RaviTharaka/riscv_fpga/Diagrams/Pipeline.pdf

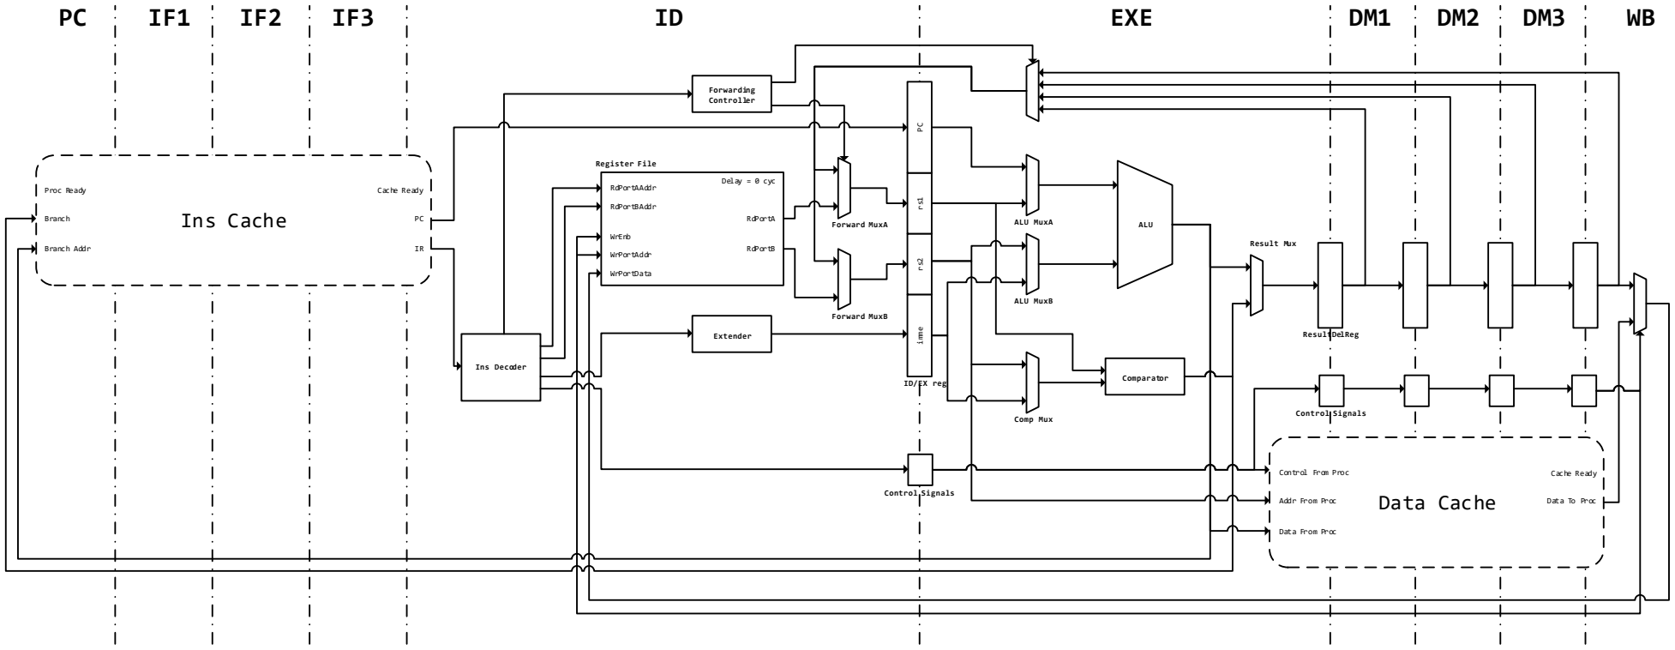
[picture p15: figure]
Ins Cache Branch; Branch Addr; Proc Ready; Cache Ready; Register File; RdPortAAddr; WrEnb; WrPortAddr; WrPortData; RdPortA; Delay = 0 cyc; RdPortB; RdPortBAddr; Ins Decoder; Forward MuxB; Forward MuxA; ID/EX reg imme rs2 rs1 PC; Extender; Control; Signals; ALU; Comparator; ALU MuxB; ALU MuxA; Comp Mux; Result Mux; ResultDelReg; Data Cache Addr From Proc; Data From Proc; Data To Proc; Control From; Proc; EXE; Forwarding Controller

- Allowing 3 cycles for each of the caches, there are 10 pipeline stages
- The Forwarding controller controls the forwarding of data from pipeline stages after execution stage to dependent instructions to enable faster execution.
- CacheReady signals from both caches are used to stall or bubble the pipeline during an instruction or data miss
- At a instruction cache stall only the pipeline stages upto EX are haulted, the remaining stages are allowed to run while adding bubbling instuctions. At a data cache stall, whole pipeline is stalled.
- The forwarded data are multiplexed at the decode stage to shorten the critical path at the EXE stage. Therefore a neighboring instruction dependency will require a single cycle bubble of the pipeline

# Pipeline
