RaviTharaka/riscv_fpga/Diagrams/DataCache.pdf

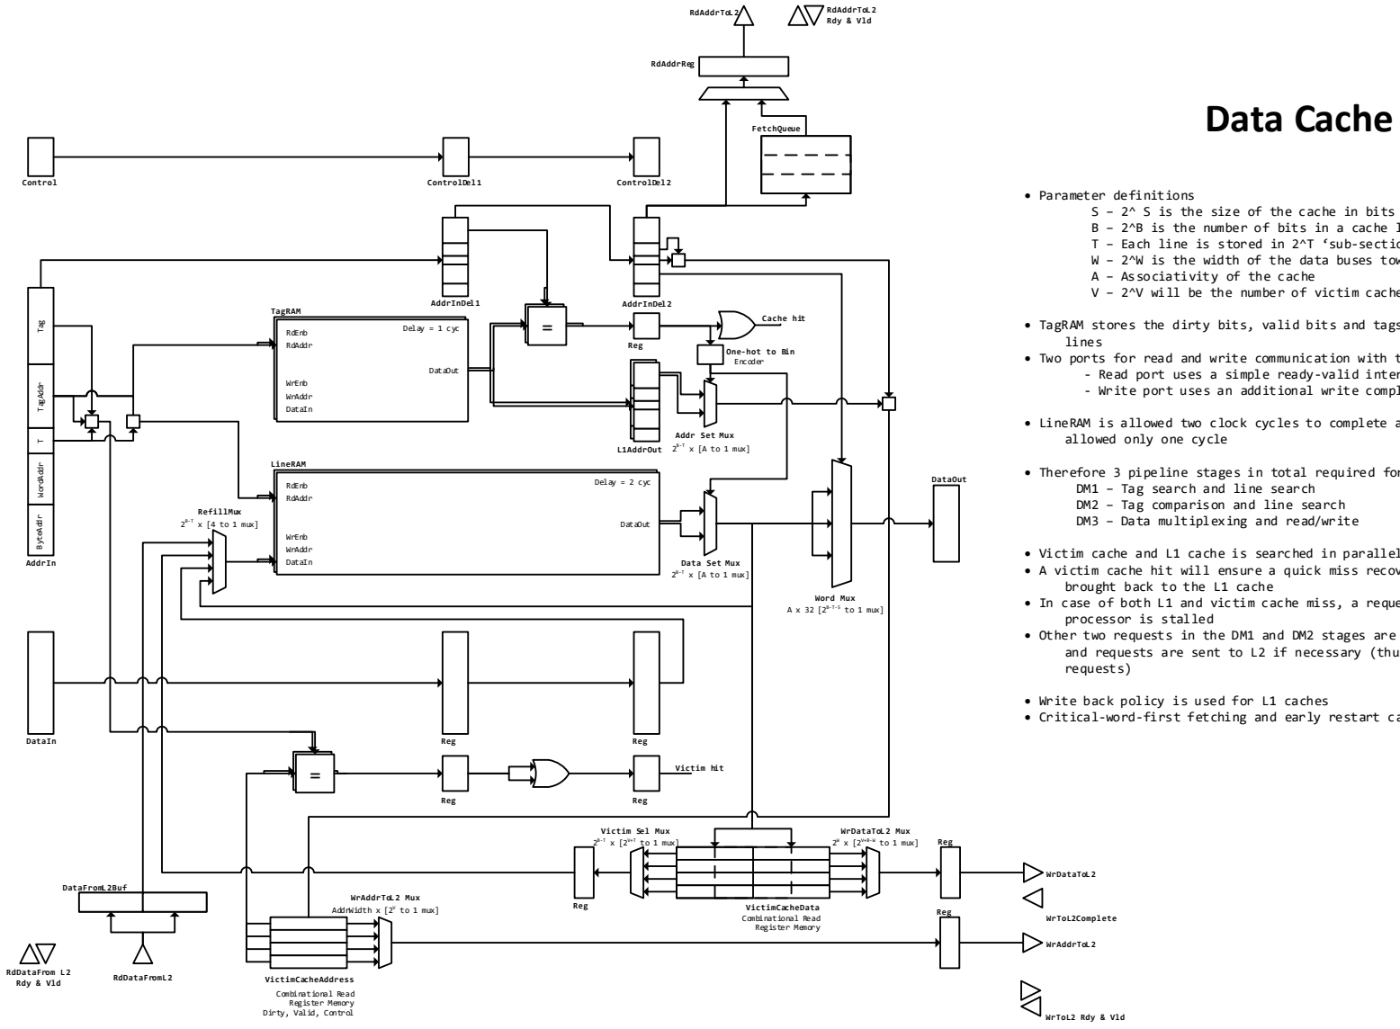
[picture p23: figure]
TagRAM; RdEnb RdAddr; WrEnb WrAddr DataIn; DataOut; Delay = 1 cyc; LineRAM; Delay = 2 cyc; Reg; AddrIn ByteAddr WordAddr T TagAddr Tag; Word Mux; Data Set Mux; to 1 mux]; x [A to 1 mux]; One-hot to Bin; Control; DataIn; RefillMux; x [4 to 1 mux]; AddrInDel1; AddrInDel2; FetchQueue; RdAddrReg; RdAddrToL2; Rdy & Vld; RdDataFrom L2; RdDataFromL2; DataFromL2Buf; VictimCacheData; Victim Sel Mux; WrDataToL2 Mux; WrDataToL2; VictimCacheAddress; WrAddrToL2 Mux AddrWidth x [2; WrAddrToL2; WrToL2 Rdy & Vld; Combinational Read; WrToL2Complete; Register Memory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

S – 2^ S is the size of the cache in bits
B – 2^B is the number of bits in a cache line
T – Each line is stored in 2^T sub-sections in the Line Memory W – 2^W is the width of the data buses towards L2 cache

V – 2^V will be the number of victim cache lines

- TagRAM stores the dirty bits, valid bits and tags while LineRAM stores the cache
- Two ports for read and write communication with the L2 cache or memory
- Read port uses a simple ready-valid interface for address and data
- Write port uses an additional write completion signal
- LineRAM is allowed two clock cycles to complete a read, while the smaller Tag RAM is
- Therefore 3 pipeline stages in total required for a data read or write
- Victim cache and L1 cache is searched in parallel
- A victim cache hit will ensure a quick miss recovery, and the hit line will be
- In case of both L1 and victim cache miss, a request is sent towards the memory and
- Other two requests in the DM1 and DM2 stages are also immediately checked for misses and requests are sent to L2 if necessary (thus reducing miss penalty for DM1,DM2
- Write back policy is used for L1 caches
- Critical-word-first fetching and early restart capable
DM1 | DM2 | DM3
