RaviTharaka/riscv_fpga/VerificationPrograms/UtilityPrograms/ConvertToHex/README.md

=====================================================================
# RISC-V Base ISA   
=====================================================================
#### 03/03/2017
### Verification Programs 
=====================================================================
### Introduction
bla bla.

=====================================================================
### Requirements. 

=====================================================================
### bla bla
