RaviTharaka/riscv_fpga/VerificationPrograms/LargeConvolution/result.txt

399, 840, 1497, 1542, 1778, 1748, 2089, 1971, 1867, 1293, 1044, 816, 1339, 2034, 2711, 2617, 2228, 1982, 2163, 2071, 1772, 1629, 1902, 2381, 2256, 2206, 2066, 2230, 2263, 2462, 2833, 3051, 2758, 2380, 1709, 1564, 1360, 1854, 2070, 2247, 2012, 2020, 2208, 2545, 2448, 2338, 2205, 2290, 1935, 1513, 1101, 1252, 1222, 1269, 950, 1099, 1641, 2629, 3476, 3592, 3022, 2212, 1958, 2194, 2326, 1800, 1117, 943, 1296, 1903, 2131, 2483, 2735, 3137, 3103, 2871, 2841, 2987, 2935, 2593, 2432, 2522, 2273, 1585, 1159, 1453, 2020, 2282, 2248, 2530, 2816, 2751, 2345, 2244, 2486, 2594, 2285, 2123, 2035, 2168,
