RaviTharaka/riscv_fpga/VerificationPrograms/SortLarge/result.txt

399	425	216	186	275	166	344	49	130	32	148	115	471	419	82	139	395	192	234	98	95	485	217	204	132	411	223	83	474	408	206	384	82	244	1	282	223	316	204	163	219	369	283	271	100	390	300	49	57	262	8	287	43	44	151	292	473	461	400	171	85	268	425	199	32	21	156	305	144	367	199	391	478	243	202	391	489	189	106	445	357	72	62	86	300	399	88	223	440	406	150	130	383	382	163	226	197	343	143	233
