RaviTharaka/riscv_fpga/Simulation/Data_Cache/result.txt

00014fb0
00014fe0
00014fe8
00014ff0
00014ff8
00015000
00015008
00015010
00015018
00015020
00015028
00015030
00015038
00015040
00015048
00015050
00015058
00015060
00015068
00015070
00015078
00015080
00015088
00015090
00015098
000150a0
000150a8
000150b0
000150b8
000150c0
000150c8
000150d0
000150d8
000150e0
000150e8
000150f0
000150f8
00015100
00015108
00015110
00015118
00015120
00015128
00015130
00015138
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
00016bf1
0001397f
00045cd8
00014fb0
00045cd8
00014fc0
00014fc0
0002659c
00018157
00003350
00016bf1
0001397f
00045cd8
00014fb0
00045cd8
00009b5f
00007f12
00014fa0
00010b64
00011c0c
00011bfc
00011c04
00010d3c
00045cd8
00014fc0
00045cd8
00014fd0
00014fd0
00014fd0
00014fd0
00044e30
00010eeb
00011a20
00010eeb
0003b3a4
0003b3b4
0003b36c
0003b37c
000334bc
0000288e
00010eeb
0003bcd0
00007f12
00009b5f
00014fa0
00009070
00014fb0
00010b68
00011c10
00011c00
00011c08
00010d40
00045cd8
00014fd0
00045cd8
00014fe0
00014fe0
00014fe0
00014fe0
00044e24
00044e20
00044e20
00044e10
00003341
0003aaac
00044e38
0003aa9c
0003abec
00032f1c
00044d88
0003abdc
00044d50
0003af44
00033f14
0003442c
000163c0
000083f4
0003abcc
000333bc
00032f34
0003ab8c
00044d80
0003ab84
00014e70
0003349c
00007501
00007501
0000af3b
00032ef4
0000d376
00044e98
0001a3e8
000120b7
0003ab6c
00044e90
0003ab64
00044eb8
0003aafc
00044d78
00008556
00044d50
0003ab5c
0003aab4
000051ac
0003af44
00033f14
00002933
00033f14
000334e4
00007e39
00002933
00003c9d
00003c9d
00033f14
00003c9d
00014e18
000051ac
00007f58
00022194
00007f58
00011ab2
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
0000e20a
0002ec68
0002ed58
0000d4e4
0002ec00
0000d4e4
0000d4e4
0002ec00
00037048
0000a6f6
0002ec6c
0000d4e4
0000d4e4
0002ed5c
0000d4e4
0000d4e4
0002ec70
0000d4e4
0000d4e4
0002ed60
0002ec78
0000d4e4
0000edc0
00015f3f
00003e62
00004715
0000a7a5
0000d916
0000fadc
00006fd1
0000fadc
00007a17
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
