RaviTharaka/riscv_fpga/Simulation/Instruction_Cache/result.txt

00010000
00010004
00010008
d89cfe4c
d89cfe6c
d0b8b684
d5ac4c04
d8a77800
8c636b94
d84a73fc
cff6892c
d84a73fc
d1550308
4159dba4
ccca81c8
409d5d94
c314e10c
4026df68
825e8ee0
825e8f80
d8216144
d8212a48
d8736d04
ccca83e8
d885f34c
cf44b17c
825e8ee0
42464c64
c314e10c
cff69804
98a3e238
d17eb5e4
d8834ed8
c314e10c
ccfc04c0
ccfc04c0
ccfc04c0
d17eb5e4
c314e10c
d5ac4c04
ccfc04c0
c24323bc
d17eb5e4
400ca384
d8216144
d0b81d94
d8ceb330
400e5ae4
422100b0
c043c634
d0b81d94
409c8afc
d5ac4c04
cbca9688
d5ac4c04
a8902fbc
cf99cb70
c3eb61c8
c043c634
d8212a44
c314e10c
cff688d8
cff68a78
825e8ee0
4159dba4
421c58f4
825e8ee0
d17eb5e4
c24323bc
400e5ae4
d17eb5e4
d885f34c
d88f7be0
d88f7be0
40270fe4
422156ec
cbca9688
ccfc04c0
d0b81d94
4159da08
d13db868
c24323c4
cbca9688
ccfc04c0
cbca9688
d0b8b684
421c2c34
421c2c34
421c2c34
421c2c34
ccfc04c0
cf44b2fc
d5ac4c04
825e8ee0
d5ac4c04
cf99cb70
cff69808
cff69808
4159dba4
424d3a20
ca608c68
d17eb5e4
d5ac4c04
d885f34c
d0b8b684
40f53a1c
cff69a94
d17eb5e0
ca608c68
ca608c68
ca608c68
c3eb61c8
ccfc04c0
825e8ee0
d888e09c
c3eb61c8
d5ac4c04
cff68928
421c58f4
cbca9688
c641883c
3fd78f00
cff69a94
c314e10c
d17eb5e0
98a3e2b8
cff69a94
d13d98c0
825e8ee0
c3db7634
a8902fbc
d885f34c
cff69a94
4047816c
d96aeb8c
825e8ee0
c3eb61c8
98a3e298
d17eb540
421c6310
cff69a98
421c2a90
d8212a48
d17eb5e4
ca608c68
421c58f4
825e8ee0
ccfc04c0
cff69a94
cff688c0
c3db7634
c24323bc
ca608c68
d8212a48
98a3e278
c3926448
d96aeb8c
cff69808
d96aeb8c
d8bb4fc8
825e8ee0
d13dbf30
825e8ee0
cdbcf818
c314e10c
98a3e238
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
cdbca598
cdb45528
97bd0c58
d0d8b70c
42211ab8
d90860a8
ca6abb68
d0d8b70c
d5ca004c
ca6abb68
42212e38
d0d8b70c
422156ec
40d3fc48
40d3fc48
3d98faa0
42212e38
421c4808
421c4808
421c4808
ca6abb68
d405db18
42b5a8d4
cbca9688
cdbca578
cdbca558
d038d824
d8eab398
d90860a8
c2871308
c24323bc
40040db8
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
