RaviTharaka/riscv_fpga/Integrated/Integrated/Integrated.srcs/sources_1/new/RISCV_PROCESSOR.v

`timescale 1ns / 1ps
//////////////////////////////////////////////////////////////////////////////////
// Company: 
// Engineer: Yasas Seneviratne
// 
// Create Date: 03/04/2017 08:24:33 PM
// Design Name: 
// Module Name: RISCV_PROCESSOR
// Project Name: 
// Target Devices: 
// Tool Versions: 
// Description: 
// 
// Dependencies: 
// 
// Revision:
// Revision 0.01 - File Created
// Additional Comments:
// 
//////////////////////////////////////////////////////////////////////////////////


module RISCV_PROCESSOR#(
        // Fixed parameters
        localparam ADDR_WIDTH           = 32,
        localparam DATA_WIDTH           = 32,
        localparam EXT_FIFO_ADDRESS     = 32'h00010150,
           
        // Primary parameters
        parameter S                     = 17,                    // Size of the cache will be 2^S bits
        parameter B                     = 9,                     // Size of a block will be 2^B bits
        parameter a                     = 1,                     // Associativity of the cache would be 2^a
        parameter T                     = 1,                     // Width to depth translation amount
        parameter W                     = 7,                     // Width of the L2-L1 bus would be 2^W
        parameter N                     = 3,                     // Number of stream buffers
        parameter n                     = 1,                     // Depth of stream buffers would be 2^n
        parameter p                     = 2,                     // Prefetch queue's depth is 2^p
        parameter V                     = 2,                     // Size of the victim cache will be 2^V cache lines
        parameter L2_DELAY_RD           = 7,                     // Delay of the second level of cache
                    
        // Calculated parameters
        localparam BYTES_PER_WORD       = logb2(DATA_WIDTH/8),
        
        localparam CACHE_SIZE           = 1 << S,
        localparam BLOCK_SIZE           = 1 << B,
        localparam ASSOCIATIVITY        = 1 << a,
        
        localparam TAG_WIDTH            = ADDR_WIDTH + 3 + a - S,
        localparam LINE_ADDR_WIDTH      = S - a - B + T,
        localparam TAG_ADDR_WIDTH       = S - a - B,
        
        localparam L2_BUS_WIDTH         = 1 << W,
        localparam BLOCK_SECTIONS       = 1 << T,
        
        localparam SET_SIZE             = CACHE_SIZE / ASSOCIATIVITY,
        localparam LINE_RAM_WIDTH       = 1 << (B - T),
        localparam LINE_RAM_DEPTH       = 1 << LINE_ADDR_WIDTH,
        localparam TAG_RAM_WIDTH        = TAG_WIDTH + BLOCK_SECTIONS,
        localparam TAG_RAM_DEPTH        = 1 << TAG_ADDR_WIDTH,
        
        localparam PREFETCH_QUEUE_DEPTH = 1 << p,
        localparam STREAM_BUF_DEPTH     = 1 << n,
        localparam STREAM_SEL_BITS      = logb2(N + 1),
        
        localparam L2_BURST             = 1 << (B - W)
    ) (
        // Standard inputs
        input                               CLK,
        input                               RSTN,
            
        ////////////////////////
        // INSTRUCTION CACHE  //
        ////////////////////////
        
        // Output address bus from Instruction Cache to Memory
        (* mark_debug *) input                               ADDR_TO_L2_READY_INS,
        (* mark_debug *) output                              ADDR_TO_L2_VALID_INS,      
        (* mark_debug *) output     [ADDR_WIDTH - 2 - 1 : 0] ADDR_TO_L2_INS,
                
        // Input data bus to Insruction Cache from Memory       
        (* mark_debug *) input                               DATA_FROM_L2_VALID_INS,
        (* mark_debug *) output                              DATA_FROM_L2_READY_INS,
        (* mark_debug *) input      [L2_BUS_WIDTH   - 1 : 0] DATA_FROM_L2_INS,
        
        
        ////////////////////////
        //    DATA CACHE      //
        ////////////////////////
        
        // Write bus between Data Cache and Memory 
        (* mark_debug *) input                               WR_TO_L2_READY_DAT,
        (* mark_debug *) output                              WR_TO_L2_VALID_DAT,
        (* mark_debug *) output     [ADDR_WIDTH - 2 - 1 : 0] WR_ADDR_TO_L2_DAT,
        (* mark_debug *) output     [L2_BUS_WIDTH   - 1 : 0] DATA_TO_L2_DAT,
        (* mark_debug *) output                              WR_CONTROL_TO_L2_DAT,
        (* mark_debug *) input                               WR_COMPLETE_DAT,
        
        // Read address from Data Cache to Memory
        (* mark_debug *) input                               RD_ADDR_TO_L2_READY_DAT,
        (* mark_debug *) output                              RD_ADDR_TO_L2_VALID_DAT,
        (* mark_debug *) output     [ADDR_WIDTH - 2 - 1 : 0] RD_ADDR_TO_L2_DAT,
        
        // Read data to Data Cache from Memory
        (* mark_debug *) input                               DATA_FROM_L2_VALID_DAT,
        (* mark_debug *) output                              DATA_FROM_L2_READY_DAT,
        (* mark_debug *) input      [L2_BUS_WIDTH   - 1 : 0] DATA_FROM_L2_DAT,
        
        ////////////////////////
        //   EXTRACTION FIFO  //
        ////////////////////////
                   
        output reg                          EXT_FIFO_WR_ENB,
        output reg [DATA_WIDTH     - 1 : 0] EXT_FIFO_WR_DATA
    );
    
     // Status signals between processor and instruction cache
     wire                               proc_ready_ins;
     wire                               cache_ready_ins;
     
     // Input address bus from the processor to instruction cache
     wire                               branch_taken;
     wire   [ADDR_WIDTH - 1 : 0]        branch_address;
           
     // Output data bus from instruction cache to the processor
     wire   [DATA_WIDTH - 1 : 0]        data_to_proc_ins;
     wire   [ADDR_WIDTH - 1 : 0]        pc_to_proc_ins;
     
     
     //Status signals between processor and data cache
     wire                               cache_ready_dat;
        
     //Input address bus from the processor to data cache     
     wire   [2          - 1 : 0]        control_from_proc_dat;
     wire   [ADDR_WIDTH - 1 : 0]        addr_from_proc_dat;
     wire   [DATA_WIDTH - 1 : 0]        data_from_proc_dat;
               
     //Output data from data cache to processor
     wire   [DATA_WIDTH - 1 : 0]        data_to_proc_dat;
          
     
     Ins_Cache # (
         .S(S),
         .B(B),
         .a(a),
         .T(T),
         .W(W),
         .L2_DELAY(L2_DELAY_RD),
         .N(N),
         .n(n),
         .p(p)
     ) ins_cache (
         // Standard inputs
         .CLK(CLK),
         .RSTN(RSTN),
         // Status signals between processor and cache
         .CACHE_READY(cache_ready_ins),
         .PROC_READY(proc_ready_ins),
         // Ports towards the processor
         .BRANCH_ADDR_IN(branch_address),
         .BRANCH(branch_taken),
         .DATA_TO_PROC(data_to_proc_ins),
         .PC_TO_PROC(pc_to_proc_ins),
         /// Read port towards the L2 cache    
         .ADDR_TO_L2(ADDR_TO_L2_INS),
         .ADDR_TO_L2_READY(ADDR_TO_L2_READY_INS),
         .ADDR_TO_L2_VALID(ADDR_TO_L2_VALID_INS),
         .DATA_FROM_L2(DATA_FROM_L2_INS),
         .DATA_FROM_L2_VALID(DATA_FROM_L2_VALID_INS),
         .DATA_FROM_L2_READY(DATA_FROM_L2_READY_INS)
    );
    
    PIPELINE pipeline(
         .CLK(CLK),
         // Towards instruction cache
         .CACHE_READY(cache_ready_ins),
         .PIPELINE_STALL(proc_ready_ins),
         .BRANCH_TAKEN(branch_taken),
         .BRANCH_ADDRESS(branch_address),
         .PC_IF_ID(pc_to_proc_ins), 
         .INS_IF_ID(data_to_proc_ins),
         //Data cache busses
         .CONTROL_DATA_CACHE(control_from_proc_dat), 
         .ADDR_TO_DATA_CACHE(addr_from_proc_dat),
         .DATA_TO_DATA_CACHE(data_from_proc_dat),
         .DATA_TO_PROC(data_to_proc_dat),
         .CACHE_READY_DATA(cache_ready_dat)
    );
    
    Data_Cache # (
        .S(S),
        .B(B),
        .a(a),
        .T(T),
        .W(W),
        .L2_DELAY_RD(L2_DELAY_RD),
        .V(V)
    ) data_cache (
        // Standard inputs
        .CLK(CLK),
        // Status signals between processor and cache
        .CACHE_READY(cache_ready_dat),
        // Ports towards the processor
        .CONTROL_FROM_PROC(control_from_proc_dat),  // CONTROL_FROM_PROC = {00(idle), 01(read), 10(write), 11(flush address from cache)}
        .ADDR_FROM_PROC(addr_from_proc_dat),
        .DATA_FROM_PROC(data_from_proc_dat),
        .DATA_TO_PROC(data_to_proc_dat),
        // Write port towards the L2 cache
        .WR_TO_L2_READY(WR_TO_L2_READY_DAT),
        .WR_TO_L2_VALID(WR_TO_L2_VALID_DAT),
        .WR_ADDR_TO_L2(WR_ADDR_TO_L2_DAT),
        .DATA_TO_L2(DATA_TO_L2_DAT),
        .WR_CONTROL_TO_L2(WR_CONTROL_TO_L2_DAT),
        .WR_COMPLETE(WR_COMPLETE_DAT),
        // Read port towards the L2 cache
        .RD_ADDR_TO_L2_READY(RD_ADDR_TO_L2_READY_DAT),
        .RD_ADDR_TO_L2_VALID(RD_ADDR_TO_L2_VALID_DAT),
        .RD_ADDR_TO_L2(RD_ADDR_TO_L2_DAT),
        .DATA_FROM_L2_VALID(DATA_FROM_L2_VALID_DAT),
        .DATA_FROM_L2_READY(DATA_FROM_L2_READY_DAT),
        .DATA_FROM_L2(DATA_FROM_L2_DAT)       
    );
    
    // Intercepting and extracting certain data writes
    reg [DATA_WIDTH - 1 : 0] data;
    reg [2          - 1 : 0] control;
    reg [ADDR_WIDTH - 1 : 0] address;
    
    always @ (posedge CLK) begin
        control <= control_from_proc_dat;       
        address <= addr_from_proc_dat;          
        data    <= data_from_proc_dat;   
        
        EXT_FIFO_WR_ENB  <= (address == EXT_FIFO_ADDRESS) & (control == 2);
        EXT_FIFO_WR_DATA <= data;      
    end
    
    function integer logb2;
        input integer depth;
        for (logb2 = 0; depth > 1; logb2 = logb2 + 1)
            depth = depth >> 1;
    endfunction
    
endmodule
