RaviTharaka/riscv_fpga/Integrated/Integrated/Integrated.cache/ip/0945b24895491da3/blk_mem_gen_0_stub.v

// Copyright 1986-2016 Xilinx, Inc. All Rights Reserved.
// --------------------------------------------------------------------------------
// Tool Version: Vivado v.2016.3 (win64) Build 1682563 Mon Oct 10 19:07:27 MDT 2016
// Date        : Sat Mar 04 10:53:40 2017
// Host        : DESKTOP-ICCV388 running 64-bit major release  (build 9200)
// Command     : write_verilog -force -mode synth_stub -rename_top decalper_eb_ot_sdeen_pot_pi_dehcac_xnilix -prefix
//               decalper_eb_ot_sdeen_pot_pi_dehcac_xnilix_ blk_mem_gen_0_stub.v
// Design      : blk_mem_gen_0
// Purpose     : Stub declaration of top-level module interface
// Device      : xc7z020clg484-1
// --------------------------------------------------------------------------------

// This empty module with port declaration file causes synthesis tools to infer a black box for IP.
// The synthesis directives are for Synopsys Synplify support to prevent IO buffer insertion.
// Please paste the declaration into a Verilog source file or add the file as an additional source.
(* x_core_info = "blk_mem_gen_v8_3_4,Vivado 2016.3" *)
module decalper_eb_ot_sdeen_pot_pi_dehcac_xnilix(clka, ena, wea, addra, dina, douta)
/* synthesis syn_black_box black_box_pad_pin="clka,ena,wea[3:0],addra[31:0],dina[31:0],douta[31:0]" */;
  input clka;
  input ena;
  input [3:0]wea;
  input [31:0]addra;
  input [31:0]dina;
  output [31:0]douta;
endmodule
