RaviTharaka/riscv_fpga/RISCV_Demo/RISCV_Demo.runs/Integrated_processing_system7_0_1_synth_1/.Xil/Integrated_processing_system7_0_1_propImpl.xdc

set_property SRC_FILE_INFO {cfile:e:/University/GrandFinale/Project/riscv_fpga/RISCV_Demo/RISCV_Demo.srcs/sources_1/bd/Integrated/ip/Integrated_processing_system7_0_1/Integrated_processing_system7_0_1.xdc rfile:../../../RISCV_Demo.srcs/sources_1/bd/Integrated/ip/Integrated_processing_system7_0_1/Integrated_processing_system7_0_1.xdc id:1 order:EARLY scoped_inst:inst} [current_design]
set_property src_info {type:SCOPED_XDC file:1 line:21 export:INPUT save:INPUT read:READ} [current_design]
set_input_jitter clk_fpga_0 0.24999
set_property src_info {type:SCOPED_XDC file:1 line:31 export:INPUT save:INPUT read:READ} [current_design]
set_property PACKAGE_PIN "C12" [get_ports "MIO[53]"]
set_property src_info {type:SCOPED_XDC file:1 line:37 export:INPUT save:INPUT read:READ} [current_design]
set_property PACKAGE_PIN "D10" [get_ports "MIO[52]"]
set_property src_info {type:SCOPED_XDC file:1 line:43 export:INPUT save:INPUT read:READ} [current_design]
set_property PACKAGE_PIN "C10" [get_ports "MIO[51]"]
set_property src_info {type:SCOPED_XDC file:1 line:49 export:INPUT save:INPUT read:READ} [current_design]
set_property PACKAGE_PIN "D13" [get_ports "MIO[50]"]
set_property src_info {type:SCOPED_XDC file:1 line:55 export:INPUT save:INPUT read:READ} [current_design]
set_property PACKAGE_PIN "C14" [get_ports "MIO[49]"]
set_property src_info {type:SCOPED_XDC file:1 line:61 export:INPUT save:INPUT read:READ} [current_design]
set_property PACKAGE_PIN "D11" [get_ports "MIO[48]"]
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
set_property PACKAGE_PIN "F6" [get_ports "MIO[3]"]
set_property src_info {type:SCOPED_XDC file:1 line:337 export:INPUT save:INPUT read:READ} [current_design]
set_property PACKAGE_PIN "A2" [get_ports "MIO[2]"]
set_property src_info {type:SCOPED_XDC file:1 line:343 export:INPUT save:INPUT read:READ} [current_design]
set_property PACKAGE_PIN "A1" [get_ports "MIO[1]"]
set_property src_info {type:SCOPED_XDC file:1 line:349 export:INPUT save:INPUT read:READ} [current_design]
set_property PACKAGE_PIN "G6" [get_ports "MIO[0]"]
set_property src_info {type:SCOPED_XDC file:1 line:354 export:INPUT save:INPUT read:READ} [current_design]
set_property PACKAGE_PIN "N7" [get_ports "DDR_VRP"]
set_property src_info {type:SCOPED_XDC file:1 line:358 export:INPUT save:INPUT read:READ} [current_design]
set_property PACKAGE_PIN "M7" [get_ports "DDR_VRN"]
set_property src_info {type:SCOPED_XDC file:1 line:362 export:INPUT save:INPUT read:READ} [current_design]
set_property PACKAGE_PIN "R4" [get_ports "DDR_WEB"]
set_property src_info {type:SCOPED_XDC file:1 line:366 export:INPUT save:INPUT read:READ} [current_design]
set_property PACKAGE_PIN "R5" [get_ports "DDR_RAS_n"]
set_property src_info {type:SCOPED_XDC file:1 line:370 export:INPUT save:INPUT read:READ} [current_design]
set_property PACKAGE_PIN "P5" [get_ports "DDR_ODT"]
set_property src_info {type:SCOPED_XDC file:1 line:374 export:INPUT save:INPUT read:READ} [current_design]
set_property PACKAGE_PIN "F3" [get_ports "DDR_DRSTB"]
set_property src_info {type:SCOPED_XDC file:1 line:378 export:INPUT save:INPUT read:READ} [current_design]
set_property PACKAGE_PIN "V2" [get_ports "DDR_DQS[3]"]
set_property src_info {type:SCOPED_XDC file:1 line:382 export:INPUT save:INPUT read:READ} [current_design]
set_property PACKAGE_PIN "N2" [get_ports "DDR_DQS[2]"]
set_property src_info {type:SCOPED_XDC file:1 line:386 export:INPUT save:INPUT read:READ} [current_design]
set_property PACKAGE_PIN "H2" [get_ports "DDR_DQS[1]"]
set_property src_info {type:SCOPED_XDC file:1 line:390 export:INPUT save:INPUT read:READ} [current_design]
set_property PACKAGE_PIN "C2" [get_ports "DDR_DQS[0]"]
set_property src_info {type:SCOPED_XDC file:1 line:394 export:INPUT save:INPUT read:READ} [current_design]
set_property PACKAGE_PIN "W2" [get_ports "DDR_DQS_n[3]"]
set_property src_info {type:SCOPED_XDC file:1 line:398 export:INPUT save:INPUT read:READ} [current_design]
set_property PACKAGE_PIN "P2" [get_ports "DDR_DQS_n[2]"]
set_property src_info {type:SCOPED_XDC file:1 line:402 export:INPUT save:INPUT read:READ} [current_design]
set_property PACKAGE_PIN "J2" [get_ports "DDR_DQS_n[1]"]
set_property src_info {type:SCOPED_XDC file:1 line:406 export:INPUT save:INPUT read:READ} [current_design]
set_property PACKAGE_PIN "D2" [get_ports "DDR_DQS_n[0]"]
set_property src_info {type:SCOPED_XDC file:1 line:410 export:INPUT save:INPUT read:READ} [current_design]
set_property PACKAGE_PIN "G1" [get_ports "DDR_DQ[9]"]
set_property src_info {type:SCOPED_XDC file:1 line:414 export:INPUT save:INPUT read:READ} [current_design]
set_property PACKAGE_PIN "G2" [get_ports "DDR_DQ[8]"]
set_property src_info {type:SCOPED_XDC file:1 line:418 export:INPUT save:INPUT read:READ} [current_design]
set_property PACKAGE_PIN "F1" [get_ports "DDR_DQ[7]"]
set_property src_info {type:SCOPED_XDC file:1 line:422 export:INPUT save:INPUT read:READ} [current_design]
set_property PACKAGE_PIN "F2" [get_ports "DDR_DQ[6]"]
set_property src_info {type:SCOPED_XDC file:1 line:426 export:INPUT save:INPUT read:READ} [current_design]
set_property PACKAGE_PIN "E1" [get_ports "DDR_DQ[5]"]
set_property src_info {type:SCOPED_XDC file:1 line:430 export:INPUT save:INPUT read:READ} [current_design]
set_property PACKAGE_PIN "E3" [get_ports "DDR_DQ[4]"]
set_property src_info {type:SCOPED_XDC file:1 line:434 export:INPUT save:INPUT read:READ} [current_design]
set_property PACKAGE_PIN "D3" [get_ports "DDR_DQ[3]"]
set_property src_info {type:SCOPED_XDC file:1 line:438 export:INPUT save:INPUT read:READ} [current_design]
set_property PACKAGE_PIN "Y1" [get_ports "DDR_DQ[31]"]
set_property src_info {type:SCOPED_XDC file:1 line:442 export:INPUT save:INPUT read:READ} [current_design]
set_property PACKAGE_PIN "W3" [get_ports "DDR_DQ[30]"]
set_property src_info {type:SCOPED_XDC file:1 line:446 export:INPUT save:INPUT read:READ} [current_design]
set_property PACKAGE_PIN "B2" [get_ports "DDR_DQ[2]"]
set_property src_info {type:SCOPED_XDC file:1 line:450 export:INPUT save:INPUT read:READ} [current_design]
set_property PACKAGE_PIN "Y3" [get_ports "DDR_DQ[29]"]
set_property src_info {type:SCOPED_XDC file:1 line:454 export:INPUT save:INPUT read:READ} [current_design]
set_property PACKAGE_PIN "W1" [get_ports "DDR_DQ[28]"]
set_property src_info {type:SCOPED_XDC file:1 line:458 export:INPUT save:INPUT read:READ} [current_design]
set_property PACKAGE_PIN "U2" [get_ports "DDR_DQ[27]"]
set_property src_info {type:SCOPED_XDC file:1 line:462 export:INPUT save:INPUT read:READ} [current_design]
set_property PACKAGE_PIN "AA1" [get_ports "DDR_DQ[26]"]
set_property src_info {type:SCOPED_XDC file:1 line:466 export:INPUT save:INPUT read:READ} [current_design]
set_property PACKAGE_PIN "U1" [get_ports "DDR_DQ[25]"]
set_property src_info {type:SCOPED_XDC file:1 line:470 export:INPUT save:INPUT read:READ} [current_design]
set_property PACKAGE_PIN "AA3" [get_ports "DDR_DQ[24]"]
set_property src_info {type:SCOPED_XDC file:1 line:474 export:INPUT save:INPUT read:READ} [current_design]
set_property PACKAGE_PIN "R1" [get_ports "DDR_DQ[23]"]
set_property src_info {type:SCOPED_XDC file:1 line:478 export:INPUT save:INPUT read:READ} [current_design]
set_property PACKAGE_PIN "M2" [get_ports "DDR_DQ[22]"]
set_property src_info {type:SCOPED_XDC file:1 line:482 export:INPUT save:INPUT read:READ} [current_design]
set_property PACKAGE_PIN "T2" [get_ports "DDR_DQ[21]"]
set_property src_info {type:SCOPED_XDC file:1 line:486 export:INPUT save:INPUT read:READ} [current_design]
set_property PACKAGE_PIN "R3" [get_ports "DDR_DQ[20]"]
set_property src_info {type:SCOPED_XDC file:1 line:490 export:INPUT save:INPUT read:READ} [current_design]
set_property PACKAGE_PIN "C3" [get_ports "DDR_DQ[1]"]
set_property src_info {type:SCOPED_XDC file:1 line:494 export:INPUT save:INPUT read:READ} [current_design]
set_property PACKAGE_PIN "T1" [get_ports "DDR_DQ[19]"]
set_property src_info {type:SCOPED_XDC file:1 line:498 export:INPUT save:INPUT read:READ} [current_design]
set_property PACKAGE_PIN "N3" [get_ports "DDR_DQ[18]"]
set_property src_info {type:SCOPED_XDC file:1 line:502 export:INPUT save:INPUT read:READ} [current_design]
set_property PACKAGE_PIN "T3" [get_ports "DDR_DQ[17]"]
set_property src_info {type:SCOPED_XDC file:1 line:506 export:INPUT save:INPUT read:READ} [current_design]
set_property PACKAGE_PIN "M1" [get_ports "DDR_DQ[16]"]
set_property src_info {type:SCOPED_XDC file:1 line:510 export:INPUT save:INPUT read:READ} [current_design]
set_property PACKAGE_PIN "K3" [get_ports "DDR_DQ[15]"]
set_property src_info {type:SCOPED_XDC file:1 line:514 export:INPUT save:INPUT read:READ} [current_design]
set_property PACKAGE_PIN "J1" [get_ports "DDR_DQ[14]"]
set_property src_info {type:SCOPED_XDC file:1 line:518 export:INPUT save:INPUT read:READ} [current_design]
set_property PACKAGE_PIN "K1" [get_ports "DDR_DQ[13]"]
set_property src_info {type:SCOPED_XDC file:1 line:522 export:INPUT save:INPUT read:READ} [current_design]
set_property PACKAGE_PIN "L3" [get_ports "DDR_DQ[12]"]
set_property src_info {type:SCOPED_XDC file:1 line:526 export:INPUT save:INPUT read:READ} [current_design]
set_property PACKAGE_PIN "L2" [get_ports "DDR_DQ[11]"]
set_property src_info {type:SCOPED_XDC file:1 line:530 export:INPUT save:INPUT read:READ} [current_design]
set_property PACKAGE_PIN "L1" [get_ports "DDR_DQ[10]"]
set_property src_info {type:SCOPED_XDC file:1 line:534 export:INPUT save:INPUT read:READ} [current_design]
set_property PACKAGE_PIN "D1" [get_ports "DDR_DQ[0]"]
set_property src_info {type:SCOPED_XDC file:1 line:538 export:INPUT save:INPUT read:READ} [current_design]
set_property PACKAGE_PIN "AA2" [get_ports "DDR_DM[3]"]
set_property src_info {type:SCOPED_XDC file:1 line:542 export:INPUT save:INPUT read:READ} [current_design]
set_property PACKAGE_PIN "P1" [get_ports "DDR_DM[2]"]
set_property src_info {type:SCOPED_XDC file:1 line:546 export:INPUT save:INPUT read:READ} [current_design]
set_property PACKAGE_PIN "H3" [get_ports "DDR_DM[1]"]
set_property src_info {type:SCOPED_XDC file:1 line:550 export:INPUT save:INPUT read:READ} [current_design]
set_property PACKAGE_PIN "B1" [get_ports "DDR_DM[0]"]
set_property src_info {type:SCOPED_XDC file:1 line:554 export:INPUT save:INPUT read:READ} [current_design]
set_property PACKAGE_PIN "P6" [get_ports "DDR_CS_n"]
set_property src_info {type:SCOPED_XDC file:1 line:558 export:INPUT save:INPUT read:READ} [current_design]
set_property PACKAGE_PIN "V3" [get_ports "DDR_CKE"]
set_property src_info {type:SCOPED_XDC file:1 line:562 export:INPUT save:INPUT read:READ} [current_design]
set_property PACKAGE_PIN "N4" [get_ports "DDR_Clk"]
set_property src_info {type:SCOPED_XDC file:1 line:566 export:INPUT save:INPUT read:READ} [current_design]
set_property PACKAGE_PIN "N5" [get_ports "DDR_Clk_n"]
set_property src_info {type:SCOPED_XDC file:1 line:570 export:INPUT save:INPUT read:READ} [current_design]
set_property PACKAGE_PIN "P3" [get_ports "DDR_CAS_n"]
set_property src_info {type:SCOPED_XDC file:1 line:574 export:INPUT save:INPUT read:READ} [current_design]
set_property PACKAGE_PIN "M6" [get_ports "DDR_BankAddr[2]"]
set_property src_info {type:SCOPED_XDC file:1 line:578 export:INPUT save:INPUT read:READ} [current_design]
set_property PACKAGE_PIN "L6" [get_ports "DDR_BankAddr[1]"]
set_property src_info {type:SCOPED_XDC file:1 line:582 export:INPUT save:INPUT read:READ} [current_design]
set_property PACKAGE_PIN "L7" [get_ports "DDR_BankAddr[0]"]
set_property src_info {type:SCOPED_XDC file:1 line:586 export:INPUT save:INPUT read:READ} [current_design]
set_property PACKAGE_PIN "H5" [get_ports "DDR_Addr[9]"]
set_property src_info {type:SCOPED_XDC file:1 line:590 export:INPUT save:INPUT read:READ} [current_design]
set_property PACKAGE_PIN "J5" [get_ports "DDR_Addr[8]"]
set_property src_info {type:SCOPED_XDC file:1 line:594 export:INPUT save:INPUT read:READ} [current_design]
set_property PACKAGE_PIN "J6" [get_ports "DDR_Addr[7]"]
set_property src_info {type:SCOPED_XDC file:1 line:598 export:INPUT save:INPUT read:READ} [current_design]
set_property PACKAGE_PIN "J7" [get_ports "DDR_Addr[6]"]
set_property src_info {type:SCOPED_XDC file:1 line:602 export:INPUT save:INPUT read:READ} [current_design]
set_property PACKAGE_PIN "K5" [get_ports "DDR_Addr[5]"]
set_property src_info {type:SCOPED_XDC file:1 line:606 export:INPUT save:INPUT read:READ} [current_design]
set_property PACKAGE_PIN "K6" [get_ports "DDR_Addr[4]"]
set_property src_info {type:SCOPED_XDC file:1 line:610 export:INPUT save:INPUT read:READ} [current_design]
set_property PACKAGE_PIN "L4" [get_ports "DDR_Addr[3]"]
set_property src_info {type:SCOPED_XDC file:1 line:614 export:INPUT save:INPUT read:READ} [current_design]
set_property PACKAGE_PIN "K4" [get_ports "DDR_Addr[2]"]
set_property src_info {type:SCOPED_XDC file:1 line:618 export:INPUT save:INPUT read:READ} [current_design]
set_property PACKAGE_PIN "M5" [get_ports "DDR_Addr[1]"]
set_property src_info {type:SCOPED_XDC file:1 line:622 export:INPUT save:INPUT read:READ} [current_design]
set_property PACKAGE_PIN "G4" [get_ports "DDR_Addr[14]"]
set_property src_info {type:SCOPED_XDC file:1 line:626 export:INPUT save:INPUT read:READ} [current_design]
set_property PACKAGE_PIN "F4" [get_ports "DDR_Addr[13]"]
set_property src_info {type:SCOPED_XDC file:1 line:630 export:INPUT save:INPUT read:READ} [current_design]
set_property PACKAGE_PIN "H4" [get_ports "DDR_Addr[12]"]
set_property src_info {type:SCOPED_XDC file:1 line:634 export:INPUT save:INPUT read:READ} [current_design]
set_property PACKAGE_PIN "G5" [get_ports "DDR_Addr[11]"]
set_property src_info {type:SCOPED_XDC file:1 line:638 export:INPUT save:INPUT read:READ} [current_design]
set_property PACKAGE_PIN "J3" [get_ports "DDR_Addr[10]"]
set_property src_info {type:SCOPED_XDC file:1 line:642 export:INPUT save:INPUT read:READ} [current_design]
set_property PACKAGE_PIN "M4" [get_ports "DDR_Addr[0]"]
set_property src_info {type:SCOPED_XDC file:1 line:646 export:INPUT save:INPUT read:READ} [current_design]
set_property PACKAGE_PIN "B5" [get_ports "PS_PORB"]
set_property src_info {type:SCOPED_XDC file:1 line:649 export:INPUT save:INPUT read:READ} [current_design]
set_property PACKAGE_PIN "C9" [get_ports "PS_SRSTB"]
set_property src_info {type:SCOPED_XDC file:1 line:652 export:INPUT save:INPUT read:READ} [current_design]
set_property PACKAGE_PIN "F7" [get_ports "PS_CLK"]
