RaviTharaka/riscv_fpga/RISCV_Demo/RISCV_Demo.srcs/sources_1/bd/Integrated/ip/Integrated_axi_bram_ctrl_0_0/Integrated_axi_bram_ctrl_0_0_sim_netlist.v

// Copyright 1986-2016 Xilinx, Inc. All Rights Reserved.
// --------------------------------------------------------------------------------
// Tool Version: Vivado v.2016.3 (win64) Build 1682563 Mon Oct 10 19:07:27 MDT 2016
// Date        : Fri Apr 28 08:28:38 2017
// Host        : ASUS-PC running 64-bit major release  (build 9200)
// Command     : write_verilog -force -mode funcsim
//               E:/University/GrandFinale/Project/riscv_fpga/RISCV_Demo/RISCV_Demo.srcs/sources_1/bd/Integrated/ip/Integrated_axi_bram_ctrl_0_0/Integrated_axi_bram_ctrl_0_0_sim_netlist.v
// Design      : Integrated_axi_bram_ctrl_0_0
// Purpose     : This verilog netlist is a functional simulation representation of the design and should not be modified
//               or synthesized. This netlist cannot be used for SDF annotated simulation.
// Device      : xc7z020clg484-1
// --------------------------------------------------------------------------------
`timescale 1 ps / 1 ps

(* CHECK_LICENSE_TYPE = "Integrated_axi_bram_ctrl_0_0,axi_bram_ctrl,{}" *) (* downgradeipidentifiedwarnings = "yes" *) (* x_core_info = "axi_bram_ctrl,Vivado 2016.3" *) 
(* NotValidForBitStream *)
module Integrated_axi_bram_ctrl_0_0
   (s_axi_aclk,
    s_axi_aresetn,
    s_axi_awid,
    s_axi_awaddr,
    s_axi_awlen,
    s_axi_awsize,
    s_axi_awburst,
    s_axi_awlock,
    s_axi_awcache,
    s_axi_awprot,
    s_axi_awvalid,
    s_axi_awready,
    s_axi_wdata,
    s_axi_wstrb,
    s_axi_wlast,
    s_axi_wvalid,
    s_axi_wready,
    s_axi_bid,
    s_axi_bresp,
    s_axi_bvalid,
    s_axi_bready,
    s_axi_arid,
    s_axi_araddr,
    s_axi_arlen,
    s_axi_arsize,
    s_axi_arburst,
    s_axi_arlock,
    s_axi_arcache,
    s_axi_arprot,
    s_axi_arvalid,
    s_axi_arready,
    s_axi_rid,
    s_axi_rdata,
    s_axi_rresp,
    s_axi_rlast,
    s_axi_rvalid,
    s_axi_rready,
    bram_rst_a,
    bram_clk_a,
    bram_en_a,
    bram_we_a,
    bram_addr_a,
    bram_wrdata_a,
    bram_rddata_a);
  (* x_interface_info = "xilinx.com:signal:clock:1.0 CLKIF CLK" *) input s_axi_aclk;
  (* x_interface_info = "xilinx.com:signal:reset:1.0 RSTIF RST" *) input s_axi_aresetn;
  (* x_interface_info = "xilinx.com:interface:aximm:1.0 S_AXI AWID" *) input [11:0]s_axi_awid;
  (* x_interface_info = "xilinx.com:interface:aximm:1.0 S_AXI AWADDR" *) input [12:0]s_axi_awaddr;
  (* x_interface_info = "xilinx.com:interface:aximm:1.0 S_AXI AWLEN" *) input [7:0]s_axi_awlen;
  (* x_interface_info = "xilinx.com:interface:aximm:1.0 S_AXI AWSIZE" *) input [2:0]s_axi_awsize;
  (* x_interface_info = "xilinx.com:interface:aximm:1.0 S_AXI AWBURST" *) input [1:0]s_axi_awburst;
  (* x_interface_info = "xilinx.com:interface:aximm:1.0 S_AXI AWLOCK" *) input s_axi_awlock;
  (* x_interface_info = "xilinx.com:interface:aximm:1.0 S_AXI AWCACHE" *) input [3:0]s_axi_awcache;
  (* x_interface_info = "xilinx.com:interface:aximm:1.0 S_AXI AWPROT" *) input [2:0]s_axi_awprot;
  (* x_interface_info = "xilinx.com:interface:aximm:1.0 S_AXI AWVALID" *) input s_axi_awvalid;
  (* x_interface_info = "xilinx.com:interface:aximm:1.0 S_AXI AWREADY" *) output s_axi_awready;
  (* x_interface_info = "xilinx.com:interface:aximm:1.0 S_AXI WDATA" *) input [31:0]s_axi_wdata;
  (* x_interface_info = "xilinx.com:interface:aximm:1.0 S_AXI WSTRB" *) input [3:0]s_axi_wstrb;
  (* x_interface_info = "xilinx.com:interface:aximm:1.0 S_AXI WLAST" *) input s_axi_wlast;
  (* x_interface_info = "xilinx.com:interface:aximm:1.0 S_AXI WVALID" *) input s_axi_wvalid;
  (* x_interface_info = "xilinx.com:interface:aximm:1.0 S_AXI WREADY" *) output s_axi_wready;
  (* x_interface_info = "xilinx.com:interface:aximm:1.0 S_AXI BID" *) output [11:0]s_axi_bid;
  (* x_interface_info = "xilinx.com:interface:aximm:1.0 S_AXI BRESP" *) output [1:0]s_axi_bresp;
  (* x_interface_info = "xilinx.com:interface:aximm:1.0 S_AXI BVALID" *) output s_axi_bvalid;
  (* x_interface_info = "xilinx.com:interface:aximm:1.0 S_AXI BREADY" *) input s_axi_bready;
  (* x_interface_info = "xilinx.com:interface:aximm:1.0 S_AXI ARID" *) input [11:0]s_axi_arid;
  (* x_interface_info = "xilinx.com:interface:aximm:1.0 S_AXI ARADDR" *) input [12:0]s_axi_araddr;
  (* x_interface_info = "xilinx.com:interface:aximm:1.0 S_AXI ARLEN" *) input [7:0]s_axi_arlen;
  (* x_interface_info = "xilinx.com:interface:aximm:1.0 S_AXI ARSIZE" *) input [2:0]s_axi_arsize;
  (* x_interface_info = "xilinx.com:interface:aximm:1.0 S_AXI ARBURST" *) input [1:0]s_axi_arburst;
  (* x_interface_info = "xilinx.com:interface:aximm:1.0 S_AXI ARLOCK" *) input s_axi_arlock;
  (* x_interface_info = "xilinx.com:interface:aximm:1.0 S_AXI ARCACHE" *) input [3:0]s_axi_arcache;
  (* x_interface_info = "xilinx.com:interface:aximm:1.0 S_AXI ARPROT" *) input [2:0]s_axi_arprot;
  (* x_interface_info = "xilinx.com:interface:aximm:1.0 S_AXI ARVALID" *) input s_axi_arvalid;
  (* x_interface_info = "xilinx.com:interface:aximm:1.0 S_AXI ARREADY" *) output s_axi_arready;
  (* x_interface_info = "xilinx.com:interface:aximm:1.0 S_AXI RID" *) output [11:0]s_axi_rid;
  (* x_interface_info = "xilinx.com:interface:aximm:1.0 S_AXI RDATA" *) output [31:0]s_axi_rdata;
  (* x_interface_info = "xilinx.com:interface:aximm:1.0 S_AXI RRESP" *) output [1:0]s_axi_rresp;
  (* x_interface_info = "xilinx.com:interface:aximm:1.0 S_AXI RLAST" *) output s_axi_rlast;
  (* x_interface_info = "xilinx.com:interface:aximm:1.0 S_AXI RVALID" *) output s_axi_rvalid;
  (* x_interface_info = "xilinx.com:interface:aximm:1.0 S_AXI RREADY" *) input s_axi_rready;
  (* x_interface_info = "xilinx.com:interface:bram:1.0 BRAM_PORTA RST" *) output bram_rst_a;
  (* x_interface_info = "xilinx.com:interface:bram:1.0 BRAM_PORTA CLK" *) output bram_clk_a;
  (* x_interface_info = "xilinx.com:interface:bram:1.0 BRAM_PORTA EN" *) output bram_en_a;
  (* x_interface_info = "xilinx.com:interface:bram:1.0 BRAM_PORTA WE" *) output [3:0]bram_we_a;
  (* x_interface_info = "xilinx.com:interface:bram:1.0 BRAM_PORTA ADDR" *) output [12:0]bram_addr_a;
  (* x_interface_info = "xilinx.com:interface:bram:1.0 BRAM_PORTA DIN" *) output [31:0]bram_wrdata_a;
  (* x_interface_info = "xilinx.com:interface:bram:1.0 BRAM_PORTA DOUT" *) input [31:0]bram_rddata_a;

  wire \<const0> ;
  wire [12:2]\^bram_addr_a ;
  wire bram_en_a;
  wire [31:0]bram_rddata_a;
  wire bram_rst_a;
  wire [3:0]bram_we_a;
  wire [31:0]bram_wrdata_a;
  wire s_axi_aclk;
  wire [12:0]s_axi_araddr;
  wire [1:0]s_axi_arburst;
  wire s_axi_aresetn;
  wire [11:0]s_axi_arid;
  wire [7:0]s_axi_arlen;
  wire s_axi_arready;
  wire s_axi_arvalid;
  wire [12:0]s_axi_awaddr;
  wire [1:0]s_axi_awburst;
  wire [11:0]s_axi_awid;
  wire [7:0]s_axi_awlen;
  wire s_axi_awready;
  wire s_axi_awvalid;
  wire [11:0]s_axi_bid;
  wire s_axi_bready;
  wire s_axi_bvalid;
  wire [31:0]s_axi_rdata;
  wire [11:0]s_axi_rid;
  wire s_axi_rlast;
  wire s_axi_rready;
  wire s_axi_rvalid;
  wire [31:0]s_axi_wdata;
  wire s_axi_wlast;
  wire s_axi_wready;
  wire [3:0]s_axi_wstrb;
  wire s_axi_wvalid;

  assign bram_addr_a[12:2] = \^bram_addr_a [12:2];
  assign bram_addr_a[1] = \<const0> ;
  assign bram_addr_a[0] = \<const0> ;
  assign bram_clk_a = s_axi_aclk;
  assign s_axi_bresp[1] = \<const0> ;
  assign s_axi_bresp[0] = \<const0> ;
  assign s_axi_rresp[1] = \<const0> ;
  assign s_axi_rresp[0] = \<const0> ;
  GND GND
       (.G(\<const0> ));
  Integrated_axi_bram_ctrl_0_0_axi_bram_ctrl U0
       (.bram_addr_a(\^bram_addr_a ),
        .bram_en_a(bram_en_a),
        .bram_rddata_a(bram_rddata_a),
        .bram_rst_a(bram_rst_a),
        .bram_we_a(bram_we_a),
        .bram_wrdata_a(bram_wrdata_a),
        .s_axi_aclk(s_axi_aclk),
        .s_axi_araddr(s_axi_araddr[12:2]),
        .s_axi_arburst(s_axi_arburst),
        .s_axi_aresetn(s_axi_aresetn),
        .s_axi_arid(s_axi_arid),
        .s_axi_arlen(s_axi_arlen),
        .s_axi_arready(s_axi_arready),
        .s_axi_arvalid(s_axi_arvalid),
        .s_axi_awaddr(s_axi_awaddr[12:2]),
        .s_axi_awburst(s_axi_awburst),
        .s_axi_awid(s_axi_awid),
        .s_axi_awlen(s_axi_awlen[3:0]),
        .s_axi_awready(s_axi_awready),
        .s_axi_awvalid(s_axi_awvalid),
        .s_axi_bid(s_axi_bid),
        .s_axi_bready(s_axi_bready),
        .s_axi_bvalid(s_axi_bvalid),
        .s_axi_rdata(s_axi_rdata),
        .s_axi_rid(s_axi_rid),
        .s_axi_rlast(s_axi_rlast),
        .s_axi_rready(s_axi_rready),
        .s_axi_rvalid(s_axi_rvalid),
        .s_axi_wdata(s_axi_wdata),
        .s_axi_wlast(s_axi_wlast),
        .s_axi_wready(s_axi_wready),
        .s_axi_wstrb(s_axi_wstrb),
        .s_axi_wvalid(s_axi_wvalid));
endmodule

(* ORIG_REF_NAME = "SRL_FIFO" *) 
module Integrated_axi_bram_ctrl_0_0_SRL_FIFO
   (bid_gets_fifo_load,
    bid_gets_fifo_load_d1_reg,
    D,
    E,
    s_axi_aresetn,
    s_axi_aclk,
    s_axi_awid,
    p_1_out,
    aw_active_d1_reg,
    aw_active_re,
    bid_gets_fifo_load_d1,
    axi_bvalid_int_reg,
    s_axi_bready,
    \GEN_WDATA_SM_NO_ECC_SNG_REG_WREADY.wr_data_sng_sm_cs_reg[0] ,
    \GEN_WDATA_SM_NO_ECC_SNG_REG_WREADY.wr_data_sng_sm_cs_reg[1] ,
    s_axi_wvalid,
    s_axi_wlast,
    axi_wdata_full_reg,
    axi_wr_burst,
    AW2Arb_BVALID_Cnt);
  output bid_gets_fifo_load;
  output bid_gets_fifo_load_d1_reg;
  output [11:0]D;
  output [0:0]E;
  input s_axi_aresetn;
  input s_axi_aclk;
  input [11:0]s_axi_awid;
  input p_1_out;
  input aw_active_d1_reg;
  input aw_active_re;
  input bid_gets_fifo_load_d1;
  input axi_bvalid_int_reg;
  input s_axi_bready;
  input \GEN_WDATA_SM_NO_ECC_SNG_REG_WREADY.wr_data_sng_sm_cs_reg[0] ;
  input \GEN_WDATA_SM_NO_ECC_SNG_REG_WREADY.wr_data_sng_sm_cs_reg[1] ;
  input s_axi_wvalid;
  input s_axi_wlast;
  input axi_wdata_full_reg;
  input axi_wr_burst;
  input [2:0]AW2Arb_BVALID_Cnt;

  wire [2:0]AW2Arb_BVALID_Cnt;
  wire \Addr_Counters[0].FDRE_I_n_0 ;
  wire \Addr_Counters[1].FDRE_I_n_0 ;
  wire \Addr_Counters[2].FDRE_I_n_0 ;
  wire \Addr_Counters[3].FDRE_I_n_0 ;
  wire \Addr_Counters[3].XORCY_I_i_1_n_0 ;
  wire CI;
  wire [11:0]D;
  wire D_0;
  wire Data_Exists_DFF_i_2_n_0;
  wire Data_Exists_DFF_i_3_n_0;
  wire [0:0]E;
  wire \GEN_WDATA_SM_NO_ECC_SNG_REG_WREADY.wr_data_sng_sm_cs_reg[0] ;
  wire \GEN_WDATA_SM_NO_ECC_SNG_REG_WREADY.wr_data_sng_sm_cs_reg[1] ;
  wire S;
  wire S0_out;
  wire S1_out;
  wire addr_cy_1;
  wire addr_cy_2;
  wire addr_cy_3;
  wire aw_active_d1_reg;
  wire aw_active_re;
  wire \axi_bid_int[11]_i_4_n_0 ;
  wire \axi_bid_int[11]_i_5_n_0 ;
  wire \axi_bid_int[11]_i_6_n_0 ;
  wire \axi_bid_int[11]_i_7_n_0 ;
  wire \axi_bid_int[11]_i_8_n_0 ;
  wire axi_bvalid_int_reg;
  wire axi_wdata_full_reg;
  wire axi_wr_burst;
  wire bid_fifo_not_empty;
  wire [11:0]bid_fifo_rd;
  wire bid_gets_fifo_load;
  wire bid_gets_fifo_load_d1;
  wire bid_gets_fifo_load_d1_reg;
  wire p_1_out;
  wire s_axi_aclk;
  wire s_axi_aresetn;
  wire [11:0]s_axi_awid;
  wire s_axi_bready;
  wire s_axi_wlast;
  wire s_axi_wvalid;
  wire sum_A_0;
  wire sum_A_1;
  wire sum_A_2;
  wire sum_A_3;
  wire [3:3]\NLW_Addr_Counters[0].MUXCY_L_I_CARRY4_CO_UNCONNECTED ;
  wire [3:3]\NLW_Addr_Counters[0].MUXCY_L_I_CARRY4_DI_UNCONNECTED ;

  (* BOX_TYPE = "PRIMITIVE" *) 
  FDRE #(
    .INIT(1'b0),
    .IS_C_INVERTED(1'b0),
    .IS_D_INVERTED(1'b0),
    .IS_R_INVERTED(1'b0)) 
    \Addr_Counters[0].FDRE_I 
       (.C(s_axi_aclk),
        .CE(bid_fifo_not_empty),
        .D(sum_A_3),
        .Q(\Addr_Counters[0].FDRE_I_n_0 ),
        .R(s_axi_aresetn));
  (* BOX_TYPE = "PRIMITIVE" *) 
  (* XILINX_LEGACY_PRIM = "(MUXCY,XORCY)" *) 
  (* XILINX_TRANSFORM_PINMAP = "LO:O" *) 
  CARRY4 \Addr_Counters[0].MUXCY_L_I_CARRY4 
       (.CI(1'b0),
        .CO({\NLW_Addr_Counters[0].MUXCY_L_I_CARRY4_CO_UNCONNECTED [3],addr_cy_1,addr_cy_2,addr_cy_3}),
        .CYINIT(CI),
        .DI({\NLW_Addr_Counters[0].MUXCY_L_I_CARRY4_DI_UNCONNECTED [3],\Addr_Counters[2].FDRE_I_n_0 ,\Addr_Counters[1].FDRE_I_n_0 ,\Addr_Counters[0].FDRE_I_n_0 }),
        .O({sum_A_0,sum_A_1,sum_A_2,sum_A_3}),
        .S({\Addr_Counters[3].XORCY_I_i_1_n_0 ,S0_out,S1_out,S}));
  LUT6 #(
    .INIT(64'h0000FFFFFFFE0000)) 
    \Addr_Counters[0].MUXCY_L_I_i_1 
       (.I0(\Addr_Counters[1].FDRE_I_n_0 ),
        .I1(\Addr_Counters[3].FDRE_I_n_0 ),
        .I2(\Addr_Counters[2].FDRE_I_n_0 ),
        .I3(aw_active_re),
        .I4(\axi_bid_int[11]_i_5_n_0 ),
        .I5(\Addr_Counters[0].FDRE_I_n_0 ),
        .O(S));
  LUT6 #(
    .INIT(64'h8AAAAAAAAAAAAAAA)) 
    \Addr_Counters[0].MUXCY_L_I_i_2 
       (.I0(aw_active_re),
        .I1(\axi_bid_int[11]_i_5_n_0 ),
        .I2(\Addr_Counters[2].FDRE_I_n_0 ),
        .I3(\Addr_Counters[3].FDRE_I_n_0 ),
        .I4(\Addr_Counters[1].FDRE_I_n_0 ),
        .I5(\Addr_Counters[0].FDRE_I_n_0 ),
        .O(CI));
  (* BOX_TYPE = "PRIMITIVE" *) 
  FDRE #(
    .INIT(1'b0),
    .IS_C_INVERTED(1'b0),
    .IS_D_INVERTED(1'b0),
    .IS_R_INVERTED(1'b0)) 
    \Addr_Counters[1].FDRE_I 
       (.C(s_axi_aclk),
        .CE(bid_fifo_not_empty),
        .D(sum_A_2),
        .Q(\Addr_Counters[1].FDRE_I_n_0 ),
        .R(s_axi_aresetn));
  LUT6 #(
    .INIT(64'h0000FFFFFFFE0000)) 
    \Addr_Counters[1].MUXCY_L_I_i_1 
       (.I0(\Addr_Counters[3].FDRE_I_n_0 ),
        .I1(\Addr_Counters[0].FDRE_I_n_0 ),
        .I2(\Addr_Counters[2].FDRE_I_n_0 ),
        .I3(aw_active_re),
        .I4(\axi_bid_int[11]_i_5_n_0 ),
        .I5(\Addr_Counters[1].FDRE_I_n_0 ),
        .O(S1_out));
  (* BOX_TYPE = "PRIMITIVE" *) 
  FDRE #(
    .INIT(1'b0),
    .IS_C_INVERTED(1'b0),
    .IS_D_INVERTED(1'b0),
    .IS_R_INVERTED(1'b0)) 
    \Addr_Counters[2].FDRE_I 
       (.C(s_axi_aclk),
        .CE(bid_fifo_not_empty),
        .D(sum_A_1),
        .Q(\Addr_Counters[2].FDRE_I_n_0 ),
        .R(s_axi_aresetn));
  LUT6 #(
    .INIT(64'h0000FFFFFFFE0000)) 
    \Addr_Counters[2].MUXCY_L_I_i_1 
       (.I0(\Addr_Counters[1].FDRE_I_n_0 ),
        .I1(\Addr_Counters[3].FDRE_I_n_0 ),
        .I2(\Addr_Counters[0].FDRE_I_n_0 ),
        .I3(aw_active_re),
        .I4(\axi_bid_int[11]_i_5_n_0 ),
        .I5(\Addr_Counters[2].FDRE_I_n_0 ),
        .O(S0_out));
  (* BOX_TYPE = "PRIMITIVE" *) 
  FDRE #(
    .INIT(1'b0),
    .IS_C_INVERTED(1'b0),
    .IS_D_INVERTED(1'b0),
    .IS_R_INVERTED(1'b0)) 
    \Addr_Counters[3].FDRE_I 
       (.C(s_axi_aclk),
        .CE(bid_fifo_not_empty),
        .D(sum_A_0),
        .Q(\Addr_Counters[3].FDRE_I_n_0 ),
        .R(s_axi_aresetn));
  LUT6 #(
    .INIT(64'h0000FFFFFFFE0000)) 
    \Addr_Counters[3].XORCY_I_i_1 
       (.I0(\Addr_Counters[1].FDRE_I_n_0 ),
        .I1(\Addr_Counters[0].FDRE_I_n_0 ),
        .I2(\Addr_Counters[2].FDRE_I_n_0 ),
        .I3(aw_active_re),
        .I4(\axi_bid_int[11]_i_5_n_0 ),
        .I5(\Addr_Counters[3].FDRE_I_n_0 ),
        .O(\Addr_Counters[3].XORCY_I_i_1_n_0 ));
  (* BOX_TYPE = "PRIMITIVE" *) 
  (* XILINX_LEGACY_PRIM = "FDR" *) 
  FDRE #(
    .INIT(1'b0)) 
    Data_Exists_DFF
       (.C(s_axi_aclk),
        .CE(1'b1),
        .D(D_0),
        .Q(bid_fifo_not_empty),
        .R(s_axi_aresetn));
  LUT5 #(
    .INIT(32'hFFF20022)) 
    Data_Exists_DFF_i_1
       (.I0(p_1_out),
        .I1(aw_active_d1_reg),
        .I2(Data_Exists_DFF_i_2_n_0),
        .I3(Data_Exists_DFF_i_3_n_0),
        .I4(bid_fifo_not_empty),
        .O(D_0));
  LUT5 #(
    .INIT(32'h00002EEE)) 
    Data_Exists_DFF_i_2
       (.I0(bid_gets_fifo_load_d1_reg),
        .I1(\axi_bid_int[11]_i_8_n_0 ),
        .I2(s_axi_bready),
        .I3(axi_bvalid_int_reg),
        .I4(bid_gets_fifo_load_d1),
        .O(Data_Exists_DFF_i_2_n_0));
  LUT4 #(
    .INIT(16'hFFFE)) 
    Data_Exists_DFF_i_3
       (.I0(\Addr_Counters[1].FDRE_I_n_0 ),
        .I1(\Addr_Counters[3].FDRE_I_n_0 ),
        .I2(\Addr_Counters[0].FDRE_I_n_0 ),
        .I3(\Addr_Counters[2].FDRE_I_n_0 ),
        .O(Data_Exists_DFF_i_3_n_0));
  (* BOX_TYPE = "PRIMITIVE" *) 
  (* srl_bus_name = "\U0/gext_inst.abcv4_0_ext_inst/GEN_AXI4.I_FULL_AXI/I_WR_CHNL/BID_FIFO/FIFO_RAM " *) 
  (* srl_name = "\U0/gext_inst.abcv4_0_ext_inst/GEN_AXI4.I_FULL_AXI/I_WR_CHNL/BID_FIFO/FIFO_RAM[0].SRL16E_I " *) 
  SRL16E #(
    .INIT(16'h0000),
    .IS_CLK_INVERTED(1'b0)) 
    \FIFO_RAM[0].SRL16E_I 
       (.A0(\Addr_Counters[0].FDRE_I_n_0 ),
        .A1(\Addr_Counters[1].FDRE_I_n_0 ),
        .A2(\Addr_Counters[2].FDRE_I_n_0 ),
        .A3(\Addr_Counters[3].FDRE_I_n_0 ),
        .CE(CI),
        .CLK(s_axi_aclk),
        .D(s_axi_awid[11]),
        .Q(bid_fifo_rd[11]));
  (* BOX_TYPE = "PRIMITIVE" *) 
  (* srl_bus_name = "\U0/gext_inst.abcv4_0_ext_inst/GEN_AXI4.I_FULL_AXI/I_WR_CHNL/BID_FIFO/FIFO_RAM " *) 
  (* srl_name = "\U0/gext_inst.abcv4_0_ext_inst/GEN_AXI4.I_FULL_AXI/I_WR_CHNL/BID_FIFO/FIFO_RAM[10].SRL16E_I " *) 
  SRL16E #(
    .INIT(16'h0000),
    .IS_CLK_INVERTED(1'b0)) 
    \FIFO_RAM[10].SRL16E_I 
       (.A0(\Addr_Counters[0].FDRE_I_n_0 ),
        .A1(\Addr_Counters[1].FDRE_I_n_0 ),
        .A2(\Addr_Counters[2].FDRE_I_n_0 ),
        .A3(\Addr_Counters[3].FDRE_I_n_0 ),
        .CE(CI),
        .CLK(s_axi_aclk),
        .D(s_axi_awid[1]),
        .Q(bid_fifo_rd[1]));
  (* BOX_TYPE = "PRIMITIVE" *) 
  (* srl_bus_name = "\U0/gext_inst.abcv4_0_ext_inst/GEN_AXI4.I_FULL_AXI/I_WR_CHNL/BID_FIFO/FIFO_RAM " *) 
  (* srl_name = "\U0/gext_inst.abcv4_0_ext_inst/GEN_AXI4.I_FULL_AXI/I_WR_CHNL/BID_FIFO/FIFO_RAM[11].SRL16E_I " *) 
  SRL16E #(
    .INIT(16'h0000),
    .IS_CLK_INVERTED(1'b0)) 
    \FIFO_RAM[11].SRL16E_I 
       (.A0(\Addr_Counters[0].FDRE_I_n_0 ),
        .A1(\Addr_Counters[1].FDRE_I_n_0 ),
        .A2(\Addr_Counters[2].FDRE_I_n_0 ),
        .A3(\Addr_Counters[3].FDRE_I_n_0 ),
        .CE(CI),
        .CLK(s_axi_aclk),
        .D(s_axi_awid[0]),
        .Q(bid_fifo_rd[0]));
  (* BOX_TYPE = "PRIMITIVE" *) 
  (* srl_bus_name = "\U0/gext_inst.abcv4_0_ext_inst/GEN_AXI4.I_FULL_AXI/I_WR_CHNL/BID_FIFO/FIFO_RAM " *) 
  (* srl_name = "\U0/gext_inst.abcv4_0_ext_inst/GEN_AXI4.I_FULL_AXI/I_WR_CHNL/BID_FIFO/FIFO_RAM[1].SRL16E_I " *) 
  SRL16E #(
    .INIT(16'h0000),
    .IS_CLK_INVERTED(1'b0)) 
    \FIFO_RAM[1].SRL16E_I 
       (.A0(\Addr_Counters[0].FDRE_I_n_0 ),
        .A1(\Addr_Counters[1].FDRE_I_n_0 ),
        .A2(\Addr_Counters[2].FDRE_I_n_0 ),
        .A3(\Addr_Counters[3].FDRE_I_n_0 ),
        .CE(CI),
        .CLK(s_axi_aclk),
        .D(s_axi_awid[10]),
        .Q(bid_fifo_rd[10]));
  (* BOX_TYPE = "PRIMITIVE" *) 
  (* srl_bus_name = "\U0/gext_inst.abcv4_0_ext_inst/GEN_AXI4.I_FULL_AXI/I_WR_CHNL/BID_FIFO/FIFO_RAM " *) 
  (* srl_name = "\U0/gext_inst.abcv4_0_ext_inst/GEN_AXI4.I_FULL_AXI/I_WR_CHNL/BID_FIFO/FIFO_RAM[2].SRL16E_I " *) 
  SRL16E #(
    .INIT(16'h0000),
    .IS_CLK_INVERTED(1'b0)) 
    \FIFO_RAM[2].SRL16E_I 
       (.A0(\Addr_Counters[0].FDRE_I_n_0 ),
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
    .INIT(16'h0000),
    .IS_CLK_INVERTED(1'b0)) 
    \FIFO_RAM[9].SRL16E_I 
       (.A0(\Addr_Counters[0].FDRE_I_n_0 ),
        .A1(\Addr_Counters[1].FDRE_I_n_0 ),
        .A2(\Addr_Counters[2].FDRE_I_n_0 ),
        .A3(\Addr_Counters[3].FDRE_I_n_0 ),
        .CE(CI),
        .CLK(s_axi_aclk),
        .D(s_axi_awid[2]),
        .Q(bid_fifo_rd[2]));
  LUT6 #(
    .INIT(64'hFFFF0004FFFB0000)) 
    \axi_bid_int[0]_i_1 
       (.I0(bid_gets_fifo_load_d1_reg),
        .I1(p_1_out),
        .I2(aw_active_d1_reg),
        .I3(\axi_bid_int[11]_i_4_n_0 ),
        .I4(bid_fifo_rd[0]),
        .I5(s_axi_awid[0]),
        .O(D[0]));
  LUT6 #(
    .INIT(64'hFFFF0004FFFB0000)) 
    \axi_bid_int[10]_i_1 
       (.I0(bid_gets_fifo_load_d1_reg),
        .I1(p_1_out),
        .I2(aw_active_d1_reg),
        .I3(\axi_bid_int[11]_i_4_n_0 ),
        .I4(bid_fifo_rd[10]),
        .I5(s_axi_awid[10]),
        .O(D[10]));
  (* SOFT_HLUTNM = "soft_lutpair37" *) 
  LUT5 #(
    .INIT(32'hFFFF0004)) 
    \axi_bid_int[11]_i_1 
       (.I0(bid_gets_fifo_load_d1_reg),
        .I1(p_1_out),
        .I2(aw_active_d1_reg),
        .I3(\axi_bid_int[11]_i_4_n_0 ),
        .I4(\axi_bid_int[11]_i_5_n_0 ),
        .O(E));
  LUT6 #(
    .INIT(64'hFFFF0004FFFB0000)) 
    \axi_bid_int[11]_i_2 
       (.I0(bid_gets_fifo_load_d1_reg),
        .I1(p_1_out),
        .I2(aw_active_d1_reg),
        .I3(\axi_bid_int[11]_i_4_n_0 ),
        .I4(bid_fifo_rd[11]),
        .I5(s_axi_awid[11]),
        .O(D[11]));
  LUT6 #(
    .INIT(64'hAAFBFBFBFBFBFBFB)) 
    \axi_bid_int[11]_i_3 
       (.I0(\GEN_WDATA_SM_NO_ECC_SNG_REG_WREADY.wr_data_sng_sm_cs_reg[0] ),
        .I1(\axi_bid_int[11]_i_6_n_0 ),
        .I2(\axi_bid_int[11]_i_7_n_0 ),
        .I3(\GEN_WDATA_SM_NO_ECC_SNG_REG_WREADY.wr_data_sng_sm_cs_reg[1] ),
        .I4(s_axi_wvalid),
        .I5(s_axi_wlast),
        .O(bid_gets_fifo_load_d1_reg));
  LUT6 #(
    .INIT(64'hFFFFFFFFFFBFFF00)) 
    \axi_bid_int[11]_i_4 
       (.I0(bid_fifo_not_empty),
        .I1(s_axi_bready),
        .I2(axi_bvalid_int_reg),
        .I3(AW2Arb_BVALID_Cnt[1]),
        .I4(AW2Arb_BVALID_Cnt[0]),
        .I5(AW2Arb_BVALID_Cnt[2]),
        .O(\axi_bid_int[11]_i_4_n_0 ));
  LUT6 #(
    .INIT(64'hA8888888A888AAAA)) 
    \axi_bid_int[11]_i_5 
       (.I0(bid_fifo_not_empty),
        .I1(bid_gets_fifo_load_d1),
        .I2(axi_bvalid_int_reg),
        .I3(s_axi_bready),
        .I4(\axi_bid_int[11]_i_8_n_0 ),
        .I5(bid_gets_fifo_load_d1_reg),
        .O(\axi_bid_int[11]_i_5_n_0 ));
  LUT3 #(
    .INIT(8'h3A)) 
    \axi_bid_int[11]_i_6 
       (.I0(s_axi_wlast),
        .I1(axi_wr_burst),
        .I2(axi_wdata_full_reg),
        .O(\axi_bid_int[11]_i_6_n_0 ));
  LUT4 #(
    .INIT(16'hF1FF)) 
    \axi_bid_int[11]_i_7 
       (.I0(axi_wdata_full_reg),
        .I1(s_axi_wvalid),
        .I2(\GEN_WDATA_SM_NO_ECC_SNG_REG_WREADY.wr_data_sng_sm_cs_reg[1] ),
        .I3(p_1_out),
        .O(\axi_bid_int[11]_i_7_n_0 ));
  LUT3 #(
    .INIT(8'hFE)) 
    \axi_bid_int[11]_i_8 
       (.I0(AW2Arb_BVALID_Cnt[1]),
        .I1(AW2Arb_BVALID_Cnt[2]),
        .I2(AW2Arb_BVALID_Cnt[0]),
        .O(\axi_bid_int[11]_i_8_n_0 ));
  LUT6 #(
    .INIT(64'hFFFF0004FFFB0000)) 
    \axi_bid_int[1]_i_1 
       (.I0(bid_gets_fifo_load_d1_reg),
        .I1(p_1_out),
        .I2(aw_active_d1_reg),
        .I3(\axi_bid_int[11]_i_4_n_0 ),
        .I4(bid_fifo_rd[1]),
        .I5(s_axi_awid[1]),
        .O(D[1]));
  LUT6 #(
    .INIT(64'hFFFF0004FFFB0000)) 
    \axi_bid_int[2]_i_1 
       (.I0(bid_gets_fifo_load_d1_reg),
        .I1(p_1_out),
        .I2(aw_active_d1_reg),
        .I3(\axi_bid_int[11]_i_4_n_0 ),
        .I4(bid_fifo_rd[2]),
        .I5(s_axi_awid[2]),
        .O(D[2]));
  LUT6 #(
    .INIT(64'hFFFF0004FFFB0000)) 
    \axi_bid_int[3]_i_1 
       (.I0(bid_gets_fifo_load_d1_reg),
        .I1(p_1_out),
        .I2(aw_active_d1_reg),
        .I3(\axi_bid_int[11]_i_4_n_0 ),
        .I4(bid_fifo_rd[3]),
        .I5(s_axi_awid[3]),
        .O(D[3]));
  LUT6 #(
    .INIT(64'hFFFF0004FFFB0000)) 
    \axi_bid_int[4]_i_1 
       (.I0(bid_gets_fifo_load_d1_reg),
        .I1(p_1_out),
        .I2(aw_active_d1_reg),
        .I3(\axi_bid_int[11]_i_4_n_0 ),
        .I4(bid_fifo_rd[4]),
        .I5(s_axi_awid[4]),
        .O(D[4]));
  LUT6 #(
    .INIT(64'hFFFF0004FFFB0000)) 
    \axi_bid_int[5]_i_1 
       (.I0(bid_gets_fifo_load_d1_reg),
        .I1(p_1_out),
        .I2(aw_active_d1_reg),
        .I3(\axi_bid_int[11]_i_4_n_0 ),
        .I4(bid_fifo_rd[5]),
        .I5(s_axi_awid[5]),
        .O(D[5]));
  LUT6 #(
    .INIT(64'hFFFF0004FFFB0000)) 
    \axi_bid_int[6]_i_1 
       (.I0(bid_gets_fifo_load_d1_reg),
        .I1(p_1_out),
        .I2(aw_active_d1_reg),
        .I3(\axi_bid_int[11]_i_4_n_0 ),
        .I4(bid_fifo_rd[6]),
        .I5(s_axi_awid[6]),
        .O(D[6]));
  LUT6 #(
    .INIT(64'hFFFF0004FFFB0000)) 
    \axi_bid_int[7]_i_1 
       (.I0(bid_gets_fifo_load_d1_reg),
        .I1(p_1_out),
        .I2(aw_active_d1_reg),
        .I3(\axi_bid_int[11]_i_4_n_0 ),
        .I4(bid_fifo_rd[7]),
        .I5(s_axi_awid[7]),
        .O(D[7]));
  LUT6 #(
    .INIT(64'hFFFF0004FFFB0000)) 
    \axi_bid_int[8]_i_1 
       (.I0(bid_gets_fifo_load_d1_reg),
        .I1(p_1_out),
        .I2(aw_active_d1_reg),
        .I3(\axi_bid_int[11]_i_4_n_0 ),
        .I4(bid_fifo_rd[8]),
        .I5(s_axi_awid[8]),
        .O(D[8]));
  LUT6 #(
    .INIT(64'hFFFF0004FFFB0000)) 
    \axi_bid_int[9]_i_1 
       (.I0(bid_gets_fifo_load_d1_reg),
        .I1(p_1_out),
        .I2(aw_active_d1_reg),
        .I3(\axi_bid_int[11]_i_4_n_0 ),
        .I4(bid_fifo_rd[9]),
        .I5(s_axi_awid[9]),
        .O(D[9]));
  (* SOFT_HLUTNM = "soft_lutpair37" *) 
  LUT4 #(
    .INIT(16'h0004)) 
    bid_gets_fifo_load_d1_i_1
       (.I0(bid_gets_fifo_load_d1_reg),
        .I1(p_1_out),
        .I2(aw_active_d1_reg),
        .I3(\axi_bid_int[11]_i_4_n_0 ),
        .O(bid_gets_fifo_load));
endmodule

(* ORIG_REF_NAME = "axi_bram_ctrl" *) 
module Integrated_axi_bram_ctrl_0_0_axi_bram_ctrl
   (s_axi_rvalid,
    s_axi_rlast,
    bram_rst_a,
    bram_addr_a,
    s_axi_bvalid,
    s_axi_bid,
    bram_wrdata_a,
    s_axi_rid,
    s_axi_rdata,
    s_axi_awready,
    s_axi_arready,
    bram_we_a,
    bram_en_a,
    s_axi_wready,
    s_axi_aresetn,
    s_axi_wvalid,
    s_axi_arlen,
    s_axi_rready,
    s_axi_awvalid,
    s_axi_arvalid,
    s_axi_arburst,
    s_axi_awid,
    s_axi_aclk,
    s_axi_awlen,
    s_axi_wlast,
    s_axi_bready,
    s_axi_wstrb,
    s_axi_wdata,
    s_axi_arid,
    bram_rddata_a,
    s_axi_araddr,
    s_axi_awaddr,
    s_axi_awburst);
  output s_axi_rvalid;
  output s_axi_rlast;
  output bram_rst_a;
  output [10:0]bram_addr_a;
  output s_axi_bvalid;
  output [11:0]s_axi_bid;
  output [31:0]bram_wrdata_a;
  output [11:0]s_axi_rid;
  output [31:0]s_axi_rdata;
  output s_axi_awready;
  output s_axi_arready;
  output [3:0]bram_we_a;
  output bram_en_a;
  output s_axi_wready;
  input s_axi_aresetn;
  input s_axi_wvalid;
  input [7:0]s_axi_arlen;
  input s_axi_rready;
  input s_axi_awvalid;
  input s_axi_arvalid;
  input [1:0]s_axi_arburst;
  input [11:0]s_axi_awid;
  input s_axi_aclk;
  input [3:0]s_axi_awlen;
  input s_axi_wlast;
  input s_axi_bready;
  input [3:0]s_axi_wstrb;
  input [31:0]s_axi_wdata;
  input [11:0]s_axi_arid;
  input [31:0]bram_rddata_a;
  input [10:0]s_axi_araddr;
  input [10:0]s_axi_awaddr;
  input [1:0]s_axi_awburst;

  wire [10:0]bram_addr_a;
  wire bram_en_a;
  wire [31:0]bram_rddata_a;
  wire bram_rst_a;
  wire [3:0]bram_we_a;
  wire [31:0]bram_wrdata_a;
  wire s_axi_aclk;
  wire [10:0]s_axi_araddr;
  wire [1:0]s_axi_arburst;
  wire s_axi_aresetn;
  wire [11:0]s_axi_arid;
  wire [7:0]s_axi_arlen;
  wire s_axi_arready;
  wire s_axi_arvalid;
  wire [10:0]s_axi_awaddr;
  wire [1:0]s_axi_awburst;
  wire [11:0]s_axi_awid;
  wire [3:0]s_axi_awlen;
  wire s_axi_awready;
  wire s_axi_awvalid;
  wire [11:0]s_axi_bid;
  wire s_axi_bready;
  wire s_axi_bvalid;
  wire [31:0]s_axi_rdata;
  wire [11:0]s_axi_rid;
  wire s_axi_rlast;
  wire s_axi_rready;
  wire s_axi_rvalid;
  wire [31:0]s_axi_wdata;
  wire s_axi_wlast;
  wire s_axi_wready;
  wire [3:0]s_axi_wstrb;
  wire s_axi_wvalid;

  Integrated_axi_bram_ctrl_0_0_axi_bram_ctrl_top \gext_inst.abcv4_0_ext_inst 
       (.bram_addr_a(bram_addr_a),
        .bram_en_a(bram_en_a),
        .bram_rddata_a(bram_rddata_a),
        .bram_rst_a(bram_rst_a),
        .bram_we_a(bram_we_a),
        .bram_wrdata_a(bram_wrdata_a),
        .s_axi_aclk(s_axi_aclk),
        .s_axi_araddr(s_axi_araddr),
        .s_axi_arburst(s_axi_arburst),
        .s_axi_aresetn(s_axi_aresetn),
        .s_axi_arid(s_axi_arid),
        .s_axi_arlen(s_axi_arlen),
        .s_axi_arready(s_axi_arready),
        .s_axi_arvalid(s_axi_arvalid),
        .s_axi_awaddr(s_axi_awaddr),
        .s_axi_awburst(s_axi_awburst),
        .s_axi_awid(s_axi_awid),
        .s_axi_awlen(s_axi_awlen),
        .s_axi_awready(s_axi_awready),
        .s_axi_awvalid(s_axi_awvalid),
        .s_axi_bid(s_axi_bid),
        .s_axi_bready(s_axi_bready),
        .s_axi_bvalid(s_axi_bvalid),
        .s_axi_rdata(s_axi_rdata),
        .s_axi_rid(s_axi_rid),
        .s_axi_rlast(s_axi_rlast),
        .s_axi_rready(s_axi_rready),
        .s_axi_rvalid(s_axi_rvalid),
        .s_axi_wdata(s_axi_wdata),
        .s_axi_wlast(s_axi_wlast),
        .s_axi_wready(s_axi_wready),
        .s_axi_wstrb(s_axi_wstrb),
        .s_axi_wvalid(s_axi_wvalid));
endmodule

(* ORIG_REF_NAME = "axi_bram_ctrl_top" *) 
module Integrated_axi_bram_ctrl_0_0_axi_bram_ctrl_top
   (s_axi_rvalid,
    s_axi_rlast,
    bram_rst_a,
    bram_addr_a,
    s_axi_bvalid,
    s_axi_bid,
    bram_wrdata_a,
    s_axi_rid,
    s_axi_rdata,
    s_axi_awready,
    s_axi_arready,
    bram_we_a,
    bram_en_a,
    s_axi_wready,
    s_axi_aresetn,
    s_axi_wvalid,
    s_axi_arlen,
    s_axi_rready,
    s_axi_awvalid,
    s_axi_arvalid,
    s_axi_arburst,
    s_axi_awid,
    s_axi_aclk,
    s_axi_awlen,
    s_axi_wlast,
    s_axi_bready,
    s_axi_wstrb,
    s_axi_wdata,
    s_axi_arid,
    bram_rddata_a,
    s_axi_araddr,
    s_axi_awaddr,
    s_axi_awburst);
  output s_axi_rvalid;
  output s_axi_rlast;
  output bram_rst_a;
  output [10:0]bram_addr_a;
  output s_axi_bvalid;
  output [11:0]s_axi_bid;
  output [31:0]bram_wrdata_a;
  output [11:0]s_axi_rid;
  output [31:0]s_axi_rdata;
  output s_axi_awready;
  output s_axi_arready;
  output [3:0]bram_we_a;
  output bram_en_a;
  output s_axi_wready;
  input s_axi_aresetn;
  input s_axi_wvalid;
  input [7:0]s_axi_arlen;
  input s_axi_rready;
  input s_axi_awvalid;
  input s_axi_arvalid;
  input [1:0]s_axi_arburst;
  input [11:0]s_axi_awid;
  input s_axi_aclk;
  input [3:0]s_axi_awlen;
  input s_axi_wlast;
  input s_axi_bready;
  input [3:0]s_axi_wstrb;
  input [31:0]s_axi_wdata;
  input [11:0]s_axi_arid;
  input [31:0]bram_rddata_a;
  input [10:0]s_axi_araddr;
  input [10:0]s_axi_awaddr;
  input [1:0]s_axi_awburst;

  wire [10:0]bram_addr_a;
  wire bram_en_a;
  wire [31:0]bram_rddata_a;
  wire bram_rst_a;
  wire [3:0]bram_we_a;
  wire [31:0]bram_wrdata_a;
  wire s_axi_aclk;
  wire [10:0]s_axi_araddr;
  wire [1:0]s_axi_arburst;
  wire s_axi_aresetn;
  wire [11:0]s_axi_arid;
  wire [7:0]s_axi_arlen;
  wire s_axi_arready;
  wire s_axi_arvalid;
  wire [10:0]s_axi_awaddr;
  wire [1:0]s_axi_awburst;
  wire [11:0]s_axi_awid;
  wire [3:0]s_axi_awlen;
  wire s_axi_awready;
  wire s_axi_awvalid;
  wire [11:0]s_axi_bid;
  wire s_axi_bready;
  wire s_axi_bvalid;
  wire [31:0]s_axi_rdata;
  wire [11:0]s_axi_rid;
  wire s_axi_rlast;
  wire s_axi_rready;
  wire s_axi_rvalid;
  wire [31:0]s_axi_wdata;
  wire s_axi_wlast;
  wire s_axi_wready;
  wire [3:0]s_axi_wstrb;
  wire s_axi_wvalid;

  Integrated_axi_bram_ctrl_0_0_full_axi \GEN_AXI4.I_FULL_AXI 
       (.bram_addr_a(bram_addr_a),
        .bram_en_a(bram_en_a),
        .bram_rddata_a(bram_rddata_a),
        .bram_rst_a(bram_rst_a),
        .bram_we_a(bram_we_a),
        .bram_wrdata_a(bram_wrdata_a),
        .s_axi_aclk(s_axi_aclk),
        .s_axi_araddr(s_axi_araddr),
        .s_axi_arburst(s_axi_arburst),
        .s_axi_aresetn(s_axi_aresetn),
        .s_axi_arid(s_axi_arid),
        .s_axi_arlen(s_axi_arlen),
        .s_axi_arready(s_axi_arready),
        .s_axi_arvalid(s_axi_arvalid),
        .s_axi_awaddr(s_axi_awaddr),
        .s_axi_awburst(s_axi_awburst),
        .s_axi_awid(s_axi_awid),
        .s_axi_awlen(s_axi_awlen),
        .s_axi_awready(s_axi_awready),
        .s_axi_awvalid(s_axi_awvalid),
        .s_axi_bid(s_axi_bid),
        .s_axi_bready(s_axi_bready),
        .s_axi_bvalid(s_axi_bvalid),
        .s_axi_rdata(s_axi_rdata),
        .s_axi_rid(s_axi_rid),
        .s_axi_rlast(s_axi_rlast),
        .s_axi_rready(s_axi_rready),
        .s_axi_rvalid(s_axi_rvalid),
        .s_axi_wdata(s_axi_wdata),
        .s_axi_wlast(s_axi_wlast),
        .s_axi_wready(s_axi_wready),
        .s_axi_wstrb(s_axi_wstrb),
        .s_axi_wvalid(s_axi_wvalid));
endmodule

(* ORIG_REF_NAME = "full_axi" *) 
module Integrated_axi_bram_ctrl_0_0_full_axi
   (s_axi_rvalid,
    s_axi_rlast,
    bram_rst_a,
    bram_addr_a,
    s_axi_bvalid,
    s_axi_bid,
    bram_wrdata_a,
    s_axi_rid,
    s_axi_rdata,
    s_axi_awready,
    s_axi_arready,
    bram_we_a,
    bram_en_a,
    s_axi_wready,
    s_axi_aresetn,
    s_axi_wvalid,
    s_axi_arlen,
    s_axi_rready,
    s_axi_awvalid,
    s_axi_arvalid,
    s_axi_arburst,
    s_axi_awid,
    s_axi_aclk,
    s_axi_awlen,
    s_axi_wlast,
    s_axi_bready,
    s_axi_wstrb,
    s_axi_wdata,
    s_axi_arid,
    bram_rddata_a,
    s_axi_araddr,
    s_axi_awaddr,
    s_axi_awburst);
  output s_axi_rvalid;
  output s_axi_rlast;
  output bram_rst_a;
  output [10:0]bram_addr_a;
  output s_axi_bvalid;
  output [11:0]s_axi_bid;
  output [31:0]bram_wrdata_a;
  output [11:0]s_axi_rid;
  output [31:0]s_axi_rdata;
  output s_axi_awready;
  output s_axi_arready;
  output [3:0]bram_we_a;
  output bram_en_a;
  output s_axi_wready;
  input s_axi_aresetn;
  input s_axi_wvalid;
  input [7:0]s_axi_arlen;
  input s_axi_rready;
  input s_axi_awvalid;
  input s_axi_arvalid;
  input [1:0]s_axi_arburst;
  input [11:0]s_axi_awid;
  input s_axi_aclk;
  input [3:0]s_axi_awlen;
  input s_axi_wlast;
  input s_axi_bready;
  input [3:0]s_axi_wstrb;
  input [31:0]s_axi_wdata;
  input [11:0]s_axi_arid;
  input [31:0]bram_rddata_a;
  input [10:0]s_axi_araddr;
  input [10:0]s_axi_awaddr;
  input [1:0]s_axi_awburst;

  wire \ADDR_SNG_PORT.bram_addr_int[10]_i_2_n_0 ;
  wire \ADDR_SNG_PORT.bram_addr_int[11]_i_6_n_0 ;
  wire \ADDR_SNG_PORT.bram_addr_int[12]_i_1_n_0 ;
  wire \ADDR_SNG_PORT.bram_addr_int[4]_i_2_n_0 ;
  wire \ADDR_SNG_PORT.bram_addr_int[5]_i_2_n_0 ;
  wire \ADDR_SNG_PORT.bram_addr_int[7]_i_2_n_0 ;
  wire \ADDR_SNG_PORT.bram_addr_int[8]_i_2_n_0 ;
  wire \ADDR_SNG_PORT.bram_addr_int[9]_i_2_n_0 ;
  wire \GEN_ARB.I_SNG_PORT_n_15 ;
  wire \GEN_ARB.I_SNG_PORT_n_5 ;
  wire \GEN_ARB.I_SNG_PORT_n_6 ;
  wire I_RD_CHNL_n_38;
  wire I_RD_CHNL_n_39;
  wire I_RD_CHNL_n_40;
  wire I_RD_CHNL_n_41;
  wire I_RD_CHNL_n_42;
  wire I_RD_CHNL_n_43;
  wire I_RD_CHNL_n_44;
  wire I_RD_CHNL_n_45;
  wire I_RD_CHNL_n_46;
  wire I_RD_CHNL_n_47;
  wire I_RD_CHNL_n_50;
  wire I_RD_CHNL_n_51;
  wire I_RD_CHNL_n_52;
  wire I_RD_CHNL_n_53;
  wire I_WR_CHNL_n_38;
  wire I_WR_CHNL_n_39;
  wire I_WR_CHNL_n_40;
  wire I_WR_CHNL_n_41;
  wire I_WR_CHNL_n_42;
  wire I_WR_CHNL_n_53;
  wire I_WR_CHNL_n_54;
  wire I_WR_CHNL_n_55;
  wire I_WR_CHNL_n_56;
  wire [10:10]RdChnl_BRAM_Addr_Ld;
  wire [10:1]WrChnl_BRAM_Addr_Ld;
  wire ar_active_d1;
  wire ar_active_re;
  wire [1:0]arb_sm_cs;
  wire aw_active_d1;
  wire aw_active_re;
  wire axi_rd_burst_two;
  wire [10:0]bram_addr_a;
  wire bram_en_a;
  wire [31:0]bram_rddata_a;
  wire bram_rst_a;
  wire [3:0]bram_we_a;
  wire [31:0]bram_wrdata_a;
  wire curr_fixed_burst_reg;
  wire last_arb_won;
  wire p_0_out;
  wire p_1_out;
  wire [3:0]p_6_in;
  wire p_7_in;
  wire s_axi_aclk;
  wire [10:0]s_axi_araddr;
  wire [1:0]s_axi_arburst;
  wire s_axi_aresetn;
  wire [11:0]s_axi_arid;
  wire [7:0]s_axi_arlen;
  wire s_axi_arready;
  wire s_axi_arvalid;
  wire [10:0]s_axi_awaddr;
  wire [1:0]s_axi_awburst;
  wire [11:0]s_axi_awid;
  wire [3:0]s_axi_awlen;
  wire s_axi_awready;
  wire s_axi_awvalid;
  wire [11:0]s_axi_bid;
  wire s_axi_bready;
  wire s_axi_bvalid;
  wire [31:0]s_axi_rdata;
  wire [11:0]s_axi_rid;
  wire s_axi_rlast;
  wire s_axi_rready;
  wire s_axi_rvalid;
  wire [31:0]s_axi_wdata;
  wire s_axi_wlast;
  wire s_axi_wready;
  wire [3:0]s_axi_wstrb;
  wire s_axi_wvalid;
  wire sng_bram_addr_ld_en;
  wire [1:0]wr_data_sng_sm_cs;

  (* SOFT_HLUTNM = "soft_lutpair47" *) 
  LUT5 #(
    .INIT(32'h80000000)) 
    \ADDR_SNG_PORT.bram_addr_int[10]_i_2 
       (.I0(bram_addr_a[7]),
        .I1(bram_addr_a[5]),
        .I2(I_RD_CHNL_n_50),
        .I3(bram_addr_a[4]),
        .I4(bram_addr_a[6]),
        .O(\ADDR_SNG_PORT.bram_addr_int[10]_i_2_n_0 ));
  LUT6 #(
    .INIT(64'h8000000000000000)) 
    \ADDR_SNG_PORT.bram_addr_int[11]_i_6 
       (.I0(bram_addr_a[8]),
        .I1(bram_addr_a[6]),
        .I2(bram_addr_a[4]),
        .I3(I_RD_CHNL_n_50),
        .I4(bram_addr_a[5]),
        .I5(bram_addr_a[7]),
        .O(\ADDR_SNG_PORT.bram_addr_int[11]_i_6_n_0 ));
  LUT6 #(
    .INIT(64'h00000000EEE222E2)) 
    \ADDR_SNG_PORT.bram_addr_int[12]_i_1 
       (.I0(bram_addr_a[10]),
        .I1(sng_bram_addr_ld_en),
        .I2(WrChnl_BRAM_Addr_Ld[10]),
        .I3(p_0_out),
        .I4(RdChnl_BRAM_Addr_Ld),
        .I5(I_WR_CHNL_n_40),
        .O(\ADDR_SNG_PORT.bram_addr_int[12]_i_1_n_0 ));
  LUT2 #(
    .INIT(4'h8)) 
    \ADDR_SNG_PORT.bram_addr_int[4]_i_2 
       (.I0(bram_addr_a[0]),
        .I1(bram_addr_a[1]),
        .O(\ADDR_SNG_PORT.bram_addr_int[4]_i_2_n_0 ));
  (* SOFT_HLUTNM = "soft_lutpair46" *) 
  LUT3 #(
    .INIT(8'h7F)) 
    \ADDR_SNG_PORT.bram_addr_int[5]_i_2 
       (.I0(bram_addr_a[2]),
        .I1(bram_addr_a[1]),
        .I2(bram_addr_a[0]),
        .O(\ADDR_SNG_PORT.bram_addr_int[5]_i_2_n_0 ));
  (* SOFT_HLUTNM = "soft_lutpair46" *) 
  LUT5 #(
    .INIT(32'h7FFFFFFF)) 
    \ADDR_SNG_PORT.bram_addr_int[7]_i_2 
       (.I0(bram_addr_a[4]),
        .I1(bram_addr_a[2]),
        .I2(bram_addr_a[1]),
        .I3(bram_addr_a[0]),
        .I4(bram_addr_a[3]),
        .O(\ADDR_SNG_PORT.bram_addr_int[7]_i_2_n_0 ));
  LUT6 #(
    .INIT(64'h8000000000000000)) 
    \ADDR_SNG_PORT.bram_addr_int[8]_i_2 
       (.I0(bram_addr_a[5]),
        .I1(bram_addr_a[3]),
        .I2(bram_addr_a[0]),
        .I3(bram_addr_a[1]),
        .I4(bram_addr_a[2]),
        .I5(bram_addr_a[4]),
        .O(\ADDR_SNG_PORT.bram_addr_int[8]_i_2_n_0 ));
  (* SOFT_HLUTNM = "soft_lutpair47" *) 
  LUT4 #(
    .INIT(16'h8000)) 
    \ADDR_SNG_PORT.bram_addr_int[9]_i_2 
       (.I0(bram_addr_a[6]),
        .I1(bram_addr_a[4]),
        .I2(I_RD_CHNL_n_50),
        .I3(bram_addr_a[5]),
        .O(\ADDR_SNG_PORT.bram_addr_int[9]_i_2_n_0 ));
  FDRE #(
    .INIT(1'b0)) 
    \ADDR_SNG_PORT.bram_addr_int_reg[10] 
       (.C(s_axi_aclk),
        .CE(I_RD_CHNL_n_51),
        .D(I_RD_CHNL_n_39),
        .Q(bram_addr_a[8]),
        .R(I_WR_CHNL_n_40));
  FDRE #(
    .INIT(1'b0)) 
    \ADDR_SNG_PORT.bram_addr_int_reg[11] 
       (.C(s_axi_aclk),
        .CE(I_RD_CHNL_n_51),
        .D(I_RD_CHNL_n_38),
        .Q(bram_addr_a[9]),
        .R(I_WR_CHNL_n_40));
  FDRE #(
    .INIT(1'b0)) 
    \ADDR_SNG_PORT.bram_addr_int_reg[12] 
       (.C(s_axi_aclk),
        .CE(1'b1),
        .D(\ADDR_SNG_PORT.bram_addr_int[12]_i_1_n_0 ),
        .Q(bram_addr_a[10]),
        .R(1'b0));
  FDRE #(
    .INIT(1'b0)) 
    \ADDR_SNG_PORT.bram_addr_int_reg[2] 
       (.C(s_axi_aclk),
        .CE(I_RD_CHNL_n_51),
        .D(I_RD_CHNL_n_47),
        .Q(bram_addr_a[0]),
        .R(I_WR_CHNL_n_40));
  FDRE #(
    .INIT(1'b0)) 
    \ADDR_SNG_PORT.bram_addr_int_reg[3] 
       (.C(s_axi_aclk),
        .CE(I_RD_CHNL_n_51),
        .D(I_RD_CHNL_n_46),
        .Q(bram_addr_a[1]),
        .R(I_WR_CHNL_n_40));
  FDRE #(
    .INIT(1'b0)) 
    \ADDR_SNG_PORT.bram_addr_int_reg[4] 
       (.C(s_axi_aclk),
        .CE(I_RD_CHNL_n_51),
        .D(I_RD_CHNL_n_45),
        .Q(bram_addr_a[2]),
        .R(I_WR_CHNL_n_40));
  FDRE #(
    .INIT(1'b0)) 
    \ADDR_SNG_PORT.bram_addr_int_reg[5] 
       (.C(s_axi_aclk),
        .CE(I_RD_CHNL_n_51),
        .D(I_RD_CHNL_n_44),
        .Q(bram_addr_a[3]),
        .R(I_WR_CHNL_n_40));
  FDRE #(
    .INIT(1'b0)) 
    \ADDR_SNG_PORT.bram_addr_int_reg[6] 
       (.C(s_axi_aclk),
        .CE(I_RD_CHNL_n_51),
        .D(I_RD_CHNL_n_43),
        .Q(bram_addr_a[4]),
        .R(I_WR_CHNL_n_40));
  FDRE #(
    .INIT(1'b0)) 
    \ADDR_SNG_PORT.bram_addr_int_reg[7] 
       (.C(s_axi_aclk),
        .CE(I_RD_CHNL_n_51),
        .D(I_RD_CHNL_n_42),
        .Q(bram_addr_a[5]),
        .R(I_WR_CHNL_n_40));
  FDRE #(
    .INIT(1'b0)) 
    \ADDR_SNG_PORT.bram_addr_int_reg[8] 
       (.C(s_axi_aclk),
        .CE(I_RD_CHNL_n_51),
        .D(I_RD_CHNL_n_41),
        .Q(bram_addr_a[6]),
        .R(I_WR_CHNL_n_40));
  FDRE #(
    .INIT(1'b0)) 
    \ADDR_SNG_PORT.bram_addr_int_reg[9] 
       (.C(s_axi_aclk),
        .CE(I_RD_CHNL_n_51),
        .D(I_RD_CHNL_n_40),
        .Q(bram_addr_a[7]),
        .R(I_WR_CHNL_n_40));
  Integrated_axi_bram_ctrl_0_0_sng_port_arb \GEN_ARB.I_SNG_PORT 
       (.\GEN_AR_SNG.ar_active_d1_reg (\GEN_ARB.I_SNG_PORT_n_15 ),
        .\GEN_WDATA_SM_NO_ECC_SNG_REG_WREADY.wr_data_sng_sm_cs_reg[0] (I_WR_CHNL_n_53),
        .\GEN_WDATA_SM_NO_ECC_SNG_REG_WREADY.wr_data_sng_sm_cs_reg[1] (I_WR_CHNL_n_55),
        .Q(p_6_in),
        .ar_active_d1(ar_active_d1),
        .ar_active_re(ar_active_re),
        .arb_sm_cs(arb_sm_cs),
        .\arb_sm_cs_reg[1]_0 (I_WR_CHNL_n_39),
        .aw_active_d1(aw_active_d1),
        .aw_active_re(aw_active_re),
        .axi_rd_burst_two(axi_rd_burst_two),
        .axi_rlast_int_reg(s_axi_rlast),
        .axi_rlast_int_reg_0(I_RD_CHNL_n_53),
        .bram_we_a(bram_we_a),
        .brst_one_reg(\GEN_ARB.I_SNG_PORT_n_5 ),
        .brst_zero_reg(\GEN_ARB.I_SNG_PORT_n_6 ),
        .\bvalid_cnt_reg[2] (I_WR_CHNL_n_56),
        .last_arb_won(last_arb_won),
        .last_arb_won_reg_0(I_WR_CHNL_n_54),
        .p_0_out(p_0_out),
        .p_1_out(p_1_out),
        .s_axi_aclk(s_axi_aclk),
        .s_axi_aresetn(s_axi_aresetn),
        .s_axi_aresetn_0(bram_rst_a),
        .s_axi_arlen(s_axi_arlen[3:0]),
        .\s_axi_arlen[6] (I_RD_CHNL_n_52),
        .s_axi_arready(s_axi_arready),
        .s_axi_arvalid(s_axi_arvalid),
        .s_axi_awready(s_axi_awready),
        .s_axi_awvalid(s_axi_awvalid),
        .s_axi_rready(s_axi_rready),
        .wr_data_sng_sm_cs(wr_data_sng_sm_cs));
  Integrated_axi_bram_ctrl_0_0_rd_chnl I_RD_CHNL
       (.\ADDR_SNG_PORT.bram_addr_int_reg[10] (\ADDR_SNG_PORT.bram_addr_int[11]_i_6_n_0 ),
        .\ADDR_SNG_PORT.bram_addr_int_reg[2] (\ADDR_SNG_PORT.bram_addr_int[4]_i_2_n_0 ),
        .\ADDR_SNG_PORT.bram_addr_int_reg[4] (\ADDR_SNG_PORT.bram_addr_int[5]_i_2_n_0 ),
        .\ADDR_SNG_PORT.bram_addr_int_reg[6] (I_RD_CHNL_n_50),
        .\ADDR_SNG_PORT.bram_addr_int_reg[6]_0 (\ADDR_SNG_PORT.bram_addr_int[7]_i_2_n_0 ),
        .\ADDR_SNG_PORT.bram_addr_int_reg[7] (\ADDR_SNG_PORT.bram_addr_int[8]_i_2_n_0 ),
        .\ADDR_SNG_PORT.bram_addr_int_reg[8] (\ADDR_SNG_PORT.bram_addr_int[9]_i_2_n_0 ),
        .\ADDR_SNG_PORT.bram_addr_int_reg[9] (\ADDR_SNG_PORT.bram_addr_int[10]_i_2_n_0 ),
        .D({I_RD_CHNL_n_38,I_RD_CHNL_n_39,I_RD_CHNL_n_40,I_RD_CHNL_n_41,I_RD_CHNL_n_42,I_RD_CHNL_n_43,I_RD_CHNL_n_44,I_RD_CHNL_n_45,I_RD_CHNL_n_46,I_RD_CHNL_n_47}),
        .E(I_RD_CHNL_n_51),
        .\GEN_WDATA_SM_NO_ECC_SNG_REG_WREADY.wr_data_sng_sm_cs_reg[0] (I_WR_CHNL_n_38),
        .Q(bram_addr_a[9:0]),
        .ar_active_d1(ar_active_d1),
        .ar_active_re(ar_active_re),
        .ar_active_reg(\GEN_ARB.I_SNG_PORT_n_15 ),
        .ar_active_reg_0(I_WR_CHNL_n_42),
        .ar_active_reg_1(\GEN_ARB.I_SNG_PORT_n_6 ),
        .ar_active_reg_2(\GEN_ARB.I_SNG_PORT_n_5 ),
        .\arb_sm_cs_reg[1] (I_RD_CHNL_n_53),
        .axi_rd_burst_reg_0(I_RD_CHNL_n_52),
        .axi_rd_burst_two(axi_rd_burst_two),
        .bram_rddata_a(bram_rddata_a),
        .bram_rst_a(bram_rst_a),
        .curr_fixed_burst_reg(curr_fixed_burst_reg),
        .curr_wrap_burst_reg_reg_0(I_WR_CHNL_n_41),
        .p_0_out(p_0_out),
        .p_7_in(p_7_in),
        .s_axi_aclk(s_axi_aclk),
        .s_axi_araddr(s_axi_araddr),
        .s_axi_arburst(s_axi_arburst),
        .s_axi_aresetn(s_axi_aresetn),
        .s_axi_arid(s_axi_arid),
        .s_axi_arlen(s_axi_arlen),
        .s_axi_rdata(s_axi_rdata),
        .s_axi_rid(s_axi_rid),
        .s_axi_rlast(s_axi_rlast),
        .s_axi_rready(s_axi_rready),
        .s_axi_rvalid(s_axi_rvalid),
        .\save_init_bram_addr_ld_reg[11] (WrChnl_BRAM_Addr_Ld[9:1]),
        .\save_init_bram_addr_ld_reg[12] (RdChnl_BRAM_Addr_Ld),
        .sng_bram_addr_ld_en(sng_bram_addr_ld_en));
  Integrated_axi_bram_ctrl_0_0_wr_chnl I_WR_CHNL
       (.\ADDR_SNG_PORT.bram_addr_int_reg[11] (I_WR_CHNL_n_38),
        .\ADDR_SNG_PORT.bram_addr_int_reg[11]_0 (I_WR_CHNL_n_40),
        .\ADDR_SNG_PORT.bram_addr_int_reg[2] (I_WR_CHNL_n_42),
        .\ADDR_SNG_PORT.bram_addr_int_reg[3] (I_WR_CHNL_n_41),
        .\ADDR_SNG_PORT.bram_addr_int_reg[5] (I_RD_CHNL_n_50),
        .D(WrChnl_BRAM_Addr_Ld),
        .Q(bram_addr_a[2:0]),
        .arb_sm_cs(arb_sm_cs),
        .\arb_sm_cs_reg[1] (I_WR_CHNL_n_55),
        .\arb_sm_cs_reg[1]_0 (I_WR_CHNL_n_56),
        .aw_active_d1(aw_active_d1),
        .aw_active_re(aw_active_re),
        .aw_active_reg(I_WR_CHNL_n_53),
        .axi_awready_int_reg(I_WR_CHNL_n_54),
        .axi_rlast_int_reg(I_RD_CHNL_n_53),
        .bram_en_a(bram_en_a),
        .\bram_we_a[3] (p_6_in),
        .bram_wrdata_a(bram_wrdata_a),
        .curr_fixed_burst_reg(curr_fixed_burst_reg),
        .last_arb_won(last_arb_won),
        .last_arb_won_reg(I_WR_CHNL_n_39),
        .p_0_out(p_0_out),
        .p_1_out(p_1_out),
        .p_7_in(p_7_in),
        .s_axi_aclk(s_axi_aclk),
        .s_axi_aresetn(s_axi_aresetn),
        .s_axi_aresetn_0(bram_rst_a),
        .s_axi_arvalid(s_axi_arvalid),
        .s_axi_awaddr(s_axi_awaddr),
        .s_axi_awburst(s_axi_awburst),
        .s_axi_awid(s_axi_awid),
        .s_axi_awlen(s_axi_awlen),
        .s_axi_awvalid(s_axi_awvalid),
        .s_axi_bid(s_axi_bid),
        .s_axi_bready(s_axi_bready),
        .s_axi_bvalid(s_axi_bvalid),
        .s_axi_wdata(s_axi_wdata),
        .s_axi_wlast(s_axi_wlast),
        .s_axi_wready(s_axi_wready),
        .s_axi_wstrb(s_axi_wstrb),
        .s_axi_wvalid(s_axi_wvalid),
        .wr_data_sng_sm_cs(wr_data_sng_sm_cs));
endmodule

(* ORIG_REF_NAME = "rd_chnl" *) 
module Integrated_axi_bram_ctrl_0_0_rd_chnl
   (bram_rst_a,
    s_axi_rdata,
    ar_active_d1,
    s_axi_rvalid,
    s_axi_rlast,
    p_7_in,
    axi_rd_burst_two,
    D,
    sng_bram_addr_ld_en,
    \save_init_bram_addr_ld_reg[12] ,
    \ADDR_SNG_PORT.bram_addr_int_reg[6] ,
    E,
    axi_rd_burst_reg_0,
    \arb_sm_cs_reg[1] ,
    s_axi_rid,
    s_axi_aclk,
    ar_active_re,
    ar_active_reg,
    p_0_out,
    s_axi_rready,
    s_axi_aresetn,
    s_axi_arburst,
    s_axi_araddr,
    ar_active_reg_0,
    Q,
    \save_init_bram_addr_ld_reg[11] ,
    \ADDR_SNG_PORT.bram_addr_int_reg[4] ,
    \ADDR_SNG_PORT.bram_addr_int_reg[6]_0 ,
    \ADDR_SNG_PORT.bram_addr_int_reg[7] ,
    \ADDR_SNG_PORT.bram_addr_int_reg[8] ,
    \ADDR_SNG_PORT.bram_addr_int_reg[9] ,
    \ADDR_SNG_PORT.bram_addr_int_reg[10] ,
    curr_fixed_burst_reg,
    \GEN_WDATA_SM_NO_ECC_SNG_REG_WREADY.wr_data_sng_sm_cs_reg[0] ,
    \ADDR_SNG_PORT.bram_addr_int_reg[2] ,
    curr_wrap_burst_reg_reg_0,
    s_axi_arlen,
    ar_active_reg_1,
    s_axi_arid,
    ar_active_reg_2,
    bram_rddata_a);
  output bram_rst_a;
  output [31:0]s_axi_rdata;
  output ar_active_d1;
  output s_axi_rvalid;
  output s_axi_rlast;
  output p_7_in;
  output axi_rd_burst_two;
  output [9:0]D;
  output sng_bram_addr_ld_en;
  output [0:0]\save_init_bram_addr_ld_reg[12] ;
  output \ADDR_SNG_PORT.bram_addr_int_reg[6] ;
  output [0:0]E;
  output axi_rd_burst_reg_0;
  output \arb_sm_cs_reg[1] ;
  output [11:0]s_axi_rid;
  input s_axi_aclk;
  input ar_active_re;
  input ar_active_reg;
  input p_0_out;
  input s_axi_rready;
  input s_axi_aresetn;
  input [1:0]s_axi_arburst;
  input [10:0]s_axi_araddr;
  input ar_active_reg_0;
  input [9:0]Q;
  input [8:0]\save_init_bram_addr_ld_reg[11] ;
  input \ADDR_SNG_PORT.bram_addr_int_reg[4] ;
  input \ADDR_SNG_PORT.bram_addr_int_reg[6]_0 ;
  input \ADDR_SNG_PORT.bram_addr_int_reg[7] ;
  input \ADDR_SNG_PORT.bram_addr_int_reg[8] ;
  input \ADDR_SNG_PORT.bram_addr_int_reg[9] ;
  input \ADDR_SNG_PORT.bram_addr_int_reg[10] ;
  input curr_fixed_burst_reg;
  input \GEN_WDATA_SM_NO_ECC_SNG_REG_WREADY.wr_data_sng_sm_cs_reg[0] ;
  input \ADDR_SNG_PORT.bram_addr_int_reg[2] ;
  input curr_wrap_burst_reg_reg_0;
  input [7:0]s_axi_arlen;
  input ar_active_reg_1;
  input [11:0]s_axi_arid;
  input ar_active_reg_2;
  input [31:0]bram_rddata_a;

  wire \/i__n_0 ;
  wire \ADDR_SNG_PORT.bram_addr_int_reg[10] ;
  wire \ADDR_SNG_PORT.bram_addr_int_reg[2] ;
  wire \ADDR_SNG_PORT.bram_addr_int_reg[4] ;
  wire \ADDR_SNG_PORT.bram_addr_int_reg[6] ;
  wire \ADDR_SNG_PORT.bram_addr_int_reg[6]_0 ;
  wire \ADDR_SNG_PORT.bram_addr_int_reg[7] ;
  wire \ADDR_SNG_PORT.bram_addr_int_reg[8] ;
  wire \ADDR_SNG_PORT.bram_addr_int_reg[9] ;
  wire [9:0]D;
  wire [0:0]E;
  wire \FSM_sequential_rlast_sm_cs[0]_i_1_n_0 ;
  wire \FSM_sequential_rlast_sm_cs[0]_i_2_n_0 ;
  wire \FSM_sequential_rlast_sm_cs[1]_i_1_n_0 ;
  wire \FSM_sequential_rlast_sm_cs[1]_i_2_n_0 ;
  wire \FSM_sequential_rlast_sm_cs[2]_i_1_n_0 ;
  wire \GEN_BRST_MAX_WO_NARROW.brst_cnt_max_i_1_n_0 ;
  wire \GEN_RDATA_NO_ECC.GEN_RDATA[0].axi_rdata_int[0]_i_1_n_0 ;
  wire \GEN_RDATA_NO_ECC.GEN_RDATA[10].axi_rdata_int[10]_i_1_n_0 ;
  wire \GEN_RDATA_NO_ECC.GEN_RDATA[11].axi_rdata_int[11]_i_1_n_0 ;
  wire \GEN_RDATA_NO_ECC.GEN_RDATA[12].axi_rdata_int[12]_i_1_n_0 ;
  wire \GEN_RDATA_NO_ECC.GEN_RDATA[13].axi_rdata_int[13]_i_1_n_0 ;
  wire \GEN_RDATA_NO_ECC.GEN_RDATA[14].axi_rdata_int[14]_i_1_n_0 ;
  wire \GEN_RDATA_NO_ECC.GEN_RDATA[15].axi_rdata_int[15]_i_1_n_0 ;
  wire \GEN_RDATA_NO_ECC.GEN_RDATA[16].axi_rdata_int[16]_i_1_n_0 ;
  wire \GEN_RDATA_NO_ECC.GEN_RDATA[17].axi_rdata_int[17]_i_1_n_0 ;
  wire \GEN_RDATA_NO_ECC.GEN_RDATA[18].axi_rdata_int[18]_i_1_n_0 ;
  wire \GEN_RDATA_NO_ECC.GEN_RDATA[19].axi_rdata_int[19]_i_1_n_0 ;
  wire \GEN_RDATA_NO_ECC.GEN_RDATA[1].axi_rdata_int[1]_i_1_n_0 ;
  wire \GEN_RDATA_NO_ECC.GEN_RDATA[20].axi_rdata_int[20]_i_1_n_0 ;
  wire \GEN_RDATA_NO_ECC.GEN_RDATA[21].axi_rdata_int[21]_i_1_n_0 ;
  wire \GEN_RDATA_NO_ECC.GEN_RDATA[22].axi_rdata_int[22]_i_1_n_0 ;
  wire \GEN_RDATA_NO_ECC.GEN_RDATA[23].axi_rdata_int[23]_i_1_n_0 ;
  wire \GEN_RDATA_NO_ECC.GEN_RDATA[24].axi_rdata_int[24]_i_1_n_0 ;
  wire \GEN_RDATA_NO_ECC.GEN_RDATA[25].axi_rdata_int[25]_i_1_n_0 ;
  wire \GEN_RDATA_NO_ECC.GEN_RDATA[26].axi_rdata_int[26]_i_1_n_0 ;
  wire \GEN_RDATA_NO_ECC.GEN_RDATA[27].axi_rdata_int[27]_i_1_n_0 ;
  wire \GEN_RDATA_NO_ECC.GEN_RDATA[28].axi_rdata_int[28]_i_1_n_0 ;
  wire \GEN_RDATA_NO_ECC.GEN_RDATA[29].axi_rdata_int[29]_i_1_n_0 ;
  wire \GEN_RDATA_NO_ECC.GEN_RDATA[2].axi_rdata_int[2]_i_1_n_0 ;
  wire \GEN_RDATA_NO_ECC.GEN_RDATA[30].axi_rdata_int[30]_i_1_n_0 ;
  wire \GEN_RDATA_NO_ECC.GEN_RDATA[31].axi_rdata_int[31]_i_2_n_0 ;
  wire \GEN_RDATA_NO_ECC.GEN_RDATA[31].axi_rdata_int[31]_i_3_n_0 ;
  wire \GEN_RDATA_NO_ECC.GEN_RDATA[3].axi_rdata_int[3]_i_1_n_0 ;
  wire \GEN_RDATA_NO_ECC.GEN_RDATA[4].axi_rdata_int[4]_i_1_n_0 ;
  wire \GEN_RDATA_NO_ECC.GEN_RDATA[5].axi_rdata_int[5]_i_1_n_0 ;
  wire \GEN_RDATA_NO_ECC.GEN_RDATA[6].axi_rdata_int[6]_i_1_n_0 ;
  wire \GEN_RDATA_NO_ECC.GEN_RDATA[7].axi_rdata_int[7]_i_1_n_0 ;
  wire \GEN_RDATA_NO_ECC.GEN_RDATA[8].axi_rdata_int[8]_i_1_n_0 ;
  wire \GEN_RDATA_NO_ECC.GEN_RDATA[9].axi_rdata_int[9]_i_1_n_0 ;
  wire \GEN_RID_SNG.axi_rid_int[0]_i_1_n_0 ;
  wire \GEN_RID_SNG.axi_rid_int[10]_i_1_n_0 ;
  wire \GEN_RID_SNG.axi_rid_int[11]_i_1_n_0 ;
  wire \GEN_RID_SNG.axi_rid_int[11]_i_2_n_0 ;
  wire \GEN_RID_SNG.axi_rid_int[11]_i_3_n_0 ;
  wire \GEN_RID_SNG.axi_rid_int[1]_i_1_n_0 ;
  wire \GEN_RID_SNG.axi_rid_int[2]_i_1_n_0 ;
  wire \GEN_RID_SNG.axi_rid_int[3]_i_1_n_0 ;
  wire \GEN_RID_SNG.axi_rid_int[4]_i_1_n_0 ;
  wire \GEN_RID_SNG.axi_rid_int[5]_i_1_n_0 ;
  wire \GEN_RID_SNG.axi_rid_int[6]_i_1_n_0 ;
  wire \GEN_RID_SNG.axi_rid_int[7]_i_1_n_0 ;
  wire \GEN_RID_SNG.axi_rid_int[8]_i_1_n_0 ;
  wire \GEN_RID_SNG.axi_rid_int[9]_i_1_n_0 ;
  wire \GEN_WDATA_SM_NO_ECC_SNG_REG_WREADY.wr_data_sng_sm_cs_reg[0] ;
  wire I_WRAP_BRST_n_13;
  wire I_WRAP_BRST_n_15;
  wire [9:0]Q;
  wire act_rd_burst;
  wire act_rd_burst_i_1_n_0;
  wire act_rd_burst_i_3_n_0;
  wire act_rd_burst_set;
  wire act_rd_burst_two;
  wire act_rd_burst_two_i_1_n_0;
  wire ar_active_d1;
  wire ar_active_re;
  wire ar_active_reg;
  wire ar_active_reg_0;
  wire ar_active_reg_1;
  wire ar_active_reg_2;
  wire \arb_sm_cs_reg[1] ;
  wire axi_rd_burst;
  wire axi_rd_burst_i_1_n_0;
  wire axi_rd_burst_i_3_n_0;
  wire axi_rd_burst_i_4_n_0;
  wire axi_rd_burst_reg_0;
  wire axi_rd_burst_two;
  wire axi_rd_burst_two_i_1_n_0;
  wire axi_rd_burst_two_reg_n_0;
  wire axi_rdata_en;
  wire [11:0]axi_rid_temp;
  wire axi_rlast_int_i_1_n_0;
  wire axi_rlast_set;
  wire axi_rvalid_clr_ok;
  wire axi_rvalid_clr_ok_i_1_n_0;
  wire axi_rvalid_clr_ok_i_2_n_0;
  wire axi_rvalid_int_i_1_n_0;
  wire axi_rvalid_set;
  wire axi_rvalid_set_cmb;
  wire bram_en_int_i_1_n_0;
  wire bram_en_int_i_2_n_0;
  wire bram_en_int_i_3_n_0;
  wire bram_en_int_i_4_n_0;
  wire bram_en_int_i_5_n_0;
  wire bram_en_int_i_6_n_0;
  wire bram_en_int_i_7_n_0;
  wire bram_en_int_i_8_n_0;
  wire bram_en_int_i_9_n_0;
  wire [31:0]bram_rddata_a;
  wire bram_rst_a;
  wire [7:0]brst_cnt;
  wire \brst_cnt[0]_i_1_n_0 ;
  wire \brst_cnt[1]_i_1_n_0 ;
  wire \brst_cnt[2]_i_1_n_0 ;
  wire \brst_cnt[3]_i_1_n_0 ;
  wire \brst_cnt[4]_i_1_n_0 ;
  wire \brst_cnt[4]_i_2_n_0 ;
  wire \brst_cnt[5]_i_1_n_0 ;
  wire \brst_cnt[6]_i_1_n_0 ;
  wire \brst_cnt[7]_i_1_n_0 ;
  wire \brst_cnt[7]_i_2_n_0 ;
  wire \brst_cnt[7]_i_3_n_0 ;
  wire brst_cnt_max;
  wire brst_cnt_max_d1;
  wire brst_one;
  wire brst_one_i_1_n_0;
  wire brst_one_i_2_n_0;
  wire brst_one_i_4_n_0;
  wire brst_one_i_5_n_0;
  wire brst_zero;
  wire brst_zero_i_1_n_0;
  wire curr_fixed_burst;
  wire curr_fixed_burst_reg;
  wire curr_fixed_burst_reg_0;
  wire curr_wrap_burst_reg;
  wire curr_wrap_burst_reg_i_1__0_n_0;
  wire curr_wrap_burst_reg_reg_0;
  wire disable_b2b_brst;
  wire disable_b2b_brst_cmb;
  wire disable_b2b_brst_i_2_n_0;
  wire disable_b2b_brst_i_3_n_0;
  wire disable_b2b_brst_i_4_n_0;
  wire end_brst_rd;
  wire end_brst_rd_clr;
  wire end_brst_rd_clr_i_1_n_0;
  wire end_brst_rd_i_1_n_0;
  wire last_bram_addr;
  wire last_bram_addr0;
  wire last_bram_addr_i_2_n_0;
  wire last_bram_addr_i_3_n_0;
  wire last_bram_addr_i_4_n_0;
  wire last_bram_addr_i_5_n_0;
  wire p_0_in4_in;
  wire p_0_out;
  wire p_7_in;
  wire pend_rd_op;
  wire pend_rd_op_i_1_n_0;
  wire pend_rd_op_i_2_n_0;
  wire pend_rd_op_i_3_n_0;
  wire pend_rd_op_i_4_n_0;
  wire rd_adv_buf24_out;
  wire [3:0]rd_data_sm_cs;
  wire \rd_data_sm_cs[0]_i_1_n_0 ;
  wire \rd_data_sm_cs[0]_i_2_n_0 ;
  wire \rd_data_sm_cs[0]_i_3_n_0 ;
  wire \rd_data_sm_cs[0]_i_4_n_0 ;
  wire \rd_data_sm_cs[1]_i_1_n_0 ;
  wire \rd_data_sm_cs[1]_i_3_n_0 ;
  wire \rd_data_sm_cs[2]_i_1_n_0 ;
  wire \rd_data_sm_cs[2]_i_2_n_0 ;
  wire \rd_data_sm_cs[2]_i_3_n_0 ;
  wire \rd_data_sm_cs[3]_i_2_n_0 ;
  wire \rd_data_sm_cs[3]_i_3_n_0 ;
  wire \rd_data_sm_cs[3]_i_4_n_0 ;
  wire \rd_data_sm_cs[3]_i_5_n_0 ;
  wire \rd_data_sm_cs[3]_i_6_n_0 ;
  wire \rd_data_sm_cs[3]_i_7_n_0 ;
  wire \rd_data_sm_cs[3]_i_8_n_0 ;
  wire rd_data_sm_ns;
  wire [31:0]rd_skid_buf;
  wire rd_skid_buf_ld;
  wire rd_skid_buf_ld_cmb;
  wire rd_skid_buf_ld_reg;
  wire rddata_mux_sel;
  wire rddata_mux_sel_cmb;
  wire rddata_mux_sel_i_1_n_0;
  wire rddata_mux_sel_i_3_n_0;
  (* RTL_KEEP = "yes" *) wire [2:0]rlast_sm_cs;
  wire s_axi_aclk;
  wire [10:0]s_axi_araddr;
  wire [1:0]s_axi_arburst;
  wire s_axi_aresetn;
  wire [11:0]s_axi_arid;
  wire [7:0]s_axi_arlen;
  wire [31:0]s_axi_rdata;
  wire [11:0]s_axi_rid;
  wire s_axi_rlast;
  wire s_axi_rready;
  wire s_axi_rvalid;
  wire [8:0]\save_init_bram_addr_ld_reg[11] ;
  wire [0:0]\save_init_bram_addr_ld_reg[12] ;
  wire sng_bram_addr_ld_en;

  LUT6 #(
    .INIT(64'h1000F1111000E000)) 
    \/i_ 
       (.I0(rlast_sm_cs[0]),
        .I1(rlast_sm_cs[1]),
        .I2(s_axi_rready),
        .I3(s_axi_rvalid),
        .I4(rlast_sm_cs[2]),
        .I5(last_bram_addr),
        .O(\/i__n_0 ));
  LUT6 #(
    .INIT(64'h00008080000F8080)) 
    \/i___0 
       (.I0(s_axi_rvalid),
        .I1(s_axi_rready),
        .I2(rlast_sm_cs[0]),
        .I3(rlast_sm_cs[1]),
        .I4(rlast_sm_cs[2]),
        .I5(s_axi_rlast),
        .O(axi_rlast_set));
  LUT5 #(
    .INIT(32'h01FF0100)) 
    \FSM_sequential_rlast_sm_cs[0]_i_1 
       (.I0(rlast_sm_cs[2]),
        .I1(rlast_sm_cs[0]),
        .I2(\FSM_sequential_rlast_sm_cs[0]_i_2_n_0 ),
        .I3(\/i__n_0 ),
        .I4(rlast_sm_cs[0]),
        .O(\FSM_sequential_rlast_sm_cs[0]_i_1_n_0 ));
  LUT6 #(
    .INIT(64'h0011001300130013)) 
    \FSM_sequential_rlast_sm_cs[0]_i_2 
       (.I0(axi_rd_burst),
        .I1(rlast_sm_cs[1]),
        .I2(act_rd_burst_two),
        .I3(axi_rd_burst_two_reg_n_0),
        .I4(s_axi_rready),
        .I5(s_axi_rvalid),
        .O(\FSM_sequential_rlast_sm_cs[0]_i_2_n_0 ));
  LUT5 #(
    .INIT(32'h01FF0100)) 
    \FSM_sequential_rlast_sm_cs[1]_i_1 
       (.I0(rlast_sm_cs[2]),
        .I1(rlast_sm_cs[0]),
        .I2(\FSM_sequential_rlast_sm_cs[1]_i_2_n_0 ),
        .I3(\/i__n_0 ),
        .I4(rlast_sm_cs[1]),
        .O(\FSM_sequential_rlast_sm_cs[1]_i_1_n_0 ));
  LUT6 #(
    .INIT(64'h003F007F003F0055)) 
    \FSM_sequential_rlast_sm_cs[1]_i_2 
       (.I0(axi_rd_burst),
        .I1(s_axi_rvalid),
        .I2(s_axi_rready),
        .I3(rlast_sm_cs[1]),
        .I4(axi_rd_burst_two_reg_n_0),
        .I5(act_rd_burst_two),
        .O(\FSM_sequential_rlast_sm_cs[1]_i_2_n_0 ));
  LUT6 #(
    .INIT(64'h00A4FFFF00A40000)) 
    \FSM_sequential_rlast_sm_cs[2]_i_1 
       (.I0(rlast_sm_cs[1]),
        .I1(p_0_in4_in),
        .I2(rlast_sm_cs[0]),
        .I3(rlast_sm_cs[2]),
        .I4(\/i__n_0 ),
        .I5(rlast_sm_cs[2]),
        .O(\FSM_sequential_rlast_sm_cs[2]_i_1_n_0 ));
  LUT2 #(
    .INIT(4'h1)) 
    \FSM_sequential_rlast_sm_cs[2]_i_2 
       (.I0(axi_rd_burst),
        .I1(axi_rd_burst_two_reg_n_0),
        .O(p_0_in4_in));
  (* KEEP = "yes" *) 
  FDRE \FSM_sequential_rlast_sm_cs_reg[0] 
       (.C(s_axi_aclk),
        .CE(1'b1),
        .D(\FSM_sequential_rlast_sm_cs[0]_i_1_n_0 ),
        .Q(rlast_sm_cs[0]),
        .R(bram_rst_a));
  (* KEEP = "yes" *) 
  FDRE \FSM_sequential_rlast_sm_cs_reg[1] 
       (.C(s_axi_aclk),
        .CE(1'b1),
        .D(\FSM_sequential_rlast_sm_cs[1]_i_1_n_0 ),
        .Q(rlast_sm_cs[1]),
        .R(bram_rst_a));
  (* KEEP = "yes" *) 
  FDRE \FSM_sequential_rlast_sm_cs_reg[2] 
       (.C(s_axi_aclk),
        .CE(1'b1),
        .D(\FSM_sequential_rlast_sm_cs[2]_i_1_n_0 ),
        .Q(rlast_sm_cs[2]),
        .R(bram_rst_a));
  FDRE #(
    .INIT(1'b0)) 
    \GEN_AR_SNG.ar_active_d1_reg 
       (.C(s_axi_aclk),
        .CE(1'b1),
        .D(ar_active_reg),
        .Q(ar_active_d1),
        .R(1'b0));
  LUT6 #(
    .INIT(64'hBA00AA000000AA00)) 
    \GEN_BRST_MAX_WO_NARROW.brst_cnt_max_i_1 
       (.I0(brst_cnt_max),
        .I1(pend_rd_op),
        .I2(brst_zero),
        .I3(s_axi_aresetn),
        .I4(p_0_out),
        .I5(ar_active_d1),
        .O(\GEN_BRST_MAX_WO_NARROW.brst_cnt_max_i_1_n_0 ));
  FDRE #(
    .INIT(1'b0)) 
    \GEN_BRST_MAX_WO_NARROW.brst_cnt_max_reg 
       (.C(s_axi_aclk),
        .CE(1'b1),
        .D(\GEN_BRST_MAX_WO_NARROW.brst_cnt_max_i_1_n_0 ),
        .Q(brst_cnt_max),
        .R(1'b0));
  (* SOFT_HLUTNM = "soft_lutpair20" *) 
  LUT3 #(
    .INIT(8'hAC)) 
    \GEN_RDATA_NO_ECC.GEN_RDATA[0].axi_rdata_int[0]_i_1 
       (.I0(rd_skid_buf[0]),
        .I1(bram_rddata_a[0]),
        .I2(rddata_mux_sel),
        .O(\GEN_RDATA_NO_ECC.GEN_RDATA[0].axi_rdata_int[0]_i_1_n_0 ));
  FDRE #(
    .INIT(1'b0)) 
    \GEN_RDATA_NO_ECC.GEN_RDATA[0].axi_rdata_int_reg[0] 
       (.C(s_axi_aclk),
        .CE(axi_rdata_en),
        .D(\GEN_RDATA_NO_ECC.GEN_RDATA[0].axi_rdata_int[0]_i_1_n_0 ),
        .Q(s_axi_rdata[0]),
        .R(\GEN_RID_SNG.axi_rid_int[11]_i_1_n_0 ));
  (* SOFT_HLUTNM = "soft_lutpair20" *) 
  LUT3 #(
    .INIT(8'hAC)) 
    \GEN_RDATA_NO_ECC.GEN_RDATA[10].axi_rdata_int[10]_i_1 
       (.I0(rd_skid_buf[10]),
        .I1(bram_rddata_a[10]),
        .I2(rddata_mux_sel),
        .O(\GEN_RDATA_NO_ECC.GEN_RDATA[10].axi_rdata_int[10]_i_1_n_0 ));
  FDRE #(
    .INIT(1'b0)) 
    \GEN_RDATA_NO_ECC.GEN_RDATA[10].axi_rdata_int_reg[10] 
       (.C(s_axi_aclk),
        .CE(axi_rdata_en),
        .D(\GEN_RDATA_NO_ECC.GEN_RDATA[10].axi_rdata_int[10]_i_1_n_0 ),
        .Q(s_axi_rdata[10]),
        .R(\GEN_RID_SNG.axi_rid_int[11]_i_1_n_0 ));
  (* SOFT_HLUTNM = "soft_lutpair30" *) 
  LUT3 #(
    .INIT(8'hAC)) 
    \GEN_RDATA_NO_ECC.GEN_RDATA[11].axi_rdata_int[11]_i_1 
       (.I0(rd_skid_buf[11]),
        .I1(bram_rddata_a[11]),
        .I2(rddata_mux_sel),
        .O(\GEN_RDATA_NO_ECC.GEN_RDATA[11].axi_rdata_int[11]_i_1_n_0 ));
  FDRE #(
    .INIT(1'b0)) 
    \GEN_RDATA_NO_ECC.GEN_RDATA[11].axi_rdata_int_reg[11] 
       (.C(s_axi_aclk),
        .CE(axi_rdata_en),
        .D(\GEN_RDATA_NO_ECC.GEN_RDATA[11].axi_rdata_int[11]_i_1_n_0 ),
        .Q(s_axi_rdata[11]),
        .R(\GEN_RID_SNG.axi_rid_int[11]_i_1_n_0 ));
  (* SOFT_HLUTNM = "soft_lutpair31" *) 
  LUT3 #(
    .INIT(8'hAC)) 
    \GEN_RDATA_NO_ECC.GEN_RDATA[12].axi_rdata_int[12]_i_1 
       (.I0(rd_skid_buf[12]),
        .I1(bram_rddata_a[12]),
        .I2(rddata_mux_sel),
        .O(\GEN_RDATA_NO_ECC.GEN_RDATA[12].axi_rdata_int[12]_i_1_n_0 ));
  FDRE #(
    .INIT(1'b0)) 
    \GEN_RDATA_NO_ECC.GEN_RDATA[12].axi_rdata_int_reg[12] 
       (.C(s_axi_aclk),
        .CE(axi_rdata_en),
        .D(\GEN_RDATA_NO_ECC.GEN_RDATA[12].axi_rdata_int[12]_i_1_n_0 ),
        .Q(s_axi_rdata[12]),
        .R(\GEN_RID_SNG.axi_rid_int[11]_i_1_n_0 ));
  (* SOFT_HLUTNM = "soft_lutpair32" *) 
  LUT3 #(
    .INIT(8'hAC)) 
    \GEN_RDATA_NO_ECC.GEN_RDATA[13].axi_rdata_int[13]_i_1 
       (.I0(rd_skid_buf[13]),
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
        .D(\GEN_RDATA_NO_ECC.GEN_RDATA[29].axi_rdata_int[29]_i_1_n_0 ),
        .Q(s_axi_rdata[29]),
        .R(\GEN_RID_SNG.axi_rid_int[11]_i_1_n_0 ));
  (* SOFT_HLUTNM = "soft_lutpair22" *) 
  LUT3 #(
    .INIT(8'hAC)) 
    \GEN_RDATA_NO_ECC.GEN_RDATA[2].axi_rdata_int[2]_i_1 
       (.I0(rd_skid_buf[2]),
        .I1(bram_rddata_a[2]),
        .I2(rddata_mux_sel),
        .O(\GEN_RDATA_NO_ECC.GEN_RDATA[2].axi_rdata_int[2]_i_1_n_0 ));
  FDRE #(
    .INIT(1'b0)) 
    \GEN_RDATA_NO_ECC.GEN_RDATA[2].axi_rdata_int_reg[2] 
       (.C(s_axi_aclk),
        .CE(axi_rdata_en),
        .D(\GEN_RDATA_NO_ECC.GEN_RDATA[2].axi_rdata_int[2]_i_1_n_0 ),
        .Q(s_axi_rdata[2]),
        .R(\GEN_RID_SNG.axi_rid_int[11]_i_1_n_0 ));
  (* SOFT_HLUTNM = "soft_lutpair22" *) 
  LUT3 #(
    .INIT(8'hAC)) 
    \GEN_RDATA_NO_ECC.GEN_RDATA[30].axi_rdata_int[30]_i_1 
       (.I0(rd_skid_buf[30]),
        .I1(bram_rddata_a[30]),
        .I2(rddata_mux_sel),
        .O(\GEN_RDATA_NO_ECC.GEN_RDATA[30].axi_rdata_int[30]_i_1_n_0 ));
  FDRE #(
    .INIT(1'b0)) 
    \GEN_RDATA_NO_ECC.GEN_RDATA[30].axi_rdata_int_reg[30] 
       (.C(s_axi_aclk),
        .CE(axi_rdata_en),
        .D(\GEN_RDATA_NO_ECC.GEN_RDATA[30].axi_rdata_int[30]_i_1_n_0 ),
        .Q(s_axi_rdata[30]),
        .R(\GEN_RID_SNG.axi_rid_int[11]_i_1_n_0 ));
  LUT6 #(
    .INIT(64'h0000000030F8F300)) 
    \GEN_RDATA_NO_ECC.GEN_RDATA[31].axi_rdata_int[31]_i_1 
       (.I0(\GEN_RDATA_NO_ECC.GEN_RDATA[31].axi_rdata_int[31]_i_3_n_0 ),
        .I1(rd_data_sm_cs[0]),
        .I2(rd_adv_buf24_out),
        .I3(rd_data_sm_cs[1]),
        .I4(rd_data_sm_cs[2]),
        .I5(rd_data_sm_cs[3]),
        .O(axi_rdata_en));
  (* SOFT_HLUTNM = "soft_lutpair21" *) 
  LUT3 #(
    .INIT(8'hAC)) 
    \GEN_RDATA_NO_ECC.GEN_RDATA[31].axi_rdata_int[31]_i_2 
       (.I0(rd_skid_buf[31]),
        .I1(bram_rddata_a[31]),
        .I2(rddata_mux_sel),
        .O(\GEN_RDATA_NO_ECC.GEN_RDATA[31].axi_rdata_int[31]_i_2_n_0 ));
  (* SOFT_HLUTNM = "soft_lutpair13" *) 
  LUT2 #(
    .INIT(4'h1)) 
    \GEN_RDATA_NO_ECC.GEN_RDATA[31].axi_rdata_int[31]_i_3 
       (.I0(act_rd_burst_two),
        .I1(act_rd_burst),
        .O(\GEN_RDATA_NO_ECC.GEN_RDATA[31].axi_rdata_int[31]_i_3_n_0 ));
  (* SOFT_HLUTNM = "soft_lutpair10" *) 
  LUT2 #(
    .INIT(4'h8)) 
    \GEN_RDATA_NO_ECC.GEN_RDATA[31].axi_rdata_int[31]_i_4 
       (.I0(s_axi_rready),
        .I1(s_axi_rvalid),
        .O(rd_adv_buf24_out));
  FDRE #(
    .INIT(1'b0)) 
    \GEN_RDATA_NO_ECC.GEN_RDATA[31].axi_rdata_int_reg[31] 
       (.C(s_axi_aclk),
        .CE(axi_rdata_en),
        .D(\GEN_RDATA_NO_ECC.GEN_RDATA[31].axi_rdata_int[31]_i_2_n_0 ),
        .Q(s_axi_rdata[31]),
        .R(\GEN_RID_SNG.axi_rid_int[11]_i_1_n_0 ));
  (* SOFT_HLUTNM = "soft_lutpair23" *) 
  LUT3 #(
    .INIT(8'hAC)) 
    \GEN_RDATA_NO_ECC.GEN_RDATA[3].axi_rdata_int[3]_i_1 
       (.I0(rd_skid_buf[3]),
        .I1(bram_rddata_a[3]),
        .I2(rddata_mux_sel),
        .O(\GEN_RDATA_NO_ECC.GEN_RDATA[3].axi_rdata_int[3]_i_1_n_0 ));
  FDRE #(
    .INIT(1'b0)) 
    \GEN_RDATA_NO_ECC.GEN_RDATA[3].axi_rdata_int_reg[3] 
       (.C(s_axi_aclk),
        .CE(axi_rdata_en),
        .D(\GEN_RDATA_NO_ECC.GEN_RDATA[3].axi_rdata_int[3]_i_1_n_0 ),
        .Q(s_axi_rdata[3]),
        .R(\GEN_RID_SNG.axi_rid_int[11]_i_1_n_0 ));
  (* SOFT_HLUTNM = "soft_lutpair24" *) 
  LUT3 #(
    .INIT(8'hAC)) 
    \GEN_RDATA_NO_ECC.GEN_RDATA[4].axi_rdata_int[4]_i_1 
       (.I0(rd_skid_buf[4]),
        .I1(bram_rddata_a[4]),
        .I2(rddata_mux_sel),
        .O(\GEN_RDATA_NO_ECC.GEN_RDATA[4].axi_rdata_int[4]_i_1_n_0 ));
  FDRE #(
    .INIT(1'b0)) 
    \GEN_RDATA_NO_ECC.GEN_RDATA[4].axi_rdata_int_reg[4] 
       (.C(s_axi_aclk),
        .CE(axi_rdata_en),
        .D(\GEN_RDATA_NO_ECC.GEN_RDATA[4].axi_rdata_int[4]_i_1_n_0 ),
        .Q(s_axi_rdata[4]),
        .R(\GEN_RID_SNG.axi_rid_int[11]_i_1_n_0 ));
  (* SOFT_HLUTNM = "soft_lutpair25" *) 
  LUT3 #(
    .INIT(8'hAC)) 
    \GEN_RDATA_NO_ECC.GEN_RDATA[5].axi_rdata_int[5]_i_1 
       (.I0(rd_skid_buf[5]),
        .I1(bram_rddata_a[5]),
        .I2(rddata_mux_sel),
        .O(\GEN_RDATA_NO_ECC.GEN_RDATA[5].axi_rdata_int[5]_i_1_n_0 ));
  FDRE #(
    .INIT(1'b0)) 
    \GEN_RDATA_NO_ECC.GEN_RDATA[5].axi_rdata_int_reg[5] 
       (.C(s_axi_aclk),
        .CE(axi_rdata_en),
        .D(\GEN_RDATA_NO_ECC.GEN_RDATA[5].axi_rdata_int[5]_i_1_n_0 ),
        .Q(s_axi_rdata[5]),
        .R(\GEN_RID_SNG.axi_rid_int[11]_i_1_n_0 ));
  (* SOFT_HLUTNM = "soft_lutpair26" *) 
  LUT3 #(
    .INIT(8'hAC)) 
    \GEN_RDATA_NO_ECC.GEN_RDATA[6].axi_rdata_int[6]_i_1 
       (.I0(rd_skid_buf[6]),
        .I1(bram_rddata_a[6]),
        .I2(rddata_mux_sel),
        .O(\GEN_RDATA_NO_ECC.GEN_RDATA[6].axi_rdata_int[6]_i_1_n_0 ));
  FDRE #(
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
        .R(bram_rst_a));
  FDRE #(
    .INIT(1'b0)) 
    \GEN_RID_SNG.axi_rid_temp_reg[2] 
       (.C(s_axi_aclk),
        .CE(ar_active_re),
        .D(s_axi_arid[2]),
        .Q(axi_rid_temp[2]),
        .R(bram_rst_a));
  FDRE #(
    .INIT(1'b0)) 
    \GEN_RID_SNG.axi_rid_temp_reg[3] 
       (.C(s_axi_aclk),
        .CE(ar_active_re),
        .D(s_axi_arid[3]),
        .Q(axi_rid_temp[3]),
        .R(bram_rst_a));
  FDRE #(
    .INIT(1'b0)) 
    \GEN_RID_SNG.axi_rid_temp_reg[4] 
       (.C(s_axi_aclk),
        .CE(ar_active_re),
        .D(s_axi_arid[4]),
        .Q(axi_rid_temp[4]),
        .R(bram_rst_a));
  FDRE #(
    .INIT(1'b0)) 
    \GEN_RID_SNG.axi_rid_temp_reg[5] 
       (.C(s_axi_aclk),
        .CE(ar_active_re),
        .D(s_axi_arid[5]),
        .Q(axi_rid_temp[5]),
        .R(bram_rst_a));
  FDRE #(
    .INIT(1'b0)) 
    \GEN_RID_SNG.axi_rid_temp_reg[6] 
       (.C(s_axi_aclk),
        .CE(ar_active_re),
        .D(s_axi_arid[6]),
        .Q(axi_rid_temp[6]),
        .R(bram_rst_a));
  FDRE #(
    .INIT(1'b0)) 
    \GEN_RID_SNG.axi_rid_temp_reg[7] 
       (.C(s_axi_aclk),
        .CE(ar_active_re),
        .D(s_axi_arid[7]),
        .Q(axi_rid_temp[7]),
        .R(bram_rst_a));
  FDRE #(
    .INIT(1'b0)) 
    \GEN_RID_SNG.axi_rid_temp_reg[8] 
       (.C(s_axi_aclk),
        .CE(ar_active_re),
        .D(s_axi_arid[8]),
        .Q(axi_rid_temp[8]),
        .R(bram_rst_a));
  FDRE #(
    .INIT(1'b0)) 
    \GEN_RID_SNG.axi_rid_temp_reg[9] 
       (.C(s_axi_aclk),
        .CE(ar_active_re),
        .D(s_axi_arid[9]),
        .Q(axi_rid_temp[9]),
        .R(bram_rst_a));
  Integrated_axi_bram_ctrl_0_0_wrap_brst_0 I_WRAP_BRST
       (.\ADDR_SNG_PORT.bram_addr_int_reg[10] (\ADDR_SNG_PORT.bram_addr_int_reg[10] ),
        .\ADDR_SNG_PORT.bram_addr_int_reg[11] (I_WRAP_BRST_n_13),
        .\ADDR_SNG_PORT.bram_addr_int_reg[2] (\ADDR_SNG_PORT.bram_addr_int_reg[2] ),
        .\ADDR_SNG_PORT.bram_addr_int_reg[3] (sng_bram_addr_ld_en),
        .\ADDR_SNG_PORT.bram_addr_int_reg[4] (\ADDR_SNG_PORT.bram_addr_int_reg[4] ),
        .\ADDR_SNG_PORT.bram_addr_int_reg[6] (\ADDR_SNG_PORT.bram_addr_int_reg[6] ),
        .\ADDR_SNG_PORT.bram_addr_int_reg[6]_0 (\ADDR_SNG_PORT.bram_addr_int_reg[6]_0 ),
        .\ADDR_SNG_PORT.bram_addr_int_reg[7] (\ADDR_SNG_PORT.bram_addr_int_reg[7] ),
        .\ADDR_SNG_PORT.bram_addr_int_reg[8] (\ADDR_SNG_PORT.bram_addr_int_reg[8] ),
        .\ADDR_SNG_PORT.bram_addr_int_reg[9] (\ADDR_SNG_PORT.bram_addr_int_reg[9] ),
        .D(D),
        .E(E),
        .\GEN_AR_SNG.ar_active_d1_reg (ar_active_d1),
        .\GEN_WDATA_SM_NO_ECC_SNG_REG_WREADY.wr_data_sng_sm_cs_reg[0] (\GEN_WDATA_SM_NO_ECC_SNG_REG_WREADY.wr_data_sng_sm_cs_reg[0] ),
        .Q(Q),
        .ar_active_re(ar_active_re),
        .ar_active_reg(ar_active_reg_0),
        .axi_rd_burst(axi_rd_burst),
        .axi_rd_burst_two_reg(axi_rd_burst_two_reg_n_0),
        .axi_rvalid_int_reg(s_axi_rvalid),
        .bram_rst_a(bram_rst_a),
        .brst_zero(brst_zero),
        .curr_fixed_burst_reg(curr_fixed_burst_reg),
        .curr_fixed_burst_reg_0(curr_fixed_burst_reg_0),
        .curr_wrap_burst_reg(curr_wrap_burst_reg),
        .curr_wrap_burst_reg_reg(curr_wrap_burst_reg_reg_0),
        .end_brst_rd(end_brst_rd),
        .p_0_out(p_0_out),
        .\rd_data_sm_cs_reg[1] (I_WRAP_BRST_n_15),
        .\rd_data_sm_cs_reg[3] (rd_data_sm_cs),
        .s_axi_aclk(s_axi_aclk),
        .s_axi_araddr(s_axi_araddr),
        .s_axi_aresetn(s_axi_aresetn),
        .s_axi_arlen(s_axi_arlen[3:0]),
        .s_axi_rready(s_axi_rready),
        .\save_init_bram_addr_ld_reg[11]_0 (\save_init_bram_addr_ld_reg[11] ),
        .\save_init_bram_addr_ld_reg[12]_0 (\save_init_bram_addr_ld_reg[12] ));
  LUT6 #(
    .INIT(64'h0000000022E2EEE2)) 
    act_rd_burst_i_1
       (.I0(act_rd_burst),
        .I1(act_rd_burst_set),
        .I2(axi_rd_burst),
        .I3(ar_active_re),
        .I4(axi_rd_burst_two),
        .I5(act_rd_burst_i_3_n_0),
        .O(act_rd_burst_i_1_n_0));
  LUT6 #(
    .INIT(64'h0303030002020202)) 
    act_rd_burst_i_2
       (.I0(ar_active_reg_1),
        .I1(rd_data_sm_cs[1]),
        .I2(\rd_data_sm_cs[2]_i_2_n_0 ),
        .I3(axi_rd_burst_two_reg_n_0),
        .I4(axi_rd_burst),
        .I5(rd_data_sm_cs[0]),
        .O(act_rd_burst_set));
  LUT6 #(
    .INIT(64'h20000040FFFFFFFF)) 
    act_rd_burst_i_3
       (.I0(rd_data_sm_cs[2]),
        .I1(rd_data_sm_cs[3]),
        .I2(\rd_data_sm_cs[3]_i_8_n_0 ),
        .I3(rd_data_sm_cs[0]),
        .I4(rd_data_sm_cs[1]),
        .I5(s_axi_aresetn),
        .O(act_rd_burst_i_3_n_0));
  FDRE #(
    .INIT(1'b0)) 
    act_rd_burst_reg
       (.C(s_axi_aclk),
        .CE(1'b1),
        .D(act_rd_burst_i_1_n_0),
        .Q(act_rd_burst),
        .R(1'b0));
  LUT6 #(
    .INIT(64'h00000000EEE222E2)) 
    act_rd_burst_two_i_1
       (.I0(act_rd_burst_two),
        .I1(act_rd_burst_set),
        .I2(axi_rd_burst_two_reg_n_0),
        .I3(ar_active_re),
        .I4(axi_rd_burst_two),
        .I5(act_rd_burst_i_3_n_0),
        .O(act_rd_burst_two_i_1_n_0));
  FDRE #(
    .INIT(1'b0)) 
    act_rd_burst_two_reg
       (.C(s_axi_aclk),
        .CE(1'b1),
        .D(act_rd_burst_two_i_1_n_0),
        .Q(act_rd_burst_two),
        .R(1'b0));
  (* SOFT_HLUTNM = "soft_lutpair16" *) 
  LUT2 #(
    .INIT(4'h8)) 
    axi_arready_int_i_2
       (.I0(s_axi_rlast),
        .I1(s_axi_rready),
        .O(\arb_sm_cs_reg[1] ));
  LUT6 #(
    .INIT(64'h300030000000AA00)) 
    axi_rd_burst_i_1
       (.I0(axi_rd_burst),
        .I1(axi_rd_burst_two),
        .I2(axi_rd_burst_i_3_n_0),
        .I3(s_axi_aresetn),
        .I4(brst_zero),
        .I5(ar_active_re),
        .O(axi_rd_burst_i_1_n_0));
  (* SOFT_HLUTNM = "soft_lutpair7" *) 
  LUT5 #(
    .INIT(32'h00000001)) 
    axi_rd_burst_i_2
       (.I0(s_axi_arlen[6]),
        .I1(s_axi_arlen[7]),
        .I2(s_axi_arlen[5]),
        .I3(s_axi_arlen[4]),
        .I4(axi_rd_burst_i_4_n_0),
        .O(axi_rd_burst_two));
  (* SOFT_HLUTNM = "soft_lutpair8" *) 
  LUT5 #(
    .INIT(32'hFFFFFFFE)) 
    axi_rd_burst_i_3
       (.I0(axi_rd_burst_reg_0),
        .I1(s_axi_arlen[0]),
        .I2(s_axi_arlen[1]),
        .I3(s_axi_arlen[3]),
        .I4(s_axi_arlen[2]),
        .O(axi_rd_burst_i_3_n_0));
  (* SOFT_HLUTNM = "soft_lutpair8" *) 
  LUT4 #(
    .INIT(16'hFFEF)) 
    axi_rd_burst_i_4
       (.I0(s_axi_arlen[2]),
        .I1(s_axi_arlen[3]),
        .I2(s_axi_arlen[0]),
        .I3(s_axi_arlen[1]),
        .O(axi_rd_burst_i_4_n_0));
  FDRE #(
    .INIT(1'b0)) 
    axi_rd_burst_reg
       (.C(s_axi_aclk),
        .CE(1'b1),
        .D(axi_rd_burst_i_1_n_0),
        .Q(axi_rd_burst),
        .R(1'b0));
  LUT6 #(
    .INIT(64'h00A0C0C000A000A0)) 
    axi_rd_burst_two_i_1
       (.I0(axi_rd_burst_two_reg_n_0),
        .I1(axi_rd_burst_two),
        .I2(s_axi_aresetn),
        .I3(brst_zero),
        .I4(ar_active_d1),
        .I5(p_0_out),
        .O(axi_rd_burst_two_i_1_n_0));
  FDRE #(
    .INIT(1'b0)) 
    axi_rd_burst_two_reg
       (.C(s_axi_aclk),
        .CE(1'b1),
        .D(axi_rd_burst_two_i_1_n_0),
        .Q(axi_rd_burst_two_reg_n_0),
        .R(1'b0));
  LUT4 #(
    .INIT(16'hAA20)) 
    axi_rlast_int_i_1
       (.I0(s_axi_aresetn),
        .I1(s_axi_rready),
        .I2(s_axi_rlast),
        .I3(axi_rlast_set),
        .O(axi_rlast_int_i_1_n_0));
  FDRE #(
    .INIT(1'b0)) 
    axi_rlast_int_reg
       (.C(s_axi_aclk),
        .CE(1'b1),
        .D(axi_rlast_int_i_1_n_0),
        .Q(s_axi_rlast),
        .R(1'b0));
  LUT5 #(
    .INIT(32'hFFFFFEAA)) 
    axi_rvalid_clr_ok_i_1
       (.I0(axi_rvalid_clr_ok_i_2_n_0),
        .I1(disable_b2b_brst_i_2_n_0),
        .I2(disable_b2b_brst),
        .I3(last_bram_addr),
        .I4(axi_rvalid_clr_ok),
        .O(axi_rvalid_clr_ok_i_1_n_0));
  LUT6 #(
    .INIT(64'h44444F4444444444)) 
    axi_rvalid_clr_ok_i_2
       (.I0(ar_active_d1),
        .I1(p_0_out),
        .I2(rd_data_sm_cs[3]),
        .I3(rd_data_sm_cs[2]),
        .I4(rd_data_sm_cs[1]),
        .I5(rd_data_sm_cs[0]),
        .O(axi_rvalid_clr_ok_i_2_n_0));
  FDRE #(
    .INIT(1'b0)) 
    axi_rvalid_clr_ok_reg
       (.C(s_axi_aclk),
        .CE(1'b1),
        .D(axi_rvalid_clr_ok_i_1_n_0),
        .Q(axi_rvalid_clr_ok),
        .R(bram_rst_a));
  LUT6 #(
    .INIT(64'h00E0E0E0E0E0E0E0)) 
    axi_rvalid_int_i_1
       (.I0(s_axi_rvalid),
        .I1(axi_rvalid_set),
        .I2(s_axi_aresetn),
        .I3(axi_rvalid_clr_ok),
        .I4(s_axi_rready),
        .I5(s_axi_rlast),
        .O(axi_rvalid_int_i_1_n_0));
  FDRE #(
    .INIT(1'b0)) 
    axi_rvalid_int_reg
       (.C(s_axi_aclk),
        .CE(1'b1),
        .D(axi_rvalid_int_i_1_n_0),
        .Q(s_axi_rvalid),
        .R(1'b0));
  (* SOFT_HLUTNM = "soft_lutpair17" *) 
  LUT4 #(
    .INIT(16'h0002)) 
    axi_rvalid_set_i_1
       (.I0(rd_data_sm_cs[0]),
        .I1(rd_data_sm_cs[1]),
        .I2(rd_data_sm_cs[2]),
        .I3(rd_data_sm_cs[3]),
        .O(axi_rvalid_set_cmb));
  FDRE #(
    .INIT(1'b0)) 
    axi_rvalid_set_reg
       (.C(s_axi_aclk),
        .CE(1'b1),
        .D(axi_rvalid_set_cmb),
        .Q(axi_rvalid_set),
        .R(bram_rst_a));
  LUT6 #(
    .INIT(64'hEFEFEFEEE0E0E0EE)) 
    bram_en_int_i_1
       (.I0(bram_en_int_i_2_n_0),
        .I1(bram_en_int_i_3_n_0),
        .I2(bram_en_int_i_4_n_0),
        .I3(bram_en_int_i_5_n_0),
        .I4(\rd_data_sm_cs[3]_i_7_n_0 ),
        .I5(p_7_in),
        .O(bram_en_int_i_1_n_0));
  LUT6 #(
    .INIT(64'h00F000EE000000F0)) 
    bram_en_int_i_2
       (.I0(axi_rd_burst),
        .I1(axi_rd_burst_two_reg_n_0),
        .I2(ar_active_re),
        .I3(rd_data_sm_cs[1]),
        .I4(rd_data_sm_cs[2]),
        .I5(rd_data_sm_cs[0]),
        .O(bram_en_int_i_2_n_0));
  LUT6 #(
    .INIT(64'hFFFFFFFF00000040)) 
    bram_en_int_i_3
       (.I0(rd_data_sm_cs[0]),
        .I1(rd_data_sm_cs[2]),
        .I2(rd_adv_buf24_out),
        .I3(brst_zero),
        .I4(end_brst_rd),
        .I5(bram_en_int_i_6_n_0),
        .O(bram_en_int_i_3_n_0));
  LUT6 #(
    .INIT(64'h3100313131313131)) 
    bram_en_int_i_4
       (.I0(bram_en_int_i_7_n_0),
        .I1(\rd_data_sm_cs[2]_i_2_n_0 ),
        .I2(ar_active_re),
        .I3(\rd_data_sm_cs[3]_i_5_n_0 ),
        .I4(brst_one),
        .I5(bram_en_int_i_8_n_0),
        .O(bram_en_int_i_4_n_0));
  LUT6 #(
    .INIT(64'hF000FF11F0FFFF11)) 
    bram_en_int_i_5
       (.I0(\rd_data_sm_cs[3]_i_5_n_0 ),
        .I1(rd_adv_buf24_out),
        .I2(bram_en_int_i_9_n_0),
        .I3(rd_data_sm_cs[1]),
        .I4(rd_data_sm_cs[0]),
        .I5(\rd_data_sm_cs[1]_i_3_n_0 ),
        .O(bram_en_int_i_5_n_0));
  LUT6 #(
    .INIT(64'h000002A2AAAA02A2)) 
    bram_en_int_i_6
       (.I0(rd_data_sm_cs[1]),
        .I1(axi_rd_burst_two_reg_n_0),
        .I2(rd_data_sm_cs[0]),
        .I3(\rd_data_sm_cs[3]_i_5_n_0 ),
        .I4(rd_data_sm_cs[2]),
        .I5(bram_en_int_i_9_n_0),
        .O(bram_en_int_i_6_n_0));
  (* SOFT_HLUTNM = "soft_lutpair9" *) 
  LUT2 #(
    .INIT(4'h1)) 
    bram_en_int_i_7
       (.I0(rd_data_sm_cs[0]),
        .I1(rd_data_sm_cs[1]),
        .O(bram_en_int_i_7_n_0));
  (* SOFT_HLUTNM = "soft_lutpair14" *) 
  LUT4 #(
    .INIT(16'h0888)) 
    bram_en_int_i_8
       (.I0(rd_data_sm_cs[1]),
        .I1(rd_data_sm_cs[0]),
        .I2(s_axi_rvalid),
        .I3(s_axi_rready),
        .O(bram_en_int_i_8_n_0));
  (* SOFT_HLUTNM = "soft_lutpair10" *) 
  LUT5 #(
    .INIT(32'h0BBBBBBB)) 
    bram_en_int_i_9
       (.I0(ar_active_d1),
        .I1(p_0_out),
        .I2(pend_rd_op),
        .I3(s_axi_rready),
        .I4(s_axi_rvalid),
        .O(bram_en_int_i_9_n_0));
  FDRE #(
    .INIT(1'b0)) 
    bram_en_int_reg
       (.C(s_axi_aclk),
        .CE(1'b1),
        .D(bram_en_int_i_1_n_0),
        .Q(p_7_in),
        .R(bram_rst_a));
  LUT4 #(
    .INIT(16'h08FB)) 
    \brst_cnt[0]_i_1 
       (.I0(s_axi_arlen[0]),
        .I1(p_0_out),
        .I2(ar_active_d1),
        .I3(brst_cnt[0]),
        .O(\brst_cnt[0]_i_1_n_0 ));
  LUT5 #(
    .INIT(32'hFB0808FB)) 
    \brst_cnt[1]_i_1 
       (.I0(s_axi_arlen[1]),
        .I1(p_0_out),
        .I2(ar_active_d1),
        .I3(brst_cnt[0]),
        .I4(brst_cnt[1]),
        .O(\brst_cnt[1]_i_1_n_0 ));
  LUT6 #(
    .INIT(64'hFBFBFB08080808FB)) 
    \brst_cnt[2]_i_1 
       (.I0(s_axi_arlen[2]),
        .I1(p_0_out),
        .I2(ar_active_d1),
        .I3(brst_cnt[0]),
        .I4(brst_cnt[1]),
        .I5(brst_cnt[2]),
        .O(\brst_cnt[2]_i_1_n_0 ));
  LUT6 #(
    .INIT(64'hBBBBBBB88888888B)) 
    \brst_cnt[3]_i_1 
       (.I0(s_axi_arlen[3]),
        .I1(ar_active_re),
        .I2(brst_cnt[2]),
        .I3(brst_cnt[1]),
        .I4(brst_cnt[0]),
        .I5(brst_cnt[3]),
        .O(\brst_cnt[3]_i_1_n_0 ));
  LUT5 #(
    .INIT(32'hFB0808FB)) 
    \brst_cnt[4]_i_1 
       (.I0(s_axi_arlen[4]),
        .I1(p_0_out),
        .I2(ar_active_d1),
        .I3(\brst_cnt[4]_i_2_n_0 ),
        .I4(brst_cnt[4]),
        .O(\brst_cnt[4]_i_1_n_0 ));
  (* SOFT_HLUTNM = "soft_lutpair11" *) 
  LUT4 #(
    .INIT(16'hFFFE)) 
    \brst_cnt[4]_i_2 
       (.I0(brst_cnt[3]),
        .I1(brst_cnt[0]),
        .I2(brst_cnt[1]),
        .I3(brst_cnt[2]),
        .O(\brst_cnt[4]_i_2_n_0 ));
  LUT5 #(
    .INIT(32'hFB0808FB)) 
    \brst_cnt[5]_i_1 
       (.I0(s_axi_arlen[5]),
        .I1(p_0_out),
        .I2(ar_active_d1),
        .I3(\brst_cnt[7]_i_3_n_0 ),
        .I4(brst_cnt[5]),
        .O(\brst_cnt[5]_i_1_n_0 ));
  LUT6 #(
    .INIT(64'hFB08FB08FB0808FB)) 
    \brst_cnt[6]_i_1 
       (.I0(s_axi_arlen[6]),
        .I1(p_0_out),
        .I2(ar_active_d1),
        .I3(brst_cnt[6]),
        .I4(\brst_cnt[7]_i_3_n_0 ),
        .I5(brst_cnt[5]),
        .O(\brst_cnt[6]_i_1_n_0 ));
  LUT3 #(
    .INIT(8'hF4)) 
    \brst_cnt[7]_i_1 
       (.I0(ar_active_d1),
        .I1(p_0_out),
        .I2(I_WRAP_BRST_n_13),
        .O(\brst_cnt[7]_i_1_n_0 ));
  LUT6 #(
    .INIT(64'hB8B8B8B8B8B8B88B)) 
    \brst_cnt[7]_i_2 
       (.I0(s_axi_arlen[7]),
        .I1(ar_active_re),
        .I2(brst_cnt[7]),
        .I3(\brst_cnt[7]_i_3_n_0 ),
        .I4(brst_cnt[5]),
        .I5(brst_cnt[6]),
        .O(\brst_cnt[7]_i_2_n_0 ));
  (* SOFT_HLUTNM = "soft_lutpair11" *) 
  LUT5 #(
    .INIT(32'hFFFFFFFE)) 
    \brst_cnt[7]_i_3 
       (.I0(brst_cnt[4]),
        .I1(brst_cnt[2]),
        .I2(brst_cnt[1]),
        .I3(brst_cnt[0]),
        .I4(brst_cnt[3]),
        .O(\brst_cnt[7]_i_3_n_0 ));
  FDRE #(
    .INIT(1'b0)) 
    brst_cnt_max_d1_reg
       (.C(s_axi_aclk),
        .CE(1'b1),
        .D(brst_cnt_max),
        .Q(brst_cnt_max_d1),
        .R(bram_rst_a));
  FDRE #(
    .INIT(1'b0)) 
    \brst_cnt_reg[0] 
       (.C(s_axi_aclk),
        .CE(\brst_cnt[7]_i_1_n_0 ),
        .D(\brst_cnt[0]_i_1_n_0 ),
        .Q(brst_cnt[0]),
        .R(bram_rst_a));
  FDRE #(
    .INIT(1'b0)) 
    \brst_cnt_reg[1] 
       (.C(s_axi_aclk),
        .CE(\brst_cnt[7]_i_1_n_0 ),
        .D(\brst_cnt[1]_i_1_n_0 ),
        .Q(brst_cnt[1]),
        .R(bram_rst_a));
  FDRE #(
    .INIT(1'b0)) 
    \brst_cnt_reg[2] 
       (.C(s_axi_aclk),
        .CE(\brst_cnt[7]_i_1_n_0 ),
        .D(\brst_cnt[2]_i_1_n_0 ),
        .Q(brst_cnt[2]),
        .R(bram_rst_a));
  FDRE #(
    .INIT(1'b0)) 
    \brst_cnt_reg[3] 
       (.C(s_axi_aclk),
        .CE(\brst_cnt[7]_i_1_n_0 ),
        .D(\brst_cnt[3]_i_1_n_0 ),
        .Q(brst_cnt[3]),
        .R(bram_rst_a));
  FDRE #(
    .INIT(1'b0)) 
    \brst_cnt_reg[4] 
       (.C(s_axi_aclk),
        .CE(\brst_cnt[7]_i_1_n_0 ),
        .D(\brst_cnt[4]_i_1_n_0 ),
        .Q(brst_cnt[4]),
        .R(bram_rst_a));
  FDRE #(
    .INIT(1'b0)) 
    \brst_cnt_reg[5] 
       (.C(s_axi_aclk),
        .CE(\brst_cnt[7]_i_1_n_0 ),
        .D(\brst_cnt[5]_i_1_n_0 ),
        .Q(brst_cnt[5]),
        .R(bram_rst_a));
  FDRE #(
    .INIT(1'b0)) 
    \brst_cnt_reg[6] 
       (.C(s_axi_aclk),
        .CE(\brst_cnt[7]_i_1_n_0 ),
        .D(\brst_cnt[6]_i_1_n_0 ),
        .Q(brst_cnt[6]),
        .R(bram_rst_a));
  FDRE #(
    .INIT(1'b0)) 
    \brst_cnt_reg[7] 
       (.C(s_axi_aclk),
        .CE(\brst_cnt[7]_i_1_n_0 ),
        .D(\brst_cnt[7]_i_2_n_0 ),
        .Q(brst_cnt[7]),
        .R(bram_rst_a));
  LUT6 #(
    .INIT(64'h0E0E0F0E000E0E0E)) 
    brst_one_i_1
       (.I0(brst_one),
        .I1(brst_one_i_2_n_0),
        .I2(ar_active_reg_2),
        .I3(brst_one_i_4_n_0),
        .I4(brst_cnt[0]),
        .I5(brst_cnt[1]),
        .O(brst_one_i_1_n_0));
  (* SOFT_HLUTNM = "soft_lutpair12" *) 
  LUT3 #(
    .INIT(8'h20)) 
    brst_one_i_2
       (.I0(axi_rd_burst_two),
        .I1(ar_active_d1),
        .I2(p_0_out),
        .O(brst_one_i_2_n_0));
  LUT6 #(
    .INIT(64'h0000000000000002)) 
    brst_one_i_4
       (.I0(I_WRAP_BRST_n_13),
        .I1(brst_one_i_5_n_0),
        .I2(brst_cnt[2]),
        .I3(brst_cnt[4]),
        .I4(brst_cnt[3]),
        .I5(brst_cnt[7]),
        .O(brst_one_i_4_n_0));
  LUT2 #(
    .INIT(4'hE)) 
    brst_one_i_5
       (.I0(brst_cnt[5]),
        .I1(brst_cnt[6]),
        .O(brst_one_i_5_n_0));
  FDRE #(
    .INIT(1'b0)) 
    brst_one_reg
       (.C(s_axi_aclk),
        .CE(1'b1),
        .D(brst_one_i_1_n_0),
        .Q(brst_one),
        .R(1'b0));
  (* SOFT_HLUTNM = "soft_lutpair19" *) 
  LUT4 #(
    .INIT(16'h00E0)) 
    brst_zero_i_1
       (.I0(brst_zero),
        .I1(last_bram_addr_i_3_n_0),
        .I2(s_axi_aresetn),
        .I3(ar_active_reg_1),
        .O(brst_zero_i_1_n_0));
  (* SOFT_HLUTNM = "soft_lutpair7" *) 
  LUT4 #(
    .INIT(16'hFFFE)) 
    brst_zero_i_3
       (.I0(s_axi_arlen[4]),
        .I1(s_axi_arlen[5]),
        .I2(s_axi_arlen[7]),
        .I3(s_axi_arlen[6]),
        .O(axi_rd_burst_reg_0));
  FDRE #(
    .INIT(1'b0)) 
    brst_zero_reg
       (.C(s_axi_aclk),
        .CE(1'b1),
        .D(brst_zero_i_1_n_0),
        .Q(brst_zero),
        .R(1'b0));
  (* SOFT_HLUTNM = "soft_lutpair36" *) 
  LUT2 #(
    .INIT(4'h1)) 
    curr_fixed_burst_reg_i_1__0
       (.I0(s_axi_arburst[0]),
        .I1(s_axi_arburst[1]),
        .O(curr_fixed_burst));
  FDRE #(
    .INIT(1'b0)) 
    curr_fixed_burst_reg_reg
       (.C(s_axi_aclk),
        .CE(ar_active_re),
        .D(curr_fixed_burst),
        .Q(curr_fixed_burst_reg_0),
        .R(bram_rst_a));
  (* SOFT_HLUTNM = "soft_lutpair36" *) 
  LUT2 #(
    .INIT(4'h2)) 
    curr_wrap_burst_reg_i_1__0
       (.I0(s_axi_arburst[1]),
        .I1(s_axi_arburst[0]),
        .O(curr_wrap_burst_reg_i_1__0_n_0));
  FDRE #(
    .INIT(1'b0)) 
    curr_wrap_burst_reg_reg
       (.C(s_axi_aclk),
        .CE(ar_active_re),
        .D(curr_wrap_burst_reg_i_1__0_n_0),
        .Q(curr_wrap_burst_reg),
        .R(bram_rst_a));
  LUT6 #(
    .INIT(64'hFEAEAAAAFEFFAAAA)) 
    disable_b2b_brst_i_1
       (.I0(disable_b2b_brst_i_2_n_0),
        .I1(rd_data_sm_cs[2]),
        .I2(rd_data_sm_cs[1]),
        .I3(rd_data_sm_cs[3]),
        .I4(disable_b2b_brst),
        .I5(rd_data_sm_cs[0]),
        .O(disable_b2b_brst_cmb));
  LUT6 #(
    .INIT(64'h0022000002020000)) 
    disable_b2b_brst_i_2
       (.I0(disable_b2b_brst_i_3_n_0),
        .I1(disable_b2b_brst_i_4_n_0),
        .I2(rd_data_sm_cs[2]),
        .I3(rd_data_sm_cs[3]),
        .I4(rd_data_sm_cs[0]),
        .I5(rd_data_sm_cs[1]),
        .O(disable_b2b_brst_i_2_n_0));
  LUT6 #(
    .INIT(64'hFFFFFFFF00FEFFFF)) 
    disable_b2b_brst_i_3
       (.I0(brst_one),
        .I1(brst_zero),
        .I2(end_brst_rd),
        .I3(rd_adv_buf24_out),
        .I4(rd_data_sm_cs[1]),
        .I5(disable_b2b_brst),
        .O(disable_b2b_brst_i_3_n_0));
  LUT6 #(
    .INIT(64'hFFFFFFFF55550030)) 
    disable_b2b_brst_i_4
       (.I0(disable_b2b_brst),
        .I1(rd_data_sm_cs[1]),
        .I2(axi_rd_burst),
        .I3(axi_rd_burst_two_reg_n_0),
        .I4(rd_data_sm_cs[3]),
        .I5(rd_data_sm_cs[2]),
        .O(disable_b2b_brst_i_4_n_0));
  FDRE #(
    .INIT(1'b0)) 
    disable_b2b_brst_reg
       (.C(s_axi_aclk),
        .CE(1'b1),
        .D(disable_b2b_brst_cmb),
        .Q(disable_b2b_brst),
        .R(bram_rst_a));
  LUT6 #(
    .INIT(64'hFFFAFFFB05000000)) 
    end_brst_rd_clr_i_1
       (.I0(rd_data_sm_cs[3]),
        .I1(ar_active_re),
        .I2(rd_data_sm_cs[1]),
        .I3(rd_data_sm_cs[2]),
        .I4(rd_data_sm_cs[0]),
        .I5(end_brst_rd_clr),
        .O(end_brst_rd_clr_i_1_n_0));
  FDRE #(
    .INIT(1'b0)) 
    end_brst_rd_clr_reg
       (.C(s_axi_aclk),
        .CE(1'b1),
        .D(end_brst_rd_clr_i_1_n_0),
        .Q(end_brst_rd_clr),
        .R(bram_rst_a));
  LUT5 #(
    .INIT(32'h0020F020)) 
    end_brst_rd_i_1
       (.I0(brst_cnt_max),
        .I1(brst_cnt_max_d1),
        .I2(s_axi_aresetn),
        .I3(end_brst_rd),
        .I4(end_brst_rd_clr),
        .O(end_brst_rd_i_1_n_0));
  FDRE #(
    .INIT(1'b0)) 
    end_brst_rd_reg
       (.C(s_axi_aclk),
        .CE(1'b1),
        .D(end_brst_rd_i_1_n_0),
        .Q(end_brst_rd),
        .R(1'b0));
  (* SOFT_HLUTNM = "soft_lutpair9" *) 
  LUT5 #(
    .INIT(32'hFFFF4001)) 
    last_bram_addr_i_1
       (.I0(last_bram_addr_i_2_n_0),
        .I1(rd_data_sm_cs[2]),
        .I2(rd_data_sm_cs[0]),
        .I3(rd_data_sm_cs[1]),
        .I4(last_bram_addr_i_3_n_0),
        .O(last_bram_addr0));
  LUT6 #(
    .INIT(64'hEE0EEEEEEEEEEEEE)) 
    last_bram_addr_i_2
       (.I0(last_bram_addr_i_4_n_0),
        .I1(ar_active_reg_1),
        .I2(rd_data_sm_cs[3]),
        .I3(rd_data_sm_cs[2]),
        .I4(rd_adv_buf24_out),
        .I5(p_0_in4_in),
        .O(last_bram_addr_i_2_n_0));
  LUT4 #(
    .INIT(16'h0040)) 
    last_bram_addr_i_3
       (.I0(last_bram_addr_i_5_n_0),
        .I1(I_WRAP_BRST_n_13),
        .I2(brst_cnt[0]),
        .I3(brst_cnt[1]),
        .O(last_bram_addr_i_3_n_0));
  LUT6 #(
    .INIT(64'hFF13FF33FFF3FFF3)) 
    last_bram_addr_i_4
       (.I0(p_0_in4_in),
        .I1(ar_active_re),
        .I2(rd_data_sm_cs[2]),
        .I3(rd_data_sm_cs[3]),
        .I4(pend_rd_op),
        .I5(rd_adv_buf24_out),
        .O(last_bram_addr_i_4_n_0));
  LUT6 #(
    .INIT(64'hFFFFFFFFFFFFFFFE)) 
    last_bram_addr_i_5
       (.I0(brst_cnt[7]),
        .I1(brst_cnt[3]),
        .I2(brst_cnt[4]),
        .I3(brst_cnt[2]),
        .I4(brst_cnt[5]),
        .I5(brst_cnt[6]),
        .O(last_bram_addr_i_5_n_0));
  FDRE #(
    .INIT(1'b0)) 
    last_bram_addr_reg
       (.C(s_axi_aclk),
        .CE(1'b1),
        .D(last_bram_addr0),
        .Q(last_bram_addr),
        .R(bram_rst_a));
  LUT6 #(
    .INIT(64'h4440FFFF44400000)) 
    pend_rd_op_i_1
       (.I0(rd_data_sm_cs[1]),
        .I1(ar_active_re),
        .I2(p_0_in4_in),
        .I3(rd_data_sm_cs[2]),
        .I4(pend_rd_op_i_2_n_0),
        .I5(pend_rd_op),
        .O(pend_rd_op_i_1_n_0));
  LUT6 #(
    .INIT(64'hFFFFFFFF000000F8)) 
    pend_rd_op_i_2
       (.I0(ar_active_re),
        .I1(p_0_in4_in),
        .I2(pend_rd_op),
        .I3(\rd_data_sm_cs[0]_i_3_n_0 ),
        .I4(\rd_data_sm_cs[2]_i_2_n_0 ),
        .I5(pend_rd_op_i_3_n_0),
        .O(pend_rd_op_i_2_n_0));
  LUT6 #(
    .INIT(64'h3002000200020002)) 
    pend_rd_op_i_3
       (.I0(pend_rd_op_i_4_n_0),
        .I1(\rd_data_sm_cs[3]_i_7_n_0 ),
        .I2(rd_data_sm_cs[1]),
        .I3(rd_data_sm_cs[0]),
        .I4(rd_adv_buf24_out),
        .I5(pend_rd_op),
        .O(pend_rd_op_i_3_n_0));
  (* SOFT_HLUTNM = "soft_lutpair16" *) 
  LUT4 #(
    .INIT(16'hF444)) 
    pend_rd_op_i_4
       (.I0(ar_active_d1),
        .I1(p_0_out),
        .I2(pend_rd_op),
        .I3(s_axi_rlast),
        .O(pend_rd_op_i_4_n_0));
  FDRE #(
    .INIT(1'b0)) 
    pend_rd_op_reg
       (.C(s_axi_aclk),
        .CE(1'b1),
        .D(pend_rd_op_i_1_n_0),
        .Q(pend_rd_op),
        .R(bram_rst_a));
  LUT6 #(
    .INIT(64'hFFFFFFFF54545554)) 
    \rd_data_sm_cs[0]_i_1 
       (.I0(\rd_data_sm_cs[0]_i_2_n_0 ),
        .I1(\GEN_RDATA_NO_ECC.GEN_RDATA[31].axi_rdata_int[31]_i_3_n_0 ),
        .I2(\rd_data_sm_cs[0]_i_3_n_0 ),
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
