RaviTharaka/riscv_fpga/RISCV_Demo/RISCV_Demo.srcs/sources_1/bd/Integrated/ip/Integrated_axi_bram_ctrl_1_0/Integrated_axi_bram_ctrl_1_0_sim_netlist.v

// Copyright 1986-2016 Xilinx, Inc. All Rights Reserved.
// --------------------------------------------------------------------------------
// Tool Version: Vivado v.2016.3 (win64) Build 1682563 Mon Oct 10 19:07:27 MDT 2016
// Date        : Fri Apr 28 08:29:38 2017
// Host        : ASUS-PC running 64-bit major release  (build 9200)
// Command     : write_verilog -force -mode funcsim
//               E:/University/GrandFinale/Project/riscv_fpga/RISCV_Demo/RISCV_Demo.srcs/sources_1/bd/Integrated/ip/Integrated_axi_bram_ctrl_1_0/Integrated_axi_bram_ctrl_1_0_sim_netlist.v
// Design      : Integrated_axi_bram_ctrl_1_0
// Purpose     : This verilog netlist is a functional simulation representation of the design and should not be modified
//               or synthesized. This netlist cannot be used for SDF annotated simulation.
// Device      : xc7z020clg484-1
// --------------------------------------------------------------------------------
`timescale 1 ps / 1 ps

(* CHECK_LICENSE_TYPE = "Integrated_axi_bram_ctrl_1_0,axi_bram_ctrl,{}" *) (* downgradeipidentifiedwarnings = "yes" *) (* x_core_info = "axi_bram_ctrl,Vivado 2016.3" *) 
(* NotValidForBitStream *)
module Integrated_axi_bram_ctrl_1_0
   (s_axi_aclk,
    s_axi_aresetn,
    s_axi_awid,
    s_axi_awaddr,
    s_axi_awlen,
    s_axi_awsize,
    s_axi_awburst,
    s_axi_awlock,
    s_axi_awcache,
    s_axi_awprot,
    s_axi_awvalid,
    s_axi_awready,
    s_axi_wdata,
    s_axi_wstrb,
    s_axi_wlast,
    s_axi_wvalid,
    s_axi_wready,
    s_axi_bid,
    s_axi_bresp,
    s_axi_bvalid,
    s_axi_bready,
    s_axi_arid,
    s_axi_araddr,
    s_axi_arlen,
    s_axi_arsize,
    s_axi_arburst,
    s_axi_arlock,
    s_axi_arcache,
    s_axi_arprot,
    s_axi_arvalid,
    s_axi_arready,
    s_axi_rid,
    s_axi_rdata,
    s_axi_rresp,
    s_axi_rlast,
    s_axi_rvalid,
    s_axi_rready,
    bram_rst_a,
    bram_clk_a,
    bram_en_a,
    bram_we_a,
    bram_addr_a,
    bram_wrdata_a,
    bram_rddata_a);
  (* x_interface_info = "xilinx.com:signal:clock:1.0 CLKIF CLK" *) input s_axi_aclk;
  (* x_interface_info = "xilinx.com:signal:reset:1.0 RSTIF RST" *) input s_axi_aresetn;
  (* x_interface_info = "xilinx.com:interface:aximm:1.0 S_AXI AWID" *) input [1:0]s_axi_awid;
  (* x_interface_info = "xilinx.com:interface:aximm:1.0 S_AXI AWADDR" *) input [12:0]s_axi_awaddr;
  (* x_interface_info = "xilinx.com:interface:aximm:1.0 S_AXI AWLEN" *) input [7:0]s_axi_awlen;
  (* x_interface_info = "xilinx.com:interface:aximm:1.0 S_AXI AWSIZE" *) input [2:0]s_axi_awsize;
  (* x_interface_info = "xilinx.com:interface:aximm:1.0 S_AXI AWBURST" *) input [1:0]s_axi_awburst;
  (* x_interface_info = "xilinx.com:interface:aximm:1.0 S_AXI AWLOCK" *) input s_axi_awlock;
  (* x_interface_info = "xilinx.com:interface:aximm:1.0 S_AXI AWCACHE" *) input [3:0]s_axi_awcache;
  (* x_interface_info = "xilinx.com:interface:aximm:1.0 S_AXI AWPROT" *) input [2:0]s_axi_awprot;
  (* x_interface_info = "xilinx.com:interface:aximm:1.0 S_AXI AWVALID" *) input s_axi_awvalid;
  (* x_interface_info = "xilinx.com:interface:aximm:1.0 S_AXI AWREADY" *) output s_axi_awready;
  (* x_interface_info = "xilinx.com:interface:aximm:1.0 S_AXI WDATA" *) input [127:0]s_axi_wdata;
  (* x_interface_info = "xilinx.com:interface:aximm:1.0 S_AXI WSTRB" *) input [15:0]s_axi_wstrb;
  (* x_interface_info = "xilinx.com:interface:aximm:1.0 S_AXI WLAST" *) input s_axi_wlast;
  (* x_interface_info = "xilinx.com:interface:aximm:1.0 S_AXI WVALID" *) input s_axi_wvalid;
  (* x_interface_info = "xilinx.com:interface:aximm:1.0 S_AXI WREADY" *) output s_axi_wready;
  (* x_interface_info = "xilinx.com:interface:aximm:1.0 S_AXI BID" *) output [1:0]s_axi_bid;
  (* x_interface_info = "xilinx.com:interface:aximm:1.0 S_AXI BRESP" *) output [1:0]s_axi_bresp;
  (* x_interface_info = "xilinx.com:interface:aximm:1.0 S_AXI BVALID" *) output s_axi_bvalid;
  (* x_interface_info = "xilinx.com:interface:aximm:1.0 S_AXI BREADY" *) input s_axi_bready;
  (* x_interface_info = "xilinx.com:interface:aximm:1.0 S_AXI ARID" *) input [1:0]s_axi_arid;
  (* x_interface_info = "xilinx.com:interface:aximm:1.0 S_AXI ARADDR" *) input [12:0]s_axi_araddr;
  (* x_interface_info = "xilinx.com:interface:aximm:1.0 S_AXI ARLEN" *) input [7:0]s_axi_arlen;
  (* x_interface_info = "xilinx.com:interface:aximm:1.0 S_AXI ARSIZE" *) input [2:0]s_axi_arsize;
  (* x_interface_info = "xilinx.com:interface:aximm:1.0 S_AXI ARBURST" *) input [1:0]s_axi_arburst;
  (* x_interface_info = "xilinx.com:interface:aximm:1.0 S_AXI ARLOCK" *) input s_axi_arlock;
  (* x_interface_info = "xilinx.com:interface:aximm:1.0 S_AXI ARCACHE" *) input [3:0]s_axi_arcache;
  (* x_interface_info = "xilinx.com:interface:aximm:1.0 S_AXI ARPROT" *) input [2:0]s_axi_arprot;
  (* x_interface_info = "xilinx.com:interface:aximm:1.0 S_AXI ARVALID" *) input s_axi_arvalid;
  (* x_interface_info = "xilinx.com:interface:aximm:1.0 S_AXI ARREADY" *) output s_axi_arready;
  (* x_interface_info = "xilinx.com:interface:aximm:1.0 S_AXI RID" *) output [1:0]s_axi_rid;
  (* x_interface_info = "xilinx.com:interface:aximm:1.0 S_AXI RDATA" *) output [127:0]s_axi_rdata;
  (* x_interface_info = "xilinx.com:interface:aximm:1.0 S_AXI RRESP" *) output [1:0]s_axi_rresp;
  (* x_interface_info = "xilinx.com:interface:aximm:1.0 S_AXI RLAST" *) output s_axi_rlast;
  (* x_interface_info = "xilinx.com:interface:aximm:1.0 S_AXI RVALID" *) output s_axi_rvalid;
  (* x_interface_info = "xilinx.com:interface:aximm:1.0 S_AXI RREADY" *) input s_axi_rready;
  (* x_interface_info = "xilinx.com:interface:bram:1.0 BRAM_PORTA RST" *) output bram_rst_a;
  (* x_interface_info = "xilinx.com:interface:bram:1.0 BRAM_PORTA CLK" *) output bram_clk_a;
  (* x_interface_info = "xilinx.com:interface:bram:1.0 BRAM_PORTA EN" *) output bram_en_a;
  (* x_interface_info = "xilinx.com:interface:bram:1.0 BRAM_PORTA WE" *) output [15:0]bram_we_a;
  (* x_interface_info = "xilinx.com:interface:bram:1.0 BRAM_PORTA ADDR" *) output [12:0]bram_addr_a;
  (* x_interface_info = "xilinx.com:interface:bram:1.0 BRAM_PORTA DIN" *) output [127:0]bram_wrdata_a;
  (* x_interface_info = "xilinx.com:interface:bram:1.0 BRAM_PORTA DOUT" *) input [127:0]bram_rddata_a;

  wire \<const0> ;
  wire [12:4]\^bram_addr_a ;
  wire bram_en_a;
  wire [127:0]bram_rddata_a;
  wire bram_rst_a;
  wire [15:0]bram_we_a;
  wire [127:0]bram_wrdata_a;
  wire [7:1]\gext_inst.abcv4_0_ext_inst/GEN_AXI4.I_FULL_AXI/I_RD_CHNL/GEN_UA_NARROW.I_UA_NARROW/size_plus_lsb0 ;
  wire [7:1]\gext_inst.abcv4_0_ext_inst/GEN_AXI4.I_FULL_AXI/I_WR_CHNL/GEN_UA_NARROW.I_UA_NARROW/size_plus_lsb0 ;
  wire s_axi_aclk;
  wire [12:0]s_axi_araddr;
  wire [1:0]s_axi_arburst;
  wire s_axi_aresetn;
  wire [1:0]s_axi_arid;
  wire [7:0]s_axi_arlen;
  wire s_axi_arready;
  wire [2:0]s_axi_arsize;
  wire s_axi_arvalid;
  wire [12:0]s_axi_awaddr;
  wire [1:0]s_axi_awburst;
  wire [1:0]s_axi_awid;
  wire [7:0]s_axi_awlen;
  wire s_axi_awready;
  wire [2:0]s_axi_awsize;
  wire s_axi_awvalid;
  wire [1:0]s_axi_bid;
  wire s_axi_bready;
  wire s_axi_bvalid;
  wire [127:0]s_axi_rdata;
  wire [1:0]s_axi_rid;
  wire s_axi_rlast;
  wire s_axi_rready;
  wire s_axi_rvalid;
  wire [127:0]s_axi_wdata;
  wire s_axi_wlast;
  wire s_axi_wready;
  wire [15:0]s_axi_wstrb;
  wire s_axi_wvalid;
  wire ua_narrow_load1_carry_i_26__0_n_0;
  wire ua_narrow_load1_carry_i_27__0_n_0;
  wire ua_narrow_load1_carry_i_28__0_n_0;
  wire ua_narrow_load1_carry_i_28_n_0;
  wire ua_narrow_load1_carry_i_29__0_n_0;
  wire ua_narrow_load1_carry_i_29_n_0;
  wire ua_narrow_load1_carry_i_31__0_n_0;
  wire ua_narrow_load1_carry_i_31_n_0;
  wire ua_narrow_load1_carry_i_32__0_n_0;
  wire ua_narrow_load1_carry_i_32_n_0;

  assign bram_addr_a[12:4] = \^bram_addr_a [12:4];
  assign bram_addr_a[3] = \<const0> ;
  assign bram_addr_a[2] = \<const0> ;
  assign bram_addr_a[1] = \<const0> ;
  assign bram_addr_a[0] = \<const0> ;
  assign bram_clk_a = s_axi_aclk;
  assign s_axi_bresp[1] = \<const0> ;
  assign s_axi_bresp[0] = \<const0> ;
  assign s_axi_rresp[1] = \<const0> ;
  assign s_axi_rresp[0] = \<const0> ;
  GND GND
       (.G(\<const0> ));
  Integrated_axi_bram_ctrl_1_0_axi_bram_ctrl U0
       (.DI({ua_narrow_load1_carry_i_29__0_n_0,\gext_inst.abcv4_0_ext_inst/GEN_AXI4.I_FULL_AXI/I_RD_CHNL/GEN_UA_NARROW.I_UA_NARROW/size_plus_lsb0 [1],ua_narrow_load1_carry_i_31__0_n_0}),
        .Q(\^bram_addr_a [11:4]),
        .S({\gext_inst.abcv4_0_ext_inst/GEN_AXI4.I_FULL_AXI/I_RD_CHNL/GEN_UA_NARROW.I_UA_NARROW/size_plus_lsb0 [7:6],ua_narrow_load1_carry_i_27__0_n_0,ua_narrow_load1_carry_i_28_n_0}),
        .bram_addr_a(\^bram_addr_a [12]),
        .bram_en_a(bram_en_a),
        .bram_rddata_a(bram_rddata_a),
        .bram_rst_a(bram_rst_a),
        .bram_we_a(bram_we_a),
        .bram_wrdata_a(bram_wrdata_a),
        .s_axi_aclk(s_axi_aclk),
        .s_axi_araddr(s_axi_araddr),
        .\s_axi_araddr[3] (ua_narrow_load1_carry_i_32__0_n_0),
        .s_axi_arburst(s_axi_arburst),
        .s_axi_aresetn(s_axi_aresetn),
        .s_axi_arid(s_axi_arid),
        .s_axi_arlen(s_axi_arlen),
        .s_axi_arready(s_axi_arready),
        .s_axi_arsize(s_axi_arsize),
        .s_axi_arvalid(s_axi_arvalid),
        .s_axi_awaddr(s_axi_awaddr),
        .\s_axi_awaddr[3] (ua_narrow_load1_carry_i_32_n_0),
        .s_axi_awburst(s_axi_awburst),
        .s_axi_awid(s_axi_awid),
        .s_axi_awlen(s_axi_awlen),
        .s_axi_awready(s_axi_awready),
        .s_axi_awsize(s_axi_awsize),
        .\s_axi_awsize[2] ({ua_narrow_load1_carry_i_29_n_0,\gext_inst.abcv4_0_ext_inst/GEN_AXI4.I_FULL_AXI/I_WR_CHNL/GEN_UA_NARROW.I_UA_NARROW/size_plus_lsb0 [1],ua_narrow_load1_carry_i_31_n_0}),
        .\s_axi_awsize[2]_0 ({\gext_inst.abcv4_0_ext_inst/GEN_AXI4.I_FULL_AXI/I_WR_CHNL/GEN_UA_NARROW.I_UA_NARROW/size_plus_lsb0 [7],ua_narrow_load1_carry_i_26__0_n_0,\gext_inst.abcv4_0_ext_inst/GEN_AXI4.I_FULL_AXI/I_WR_CHNL/GEN_UA_NARROW.I_UA_NARROW/size_plus_lsb0 [5],ua_narrow_load1_carry_i_28__0_n_0}),
        .s_axi_awvalid(s_axi_awvalid),
        .s_axi_bid(s_axi_bid),
        .s_axi_bready(s_axi_bready),
        .s_axi_bvalid(s_axi_bvalid),
        .s_axi_rdata(s_axi_rdata),
        .s_axi_rid(s_axi_rid),
        .s_axi_rlast(s_axi_rlast),
        .s_axi_rready(s_axi_rready),
        .s_axi_rvalid(s_axi_rvalid),
        .s_axi_wdata(s_axi_wdata),
        .s_axi_wlast(s_axi_wlast),
        .s_axi_wready(s_axi_wready),
        .s_axi_wstrb(s_axi_wstrb),
        .s_axi_wvalid(s_axi_wvalid));
  LUT3 #(
    .INIT(8'h80)) 
    ua_narrow_load1_carry_i_25
       (.I0(s_axi_arsize[0]),
        .I1(s_axi_arsize[1]),
        .I2(s_axi_arsize[2]),
        .O(\gext_inst.abcv4_0_ext_inst/GEN_AXI4.I_FULL_AXI/I_RD_CHNL/GEN_UA_NARROW.I_UA_NARROW/size_plus_lsb0 [7]));
  LUT3 #(
    .INIT(8'h80)) 
    ua_narrow_load1_carry_i_25__0
       (.I0(s_axi_awsize[0]),
        .I1(s_axi_awsize[1]),
        .I2(s_axi_awsize[2]),
        .O(\gext_inst.abcv4_0_ext_inst/GEN_AXI4.I_FULL_AXI/I_WR_CHNL/GEN_UA_NARROW.I_UA_NARROW/size_plus_lsb0 [7]));
  LUT3 #(
    .INIT(8'h08)) 
    ua_narrow_load1_carry_i_26
       (.I0(s_axi_arsize[2]),
        .I1(s_axi_arsize[1]),
        .I2(s_axi_arsize[0]),
        .O(\gext_inst.abcv4_0_ext_inst/GEN_AXI4.I_FULL_AXI/I_RD_CHNL/GEN_UA_NARROW.I_UA_NARROW/size_plus_lsb0 [6]));
  LUT3 #(
    .INIT(8'h40)) 
    ua_narrow_load1_carry_i_26__0
       (.I0(s_axi_awsize[0]),
        .I1(s_axi_awsize[1]),
        .I2(s_axi_awsize[2]),
        .O(ua_narrow_load1_carry_i_26__0_n_0));
  LUT3 #(
    .INIT(8'h08)) 
    ua_narrow_load1_carry_i_27
       (.I0(s_axi_awsize[0]),
        .I1(s_axi_awsize[2]),
        .I2(s_axi_awsize[1]),
        .O(\gext_inst.abcv4_0_ext_inst/GEN_AXI4.I_FULL_AXI/I_WR_CHNL/GEN_UA_NARROW.I_UA_NARROW/size_plus_lsb0 [5]));
  LUT3 #(
    .INIT(8'h40)) 
    ua_narrow_load1_carry_i_27__0
       (.I0(s_axi_arsize[1]),
        .I1(s_axi_arsize[2]),
        .I2(s_axi_arsize[0]),
        .O(ua_narrow_load1_carry_i_27__0_n_0));
  LUT3 #(
    .INIT(8'h04)) 
    ua_narrow_load1_carry_i_28
       (.I0(s_axi_arsize[1]),
        .I1(s_axi_arsize[2]),
        .I2(s_axi_arsize[0]),
        .O(ua_narrow_load1_carry_i_28_n_0));
  LUT3 #(
    .INIT(8'h04)) 
    ua_narrow_load1_carry_i_28__0
       (.I0(s_axi_awsize[0]),
        .I1(s_axi_awsize[2]),
        .I2(s_axi_awsize[1]),
        .O(ua_narrow_load1_carry_i_28__0_n_0));
  LUT3 #(
    .INIT(8'h04)) 
    ua_narrow_load1_carry_i_29
       (.I0(s_axi_awsize[0]),
        .I1(s_axi_awsize[1]),
        .I2(s_axi_awsize[2]),
        .O(ua_narrow_load1_carry_i_29_n_0));
  LUT3 #(
    .INIT(8'h04)) 
    ua_narrow_load1_carry_i_29__0
       (.I0(s_axi_arsize[0]),
        .I1(s_axi_arsize[1]),
        .I2(s_axi_arsize[2]),
        .O(ua_narrow_load1_carry_i_29__0_n_0));
  LUT3 #(
    .INIT(8'h02)) 
    ua_narrow_load1_carry_i_30
       (.I0(s_axi_awsize[0]),
        .I1(s_axi_awsize[1]),
        .I2(s_axi_awsize[2]),
        .O(\gext_inst.abcv4_0_ext_inst/GEN_AXI4.I_FULL_AXI/I_WR_CHNL/GEN_UA_NARROW.I_UA_NARROW/size_plus_lsb0 [1]));
  LUT3 #(
    .INIT(8'h02)) 
    ua_narrow_load1_carry_i_30__0
       (.I0(s_axi_arsize[0]),
        .I1(s_axi_arsize[1]),
        .I2(s_axi_arsize[2]),
        .O(\gext_inst.abcv4_0_ext_inst/GEN_AXI4.I_FULL_AXI/I_RD_CHNL/GEN_UA_NARROW.I_UA_NARROW/size_plus_lsb0 [1]));
  LUT3 #(
    .INIT(8'h01)) 
    ua_narrow_load1_carry_i_31
       (.I0(s_axi_awsize[0]),
        .I1(s_axi_awsize[1]),
        .I2(s_axi_awsize[2]),
        .O(ua_narrow_load1_carry_i_31_n_0));
  LUT3 #(
    .INIT(8'h01)) 
    ua_narrow_load1_carry_i_31__0
       (.I0(s_axi_arsize[0]),
        .I1(s_axi_arsize[1]),
        .I2(s_axi_arsize[2]),
        .O(ua_narrow_load1_carry_i_31__0_n_0));
  LUT4 #(
    .INIT(16'hDF20)) 
    ua_narrow_load1_carry_i_32
       (.I0(s_axi_awsize[0]),
        .I1(s_axi_awsize[2]),
        .I2(s_axi_awsize[1]),
        .I3(s_axi_awaddr[3]),
        .O(ua_narrow_load1_carry_i_32_n_0));
  LUT4 #(
    .INIT(16'hDF20)) 
    ua_narrow_load1_carry_i_32__0
       (.I0(s_axi_arsize[0]),
        .I1(s_axi_arsize[2]),
        .I2(s_axi_arsize[1]),
        .I3(s_axi_araddr[3]),
        .O(ua_narrow_load1_carry_i_32__0_n_0));
endmodule

(* ORIG_REF_NAME = "SRL_FIFO" *) 
module Integrated_axi_bram_ctrl_1_0_SRL_FIFO
   (bid_gets_fifo_load_d1_reg,
    bid_gets_fifo_load,
    \axi_bid_int_reg[1] ,
    \axi_bid_int_reg[0] ,
    s_axi_aresetn,
    s_axi_aclk,
    s_axi_awid,
    p_1_out,
    aw_active_d1_reg,
    aw_active_re,
    bid_gets_fifo_load_d1,
    axi_bvalid_int_reg,
    s_axi_bready,
    \GEN_WDATA_SM_NO_ECC_SNG_REG_WREADY.wr_data_sng_sm_cs_reg[0] ,
    s_axi_wlast,
    \GEN_WDATA_SM_NO_ECC_SNG_REG_WREADY.wr_data_sng_sm_cs_reg[1] ,
    s_axi_wvalid,
    axi_wr_burst,
    axi_wdata_full_reg,
    AW2Arb_BVALID_Cnt,
    s_axi_bid);
  output bid_gets_fifo_load_d1_reg;
  output bid_gets_fifo_load;
  output \axi_bid_int_reg[1] ;
  output \axi_bid_int_reg[0] ;
  input s_axi_aresetn;
  input s_axi_aclk;
  input [1:0]s_axi_awid;
  input p_1_out;
  input aw_active_d1_reg;
  input aw_active_re;
  input bid_gets_fifo_load_d1;
  input axi_bvalid_int_reg;
  input s_axi_bready;
  input \GEN_WDATA_SM_NO_ECC_SNG_REG_WREADY.wr_data_sng_sm_cs_reg[0] ;
  input s_axi_wlast;
  input \GEN_WDATA_SM_NO_ECC_SNG_REG_WREADY.wr_data_sng_sm_cs_reg[1] ;
  input s_axi_wvalid;
  input axi_wr_burst;
  input axi_wdata_full_reg;
  input [2:0]AW2Arb_BVALID_Cnt;
  input [1:0]s_axi_bid;

  wire [2:0]AW2Arb_BVALID_Cnt;
  wire \Addr_Counters[0].FDRE_I_n_0 ;
  wire \Addr_Counters[1].FDRE_I_n_0 ;
  wire \Addr_Counters[2].FDRE_I_n_0 ;
  wire \Addr_Counters[3].FDRE_I_n_0 ;
  wire \Addr_Counters[3].XORCY_I_i_1_n_0 ;
  wire CI;
  wire D;
  wire Data_Exists_DFF_i_2_n_0;
  wire Data_Exists_DFF_i_3_n_0;
  wire \GEN_WDATA_SM_NO_ECC_SNG_REG_WREADY.wr_data_sng_sm_cs_reg[0] ;
  wire \GEN_WDATA_SM_NO_ECC_SNG_REG_WREADY.wr_data_sng_sm_cs_reg[1] ;
  wire S;
  wire S0_out;
  wire S1_out;
  wire addr_cy_1;
  wire addr_cy_2;
  wire addr_cy_3;
  wire aw_active_d1_reg;
  wire aw_active_re;
  wire \axi_bid_int[1]_i_2_n_0 ;
  wire \axi_bid_int[1]_i_3_n_0 ;
  wire \axi_bid_int_reg[0] ;
  wire \axi_bid_int_reg[1] ;
  wire axi_bvalid_int_i_4_n_0;
  wire axi_bvalid_int_i_5_n_0;
  wire axi_bvalid_int_reg;
  wire axi_wdata_full_reg;
  wire axi_wr_burst;
  wire bid_fifo_not_empty;
  wire [1:0]bid_fifo_rd;
  wire bid_gets_fifo_load;
  wire bid_gets_fifo_load_d1;
  wire bid_gets_fifo_load_d1_i_2_n_0;
  wire bid_gets_fifo_load_d1_reg;
  wire p_1_out;
  wire s_axi_aclk;
  wire s_axi_aresetn;
  wire [1:0]s_axi_awid;
  wire [1:0]s_axi_bid;
  wire s_axi_bready;
  wire s_axi_wlast;
  wire s_axi_wvalid;
  wire sum_A_0;
  wire sum_A_1;
  wire sum_A_2;
  wire sum_A_3;
  wire [3:3]\NLW_Addr_Counters[0].MUXCY_L_I_CARRY4_CO_UNCONNECTED ;
  wire [3:3]\NLW_Addr_Counters[0].MUXCY_L_I_CARRY4_DI_UNCONNECTED ;

  (* BOX_TYPE = "PRIMITIVE" *) 
  FDRE #(
    .INIT(1'b0),
    .IS_C_INVERTED(1'b0),
    .IS_D_INVERTED(1'b0),
    .IS_R_INVERTED(1'b0)) 
    \Addr_Counters[0].FDRE_I 
       (.C(s_axi_aclk),
        .CE(bid_fifo_not_empty),
        .D(sum_A_3),
        .Q(\Addr_Counters[0].FDRE_I_n_0 ),
        .R(s_axi_aresetn));
  (* BOX_TYPE = "PRIMITIVE" *) 
  (* XILINX_LEGACY_PRIM = "(MUXCY,XORCY)" *) 
  (* XILINX_TRANSFORM_PINMAP = "LO:O" *) 
  CARRY4 \Addr_Counters[0].MUXCY_L_I_CARRY4 
       (.CI(1'b0),
        .CO({\NLW_Addr_Counters[0].MUXCY_L_I_CARRY4_CO_UNCONNECTED [3],addr_cy_1,addr_cy_2,addr_cy_3}),
        .CYINIT(CI),
        .DI({\NLW_Addr_Counters[0].MUXCY_L_I_CARRY4_DI_UNCONNECTED [3],\Addr_Counters[2].FDRE_I_n_0 ,\Addr_Counters[1].FDRE_I_n_0 ,\Addr_Counters[0].FDRE_I_n_0 }),
        .O({sum_A_0,sum_A_1,sum_A_2,sum_A_3}),
        .S({\Addr_Counters[3].XORCY_I_i_1_n_0 ,S0_out,S1_out,S}));
  LUT6 #(
    .INIT(64'h0000FFFFFFFE0000)) 
    \Addr_Counters[0].MUXCY_L_I_i_1 
       (.I0(\Addr_Counters[1].FDRE_I_n_0 ),
        .I1(\Addr_Counters[3].FDRE_I_n_0 ),
        .I2(\Addr_Counters[2].FDRE_I_n_0 ),
        .I3(aw_active_re),
        .I4(\axi_bid_int[1]_i_2_n_0 ),
        .I5(\Addr_Counters[0].FDRE_I_n_0 ),
        .O(S));
  LUT6 #(
    .INIT(64'h8AAAAAAAAAAAAAAA)) 
    \Addr_Counters[0].MUXCY_L_I_i_2 
       (.I0(aw_active_re),
        .I1(\axi_bid_int[1]_i_2_n_0 ),
        .I2(\Addr_Counters[2].FDRE_I_n_0 ),
        .I3(\Addr_Counters[3].FDRE_I_n_0 ),
        .I4(\Addr_Counters[1].FDRE_I_n_0 ),
        .I5(\Addr_Counters[0].FDRE_I_n_0 ),
        .O(CI));
  (* BOX_TYPE = "PRIMITIVE" *) 
  FDRE #(
    .INIT(1'b0),
    .IS_C_INVERTED(1'b0),
    .IS_D_INVERTED(1'b0),
    .IS_R_INVERTED(1'b0)) 
    \Addr_Counters[1].FDRE_I 
       (.C(s_axi_aclk),
        .CE(bid_fifo_not_empty),
        .D(sum_A_2),
        .Q(\Addr_Counters[1].FDRE_I_n_0 ),
        .R(s_axi_aresetn));
  LUT6 #(
    .INIT(64'h0000FFFFFFFE0000)) 
    \Addr_Counters[1].MUXCY_L_I_i_1 
       (.I0(\Addr_Counters[3].FDRE_I_n_0 ),
        .I1(\Addr_Counters[0].FDRE_I_n_0 ),
        .I2(\Addr_Counters[2].FDRE_I_n_0 ),
        .I3(aw_active_re),
        .I4(\axi_bid_int[1]_i_2_n_0 ),
        .I5(\Addr_Counters[1].FDRE_I_n_0 ),
        .O(S1_out));
  (* BOX_TYPE = "PRIMITIVE" *) 
  FDRE #(
    .INIT(1'b0),
    .IS_C_INVERTED(1'b0),
    .IS_D_INVERTED(1'b0),
    .IS_R_INVERTED(1'b0)) 
    \Addr_Counters[2].FDRE_I 
       (.C(s_axi_aclk),
        .CE(bid_fifo_not_empty),
        .D(sum_A_1),
        .Q(\Addr_Counters[2].FDRE_I_n_0 ),
        .R(s_axi_aresetn));
  LUT6 #(
    .INIT(64'h0000FFFFFFFE0000)) 
    \Addr_Counters[2].MUXCY_L_I_i_1 
       (.I0(\Addr_Counters[1].FDRE_I_n_0 ),
        .I1(\Addr_Counters[3].FDRE_I_n_0 ),
        .I2(\Addr_Counters[0].FDRE_I_n_0 ),
        .I3(aw_active_re),
        .I4(\axi_bid_int[1]_i_2_n_0 ),
        .I5(\Addr_Counters[2].FDRE_I_n_0 ),
        .O(S0_out));
  (* BOX_TYPE = "PRIMITIVE" *) 
  FDRE #(
    .INIT(1'b0),
    .IS_C_INVERTED(1'b0),
    .IS_D_INVERTED(1'b0),
    .IS_R_INVERTED(1'b0)) 
    \Addr_Counters[3].FDRE_I 
       (.C(s_axi_aclk),
        .CE(bid_fifo_not_empty),
        .D(sum_A_0),
        .Q(\Addr_Counters[3].FDRE_I_n_0 ),
        .R(s_axi_aresetn));
  LUT6 #(
    .INIT(64'h0000FFFFFFFE0000)) 
    \Addr_Counters[3].XORCY_I_i_1 
       (.I0(\Addr_Counters[1].FDRE_I_n_0 ),
        .I1(\Addr_Counters[0].FDRE_I_n_0 ),
        .I2(\Addr_Counters[2].FDRE_I_n_0 ),
        .I3(aw_active_re),
        .I4(\axi_bid_int[1]_i_2_n_0 ),
        .I5(\Addr_Counters[3].FDRE_I_n_0 ),
        .O(\Addr_Counters[3].XORCY_I_i_1_n_0 ));
  (* BOX_TYPE = "PRIMITIVE" *) 
  (* XILINX_LEGACY_PRIM = "FDR" *) 
  FDRE #(
    .INIT(1'b0)) 
    Data_Exists_DFF
       (.C(s_axi_aclk),
        .CE(1'b1),
        .D(D),
        .Q(bid_fifo_not_empty),
        .R(s_axi_aresetn));
  LUT5 #(
    .INIT(32'hFFF20022)) 
    Data_Exists_DFF_i_1
       (.I0(p_1_out),
        .I1(aw_active_d1_reg),
        .I2(Data_Exists_DFF_i_2_n_0),
        .I3(Data_Exists_DFF_i_3_n_0),
        .I4(bid_fifo_not_empty),
        .O(D));
  LUT5 #(
    .INIT(32'h00002EEE)) 
    Data_Exists_DFF_i_2
       (.I0(bid_gets_fifo_load_d1_reg),
        .I1(\axi_bid_int[1]_i_3_n_0 ),
        .I2(s_axi_bready),
        .I3(axi_bvalid_int_reg),
        .I4(bid_gets_fifo_load_d1),
        .O(Data_Exists_DFF_i_2_n_0));
  LUT4 #(
    .INIT(16'hFFFE)) 
    Data_Exists_DFF_i_3
       (.I0(\Addr_Counters[1].FDRE_I_n_0 ),
        .I1(\Addr_Counters[3].FDRE_I_n_0 ),
        .I2(\Addr_Counters[0].FDRE_I_n_0 ),
        .I3(\Addr_Counters[2].FDRE_I_n_0 ),
        .O(Data_Exists_DFF_i_3_n_0));
  (* BOX_TYPE = "PRIMITIVE" *) 
  (* srl_bus_name = "\U0/gext_inst.abcv4_0_ext_inst/GEN_AXI4.I_FULL_AXI/I_WR_CHNL/BID_FIFO/FIFO_RAM " *) 
  (* srl_name = "\U0/gext_inst.abcv4_0_ext_inst/GEN_AXI4.I_FULL_AXI/I_WR_CHNL/BID_FIFO/FIFO_RAM[0].SRL16E_I " *) 
  SRL16E #(
    .INIT(16'h0000),
    .IS_CLK_INVERTED(1'b0)) 
    \FIFO_RAM[0].SRL16E_I 
       (.A0(\Addr_Counters[0].FDRE_I_n_0 ),
        .A1(\Addr_Counters[1].FDRE_I_n_0 ),
        .A2(\Addr_Counters[2].FDRE_I_n_0 ),
        .A3(\Addr_Counters[3].FDRE_I_n_0 ),
        .CE(CI),
        .CLK(s_axi_aclk),
        .D(s_axi_awid[1]),
        .Q(bid_fifo_rd[1]));
  (* BOX_TYPE = "PRIMITIVE" *) 
  (* srl_bus_name = "\U0/gext_inst.abcv4_0_ext_inst/GEN_AXI4.I_FULL_AXI/I_WR_CHNL/BID_FIFO/FIFO_RAM " *) 
  (* srl_name = "\U0/gext_inst.abcv4_0_ext_inst/GEN_AXI4.I_FULL_AXI/I_WR_CHNL/BID_FIFO/FIFO_RAM[1].SRL16E_I " *) 
  SRL16E #(
    .INIT(16'h0000),
    .IS_CLK_INVERTED(1'b0)) 
    \FIFO_RAM[1].SRL16E_I 
       (.A0(\Addr_Counters[0].FDRE_I_n_0 ),
        .A1(\Addr_Counters[1].FDRE_I_n_0 ),
        .A2(\Addr_Counters[2].FDRE_I_n_0 ),
        .A3(\Addr_Counters[3].FDRE_I_n_0 ),
        .CE(CI),
        .CLK(s_axi_aclk),
        .D(s_axi_awid[0]),
        .Q(bid_fifo_rd[0]));
  LUT5 #(
    .INIT(32'hAACFAAC0)) 
    \axi_bid_int[0]_i_1 
       (.I0(s_axi_awid[0]),
        .I1(bid_fifo_rd[0]),
        .I2(\axi_bid_int[1]_i_2_n_0 ),
        .I3(bid_gets_fifo_load),
        .I4(s_axi_bid[0]),
        .O(\axi_bid_int_reg[0] ));
  LUT5 #(
    .INIT(32'hAACFAAC0)) 
    \axi_bid_int[1]_i_1 
       (.I0(s_axi_awid[1]),
        .I1(bid_fifo_rd[1]),
        .I2(\axi_bid_int[1]_i_2_n_0 ),
        .I3(bid_gets_fifo_load),
        .I4(s_axi_bid[1]),
        .O(\axi_bid_int_reg[1] ));
  LUT6 #(
    .INIT(64'hA8888888A888AAAA)) 
    \axi_bid_int[1]_i_2 
       (.I0(bid_fifo_not_empty),
        .I1(bid_gets_fifo_load_d1),
        .I2(axi_bvalid_int_reg),
        .I3(s_axi_bready),
        .I4(\axi_bid_int[1]_i_3_n_0 ),
        .I5(bid_gets_fifo_load_d1_reg),
        .O(\axi_bid_int[1]_i_2_n_0 ));
  LUT3 #(
    .INIT(8'hFE)) 
    \axi_bid_int[1]_i_3 
       (.I0(AW2Arb_BVALID_Cnt[2]),
        .I1(AW2Arb_BVALID_Cnt[1]),
        .I2(AW2Arb_BVALID_Cnt[0]),
        .O(\axi_bid_int[1]_i_3_n_0 ));
  LUT6 #(
    .INIT(64'hBFFFAAAABFFFBFFF)) 
    axi_bvalid_int_i_3
       (.I0(\GEN_WDATA_SM_NO_ECC_SNG_REG_WREADY.wr_data_sng_sm_cs_reg[0] ),
        .I1(s_axi_wlast),
        .I2(\GEN_WDATA_SM_NO_ECC_SNG_REG_WREADY.wr_data_sng_sm_cs_reg[1] ),
        .I3(s_axi_wvalid),
        .I4(axi_bvalid_int_i_4_n_0),
        .I5(axi_bvalid_int_i_5_n_0),
        .O(bid_gets_fifo_load_d1_reg));
  LUT4 #(
    .INIT(16'hFF1F)) 
    axi_bvalid_int_i_4
       (.I0(axi_wdata_full_reg),
        .I1(s_axi_wvalid),
        .I2(p_1_out),
        .I3(\GEN_WDATA_SM_NO_ECC_SNG_REG_WREADY.wr_data_sng_sm_cs_reg[1] ),
        .O(axi_bvalid_int_i_4_n_0));
  LUT3 #(
    .INIT(8'h3A)) 
    axi_bvalid_int_i_5
       (.I0(s_axi_wlast),
        .I1(axi_wr_burst),
        .I2(axi_wdata_full_reg),
        .O(axi_bvalid_int_i_5_n_0));
  LUT4 #(
    .INIT(16'h0004)) 
    bid_gets_fifo_load_d1_i_1
       (.I0(bid_gets_fifo_load_d1_reg),
        .I1(p_1_out),
        .I2(aw_active_d1_reg),
        .I3(bid_gets_fifo_load_d1_i_2_n_0),
        .O(bid_gets_fifo_load));
  LUT6 #(
    .INIT(64'hFFFFFFFFFFBFFF00)) 
    bid_gets_fifo_load_d1_i_2
       (.I0(bid_fifo_not_empty),
        .I1(s_axi_bready),
        .I2(axi_bvalid_int_reg),
        .I3(AW2Arb_BVALID_Cnt[2]),
        .I4(AW2Arb_BVALID_Cnt[0]),
        .I5(AW2Arb_BVALID_Cnt[1]),
        .O(bid_gets_fifo_load_d1_i_2_n_0));
endmodule

(* ORIG_REF_NAME = "axi_bram_ctrl" *) 
module Integrated_axi_bram_ctrl_1_0_axi_bram_ctrl
   (bram_rst_a,
    bram_wrdata_a,
    s_axi_rdata,
    s_axi_awready,
    s_axi_arready,
    s_axi_wready,
    s_axi_bvalid,
    s_axi_rvalid,
    s_axi_rlast,
    Q,
    bram_we_a,
    bram_en_a,
    s_axi_bid,
    s_axi_rid,
    bram_addr_a,
    s_axi_aclk,
    s_axi_awid,
    s_axi_wdata,
    s_axi_wvalid,
    s_axi_araddr,
    s_axi_awaddr,
    s_axi_awsize,
    s_axi_wlast,
    s_axi_bready,
    s_axi_awburst,
    s_axi_awlen,
    s_axi_arlen,
    s_axi_arsize,
    s_axi_arburst,
    S,
    DI,
    s_axi_rready,
    s_axi_aresetn,
    s_axi_arvalid,
    s_axi_awvalid,
    \s_axi_awsize[2] ,
    \s_axi_awaddr[3] ,
    \s_axi_awsize[2]_0 ,
    \s_axi_araddr[3] ,
    s_axi_wstrb,
    s_axi_arid,
    bram_rddata_a);
  output bram_rst_a;
  output [127:0]bram_wrdata_a;
  output [127:0]s_axi_rdata;
  output s_axi_awready;
  output s_axi_arready;
  output s_axi_wready;
  output s_axi_bvalid;
  output s_axi_rvalid;
  output s_axi_rlast;
  output [7:0]Q;
  output [15:0]bram_we_a;
  output bram_en_a;
  output [1:0]s_axi_bid;
  output [1:0]s_axi_rid;
  output [0:0]bram_addr_a;
  input s_axi_aclk;
  input [1:0]s_axi_awid;
  input [127:0]s_axi_wdata;
  input s_axi_wvalid;
  input [12:0]s_axi_araddr;
  input [12:0]s_axi_awaddr;
  input [2:0]s_axi_awsize;
  input s_axi_wlast;
  input s_axi_bready;
  input [1:0]s_axi_awburst;
  input [7:0]s_axi_awlen;
  input [7:0]s_axi_arlen;
  input [2:0]s_axi_arsize;
  input [1:0]s_axi_arburst;
  input [3:0]S;
  input [2:0]DI;
  input s_axi_rready;
  input s_axi_aresetn;
  input s_axi_arvalid;
  input s_axi_awvalid;
  input [2:0]\s_axi_awsize[2] ;
  input [0:0]\s_axi_awaddr[3] ;
  input [3:0]\s_axi_awsize[2]_0 ;
  input [0:0]\s_axi_araddr[3] ;
  input [15:0]s_axi_wstrb;
  input [1:0]s_axi_arid;
  input [127:0]bram_rddata_a;

  wire [2:0]DI;
  wire [7:0]Q;
  wire [3:0]S;
  wire [0:0]bram_addr_a;
  wire bram_en_a;
  wire [127:0]bram_rddata_a;
  wire bram_rst_a;
  wire [15:0]bram_we_a;
  wire [127:0]bram_wrdata_a;
  wire s_axi_aclk;
  wire [12:0]s_axi_araddr;
  wire [0:0]\s_axi_araddr[3] ;
  wire [1:0]s_axi_arburst;
  wire s_axi_aresetn;
  wire [1:0]s_axi_arid;
  wire [7:0]s_axi_arlen;
  wire s_axi_arready;
  wire [2:0]s_axi_arsize;
  wire s_axi_arvalid;
  wire [12:0]s_axi_awaddr;
  wire [0:0]\s_axi_awaddr[3] ;
  wire [1:0]s_axi_awburst;
  wire [1:0]s_axi_awid;
  wire [7:0]s_axi_awlen;
  wire s_axi_awready;
  wire [2:0]s_axi_awsize;
  wire [2:0]\s_axi_awsize[2] ;
  wire [3:0]\s_axi_awsize[2]_0 ;
  wire s_axi_awvalid;
  wire [1:0]s_axi_bid;
  wire s_axi_bready;
  wire s_axi_bvalid;
  wire [127:0]s_axi_rdata;
  wire [1:0]s_axi_rid;
  wire s_axi_rlast;
  wire s_axi_rready;
  wire s_axi_rvalid;
  wire [127:0]s_axi_wdata;
  wire s_axi_wlast;
  wire s_axi_wready;
  wire [15:0]s_axi_wstrb;
  wire s_axi_wvalid;

  Integrated_axi_bram_ctrl_1_0_axi_bram_ctrl_top \gext_inst.abcv4_0_ext_inst 
       (.DI(DI),
        .Q(Q),
        .S(S),
        .bram_addr_a(bram_addr_a),
        .bram_en_a(bram_en_a),
        .bram_rddata_a(bram_rddata_a),
        .bram_rst_a(bram_rst_a),
        .bram_we_a(bram_we_a),
        .bram_wrdata_a(bram_wrdata_a),
        .s_axi_aclk(s_axi_aclk),
        .s_axi_araddr(s_axi_araddr),
        .\s_axi_araddr[3] (\s_axi_araddr[3] ),
        .s_axi_arburst(s_axi_arburst),
        .s_axi_aresetn(s_axi_aresetn),
        .s_axi_arid(s_axi_arid),
        .s_axi_arlen(s_axi_arlen),
        .s_axi_arready(s_axi_arready),
        .s_axi_arsize(s_axi_arsize),
        .s_axi_arvalid(s_axi_arvalid),
        .s_axi_awaddr(s_axi_awaddr),
        .\s_axi_awaddr[3] (\s_axi_awaddr[3] ),
        .s_axi_awburst(s_axi_awburst),
        .s_axi_awid(s_axi_awid),
        .s_axi_awlen(s_axi_awlen),
        .s_axi_awready(s_axi_awready),
        .s_axi_awsize(s_axi_awsize),
        .\s_axi_awsize[2] (\s_axi_awsize[2] ),
        .\s_axi_awsize[2]_0 (\s_axi_awsize[2]_0 ),
        .s_axi_awvalid(s_axi_awvalid),
        .s_axi_bid(s_axi_bid),
        .s_axi_bready(s_axi_bready),
        .s_axi_bvalid(s_axi_bvalid),
        .s_axi_rdata(s_axi_rdata),
        .s_axi_rid(s_axi_rid),
        .s_axi_rlast(s_axi_rlast),
        .s_axi_rready(s_axi_rready),
        .s_axi_rvalid(s_axi_rvalid),
        .s_axi_wdata(s_axi_wdata),
        .s_axi_wlast(s_axi_wlast),
        .s_axi_wready(s_axi_wready),
        .s_axi_wstrb(s_axi_wstrb),
        .s_axi_wvalid(s_axi_wvalid));
endmodule

(* ORIG_REF_NAME = "axi_bram_ctrl_top" *) 
module Integrated_axi_bram_ctrl_1_0_axi_bram_ctrl_top
   (bram_rst_a,
    bram_wrdata_a,
    s_axi_rdata,
    s_axi_awready,
    s_axi_arready,
    s_axi_wready,
    s_axi_bvalid,
    s_axi_rvalid,
    s_axi_rlast,
    Q,
    bram_we_a,
    bram_en_a,
    s_axi_bid,
    s_axi_rid,
    bram_addr_a,
    s_axi_aclk,
    s_axi_awid,
    s_axi_wdata,
    s_axi_wvalid,
    s_axi_araddr,
    s_axi_awaddr,
    s_axi_awsize,
    s_axi_wlast,
    s_axi_bready,
    s_axi_awburst,
    s_axi_awlen,
    s_axi_arlen,
    s_axi_arsize,
    s_axi_arburst,
    s_axi_rready,
    s_axi_aresetn,
    s_axi_arvalid,
    s_axi_awvalid,
    \s_axi_awsize[2] ,
    \s_axi_awaddr[3] ,
    \s_axi_awsize[2]_0 ,
    DI,
    \s_axi_araddr[3] ,
    S,
    s_axi_wstrb,
    s_axi_arid,
    bram_rddata_a);
  output bram_rst_a;
  output [127:0]bram_wrdata_a;
  output [127:0]s_axi_rdata;
  output s_axi_awready;
  output s_axi_arready;
  output s_axi_wready;
  output s_axi_bvalid;
  output s_axi_rvalid;
  output s_axi_rlast;
  output [7:0]Q;
  output [15:0]bram_we_a;
  output bram_en_a;
  output [1:0]s_axi_bid;
  output [1:0]s_axi_rid;
  output [0:0]bram_addr_a;
  input s_axi_aclk;
  input [1:0]s_axi_awid;
  input [127:0]s_axi_wdata;
  input s_axi_wvalid;
  input [12:0]s_axi_araddr;
  input [12:0]s_axi_awaddr;
  input [2:0]s_axi_awsize;
  input s_axi_wlast;
  input s_axi_bready;
  input [1:0]s_axi_awburst;
  input [7:0]s_axi_awlen;
  input [7:0]s_axi_arlen;
  input [2:0]s_axi_arsize;
  input [1:0]s_axi_arburst;
  input s_axi_rready;
  input s_axi_aresetn;
  input s_axi_arvalid;
  input s_axi_awvalid;
  input [2:0]\s_axi_awsize[2] ;
  input [0:0]\s_axi_awaddr[3] ;
  input [3:0]\s_axi_awsize[2]_0 ;
  input [2:0]DI;
  input [0:0]\s_axi_araddr[3] ;
  input [3:0]S;
  input [15:0]s_axi_wstrb;
  input [1:0]s_axi_arid;
  input [127:0]bram_rddata_a;

  wire [2:0]DI;
  wire [7:0]Q;
  wire [3:0]S;
  wire [0:0]bram_addr_a;
  wire bram_en_a;
  wire [127:0]bram_rddata_a;
  wire bram_rst_a;
  wire [15:0]bram_we_a;
  wire [127:0]bram_wrdata_a;
  wire s_axi_aclk;
  wire [12:0]s_axi_araddr;
  wire [0:0]\s_axi_araddr[3] ;
  wire [1:0]s_axi_arburst;
  wire s_axi_aresetn;
  wire [1:0]s_axi_arid;
  wire [7:0]s_axi_arlen;
  wire s_axi_arready;
  wire [2:0]s_axi_arsize;
  wire s_axi_arvalid;
  wire [12:0]s_axi_awaddr;
  wire [0:0]\s_axi_awaddr[3] ;
  wire [1:0]s_axi_awburst;
  wire [1:0]s_axi_awid;
  wire [7:0]s_axi_awlen;
  wire s_axi_awready;
  wire [2:0]s_axi_awsize;
  wire [2:0]\s_axi_awsize[2] ;
  wire [3:0]\s_axi_awsize[2]_0 ;
  wire s_axi_awvalid;
  wire [1:0]s_axi_bid;
  wire s_axi_bready;
  wire s_axi_bvalid;
  wire [127:0]s_axi_rdata;
  wire [1:0]s_axi_rid;
  wire s_axi_rlast;
  wire s_axi_rready;
  wire s_axi_rvalid;
  wire [127:0]s_axi_wdata;
  wire s_axi_wlast;
  wire s_axi_wready;
  wire [15:0]s_axi_wstrb;
  wire s_axi_wvalid;

  Integrated_axi_bram_ctrl_1_0_full_axi \GEN_AXI4.I_FULL_AXI 
       (.DI(DI),
        .Q(Q),
        .S(S),
        .bram_addr_a(bram_addr_a),
        .bram_en_a(bram_en_a),
        .bram_rddata_a(bram_rddata_a),
        .bram_rst_a(bram_rst_a),
        .bram_we_a(bram_we_a),
        .bram_wrdata_a(bram_wrdata_a),
        .s_axi_aclk(s_axi_aclk),
        .s_axi_araddr(s_axi_araddr),
        .\s_axi_araddr[3] (\s_axi_araddr[3] ),
        .s_axi_arburst(s_axi_arburst),
        .s_axi_aresetn(s_axi_aresetn),
        .s_axi_arid(s_axi_arid),
        .s_axi_arlen(s_axi_arlen),
        .s_axi_arready(s_axi_arready),
        .s_axi_arsize(s_axi_arsize),
        .s_axi_arvalid(s_axi_arvalid),
        .s_axi_awaddr(s_axi_awaddr),
        .\s_axi_awaddr[3] (\s_axi_awaddr[3] ),
        .s_axi_awburst(s_axi_awburst),
        .s_axi_awid(s_axi_awid),
        .s_axi_awlen(s_axi_awlen),
        .s_axi_awready(s_axi_awready),
        .s_axi_awsize(s_axi_awsize),
        .\s_axi_awsize[2] (\s_axi_awsize[2] ),
        .\s_axi_awsize[2]_0 (\s_axi_awsize[2]_0 ),
        .s_axi_awvalid(s_axi_awvalid),
        .s_axi_bid(s_axi_bid),
        .s_axi_bready(s_axi_bready),
        .s_axi_bvalid(s_axi_bvalid),
        .s_axi_rdata(s_axi_rdata),
        .s_axi_rid(s_axi_rid),
        .s_axi_rlast(s_axi_rlast),
        .s_axi_rready(s_axi_rready),
        .s_axi_rvalid(s_axi_rvalid),
        .s_axi_wdata(s_axi_wdata),
        .s_axi_wlast(s_axi_wlast),
        .s_axi_wready(s_axi_wready),
        .s_axi_wstrb(s_axi_wstrb),
        .s_axi_wvalid(s_axi_wvalid));
endmodule

(* ORIG_REF_NAME = "full_axi" *) 
module Integrated_axi_bram_ctrl_1_0_full_axi
   (bram_rst_a,
    bram_wrdata_a,
    s_axi_rdata,
    s_axi_awready,
    s_axi_arready,
    s_axi_wready,
    s_axi_bvalid,
    s_axi_rvalid,
    s_axi_rlast,
    Q,
    bram_we_a,
    bram_en_a,
    s_axi_bid,
    s_axi_rid,
    bram_addr_a,
    s_axi_aclk,
    s_axi_awid,
    s_axi_wdata,
    s_axi_wvalid,
    s_axi_araddr,
    s_axi_awaddr,
    s_axi_awsize,
    s_axi_wlast,
    s_axi_bready,
    s_axi_awburst,
    s_axi_awlen,
    s_axi_arlen,
    s_axi_arsize,
    s_axi_arburst,
    s_axi_rready,
    s_axi_aresetn,
    s_axi_arvalid,
    s_axi_awvalid,
    \s_axi_awsize[2] ,
    \s_axi_awaddr[3] ,
    \s_axi_awsize[2]_0 ,
    DI,
    \s_axi_araddr[3] ,
    S,
    s_axi_wstrb,
    s_axi_arid,
    bram_rddata_a);
  output bram_rst_a;
  output [127:0]bram_wrdata_a;
  output [127:0]s_axi_rdata;
  output s_axi_awready;
  output s_axi_arready;
  output s_axi_wready;
  output s_axi_bvalid;
  output s_axi_rvalid;
  output s_axi_rlast;
  output [7:0]Q;
  output [15:0]bram_we_a;
  output bram_en_a;
  output [1:0]s_axi_bid;
  output [1:0]s_axi_rid;
  output [0:0]bram_addr_a;
  input s_axi_aclk;
  input [1:0]s_axi_awid;
  input [127:0]s_axi_wdata;
  input s_axi_wvalid;
  input [12:0]s_axi_araddr;
  input [12:0]s_axi_awaddr;
  input [2:0]s_axi_awsize;
  input s_axi_wlast;
  input s_axi_bready;
  input [1:0]s_axi_awburst;
  input [7:0]s_axi_awlen;
  input [7:0]s_axi_arlen;
  input [2:0]s_axi_arsize;
  input [1:0]s_axi_arburst;
  input s_axi_rready;
  input s_axi_aresetn;
  input s_axi_arvalid;
  input s_axi_awvalid;
  input [2:0]\s_axi_awsize[2] ;
  input [0:0]\s_axi_awaddr[3] ;
  input [3:0]\s_axi_awsize[2]_0 ;
  input [2:0]DI;
  input [0:0]\s_axi_araddr[3] ;
  input [3:0]S;
  input [15:0]s_axi_wstrb;
  input [1:0]s_axi_arid;
  input [127:0]bram_rddata_a;

  wire \ADDR_SNG_PORT.bram_addr_int[10]_i_2_n_0 ;
  wire \ADDR_SNG_PORT.bram_addr_int[11]_i_8_n_0 ;
  wire \ADDR_SNG_PORT.bram_addr_int[12]_i_1_n_0 ;
  wire \ADDR_SNG_PORT.bram_addr_int[6]_i_2_n_0 ;
  wire \ADDR_SNG_PORT.bram_addr_int[7]_i_2_n_0 ;
  wire \ADDR_SNG_PORT.bram_addr_int[9]_i_2_n_0 ;
  wire [2:0]DI;
  wire \GEN_ARB.I_SNG_PORT_n_27 ;
  wire \GEN_ARB.I_SNG_PORT_n_5 ;
  wire \GEN_ARB.I_SNG_PORT_n_7 ;
  wire [4:4]\GEN_UA_NARROW.I_UA_NARROW/size_plus_lsb0 ;
  wire I_RD_CHNL_n_129;
  wire I_RD_CHNL_n_144;
  wire I_RD_CHNL_n_146;
  wire I_RD_CHNL_n_148;
  wire I_RD_CHNL_n_149;
  wire I_RD_CHNL_n_150;
  wire I_WR_CHNL_n_131;
  wire I_WR_CHNL_n_142;
  wire I_WR_CHNL_n_143;
  wire I_WR_CHNL_n_144;
  wire I_WR_CHNL_n_145;
  wire I_WR_CHNL_n_146;
  wire I_WR_CHNL_n_147;
  wire I_WR_CHNL_n_148;
  wire I_WR_CHNL_n_149;
  wire I_WR_CHNL_n_150;
  wire I_WR_CHNL_n_152;
  wire I_WR_CHNL_n_153;
  wire I_WR_CHNL_n_154;
  wire [7:0]Q;
  wire [3:0]S;
  wire ar_active_d1;
  wire ar_active_re;
  wire [1:0]arb_sm_cs;
  wire aw_active_d1;
  wire aw_active_re;
  wire [0:0]bram_addr_a;
  wire bram_en_a;
  wire [127:0]bram_rddata_a;
  wire bram_rst_a;
  wire [15:0]bram_we_a;
  wire [127:0]bram_wrdata_a;
  wire last_arb_won;
  wire [7:7]p_0_in;
  wire p_0_out;
  wire [7:0]p_1_in;
  wire p_1_out;
  wire [12:5]p_4_in;
  wire [12:12]p_5_in;
  wire [15:0]p_6_in;
  wire p_7_in;
  wire s_axi_aclk;
  wire [12:0]s_axi_araddr;
  wire [0:0]\s_axi_araddr[3] ;
  wire [1:0]s_axi_arburst;
  wire s_axi_aresetn;
  wire [1:0]s_axi_arid;
  wire [7:0]s_axi_arlen;
  wire s_axi_arready;
  wire [2:0]s_axi_arsize;
  wire s_axi_arvalid;
  wire [12:0]s_axi_awaddr;
  wire [0:0]\s_axi_awaddr[3] ;
  wire [1:0]s_axi_awburst;
  wire [1:0]s_axi_awid;
  wire [7:0]s_axi_awlen;
  wire s_axi_awready;
  wire [2:0]s_axi_awsize;
  wire [2:0]\s_axi_awsize[2] ;
  wire [3:0]\s_axi_awsize[2]_0 ;
  wire s_axi_awvalid;
  wire [1:0]s_axi_bid;
  wire s_axi_bready;
  wire s_axi_bvalid;
  wire [127:0]s_axi_rdata;
  wire [1:0]s_axi_rid;
  wire s_axi_rlast;
  wire s_axi_rready;
  wire s_axi_rvalid;
  wire [127:0]s_axi_wdata;
  wire s_axi_wlast;
  wire s_axi_wready;
  wire [15:0]s_axi_wstrb;
  wire s_axi_wvalid;
  wire sng_bram_addr_ld_en;
  wire [1:0]wr_data_sng_sm_cs;

  LUT6 #(
    .INIT(64'h8000000000000000)) 
    \ADDR_SNG_PORT.bram_addr_int[10]_i_2 
       (.I0(Q[5]),
        .I1(Q[3]),
        .I2(Q[2]),
        .I3(Q[0]),
        .I4(Q[1]),
        .I5(Q[4]),
        .O(\ADDR_SNG_PORT.bram_addr_int[10]_i_2_n_0 ));
  LUT5 #(
    .INIT(32'h6AAAAAAA)) 
    \ADDR_SNG_PORT.bram_addr_int[11]_i_8 
       (.I0(Q[7]),
        .I1(Q[5]),
        .I2(I_RD_CHNL_n_144),
        .I3(Q[4]),
        .I4(Q[6]),
        .O(\ADDR_SNG_PORT.bram_addr_int[11]_i_8_n_0 ));
  LUT6 #(
    .INIT(64'h00000000EEE222E2)) 
    \ADDR_SNG_PORT.bram_addr_int[12]_i_1 
       (.I0(bram_addr_a),
        .I1(sng_bram_addr_ld_en),
        .I2(p_4_in[12]),
        .I3(p_0_out),
        .I4(p_5_in),
        .I5(I_WR_CHNL_n_152),
        .O(\ADDR_SNG_PORT.bram_addr_int[12]_i_1_n_0 ));
  LUT2 #(
    .INIT(4'h7)) 
    \ADDR_SNG_PORT.bram_addr_int[6]_i_2 
       (.I0(Q[0]),
        .I1(Q[1]),
        .O(\ADDR_SNG_PORT.bram_addr_int[6]_i_2_n_0 ));
  (* SOFT_HLUTNM = "soft_lutpair118" *) 
  LUT3 #(
    .INIT(8'h7F)) 
    \ADDR_SNG_PORT.bram_addr_int[7]_i_2 
       (.I0(Q[1]),
        .I1(Q[0]),
        .I2(Q[2]),
        .O(\ADDR_SNG_PORT.bram_addr_int[7]_i_2_n_0 ));
  (* SOFT_HLUTNM = "soft_lutpair118" *) 
  LUT5 #(
    .INIT(32'h80000000)) 
    \ADDR_SNG_PORT.bram_addr_int[9]_i_2 
       (.I0(Q[4]),
        .I1(Q[1]),
        .I2(Q[0]),
        .I3(Q[2]),
        .I4(Q[3]),
        .O(\ADDR_SNG_PORT.bram_addr_int[9]_i_2_n_0 ));
  FDRE #(
    .INIT(1'b0)) 
    \ADDR_SNG_PORT.bram_addr_int_reg[10] 
       (.C(s_axi_aclk),
        .CE(p_0_in),
        .D(p_1_in[6]),
        .Q(Q[6]),
        .R(I_WR_CHNL_n_152));
  FDRE #(
    .INIT(1'b0)) 
    \ADDR_SNG_PORT.bram_addr_int_reg[11] 
       (.C(s_axi_aclk),
        .CE(p_0_in),
        .D(p_1_in[7]),
        .Q(Q[7]),
        .R(I_WR_CHNL_n_152));
  FDRE #(
    .INIT(1'b0)) 
    \ADDR_SNG_PORT.bram_addr_int_reg[12] 
       (.C(s_axi_aclk),
        .CE(1'b1),
        .D(\ADDR_SNG_PORT.bram_addr_int[12]_i_1_n_0 ),
        .Q(bram_addr_a),
        .R(1'b0));
  FDRE #(
    .INIT(1'b0)) 
    \ADDR_SNG_PORT.bram_addr_int_reg[4] 
       (.C(s_axi_aclk),
        .CE(p_0_in),
        .D(p_1_in[0]),
        .Q(Q[0]),
        .R(I_WR_CHNL_n_152));
  FDRE #(
    .INIT(1'b0)) 
    \ADDR_SNG_PORT.bram_addr_int_reg[5] 
       (.C(s_axi_aclk),
        .CE(p_0_in),
        .D(p_1_in[1]),
        .Q(Q[1]),
        .R(I_WR_CHNL_n_152));
  FDRE #(
    .INIT(1'b0)) 
    \ADDR_SNG_PORT.bram_addr_int_reg[6] 
       (.C(s_axi_aclk),
        .CE(p_0_in),
        .D(p_1_in[2]),
        .Q(Q[2]),
        .R(I_WR_CHNL_n_152));
  FDRE #(
    .INIT(1'b0)) 
    \ADDR_SNG_PORT.bram_addr_int_reg[7] 
       (.C(s_axi_aclk),
        .CE(p_0_in),
        .D(p_1_in[3]),
        .Q(Q[3]),
        .R(I_WR_CHNL_n_152));
  FDRE #(
    .INIT(1'b0)) 
    \ADDR_SNG_PORT.bram_addr_int_reg[8] 
       (.C(s_axi_aclk),
        .CE(p_0_in),
        .D(p_1_in[4]),
        .Q(Q[4]),
        .R(I_WR_CHNL_n_152));
  FDRE #(
    .INIT(1'b0)) 
    \ADDR_SNG_PORT.bram_addr_int_reg[9] 
       (.C(s_axi_aclk),
        .CE(p_0_in),
        .D(p_1_in[5]),
        .Q(Q[5]),
        .R(I_WR_CHNL_n_152));
  Integrated_axi_bram_ctrl_1_0_sng_port_arb \GEN_ARB.I_SNG_PORT 
       (.\GEN_AR_SNG.ar_active_d1_reg (\GEN_ARB.I_SNG_PORT_n_27 ),
        .\GEN_NARROW_CNT.narrow_addr_int_reg[3] (\GEN_ARB.I_SNG_PORT_n_5 ),
        .\GEN_NARROW_CNT.narrow_addr_int_reg[3]_0 (\GEN_ARB.I_SNG_PORT_n_7 ),
        .\GEN_WDATA_SM_NO_ECC_SNG_REG_WREADY.wr_data_sng_sm_cs_reg[0] (I_WR_CHNL_n_146),
        .\GEN_WDATA_SM_NO_ECC_SNG_REG_WREADY.wr_data_sng_sm_cs_reg[1] (I_WR_CHNL_n_148),
        .Q(p_6_in),
        .ar_active_d1(ar_active_d1),
        .ar_active_re(ar_active_re),
        .arb_sm_cs(arb_sm_cs),
        .\arb_sm_cs_reg[1]_0 (I_WR_CHNL_n_154),
        .aw_active_d1(aw_active_d1),
        .aw_active_re(aw_active_re),
        .axi_rlast_int_reg(I_RD_CHNL_n_148),
        .axi_rlast_int_reg_0(s_axi_rlast),
        .axi_rlast_int_reg_1(I_RD_CHNL_n_129),
        .bram_we_a(bram_we_a),
        .\bvalid_cnt_reg[0] (I_WR_CHNL_n_150),
        .last_arb_won(last_arb_won),
        .last_arb_won_reg_0(I_WR_CHNL_n_147),
        .p_0_out(p_0_out),
        .p_1_out(p_1_out),
        .s_axi_aclk(s_axi_aclk),
        .s_axi_araddr(s_axi_araddr[3:0]),
        .s_axi_arburst(s_axi_arburst),
        .s_axi_aresetn(bram_rst_a),
        .\s_axi_arlen[0] (I_RD_CHNL_n_150),
        .\s_axi_arlen[7] (I_RD_CHNL_n_146),
        .s_axi_arready(s_axi_arready),
        .\s_axi_arsize[1] (I_RD_CHNL_n_149),
        .s_axi_arvalid(s_axi_arvalid),
        .s_axi_awaddr(s_axi_awaddr[3:0]),
        .s_axi_awburst(s_axi_awburst),
        .\s_axi_awlen[2] (I_WR_CHNL_n_144),
        .\s_axi_awlen[2]_0 (I_WR_CHNL_n_145),
        .\s_axi_awlen[4] (I_WR_CHNL_n_149),
        .s_axi_awready(s_axi_awready),
        .\s_axi_awsize[1] (I_WR_CHNL_n_143),
        .s_axi_awvalid(s_axi_awvalid),
        .s_axi_rready(s_axi_rready),
        .size_plus_lsb0(\GEN_UA_NARROW.I_UA_NARROW/size_plus_lsb0 ),
        .wr_data_sng_sm_cs(wr_data_sng_sm_cs));
  Integrated_axi_bram_ctrl_1_0_rd_chnl I_RD_CHNL
       (.\ADDR_SNG_PORT.bram_addr_int_reg[11] (\ADDR_SNG_PORT.bram_addr_int[11]_i_8_n_0 ),
        .\ADDR_SNG_PORT.bram_addr_int_reg[4] (\ADDR_SNG_PORT.bram_addr_int[6]_i_2_n_0 ),
        .\ADDR_SNG_PORT.bram_addr_int_reg[5] (\ADDR_SNG_PORT.bram_addr_int[7]_i_2_n_0 ),
        .\ADDR_SNG_PORT.bram_addr_int_reg[8] (I_RD_CHNL_n_144),
        .\ADDR_SNG_PORT.bram_addr_int_reg[8]_0 (\ADDR_SNG_PORT.bram_addr_int[9]_i_2_n_0 ),
        .\ADDR_SNG_PORT.bram_addr_int_reg[9] (\ADDR_SNG_PORT.bram_addr_int[10]_i_2_n_0 ),
        .D(p_1_in),
        .DI(DI),
        .E(p_0_in),
        .\GEN_NARROW_CNT.narrow_addr_int_reg[3]_0 (I_RD_CHNL_n_146),
        .\GEN_NARROW_CNT.narrow_addr_int_reg[3]_1 (I_RD_CHNL_n_149),
        .\GEN_NARROW_CNT.narrow_addr_int_reg[3]_2 (I_RD_CHNL_n_150),
        .\GEN_NARROW_EN.curr_narrow_burst_reg_0 (I_WR_CHNL_n_131),
        .\GEN_RDATA_NO_ECC.GEN_RDATA[0].axi_rdata_int_reg[0]_0 (I_RD_CHNL_n_129),
        .Q(Q[6:0]),
        .S(S),
        .ar_active_d1(ar_active_d1),
        .ar_active_re(ar_active_re),
        .ar_active_reg(\GEN_ARB.I_SNG_PORT_n_27 ),
        .ar_active_reg_0(\GEN_ARB.I_SNG_PORT_n_7 ),
        .\arb_sm_cs_reg[1] (I_RD_CHNL_n_148),
        .aw_active_d1_reg(I_WR_CHNL_n_153),
        .aw_active_d1_reg_0(I_WR_CHNL_n_142),
        .bram_rddata_a(bram_rddata_a),
        .bram_rst_a(bram_rst_a),
        .p_0_out(p_0_out),
        .p_7_in(p_7_in),
        .s_axi_aclk(s_axi_aclk),
        .s_axi_araddr(s_axi_araddr),
        .\s_axi_araddr[3] (\s_axi_araddr[3] ),
        .s_axi_arburst(s_axi_arburst),
        .s_axi_aresetn(s_axi_aresetn),
        .s_axi_arid(s_axi_arid),
        .s_axi_arlen(s_axi_arlen),
        .s_axi_arsize(s_axi_arsize),
        .s_axi_awaddr(s_axi_awaddr[4]),
        .s_axi_rdata(s_axi_rdata),
        .s_axi_rid(s_axi_rid),
        .s_axi_rlast(s_axi_rlast),
        .s_axi_rready(s_axi_rready),
        .s_axi_rvalid(s_axi_rvalid),
        .\save_init_bram_addr_ld_reg[11] (p_4_in[11:5]),
        .\save_init_bram_addr_ld_reg[12] (p_5_in),
        .size_plus_lsb0(\GEN_UA_NARROW.I_UA_NARROW/size_plus_lsb0 ),
        .sng_bram_addr_ld_en(sng_bram_addr_ld_en));
  Integrated_axi_bram_ctrl_1_0_wr_chnl I_WR_CHNL
       (.\ADDR_SNG_PORT.bram_addr_int_reg[11] (I_WR_CHNL_n_152),
        .\ADDR_SNG_PORT.bram_addr_int_reg[11]_0 (I_WR_CHNL_n_153),
        .\ADDR_SNG_PORT.bram_addr_int_reg[4] (I_WR_CHNL_n_131),
        .\ADDR_SNG_PORT.bram_addr_int_reg[7] (I_RD_CHNL_n_144),
        .D(p_4_in),
        .\GEN_NARROW_CNT.narrow_addr_int_reg[3]_0 (I_WR_CHNL_n_144),
        .\GEN_NARROW_CNT.narrow_addr_int_reg[3]_1 (I_WR_CHNL_n_145),
        .\GEN_NARROW_CNT.narrow_addr_int_reg[3]_2 (I_WR_CHNL_n_149),
        .Q(Q[2:0]),
        .arb_sm_cs(arb_sm_cs),
        .\arb_sm_cs_reg[1] (I_WR_CHNL_n_148),
        .\arb_sm_cs_reg[1]_0 (I_WR_CHNL_n_150),
        .aw_active_d1(aw_active_d1),
        .aw_active_re(aw_active_re),
        .aw_active_reg(I_WR_CHNL_n_146),
        .aw_active_reg_0(\GEN_ARB.I_SNG_PORT_n_5 ),
        .axi_awready_int_reg(I_WR_CHNL_n_147),
        .axi_rlast_int_reg(I_RD_CHNL_n_148),
        .bram_en_a(bram_en_a),
        .\bram_we_a[15] (p_6_in),
        .bram_wrdata_a(bram_wrdata_a),
        .last_arb_won(last_arb_won),
        .last_arb_won_reg(I_WR_CHNL_n_154),
        .p_1_out(p_1_out),
        .p_7_in(p_7_in),
        .s_axi_aclk(s_axi_aclk),
        .s_axi_aresetn(s_axi_aresetn),
        .s_axi_aresetn_0(bram_rst_a),
        .s_axi_arvalid(s_axi_arvalid),
        .s_axi_awaddr({s_axi_awaddr[12:5],s_axi_awaddr[3:0]}),
        .\s_axi_awaddr[3] (\s_axi_awaddr[3] ),
        .s_axi_awburst(s_axi_awburst),
        .s_axi_awid(s_axi_awid),
        .s_axi_awlen(s_axi_awlen),
        .s_axi_awsize(s_axi_awsize),
        .\s_axi_awsize[2] (\s_axi_awsize[2] ),
        .\s_axi_awsize[2]_0 (\s_axi_awsize[2]_0 ),
        .s_axi_awvalid(s_axi_awvalid),
        .s_axi_bid(s_axi_bid),
        .s_axi_bready(s_axi_bready),
        .s_axi_bvalid(s_axi_bvalid),
        .s_axi_wdata(s_axi_wdata),
        .s_axi_wlast(s_axi_wlast),
        .s_axi_wready(s_axi_wready),
        .s_axi_wstrb(s_axi_wstrb),
        .s_axi_wvalid(s_axi_wvalid),
        .\save_init_bram_addr_ld_reg[11] (I_WR_CHNL_n_142),
        .wr_data_sng_sm_cs(wr_data_sng_sm_cs),
        .\wrap_burst_total_reg[2] (I_WR_CHNL_n_143));
endmodule

(* ORIG_REF_NAME = "rd_chnl" *) 
module Integrated_axi_bram_ctrl_1_0_rd_chnl
   (bram_rst_a,
    s_axi_rdata,
    \GEN_RDATA_NO_ECC.GEN_RDATA[0].axi_rdata_int_reg[0]_0 ,
    ar_active_d1,
    s_axi_rvalid,
    s_axi_rlast,
    p_7_in,
    D,
    sng_bram_addr_ld_en,
    \save_init_bram_addr_ld_reg[12] ,
    \ADDR_SNG_PORT.bram_addr_int_reg[8] ,
    E,
    \GEN_NARROW_CNT.narrow_addr_int_reg[3]_0 ,
    size_plus_lsb0,
    \arb_sm_cs_reg[1] ,
    \GEN_NARROW_CNT.narrow_addr_int_reg[3]_1 ,
    \GEN_NARROW_CNT.narrow_addr_int_reg[3]_2 ,
    s_axi_rid,
    s_axi_aclk,
    ar_active_re,
    ar_active_reg,
    Q,
    p_0_out,
    \save_init_bram_addr_ld_reg[11] ,
    \ADDR_SNG_PORT.bram_addr_int_reg[4] ,
    \ADDR_SNG_PORT.bram_addr_int_reg[5] ,
    \ADDR_SNG_PORT.bram_addr_int_reg[8]_0 ,
    \ADDR_SNG_PORT.bram_addr_int_reg[9] ,
    \ADDR_SNG_PORT.bram_addr_int_reg[11] ,
    \GEN_NARROW_EN.curr_narrow_burst_reg_0 ,
    aw_active_d1_reg,
    s_axi_araddr,
    s_axi_awaddr,
    aw_active_d1_reg_0,
    s_axi_arlen,
    ar_active_reg_0,
    s_axi_arsize,
    s_axi_rready,
    s_axi_arburst,
    s_axi_aresetn,
    DI,
    \s_axi_araddr[3] ,
    S,
    s_axi_arid,
    bram_rddata_a);
  output bram_rst_a;
  output [127:0]s_axi_rdata;
  output \GEN_RDATA_NO_ECC.GEN_RDATA[0].axi_rdata_int_reg[0]_0 ;
  output ar_active_d1;
  output s_axi_rvalid;
  output s_axi_rlast;
  output p_7_in;
  output [7:0]D;
  output sng_bram_addr_ld_en;
  output [0:0]\save_init_bram_addr_ld_reg[12] ;
  output \ADDR_SNG_PORT.bram_addr_int_reg[8] ;
  output [0:0]E;
  output \GEN_NARROW_CNT.narrow_addr_int_reg[3]_0 ;
  output [0:0]size_plus_lsb0;
  output \arb_sm_cs_reg[1] ;
  output \GEN_NARROW_CNT.narrow_addr_int_reg[3]_1 ;
  output \GEN_NARROW_CNT.narrow_addr_int_reg[3]_2 ;
  output [1:0]s_axi_rid;
  input s_axi_aclk;
  input ar_active_re;
  input ar_active_reg;
  input [6:0]Q;
  input p_0_out;
  input [6:0]\save_init_bram_addr_ld_reg[11] ;
  input \ADDR_SNG_PORT.bram_addr_int_reg[4] ;
  input \ADDR_SNG_PORT.bram_addr_int_reg[5] ;
  input \ADDR_SNG_PORT.bram_addr_int_reg[8]_0 ;
  input \ADDR_SNG_PORT.bram_addr_int_reg[9] ;
  input \ADDR_SNG_PORT.bram_addr_int_reg[11] ;
  input \GEN_NARROW_EN.curr_narrow_burst_reg_0 ;
  input aw_active_d1_reg;
  input [12:0]s_axi_araddr;
  input [0:0]s_axi_awaddr;
  input aw_active_d1_reg_0;
  input [7:0]s_axi_arlen;
  input ar_active_reg_0;
  input [2:0]s_axi_arsize;
  input s_axi_rready;
  input [1:0]s_axi_arburst;
  input s_axi_aresetn;
  input [2:0]DI;
  input [0:0]\s_axi_araddr[3] ;
  input [3:0]S;
  input [1:0]s_axi_arid;
  input [127:0]bram_rddata_a;

  wire \/i__n_0 ;
  wire \ADDR_SNG_PORT.bram_addr_int[11]_i_6_n_0 ;
  wire \ADDR_SNG_PORT.bram_addr_int_reg[11] ;
  wire \ADDR_SNG_PORT.bram_addr_int_reg[4] ;
  wire \ADDR_SNG_PORT.bram_addr_int_reg[5] ;
  wire \ADDR_SNG_PORT.bram_addr_int_reg[8] ;
  wire \ADDR_SNG_PORT.bram_addr_int_reg[8]_0 ;
  wire \ADDR_SNG_PORT.bram_addr_int_reg[9] ;
  wire [7:0]D;
  wire [2:0]DI;
  wire [0:0]E;
  wire \FSM_sequential_rlast_sm_cs[0]_i_1_n_0 ;
  wire \FSM_sequential_rlast_sm_cs[0]_i_2_n_0 ;
  wire \FSM_sequential_rlast_sm_cs[1]_i_1_n_0 ;
  wire \FSM_sequential_rlast_sm_cs[1]_i_2_n_0 ;
  wire \FSM_sequential_rlast_sm_cs[2]_i_1_n_0 ;
  wire \GEN_BRST_MAX_W_NARROW.brst_cnt_max_i_1_n_0 ;
  wire \GEN_BRST_MAX_W_NARROW.brst_cnt_max_i_2_n_0 ;
  wire \GEN_BRST_MAX_W_NARROW.brst_cnt_max_reg_n_0 ;
  wire \GEN_NARROW_CNT.narrow_addr_int[0]_i_2__0_n_0 ;
  wire \GEN_NARROW_CNT.narrow_addr_int[2]_i_2__0_n_0 ;
  wire \GEN_NARROW_CNT.narrow_addr_int[2]_i_4__0_n_0 ;
  wire \GEN_NARROW_CNT.narrow_addr_int[3]_i_11__0_n_0 ;
  wire \GEN_NARROW_CNT.narrow_addr_int[3]_i_12_n_0 ;
  wire \GEN_NARROW_CNT.narrow_addr_int[3]_i_13__0_n_0 ;
  wire \GEN_NARROW_CNT.narrow_addr_int[3]_i_14__0_n_0 ;
  wire \GEN_NARROW_CNT.narrow_addr_int[3]_i_15_n_0 ;
  wire \GEN_NARROW_CNT.narrow_addr_int[3]_i_16__0_n_0 ;
  wire \GEN_NARROW_CNT.narrow_addr_int[3]_i_17_n_0 ;
  wire \GEN_NARROW_CNT.narrow_addr_int[3]_i_18__0_n_0 ;
  wire \GEN_NARROW_CNT.narrow_addr_int[3]_i_19__0_n_0 ;
  wire \GEN_NARROW_CNT.narrow_addr_int[3]_i_1__0_n_0 ;
  wire \GEN_NARROW_CNT.narrow_addr_int[3]_i_20__0_n_0 ;
  wire \GEN_NARROW_CNT.narrow_addr_int[3]_i_21__0_n_0 ;
  wire \GEN_NARROW_CNT.narrow_addr_int[3]_i_22__0_n_0 ;
  wire \GEN_NARROW_CNT.narrow_addr_int[3]_i_23__0_n_0 ;
  wire \GEN_NARROW_CNT.narrow_addr_int[3]_i_24_n_0 ;
  wire \GEN_NARROW_CNT.narrow_addr_int[3]_i_25_n_0 ;
  wire \GEN_NARROW_CNT.narrow_addr_int[3]_i_26_n_0 ;
  wire \GEN_NARROW_CNT.narrow_addr_int[3]_i_27_n_0 ;
  wire \GEN_NARROW_CNT.narrow_addr_int[3]_i_3__0_n_0 ;
  wire \GEN_NARROW_CNT.narrow_addr_int[3]_i_4__0_n_0 ;
  wire \GEN_NARROW_CNT.narrow_addr_int[3]_i_6__0_n_0 ;
  wire \GEN_NARROW_CNT.narrow_addr_int_reg[3]_0 ;
  wire \GEN_NARROW_CNT.narrow_addr_int_reg[3]_1 ;
  wire \GEN_NARROW_CNT.narrow_addr_int_reg[3]_2 ;
  wire \GEN_NARROW_CNT_LD.narrow_burst_cnt_ld_reg[2]_i_1__0_n_0 ;
  wire \GEN_NARROW_EN.curr_narrow_burst_i_1__0_n_0 ;
  wire \GEN_NARROW_EN.curr_narrow_burst_i_2__0_n_0 ;
  wire \GEN_NARROW_EN.curr_narrow_burst_reg_0 ;
  wire \GEN_RDATA_NO_ECC.GEN_RDATA[0].axi_rdata_int[0]_i_1_n_0 ;
  wire \GEN_RDATA_NO_ECC.GEN_RDATA[0].axi_rdata_int_reg[0]_0 ;
  wire \GEN_RDATA_NO_ECC.GEN_RDATA[100].axi_rdata_int[100]_i_1_n_0 ;
  wire \GEN_RDATA_NO_ECC.GEN_RDATA[101].axi_rdata_int[101]_i_1_n_0 ;
  wire \GEN_RDATA_NO_ECC.GEN_RDATA[102].axi_rdata_int[102]_i_1_n_0 ;
  wire \GEN_RDATA_NO_ECC.GEN_RDATA[103].axi_rdata_int[103]_i_1_n_0 ;
  wire \GEN_RDATA_NO_ECC.GEN_RDATA[104].axi_rdata_int[104]_i_1_n_0 ;
  wire \GEN_RDATA_NO_ECC.GEN_RDATA[105].axi_rdata_int[105]_i_1_n_0 ;
  wire \GEN_RDATA_NO_ECC.GEN_RDATA[106].axi_rdata_int[106]_i_1_n_0 ;
  wire \GEN_RDATA_NO_ECC.GEN_RDATA[107].axi_rdata_int[107]_i_1_n_0 ;
  wire \GEN_RDATA_NO_ECC.GEN_RDATA[108].axi_rdata_int[108]_i_1_n_0 ;
  wire \GEN_RDATA_NO_ECC.GEN_RDATA[109].axi_rdata_int[109]_i_1_n_0 ;
  wire \GEN_RDATA_NO_ECC.GEN_RDATA[10].axi_rdata_int[10]_i_1_n_0 ;
  wire \GEN_RDATA_NO_ECC.GEN_RDATA[110].axi_rdata_int[110]_i_1_n_0 ;
  wire \GEN_RDATA_NO_ECC.GEN_RDATA[111].axi_rdata_int[111]_i_1_n_0 ;
  wire \GEN_RDATA_NO_ECC.GEN_RDATA[112].axi_rdata_int[112]_i_1_n_0 ;
  wire \GEN_RDATA_NO_ECC.GEN_RDATA[113].axi_rdata_int[113]_i_1_n_0 ;
  wire \GEN_RDATA_NO_ECC.GEN_RDATA[114].axi_rdata_int[114]_i_1_n_0 ;
  wire \GEN_RDATA_NO_ECC.GEN_RDATA[115].axi_rdata_int[115]_i_1_n_0 ;
  wire \GEN_RDATA_NO_ECC.GEN_RDATA[116].axi_rdata_int[116]_i_1_n_0 ;
  wire \GEN_RDATA_NO_ECC.GEN_RDATA[117].axi_rdata_int[117]_i_1_n_0 ;
  wire \GEN_RDATA_NO_ECC.GEN_RDATA[118].axi_rdata_int[118]_i_1_n_0 ;
  wire \GEN_RDATA_NO_ECC.GEN_RDATA[119].axi_rdata_int[119]_i_1_n_0 ;
  wire \GEN_RDATA_NO_ECC.GEN_RDATA[11].axi_rdata_int[11]_i_1_n_0 ;
  wire \GEN_RDATA_NO_ECC.GEN_RDATA[120].axi_rdata_int[120]_i_1_n_0 ;
  wire \GEN_RDATA_NO_ECC.GEN_RDATA[121].axi_rdata_int[121]_i_1_n_0 ;
  wire \GEN_RDATA_NO_ECC.GEN_RDATA[122].axi_rdata_int[122]_i_1_n_0 ;
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
  wire \GEN_RDATA_NO_ECC.GEN_RDATA[64].axi_rdata_int[64]_i_1_n_0 ;
  wire \GEN_RDATA_NO_ECC.GEN_RDATA[65].axi_rdata_int[65]_i_1_n_0 ;
  wire \GEN_RDATA_NO_ECC.GEN_RDATA[66].axi_rdata_int[66]_i_1_n_0 ;
  wire \GEN_RDATA_NO_ECC.GEN_RDATA[67].axi_rdata_int[67]_i_1_n_0 ;
  wire \GEN_RDATA_NO_ECC.GEN_RDATA[68].axi_rdata_int[68]_i_1_n_0 ;
  wire \GEN_RDATA_NO_ECC.GEN_RDATA[69].axi_rdata_int[69]_i_1_n_0 ;
  wire \GEN_RDATA_NO_ECC.GEN_RDATA[6].axi_rdata_int[6]_i_1_n_0 ;
  wire \GEN_RDATA_NO_ECC.GEN_RDATA[70].axi_rdata_int[70]_i_1_n_0 ;
  wire \GEN_RDATA_NO_ECC.GEN_RDATA[71].axi_rdata_int[71]_i_1_n_0 ;
  wire \GEN_RDATA_NO_ECC.GEN_RDATA[72].axi_rdata_int[72]_i_1_n_0 ;
  wire \GEN_RDATA_NO_ECC.GEN_RDATA[73].axi_rdata_int[73]_i_1_n_0 ;
  wire \GEN_RDATA_NO_ECC.GEN_RDATA[74].axi_rdata_int[74]_i_1_n_0 ;
  wire \GEN_RDATA_NO_ECC.GEN_RDATA[75].axi_rdata_int[75]_i_1_n_0 ;
  wire \GEN_RDATA_NO_ECC.GEN_RDATA[76].axi_rdata_int[76]_i_1_n_0 ;
  wire \GEN_RDATA_NO_ECC.GEN_RDATA[77].axi_rdata_int[77]_i_1_n_0 ;
  wire \GEN_RDATA_NO_ECC.GEN_RDATA[78].axi_rdata_int[78]_i_1_n_0 ;
  wire \GEN_RDATA_NO_ECC.GEN_RDATA[79].axi_rdata_int[79]_i_1_n_0 ;
  wire \GEN_RDATA_NO_ECC.GEN_RDATA[7].axi_rdata_int[7]_i_1_n_0 ;
  wire \GEN_RDATA_NO_ECC.GEN_RDATA[80].axi_rdata_int[80]_i_1_n_0 ;
  wire \GEN_RDATA_NO_ECC.GEN_RDATA[81].axi_rdata_int[81]_i_1_n_0 ;
  wire \GEN_RDATA_NO_ECC.GEN_RDATA[82].axi_rdata_int[82]_i_1_n_0 ;
  wire \GEN_RDATA_NO_ECC.GEN_RDATA[83].axi_rdata_int[83]_i_1_n_0 ;
  wire \GEN_RDATA_NO_ECC.GEN_RDATA[84].axi_rdata_int[84]_i_1_n_0 ;
  wire \GEN_RDATA_NO_ECC.GEN_RDATA[85].axi_rdata_int[85]_i_1_n_0 ;
  wire \GEN_RDATA_NO_ECC.GEN_RDATA[86].axi_rdata_int[86]_i_1_n_0 ;
  wire \GEN_RDATA_NO_ECC.GEN_RDATA[87].axi_rdata_int[87]_i_1_n_0 ;
  wire \GEN_RDATA_NO_ECC.GEN_RDATA[88].axi_rdata_int[88]_i_1_n_0 ;
  wire \GEN_RDATA_NO_ECC.GEN_RDATA[89].axi_rdata_int[89]_i_1_n_0 ;
  wire \GEN_RDATA_NO_ECC.GEN_RDATA[8].axi_rdata_int[8]_i_1_n_0 ;
  wire \GEN_RDATA_NO_ECC.GEN_RDATA[90].axi_rdata_int[90]_i_1_n_0 ;
  wire \GEN_RDATA_NO_ECC.GEN_RDATA[91].axi_rdata_int[91]_i_1_n_0 ;
  wire \GEN_RDATA_NO_ECC.GEN_RDATA[92].axi_rdata_int[92]_i_1_n_0 ;
  wire \GEN_RDATA_NO_ECC.GEN_RDATA[93].axi_rdata_int[93]_i_1_n_0 ;
  wire \GEN_RDATA_NO_ECC.GEN_RDATA[94].axi_rdata_int[94]_i_1_n_0 ;
  wire \GEN_RDATA_NO_ECC.GEN_RDATA[95].axi_rdata_int[95]_i_1_n_0 ;
  wire \GEN_RDATA_NO_ECC.GEN_RDATA[96].axi_rdata_int[96]_i_1_n_0 ;
  wire \GEN_RDATA_NO_ECC.GEN_RDATA[97].axi_rdata_int[97]_i_1_n_0 ;
  wire \GEN_RDATA_NO_ECC.GEN_RDATA[98].axi_rdata_int[98]_i_1_n_0 ;
  wire \GEN_RDATA_NO_ECC.GEN_RDATA[99].axi_rdata_int[99]_i_1_n_0 ;
  wire \GEN_RDATA_NO_ECC.GEN_RDATA[9].axi_rdata_int[9]_i_1_n_0 ;
  wire \GEN_RID_SNG.axi_rid_int[0]_i_1_n_0 ;
  wire \GEN_RID_SNG.axi_rid_int[1]_i_1_n_0 ;
  wire \GEN_UA_NARROW.I_UA_NARROW_n_0 ;
  wire \GEN_UA_NARROW.I_UA_NARROW_n_1 ;
  wire \GEN_UA_NARROW.I_UA_NARROW_n_2 ;
  wire \GEN_UA_NARROW.I_UA_NARROW_n_3 ;
  wire I_WRAP_BRST_n_11;
  wire I_WRAP_BRST_n_14;
  wire I_WRAP_BRST_n_15;
  wire [6:0]Q;
  wire [3:0]S;
  wire act_rd_burst;
  wire act_rd_burst_i_1_n_0;
  wire act_rd_burst_i_3_n_0;
  wire act_rd_burst_set;
  wire act_rd_burst_two;
  wire act_rd_burst_two_i_1_n_0;
  wire ar_active_d1;
  wire ar_active_re;
  wire ar_active_reg;
  wire ar_active_reg_0;
  wire \arb_sm_cs_reg[1] ;
  wire aw_active_d1_reg;
  wire aw_active_d1_reg_0;
  wire axi_rd_burst;
  wire axi_rd_burst0;
  wire axi_rd_burst_i_1_n_0;
  wire axi_rd_burst_i_3_n_0;
  wire axi_rd_burst_two_i_1_n_0;
  wire axi_rd_burst_two_i_2_n_0;
  wire axi_rd_burst_two_reg_n_0;
  wire axi_rdata_en;
  wire [1:0]axi_rid_temp;
  wire axi_rlast_int_i_1_n_0;
  wire axi_rlast_set;
  wire axi_rvalid_clr_ok;
  wire axi_rvalid_clr_ok_i_1_n_0;
  wire axi_rvalid_clr_ok_i_2_n_0;
  wire axi_rvalid_int_i_1_n_0;
  wire axi_rvalid_set;
  wire axi_rvalid_set_cmb;
  wire bram_en_int_i_1_n_0;
  wire bram_en_int_i_2_n_0;
  wire bram_en_int_i_3_n_0;
  wire bram_en_int_i_4_n_0;
  wire bram_en_int_i_5_n_0;
  wire bram_en_int_i_6_n_0;
  wire bram_en_int_i_7_n_0;
  wire bram_en_int_i_8_n_0;
  wire bram_en_int_i_9_n_0;
  wire [127:0]bram_rddata_a;
  wire bram_rst_a;
  wire [7:0]brst_cnt;
  wire \brst_cnt[0]_i_1_n_0 ;
  wire \brst_cnt[1]_i_1_n_0 ;
  wire \brst_cnt[2]_i_1_n_0 ;
  wire \brst_cnt[3]_i_1_n_0 ;
  wire \brst_cnt[4]_i_1_n_0 ;
  wire \brst_cnt[5]_i_1_n_0 ;
  wire \brst_cnt[6]_i_1_n_0 ;
  wire \brst_cnt[6]_i_2_n_0 ;
  wire \brst_cnt[7]_i_1_n_0 ;
  wire \brst_cnt[7]_i_2_n_0 ;
  wire \brst_cnt[7]_i_3_n_0 ;
  wire \brst_cnt[7]_i_4_n_0 ;
  wire brst_cnt_max_d1;
  wire brst_one;
  wire brst_one0;
  wire brst_one_i_1_n_0;
  wire brst_one_i_3_n_0;
  wire brst_zero;
  wire brst_zero_i_1_n_0;
  wire brst_zero_i_2_n_0;
  wire curr_fixed_burst;
  wire curr_fixed_burst_reg;
  wire curr_narrow_burst;
  wire curr_wrap_burst;
  wire curr_wrap_burst_reg;
  wire disable_b2b_brst;
  wire disable_b2b_brst_cmb;
  wire disable_b2b_brst_i_2_n_0;
  wire disable_b2b_brst_i_3_n_0;
  wire disable_b2b_brst_i_4_n_0;
  wire end_brst_rd;
  wire end_brst_rd_clr;
  wire end_brst_rd_clr_i_1_n_0;
  wire end_brst_rd_i_1_n_0;
  wire last_bram_addr;
  wire last_bram_addr0;
  wire last_bram_addr_i_2_n_0;
  wire last_bram_addr_i_3_n_0;
  wire last_bram_addr_i_4_n_0;
  wire last_bram_addr_i_5_n_0;
  wire [3:0]narrow_addr_int;
  wire narrow_bram_addr_inc;
  wire narrow_bram_addr_inc_d1;
  wire [3:0]narrow_burst_cnt_ld_mod;
  wire [3:0]narrow_burst_cnt_ld_reg;
  wire p_0_in4_in;
  wire p_0_out;
  wire p_7_in;
  wire pend_rd_op;
  wire pend_rd_op_i_1_n_0;
  wire pend_rd_op_i_2_n_0;
  wire pend_rd_op_i_3_n_0;
  wire pend_rd_op_i_4_n_0;
  wire pend_rd_op_i_5_n_0;
  wire pend_rd_op_i_6_n_0;
  wire rd_adv_buf30_out;
  wire [3:0]rd_data_sm_cs;
  wire \rd_data_sm_cs[0]_i_1_n_0 ;
  wire \rd_data_sm_cs[0]_i_2_n_0 ;
  wire \rd_data_sm_cs[0]_i_3_n_0 ;
  wire \rd_data_sm_cs[0]_i_4_n_0 ;
  wire \rd_data_sm_cs[1]_i_1_n_0 ;
  wire \rd_data_sm_cs[1]_i_3_n_0 ;
  wire \rd_data_sm_cs[2]_i_1_n_0 ;
  wire \rd_data_sm_cs[2]_i_2_n_0 ;
  wire \rd_data_sm_cs[2]_i_3_n_0 ;
  wire \rd_data_sm_cs[3]_i_2_n_0 ;
  wire \rd_data_sm_cs[3]_i_3_n_0 ;
  wire \rd_data_sm_cs[3]_i_4_n_0 ;
  wire \rd_data_sm_cs[3]_i_5_n_0 ;
  wire \rd_data_sm_cs[3]_i_6_n_0 ;
  wire \rd_data_sm_cs[3]_i_7_n_0 ;
  wire \rd_data_sm_cs[3]_i_8_n_0 ;
  wire rd_data_sm_ns;
  wire [127:0]rd_skid_buf;
  wire rd_skid_buf_ld;
  wire rd_skid_buf_ld_cmb;
  wire rd_skid_buf_ld_reg;
  wire rddata_mux_sel;
  wire rddata_mux_sel_cmb;
  wire rddata_mux_sel_i_1_n_0;
  wire rddata_mux_sel_i_3_n_0;
  (* RTL_KEEP = "yes" *) wire [2:0]rlast_sm_cs;
  wire s_axi_aclk;
  wire [12:0]s_axi_araddr;
  wire [0:0]\s_axi_araddr[3] ;
  wire [1:0]s_axi_arburst;
  wire s_axi_aresetn;
  wire [1:0]s_axi_arid;
  wire [7:0]s_axi_arlen;
  wire [2:0]s_axi_arsize;
  wire [0:0]s_axi_awaddr;
  wire [127:0]s_axi_rdata;
  wire [1:0]s_axi_rid;
  wire s_axi_rlast;
  wire s_axi_rready;
  wire s_axi_rvalid;
  wire [6:0]\save_init_bram_addr_ld_reg[11] ;
  wire [0:0]\save_init_bram_addr_ld_reg[12] ;
  wire [8:0]size_plus_lsb;
  wire [0:0]size_plus_lsb0;
  wire sng_bram_addr_ld_en;
  wire ua_narrow_load1_carry__0_i_1__0_n_0;
  wire ua_narrow_load1_carry_i_10__0_n_0;
  wire ua_narrow_load1_carry_i_11__0_n_0;
  wire ua_narrow_load1_carry_i_12__0_n_0;
  wire ua_narrow_load1_carry_i_13__0_n_0;
  wire ua_narrow_load1_carry_i_16__0_n_0;
  wire ua_narrow_load1_carry_i_17__0_n_0;
  wire ua_narrow_load1_carry_i_18__0_n_0;
  wire ua_narrow_load1_carry_i_19__0_n_0;
  wire ua_narrow_load1_carry_i_1__0_n_0;
  wire ua_narrow_load1_carry_i_20__0_n_0;
  wire ua_narrow_load1_carry_i_21__0_n_0;
  wire ua_narrow_load1_carry_i_22__0_n_0;
  wire ua_narrow_load1_carry_i_23__0_n_0;
  wire ua_narrow_load1_carry_i_2__0_n_0;
  wire ua_narrow_load1_carry_i_3__0_n_0;
  wire ua_narrow_load1_carry_i_4__0_n_0;
  wire ua_narrow_load1_carry_i_5__0_n_0;
  wire ua_narrow_load1_carry_i_6__0_n_0;
  wire ua_narrow_load1_carry_i_7__0_n_0;
  wire ua_narrow_load1_carry_i_8__0_n_0;
  wire ua_narrow_load1_carry_i_9__0_n_0;
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
