RaviTharaka/riscv_fpga/RISCV_Demo/RISCV_Demo.ip_user_files/bd/Integrated/hdl/Integrated.v

//Copyright 1986-2016 Xilinx, Inc. All Rights Reserved.
//--------------------------------------------------------------------------------
//Tool Version: Vivado v.2016.3 (win64) Build 1682563 Mon Oct 10 19:07:27 MDT 2016
//Date        : Fri Apr 28 08:14:18 2017
//Host        : ASUS-PC running 64-bit major release  (build 9200)
//Command     : generate_target Integrated.bd
//Design      : Integrated
//Purpose     : IP block netlist
//--------------------------------------------------------------------------------
`timescale 1 ps / 1 ps

(* CORE_GENERATION_INFO = "Integrated,IP_Integrator,{x_ipVendor=xilinx.com,x_ipLibrary=BlockDiagram,x_ipName=Integrated,x_ipVersion=1.00.a,x_ipLanguage=VERILOG,numBlks=23,numReposBlks=14,numNonXlnxBlks=0,numHierBlks=9,maxHierDepth=0,numSysgenBlks=0,numHlsBlks=0,numHdlrefBlks=2,numPkgbdBlks=0,bdsource=USER,da_ps7_cnt=1,synth_mode=OOC_per_IP}" *) (* HW_HANDOFF = "Integrated.hwdef" *) 
module Integrated
   (DDR_addr,
    DDR_ba,
    DDR_cas_n,
    DDR_ck_n,
    DDR_ck_p,
    DDR_cke,
    DDR_cs_n,
    DDR_dm,
    DDR_dq,
    DDR_dqs_n,
    DDR_dqs_p,
    DDR_odt,
    DDR_ras_n,
    DDR_reset_n,
    DDR_we_n,
    FIXED_IO_ddr_vrn,
    FIXED_IO_ddr_vrp,
    FIXED_IO_mio,
    FIXED_IO_ps_clk,
    FIXED_IO_ps_porb,
    FIXED_IO_ps_srstb);
  inout [14:0]DDR_addr;
  inout [2:0]DDR_ba;
  inout DDR_cas_n;
  inout DDR_ck_n;
  inout DDR_ck_p;
  inout DDR_cke;
  inout DDR_cs_n;
  inout [3:0]DDR_dm;
  inout [31:0]DDR_dq;
  inout [3:0]DDR_dqs_n;
  inout [3:0]DDR_dqs_p;
  inout DDR_odt;
  inout DDR_ras_n;
  inout DDR_reset_n;
  inout DDR_we_n;
  inout FIXED_IO_ddr_vrn;
  inout FIXED_IO_ddr_vrp;
  inout [53:0]FIXED_IO_mio;
  inout FIXED_IO_ps_clk;
  inout FIXED_IO_ps_porb;
  inout FIXED_IO_ps_srstb;

  wire [0:0]Net1;
  wire [31:0]RISCV_Proc_AXI_1_EXT_FIFO_WR_DATA;
  wire RISCV_Proc_AXI_1_EXT_FIFO_WR_ENB;
  wire [31:0]RISCV_Proc_AXI_1_M0_AXI_ARADDR;
  wire [1:0]RISCV_Proc_AXI_1_M0_AXI_ARBURST;
  wire [3:0]RISCV_Proc_AXI_1_M0_AXI_ARCACHE;
  wire [0:0]RISCV_Proc_AXI_1_M0_AXI_ARID;
  wire [7:0]RISCV_Proc_AXI_1_M0_AXI_ARLEN;
  wire RISCV_Proc_AXI_1_M0_AXI_ARLOCK;
  wire [2:0]RISCV_Proc_AXI_1_M0_AXI_ARPROT;
  wire [3:0]RISCV_Proc_AXI_1_M0_AXI_ARQOS;
  wire [0:0]RISCV_Proc_AXI_1_M0_AXI_ARREADY;
  wire [2:0]RISCV_Proc_AXI_1_M0_AXI_ARSIZE;
  wire [0:0]RISCV_Proc_AXI_1_M0_AXI_ARUSER;
  wire RISCV_Proc_AXI_1_M0_AXI_ARVALID;
  wire [31:0]RISCV_Proc_AXI_1_M0_AXI_AWADDR;
  wire [1:0]RISCV_Proc_AXI_1_M0_AXI_AWBURST;
  wire [3:0]RISCV_Proc_AXI_1_M0_AXI_AWCACHE;
  wire [0:0]RISCV_Proc_AXI_1_M0_AXI_AWID;
  wire [7:0]RISCV_Proc_AXI_1_M0_AXI_AWLEN;
  wire RISCV_Proc_AXI_1_M0_AXI_AWLOCK;
  wire [2:0]RISCV_Proc_AXI_1_M0_AXI_AWPROT;
  wire [3:0]RISCV_Proc_AXI_1_M0_AXI_AWQOS;
  wire [0:0]RISCV_Proc_AXI_1_M0_AXI_AWREADY;
  wire [2:0]RISCV_Proc_AXI_1_M0_AXI_AWSIZE;
  wire [0:0]RISCV_Proc_AXI_1_M0_AXI_AWUSER;
  wire RISCV_Proc_AXI_1_M0_AXI_AWVALID;
  wire [1:0]RISCV_Proc_AXI_1_M0_AXI_BID;
  wire RISCV_Proc_AXI_1_M0_AXI_BREADY;
  wire [1:0]RISCV_Proc_AXI_1_M0_AXI_BRESP;
  wire [0:0]RISCV_Proc_AXI_1_M0_AXI_BUSER;
  wire [0:0]RISCV_Proc_AXI_1_M0_AXI_BVALID;
  wire [127:0]RISCV_Proc_AXI_1_M0_AXI_RDATA;
  wire [1:0]RISCV_Proc_AXI_1_M0_AXI_RID;
  wire [0:0]RISCV_Proc_AXI_1_M0_AXI_RLAST;
  wire RISCV_Proc_AXI_1_M0_AXI_RREADY;
  wire [1:0]RISCV_Proc_AXI_1_M0_AXI_RRESP;
  wire [0:0]RISCV_Proc_AXI_1_M0_AXI_RUSER;
  wire [0:0]RISCV_Proc_AXI_1_M0_AXI_RVALID;
  wire [127:0]RISCV_Proc_AXI_1_M0_AXI_WDATA;
  wire RISCV_Proc_AXI_1_M0_AXI_WLAST;
  wire [0:0]RISCV_Proc_AXI_1_M0_AXI_WREADY;
  wire [15:0]RISCV_Proc_AXI_1_M0_AXI_WSTRB;
  wire [0:0]RISCV_Proc_AXI_1_M0_AXI_WUSER;
  wire RISCV_Proc_AXI_1_M0_AXI_WVALID;
  wire [31:0]RISCV_Proc_AXI_1_M1_AXI_ARADDR;
  wire [1:0]RISCV_Proc_AXI_1_M1_AXI_ARBURST;
  wire [3:0]RISCV_Proc_AXI_1_M1_AXI_ARCACHE;
  wire [0:0]RISCV_Proc_AXI_1_M1_AXI_ARID;
  wire [7:0]RISCV_Proc_AXI_1_M1_AXI_ARLEN;
  wire RISCV_Proc_AXI_1_M1_AXI_ARLOCK;
  wire [2:0]RISCV_Proc_AXI_1_M1_AXI_ARPROT;
  wire [3:0]RISCV_Proc_AXI_1_M1_AXI_ARQOS;
  wire [0:0]RISCV_Proc_AXI_1_M1_AXI_ARREADY;
  wire [2:0]RISCV_Proc_AXI_1_M1_AXI_ARSIZE;
  wire [0:0]RISCV_Proc_AXI_1_M1_AXI_ARUSER;
  wire RISCV_Proc_AXI_1_M1_AXI_ARVALID;
  wire [31:0]RISCV_Proc_AXI_1_M1_AXI_AWADDR;
  wire [1:0]RISCV_Proc_AXI_1_M1_AXI_AWBURST;
  wire [3:0]RISCV_Proc_AXI_1_M1_AXI_AWCACHE;
  wire [0:0]RISCV_Proc_AXI_1_M1_AXI_AWID;
  wire [7:0]RISCV_Proc_AXI_1_M1_AXI_AWLEN;
  wire RISCV_Proc_AXI_1_M1_AXI_AWLOCK;
  wire [2:0]RISCV_Proc_AXI_1_M1_AXI_AWPROT;
  wire [3:0]RISCV_Proc_AXI_1_M1_AXI_AWQOS;
  wire [0:0]RISCV_Proc_AXI_1_M1_AXI_AWREADY;
  wire [2:0]RISCV_Proc_AXI_1_M1_AXI_AWSIZE;
  wire [0:0]RISCV_Proc_AXI_1_M1_AXI_AWUSER;
  wire RISCV_Proc_AXI_1_M1_AXI_AWVALID;
  wire [1:0]RISCV_Proc_AXI_1_M1_AXI_BID;
  wire RISCV_Proc_AXI_1_M1_AXI_BREADY;
  wire [1:0]RISCV_Proc_AXI_1_M1_AXI_BRESP;
  wire [0:0]RISCV_Proc_AXI_1_M1_AXI_BUSER;
  wire [0:0]RISCV_Proc_AXI_1_M1_AXI_BVALID;
  wire [127:0]RISCV_Proc_AXI_1_M1_AXI_RDATA;
  wire [1:0]RISCV_Proc_AXI_1_M1_AXI_RID;
  wire [0:0]RISCV_Proc_AXI_1_M1_AXI_RLAST;
  wire RISCV_Proc_AXI_1_M1_AXI_RREADY;
  wire [1:0]RISCV_Proc_AXI_1_M1_AXI_RRESP;
  wire [0:0]RISCV_Proc_AXI_1_M1_AXI_RUSER;
  wire [0:0]RISCV_Proc_AXI_1_M1_AXI_RVALID;
  wire [127:0]RISCV_Proc_AXI_1_M1_AXI_WDATA;
  wire RISCV_Proc_AXI_1_M1_AXI_WLAST;
  wire [0:0]RISCV_Proc_AXI_1_M1_AXI_WREADY;
  wire [15:0]RISCV_Proc_AXI_1_M1_AXI_WSTRB;
  wire [0:0]RISCV_Proc_AXI_1_M1_AXI_WUSER;
  wire RISCV_Proc_AXI_1_M1_AXI_WVALID;
  wire [31:0]Write_FIFO_0_addra;
  wire Write_FIFO_0_clka;
  wire [31:0]Write_FIFO_0_dina;
  wire Write_FIFO_0_ena;
  wire Write_FIFO_0_rsta;
  wire [3:0]Write_FIFO_0_wrea;
  wire [11:0]axi_bram_ctrl_0_BRAM_PORTA1_ADDR;
  wire axi_bram_ctrl_0_BRAM_PORTA1_CLK;
  wire [31:0]axi_bram_ctrl_0_BRAM_PORTA1_DIN;
  wire [31:0]axi_bram_ctrl_0_BRAM_PORTA1_DOUT;
  wire axi_bram_ctrl_0_BRAM_PORTA1_EN;
  wire axi_bram_ctrl_0_BRAM_PORTA1_RST;
  wire [3:0]axi_bram_ctrl_0_BRAM_PORTA1_WE;
  wire [12:0]axi_bram_ctrl_0_BRAM_PORTA_ADDR;
  wire axi_bram_ctrl_0_BRAM_PORTA_CLK;
  wire [31:0]axi_bram_ctrl_0_BRAM_PORTA_DIN;
  wire [31:0]axi_bram_ctrl_0_BRAM_PORTA_DOUT;
  wire axi_bram_ctrl_0_BRAM_PORTA_EN;
  wire axi_bram_ctrl_0_BRAM_PORTA_RST;
  wire [3:0]axi_bram_ctrl_0_BRAM_PORTA_WE;
  wire [12:0]axi_bram_ctrl_1_BRAM_PORTA_ADDR;
  wire axi_bram_ctrl_1_BRAM_PORTA_CLK;
  wire [127:0]axi_bram_ctrl_1_BRAM_PORTA_DIN;
  wire [127:0]axi_bram_ctrl_1_BRAM_PORTA_DOUT;
  wire axi_bram_ctrl_1_BRAM_PORTA_EN;
  wire axi_bram_ctrl_1_BRAM_PORTA_RST;
  wire [15:0]axi_bram_ctrl_1_BRAM_PORTA_WE;
  wire [31:0]axi_gpio_0_gpio_io_o;
  wire [31:0]axi_interconnect_0_M00_AXI_ARADDR;
  wire [1:0]axi_interconnect_0_M00_AXI_ARBURST;
  wire [3:0]axi_interconnect_0_M00_AXI_ARCACHE;
  wire [11:0]axi_interconnect_0_M00_AXI_ARID;
  wire [7:0]axi_interconnect_0_M00_AXI_ARLEN;
  wire [0:0]axi_interconnect_0_M00_AXI_ARLOCK;
  wire [2:0]axi_interconnect_0_M00_AXI_ARPROT;
  wire axi_interconnect_0_M00_AXI_ARREADY;
  wire [2:0]axi_interconnect_0_M00_AXI_ARSIZE;
  wire [0:0]axi_interconnect_0_M00_AXI_ARVALID;
  wire [31:0]axi_interconnect_0_M00_AXI_AWADDR;
  wire [1:0]axi_interconnect_0_M00_AXI_AWBURST;
  wire [3:0]axi_interconnect_0_M00_AXI_AWCACHE;
  wire [11:0]axi_interconnect_0_M00_AXI_AWID;
  wire [7:0]axi_interconnect_0_M00_AXI_AWLEN;
  wire [0:0]axi_interconnect_0_M00_AXI_AWLOCK;
  wire [2:0]axi_interconnect_0_M00_AXI_AWPROT;
  wire axi_interconnect_0_M00_AXI_AWREADY;
  wire [2:0]axi_interconnect_0_M00_AXI_AWSIZE;
  wire [0:0]axi_interconnect_0_M00_AXI_AWVALID;
  wire [11:0]axi_interconnect_0_M00_AXI_BID;
  wire [0:0]axi_interconnect_0_M00_AXI_BREADY;
  wire [1:0]axi_interconnect_0_M00_AXI_BRESP;
  wire axi_interconnect_0_M00_AXI_BVALID;
  wire [31:0]axi_interconnect_0_M00_AXI_RDATA;
  wire [11:0]axi_interconnect_0_M00_AXI_RID;
  wire axi_interconnect_0_M00_AXI_RLAST;
  wire [0:0]axi_interconnect_0_M00_AXI_RREADY;
  wire [1:0]axi_interconnect_0_M00_AXI_RRESP;
  wire axi_interconnect_0_M00_AXI_RVALID;
  wire [31:0]axi_interconnect_0_M00_AXI_WDATA;
  wire [0:0]axi_interconnect_0_M00_AXI_WLAST;
  wire axi_interconnect_0_M00_AXI_WREADY;
  wire [3:0]axi_interconnect_0_M00_AXI_WSTRB;
  wire [0:0]axi_interconnect_0_M00_AXI_WVALID;
  wire [31:0]axi_interconnect_0_M01_AXI_ARADDR;
  wire [1:0]axi_interconnect_0_M01_AXI_ARBURST;
  wire [3:0]axi_interconnect_0_M01_AXI_ARCACHE;
  wire [11:0]axi_interconnect_0_M01_AXI_ARID;
  wire [7:0]axi_interconnect_0_M01_AXI_ARLEN;
  wire [0:0]axi_interconnect_0_M01_AXI_ARLOCK;
  wire [2:0]axi_interconnect_0_M01_AXI_ARPROT;
  wire axi_interconnect_0_M01_AXI_ARREADY;
  wire [2:0]axi_interconnect_0_M01_AXI_ARSIZE;
  wire [0:0]axi_interconnect_0_M01_AXI_ARVALID;
  wire [31:0]axi_interconnect_0_M01_AXI_AWADDR;
  wire [1:0]axi_interconnect_0_M01_AXI_AWBURST;
  wire [3:0]axi_interconnect_0_M01_AXI_AWCACHE;
  wire [11:0]axi_interconnect_0_M01_AXI_AWID;
  wire [7:0]axi_interconnect_0_M01_AXI_AWLEN;
  wire [0:0]axi_interconnect_0_M01_AXI_AWLOCK;
  wire [2:0]axi_interconnect_0_M01_AXI_AWPROT;
  wire axi_interconnect_0_M01_AXI_AWREADY;
  wire [2:0]axi_interconnect_0_M01_AXI_AWSIZE;
  wire [0:0]axi_interconnect_0_M01_AXI_AWVALID;
  wire [11:0]axi_interconnect_0_M01_AXI_BID;
  wire [0:0]axi_interconnect_0_M01_AXI_BREADY;
  wire [1:0]axi_interconnect_0_M01_AXI_BRESP;
  wire axi_interconnect_0_M01_AXI_BVALID;
  wire [31:0]axi_interconnect_0_M01_AXI_RDATA;
  wire [11:0]axi_interconnect_0_M01_AXI_RID;
  wire axi_interconnect_0_M01_AXI_RLAST;
  wire [0:0]axi_interconnect_0_M01_AXI_RREADY;
  wire [1:0]axi_interconnect_0_M01_AXI_RRESP;
  wire axi_interconnect_0_M01_AXI_RVALID;
  wire [31:0]axi_interconnect_0_M01_AXI_WDATA;
  wire [0:0]axi_interconnect_0_M01_AXI_WLAST;
  wire axi_interconnect_0_M01_AXI_WREADY;
  wire [3:0]axi_interconnect_0_M01_AXI_WSTRB;
  wire [0:0]axi_interconnect_0_M01_AXI_WVALID;
  wire [31:0]axi_interconnect_0_M02_AXI_ARADDR;
  wire axi_interconnect_0_M02_AXI_ARREADY;
  wire axi_interconnect_0_M02_AXI_ARVALID;
  wire [31:0]axi_interconnect_0_M02_AXI_AWADDR;
  wire axi_interconnect_0_M02_AXI_AWREADY;
  wire axi_interconnect_0_M02_AXI_AWVALID;
  wire axi_interconnect_0_M02_AXI_BREADY;
  wire [1:0]axi_interconnect_0_M02_AXI_BRESP;
  wire axi_interconnect_0_M02_AXI_BVALID;
  wire [31:0]axi_interconnect_0_M02_AXI_RDATA;
  wire axi_interconnect_0_M02_AXI_RREADY;
  wire [1:0]axi_interconnect_0_M02_AXI_RRESP;
  wire axi_interconnect_0_M02_AXI_RVALID;
  wire [31:0]axi_interconnect_0_M02_AXI_WDATA;
  wire axi_interconnect_0_M02_AXI_WREADY;
  wire [3:0]axi_interconnect_0_M02_AXI_WSTRB;
  wire axi_interconnect_0_M02_AXI_WVALID;
  wire [31:0]axi_interconnect_1_M00_AXI_ARADDR;
  wire [1:0]axi_interconnect_1_M00_AXI_ARBURST;
  wire [3:0]axi_interconnect_1_M00_AXI_ARCACHE;
  wire [1:0]axi_interconnect_1_M00_AXI_ARID;
  wire [7:0]axi_interconnect_1_M00_AXI_ARLEN;
  wire [0:0]axi_interconnect_1_M00_AXI_ARLOCK;
  wire [2:0]axi_interconnect_1_M00_AXI_ARPROT;
  wire axi_interconnect_1_M00_AXI_ARREADY;
  wire [2:0]axi_interconnect_1_M00_AXI_ARSIZE;
  wire [0:0]axi_interconnect_1_M00_AXI_ARVALID;
  wire [31:0]axi_interconnect_1_M00_AXI_AWADDR;
  wire [1:0]axi_interconnect_1_M00_AXI_AWBURST;
  wire [3:0]axi_interconnect_1_M00_AXI_AWCACHE;
  wire [1:0]axi_interconnect_1_M00_AXI_AWID;
  wire [7:0]axi_interconnect_1_M00_AXI_AWLEN;
  wire [0:0]axi_interconnect_1_M00_AXI_AWLOCK;
  wire [2:0]axi_interconnect_1_M00_AXI_AWPROT;
  wire axi_interconnect_1_M00_AXI_AWREADY;
  wire [2:0]axi_interconnect_1_M00_AXI_AWSIZE;
  wire [0:0]axi_interconnect_1_M00_AXI_AWVALID;
  wire [1:0]axi_interconnect_1_M00_AXI_BID;
  wire [0:0]axi_interconnect_1_M00_AXI_BREADY;
  wire [1:0]axi_interconnect_1_M00_AXI_BRESP;
  wire axi_interconnect_1_M00_AXI_BVALID;
  wire [127:0]axi_interconnect_1_M00_AXI_RDATA;
  wire [1:0]axi_interconnect_1_M00_AXI_RID;
  wire axi_interconnect_1_M00_AXI_RLAST;
  wire [0:0]axi_interconnect_1_M00_AXI_RREADY;
  wire [1:0]axi_interconnect_1_M00_AXI_RRESP;
  wire axi_interconnect_1_M00_AXI_RVALID;
  wire [127:0]axi_interconnect_1_M00_AXI_WDATA;
  wire [0:0]axi_interconnect_1_M00_AXI_WLAST;
  wire axi_interconnect_1_M00_AXI_WREADY;
  wire [15:0]axi_interconnect_1_M00_AXI_WSTRB;
  wire [0:0]axi_interconnect_1_M00_AXI_WVALID;
  wire [0:0]proc_sys_reset_0_interconnect_aresetn;
  wire [14:0]processing_system7_0_DDR_ADDR;
  wire [2:0]processing_system7_0_DDR_BA;
  wire processing_system7_0_DDR_CAS_N;
  wire processing_system7_0_DDR_CKE;
  wire processing_system7_0_DDR_CK_N;
  wire processing_system7_0_DDR_CK_P;
  wire processing_system7_0_DDR_CS_N;
  wire [3:0]processing_system7_0_DDR_DM;
  wire [31:0]processing_system7_0_DDR_DQ;
  wire [3:0]processing_system7_0_DDR_DQS_N;
  wire [3:0]processing_system7_0_DDR_DQS_P;
  wire processing_system7_0_DDR_ODT;
  wire processing_system7_0_DDR_RAS_N;
  wire processing_system7_0_DDR_RESET_N;
  wire processing_system7_0_DDR_WE_N;
  wire processing_system7_0_FCLK_CLK0;
  wire processing_system7_0_FCLK_RESET0_N;
  wire processing_system7_0_FIXED_IO_DDR_VRN;
  wire processing_system7_0_FIXED_IO_DDR_VRP;
  wire [53:0]processing_system7_0_FIXED_IO_MIO;
  wire processing_system7_0_FIXED_IO_PS_CLK;
  wire processing_system7_0_FIXED_IO_PS_PORB;
  wire processing_system7_0_FIXED_IO_PS_SRSTB;
  wire [31:0]processing_system7_0_M_AXI_GP0_ARADDR;
  wire [1:0]processing_system7_0_M_AXI_GP0_ARBURST;
  wire [3:0]processing_system7_0_M_AXI_GP0_ARCACHE;
  wire [11:0]processing_system7_0_M_AXI_GP0_ARID;
  wire [3:0]processing_system7_0_M_AXI_GP0_ARLEN;
  wire [1:0]processing_system7_0_M_AXI_GP0_ARLOCK;
  wire [2:0]processing_system7_0_M_AXI_GP0_ARPROT;
  wire [3:0]processing_system7_0_M_AXI_GP0_ARQOS;
  wire processing_system7_0_M_AXI_GP0_ARREADY;
  wire [2:0]processing_system7_0_M_AXI_GP0_ARSIZE;
  wire processing_system7_0_M_AXI_GP0_ARVALID;
  wire [31:0]processing_system7_0_M_AXI_GP0_AWADDR;
  wire [1:0]processing_system7_0_M_AXI_GP0_AWBURST;
  wire [3:0]processing_system7_0_M_AXI_GP0_AWCACHE;
  wire [11:0]processing_system7_0_M_AXI_GP0_AWID;
  wire [3:0]processing_system7_0_M_AXI_GP0_AWLEN;
  wire [1:0]processing_system7_0_M_AXI_GP0_AWLOCK;
  wire [2:0]processing_system7_0_M_AXI_GP0_AWPROT;
  wire [3:0]processing_system7_0_M_AXI_GP0_AWQOS;
  wire processing_system7_0_M_AXI_GP0_AWREADY;
  wire [2:0]processing_system7_0_M_AXI_GP0_AWSIZE;
  wire processing_system7_0_M_AXI_GP0_AWVALID;
  wire [11:0]processing_system7_0_M_AXI_GP0_BID;
  wire processing_system7_0_M_AXI_GP0_BREADY;
  wire [1:0]processing_system7_0_M_AXI_GP0_BRESP;
  wire processing_system7_0_M_AXI_GP0_BVALID;
  wire [31:0]processing_system7_0_M_AXI_GP0_RDATA;
  wire [11:0]processing_system7_0_M_AXI_GP0_RID;
  wire processing_system7_0_M_AXI_GP0_RLAST;
  wire processing_system7_0_M_AXI_GP0_RREADY;
  wire [1:0]processing_system7_0_M_AXI_GP0_RRESP;
  wire processing_system7_0_M_AXI_GP0_RVALID;
  wire [31:0]processing_system7_0_M_AXI_GP0_WDATA;
  wire [11:0]processing_system7_0_M_AXI_GP0_WID;
  wire processing_system7_0_M_AXI_GP0_WLAST;
  wire processing_system7_0_M_AXI_GP0_WREADY;
  wire [3:0]processing_system7_0_M_AXI_GP0_WSTRB;
  wire processing_system7_0_M_AXI_GP0_WVALID;

  Integrated_RISCV_Proc_AXI_1_0 RISCV_Proc_AXI_1
       (.CLK(processing_system7_0_FCLK_CLK0),
        .EXT_FIFO_WR_DATA(RISCV_Proc_AXI_1_EXT_FIFO_WR_DATA),
        .EXT_FIFO_WR_ENB(RISCV_Proc_AXI_1_EXT_FIFO_WR_ENB),
        .M0_AXI_ACLK(processing_system7_0_FCLK_CLK0),
        .M0_AXI_ARADDR(RISCV_Proc_AXI_1_M0_AXI_ARADDR),
        .M0_AXI_ARBURST(RISCV_Proc_AXI_1_M0_AXI_ARBURST),
        .M0_AXI_ARCACHE(RISCV_Proc_AXI_1_M0_AXI_ARCACHE),
        .M0_AXI_ARESETN(Net1),
        .M0_AXI_ARID(RISCV_Proc_AXI_1_M0_AXI_ARID),
        .M0_AXI_ARLEN(RISCV_Proc_AXI_1_M0_AXI_ARLEN),
        .M0_AXI_ARLOCK(RISCV_Proc_AXI_1_M0_AXI_ARLOCK),
        .M0_AXI_ARPROT(RISCV_Proc_AXI_1_M0_AXI_ARPROT),
        .M0_AXI_ARQOS(RISCV_Proc_AXI_1_M0_AXI_ARQOS),
        .M0_AXI_ARREADY(RISCV_Proc_AXI_1_M0_AXI_ARREADY),
        .M0_AXI_ARSIZE(RISCV_Proc_AXI_1_M0_AXI_ARSIZE),
        .M0_AXI_ARUSER(RISCV_Proc_AXI_1_M0_AXI_ARUSER),
        .M0_AXI_ARVALID(RISCV_Proc_AXI_1_M0_AXI_ARVALID),
        .M0_AXI_AWADDR(RISCV_Proc_AXI_1_M0_AXI_AWADDR),
        .M0_AXI_AWBURST(RISCV_Proc_AXI_1_M0_AXI_AWBURST),
        .M0_AXI_AWCACHE(RISCV_Proc_AXI_1_M0_AXI_AWCACHE),
        .M0_AXI_AWID(RISCV_Proc_AXI_1_M0_AXI_AWID),
        .M0_AXI_AWLEN(RISCV_Proc_AXI_1_M0_AXI_AWLEN),
        .M0_AXI_AWLOCK(RISCV_Proc_AXI_1_M0_AXI_AWLOCK),
        .M0_AXI_AWPROT(RISCV_Proc_AXI_1_M0_AXI_AWPROT),
        .M0_AXI_AWQOS(RISCV_Proc_AXI_1_M0_AXI_AWQOS),
        .M0_AXI_AWREADY(RISCV_Proc_AXI_1_M0_AXI_AWREADY),
        .M0_AXI_AWSIZE(RISCV_Proc_AXI_1_M0_AXI_AWSIZE),
        .M0_AXI_AWUSER(RISCV_Proc_AXI_1_M0_AXI_AWUSER),
        .M0_AXI_AWVALID(RISCV_Proc_AXI_1_M0_AXI_AWVALID),
        .M0_AXI_BID(RISCV_Proc_AXI_1_M0_AXI_BID[0]),
        .M0_AXI_BREADY(RISCV_Proc_AXI_1_M0_AXI_BREADY),
        .M0_AXI_BRESP(RISCV_Proc_AXI_1_M0_AXI_BRESP),
        .M0_AXI_BUSER(RISCV_Proc_AXI_1_M0_AXI_BUSER),
        .M0_AXI_BVALID(RISCV_Proc_AXI_1_M0_AXI_BVALID),
        .M0_AXI_RDATA(RISCV_Proc_AXI_1_M0_AXI_RDATA),
        .M0_AXI_RID(RISCV_Proc_AXI_1_M0_AXI_RID[0]),
        .M0_AXI_RLAST(RISCV_Proc_AXI_1_M0_AXI_RLAST),
        .M0_AXI_RREADY(RISCV_Proc_AXI_1_M0_AXI_RREADY),
        .M0_AXI_RRESP(RISCV_Proc_AXI_1_M0_AXI_RRESP),
        .M0_AXI_RUSER(RISCV_Proc_AXI_1_M0_AXI_RUSER),
        .M0_AXI_RVALID(RISCV_Proc_AXI_1_M0_AXI_RVALID),
        .M0_AXI_WDATA(RISCV_Proc_AXI_1_M0_AXI_WDATA),
        .M0_AXI_WLAST(RISCV_Proc_AXI_1_M0_AXI_WLAST),
        .M0_AXI_WREADY(RISCV_Proc_AXI_1_M0_AXI_WREADY),
        .M0_AXI_WSTRB(RISCV_Proc_AXI_1_M0_AXI_WSTRB),
        .M0_AXI_WUSER(RISCV_Proc_AXI_1_M0_AXI_WUSER),
        .M0_AXI_WVALID(RISCV_Proc_AXI_1_M0_AXI_WVALID),
        .M1_AXI_ACLK(processing_system7_0_FCLK_CLK0),
        .M1_AXI_ARADDR(RISCV_Proc_AXI_1_M1_AXI_ARADDR),
        .M1_AXI_ARBURST(RISCV_Proc_AXI_1_M1_AXI_ARBURST),
        .M1_AXI_ARCACHE(RISCV_Proc_AXI_1_M1_AXI_ARCACHE),
        .M1_AXI_ARESETN(Net1),
        .M1_AXI_ARID(RISCV_Proc_AXI_1_M1_AXI_ARID),
        .M1_AXI_ARLEN(RISCV_Proc_AXI_1_M1_AXI_ARLEN),
        .M1_AXI_ARLOCK(RISCV_Proc_AXI_1_M1_AXI_ARLOCK),
        .M1_AXI_ARPROT(RISCV_Proc_AXI_1_M1_AXI_ARPROT),
        .M1_AXI_ARQOS(RISCV_Proc_AXI_1_M1_AXI_ARQOS),
        .M1_AXI_ARREADY(RISCV_Proc_AXI_1_M1_AXI_ARREADY),
        .M1_AXI_ARSIZE(RISCV_Proc_AXI_1_M1_AXI_ARSIZE),
        .M1_AXI_ARUSER(RISCV_Proc_AXI_1_M1_AXI_ARUSER),
        .M1_AXI_ARVALID(RISCV_Proc_AXI_1_M1_AXI_ARVALID),
        .M1_AXI_AWADDR(RISCV_Proc_AXI_1_M1_AXI_AWADDR),
        .M1_AXI_AWBURST(RISCV_Proc_AXI_1_M1_AXI_AWBURST),
        .M1_AXI_AWCACHE(RISCV_Proc_AXI_1_M1_AXI_AWCACHE),
        .M1_AXI_AWID(RISCV_Proc_AXI_1_M1_AXI_AWID),
        .M1_AXI_AWLEN(RISCV_Proc_AXI_1_M1_AXI_AWLEN),
        .M1_AXI_AWLOCK(RISCV_Proc_AXI_1_M1_AXI_AWLOCK),
        .M1_AXI_AWPROT(RISCV_Proc_AXI_1_M1_AXI_AWPROT),
        .M1_AXI_AWQOS(RISCV_Proc_AXI_1_M1_AXI_AWQOS),
        .M1_AXI_AWREADY(RISCV_Proc_AXI_1_M1_AXI_AWREADY),
        .M1_AXI_AWSIZE(RISCV_Proc_AXI_1_M1_AXI_AWSIZE),
        .M1_AXI_AWUSER(RISCV_Proc_AXI_1_M1_AXI_AWUSER),
        .M1_AXI_AWVALID(RISCV_Proc_AXI_1_M1_AXI_AWVALID),
        .M1_AXI_BID(RISCV_Proc_AXI_1_M1_AXI_BID[0]),
        .M1_AXI_BREADY(RISCV_Proc_AXI_1_M1_AXI_BREADY),
        .M1_AXI_BRESP(RISCV_Proc_AXI_1_M1_AXI_BRESP),
        .M1_AXI_BUSER(RISCV_Proc_AXI_1_M1_AXI_BUSER),
        .M1_AXI_BVALID(RISCV_Proc_AXI_1_M1_AXI_BVALID),
        .M1_AXI_RDATA(RISCV_Proc_AXI_1_M1_AXI_RDATA),
        .M1_AXI_RID(RISCV_Proc_AXI_1_M1_AXI_RID[0]),
        .M1_AXI_RLAST(RISCV_Proc_AXI_1_M1_AXI_RLAST),
        .M1_AXI_RREADY(RISCV_Proc_AXI_1_M1_AXI_RREADY),
        .M1_AXI_RRESP(RISCV_Proc_AXI_1_M1_AXI_RRESP),
        .M1_AXI_RUSER(RISCV_Proc_AXI_1_M1_AXI_RUSER),
        .M1_AXI_RVALID(RISCV_Proc_AXI_1_M1_AXI_RVALID),
        .M1_AXI_WDATA(RISCV_Proc_AXI_1_M1_AXI_WDATA),
        .M1_AXI_WLAST(RISCV_Proc_AXI_1_M1_AXI_WLAST),
        .M1_AXI_WREADY(RISCV_Proc_AXI_1_M1_AXI_WREADY),
        .M1_AXI_WSTRB(RISCV_Proc_AXI_1_M1_AXI_WSTRB),
        .M1_AXI_WUSER(RISCV_Proc_AXI_1_M1_AXI_WUSER),
        .M1_AXI_WVALID(RISCV_Proc_AXI_1_M1_AXI_WVALID),
        .P0_INIT_AXI_TXN(axi_gpio_0_gpio_io_o[0]),
        .P1_INIT_AXI_TXN(axi_gpio_0_gpio_io_o[0]));
  Integrated_Write_FIFO_0_0 Write_FIFO_0
       (.CLK(processing_system7_0_FCLK_CLK0),
        .FIFO_DATA(RISCV_Proc_AXI_1_EXT_FIFO_WR_DATA),
        .RESETN(Net1),
        .WRE(RISCV_Proc_AXI_1_EXT_FIFO_WR_ENB),
        .addra(Write_FIFO_0_addra),
        .clka(Write_FIFO_0_clka),
        .dina(Write_FIFO_0_dina),
        .ena(Write_FIFO_0_ena),
        .rsta(Write_FIFO_0_rsta),
        .wrea(Write_FIFO_0_wrea));
  (* BMM_INFO_ADDRESS_SPACE = "byte  0x42000000 32 > Integrated blk_mem_gen_EXT_RAM" *) 
  (* KEEP_HIERARCHY = "yes" *) 
  Integrated_axi_bram_ctrl_0_1 axi_bram_ctrl_EXT_RAM
       (.bram_addr_a(axi_bram_ctrl_0_BRAM_PORTA1_ADDR),
        .bram_clk_a(axi_bram_ctrl_0_BRAM_PORTA1_CLK),
        .bram_en_a(axi_bram_ctrl_0_BRAM_PORTA1_EN),
        .bram_rddata_a(axi_bram_ctrl_0_BRAM_PORTA1_DOUT),
        .bram_rst_a(axi_bram_ctrl_0_BRAM_PORTA1_RST),
        .bram_we_a(axi_bram_ctrl_0_BRAM_PORTA1_WE),
        .bram_wrdata_a(axi_bram_ctrl_0_BRAM_PORTA1_DIN),
        .s_axi_aclk(processing_system7_0_FCLK_CLK0),
        .s_axi_araddr(axi_interconnect_0_M01_AXI_ARADDR[11:0]),
        .s_axi_arburst(axi_interconnect_0_M01_AXI_ARBURST),
        .s_axi_arcache(axi_interconnect_0_M01_AXI_ARCACHE),
        .s_axi_aresetn(Net1),
        .s_axi_arid(axi_interconnect_0_M01_AXI_ARID),
        .s_axi_arlen(axi_interconnect_0_M01_AXI_ARLEN),
        .s_axi_arlock(axi_interconnect_0_M01_AXI_ARLOCK),
        .s_axi_arprot(axi_interconnect_0_M01_AXI_ARPROT),
        .s_axi_arready(axi_interconnect_0_M01_AXI_ARREADY),
        .s_axi_arsize(axi_interconnect_0_M01_AXI_ARSIZE),
        .s_axi_arvalid(axi_interconnect_0_M01_AXI_ARVALID),
        .s_axi_awaddr(axi_interconnect_0_M01_AXI_AWADDR[11:0]),
        .s_axi_awburst(axi_interconnect_0_M01_AXI_AWBURST),
        .s_axi_awcache(axi_interconnect_0_M01_AXI_AWCACHE),
        .s_axi_awid(axi_interconnect_0_M01_AXI_AWID),
        .s_axi_awlen(axi_interconnect_0_M01_AXI_AWLEN),
        .s_axi_awlock(axi_interconnect_0_M01_AXI_AWLOCK),
        .s_axi_awprot(axi_interconnect_0_M01_AXI_AWPROT),
        .s_axi_awready(axi_interconnect_0_M01_AXI_AWREADY),
        .s_axi_awsize(axi_interconnect_0_M01_AXI_AWSIZE),
        .s_axi_awvalid(axi_interconnect_0_M01_AXI_AWVALID),
        .s_axi_bid(axi_interconnect_0_M01_AXI_BID),
        .s_axi_bready(axi_interconnect_0_M01_AXI_BREADY),
        .s_axi_bresp(axi_interconnect_0_M01_AXI_BRESP),
        .s_axi_bvalid(axi_interconnect_0_M01_AXI_BVALID),
        .s_axi_rdata(axi_interconnect_0_M01_AXI_RDATA),
        .s_axi_rid(axi_interconnect_0_M01_AXI_RID),
        .s_axi_rlast(axi_interconnect_0_M01_AXI_RLAST),
        .s_axi_rready(axi_interconnect_0_M01_AXI_RREADY),
        .s_axi_rresp(axi_interconnect_0_M01_AXI_RRESP),
        .s_axi_rvalid(axi_interconnect_0_M01_AXI_RVALID),
        .s_axi_wdata(axi_interconnect_0_M01_AXI_WDATA),
        .s_axi_wlast(axi_interconnect_0_M01_AXI_WLAST),
        .s_axi_wready(axi_interconnect_0_M01_AXI_WREADY),
        .s_axi_wstrb(axi_interconnect_0_M01_AXI_WSTRB),
        .s_axi_wvalid(axi_interconnect_0_M01_AXI_WVALID));
  Integrated_axi_bram_ctrl_1_0 axi_bram_ctrl_RISCV
       (.bram_addr_a(axi_bram_ctrl_1_BRAM_PORTA_ADDR),
        .bram_clk_a(axi_bram_ctrl_1_BRAM_PORTA_CLK),
        .bram_en_a(axi_bram_ctrl_1_BRAM_PORTA_EN),
        .bram_rddata_a(axi_bram_ctrl_1_BRAM_PORTA_DOUT),
        .bram_rst_a(axi_bram_ctrl_1_BRAM_PORTA_RST),
        .bram_we_a(axi_bram_ctrl_1_BRAM_PORTA_WE),
        .bram_wrdata_a(axi_bram_ctrl_1_BRAM_PORTA_DIN),
        .s_axi_aclk(processing_system7_0_FCLK_CLK0),
        .s_axi_araddr(axi_interconnect_1_M00_AXI_ARADDR[12:0]),
        .s_axi_arburst(axi_interconnect_1_M00_AXI_ARBURST),
        .s_axi_arcache(axi_interconnect_1_M00_AXI_ARCACHE),
        .s_axi_aresetn(Net1),
        .s_axi_arid(axi_interconnect_1_M00_AXI_ARID),
        .s_axi_arlen(axi_interconnect_1_M00_AXI_ARLEN),
        .s_axi_arlock(axi_interconnect_1_M00_AXI_ARLOCK),
        .s_axi_arprot(axi_interconnect_1_M00_AXI_ARPROT),
        .s_axi_arready(axi_interconnect_1_M00_AXI_ARREADY),
        .s_axi_arsize(axi_interconnect_1_M00_AXI_ARSIZE),
        .s_axi_arvalid(axi_interconnect_1_M00_AXI_ARVALID),
        .s_axi_awaddr(axi_interconnect_1_M00_AXI_AWADDR[12:0]),
        .s_axi_awburst(axi_interconnect_1_M00_AXI_AWBURST),
        .s_axi_awcache(axi_interconnect_1_M00_AXI_AWCACHE),
        .s_axi_awid(axi_interconnect_1_M00_AXI_AWID),
        .s_axi_awlen(axi_interconnect_1_M00_AXI_AWLEN),
        .s_axi_awlock(axi_interconnect_1_M00_AXI_AWLOCK),
        .s_axi_awprot(axi_interconnect_1_M00_AXI_AWPROT),
        .s_axi_awready(axi_interconnect_1_M00_AXI_AWREADY),
        .s_axi_awsize(axi_interconnect_1_M00_AXI_AWSIZE),
        .s_axi_awvalid(axi_interconnect_1_M00_AXI_AWVALID),
        .s_axi_bid(axi_interconnect_1_M00_AXI_BID),
        .s_axi_bready(axi_interconnect_1_M00_AXI_BREADY),
        .s_axi_bresp(axi_interconnect_1_M00_AXI_BRESP),
        .s_axi_bvalid(axi_interconnect_1_M00_AXI_BVALID),
        .s_axi_rdata(axi_interconnect_1_M00_AXI_RDATA),
        .s_axi_rid(axi_interconnect_1_M00_AXI_RID),
        .s_axi_rlast(axi_interconnect_1_M00_AXI_RLAST),
        .s_axi_rready(axi_interconnect_1_M00_AXI_RREADY),
        .s_axi_rresp(axi_interconnect_1_M00_AXI_RRESP),
        .s_axi_rvalid(axi_interconnect_1_M00_AXI_RVALID),
        .s_axi_wdata(axi_interconnect_1_M00_AXI_WDATA),
        .s_axi_wlast(axi_interconnect_1_M00_AXI_WLAST),
        .s_axi_wready(axi_interconnect_1_M00_AXI_WREADY),
        .s_axi_wstrb(axi_interconnect_1_M00_AXI_WSTRB),
        .s_axi_wvalid(axi_interconnect_1_M00_AXI_WVALID));
  (* BMM_INFO_ADDRESS_SPACE = "byte  0x40010000 32 > Integrated blk_mem_gen_MAIN" *) 
  (* KEEP_HIERARCHY = "yes" *) 
  Integrated_axi_bram_ctrl_0_0 axi_bram_ctrl_Zynq
       (.bram_addr_a(axi_bram_ctrl_0_BRAM_PORTA_ADDR),
        .bram_clk_a(axi_bram_ctrl_0_BRAM_PORTA_CLK),
        .bram_en_a(axi_bram_ctrl_0_BRAM_PORTA_EN),
        .bram_rddata_a(axi_bram_ctrl_0_BRAM_PORTA_DOUT),
        .bram_rst_a(axi_bram_ctrl_0_BRAM_PORTA_RST),
        .bram_we_a(axi_bram_ctrl_0_BRAM_PORTA_WE),
        .bram_wrdata_a(axi_bram_ctrl_0_BRAM_PORTA_DIN),
        .s_axi_aclk(processing_system7_0_FCLK_CLK0),
        .s_axi_araddr(axi_interconnect_0_M00_AXI_ARADDR[12:0]),
        .s_axi_arburst(axi_interconnect_0_M00_AXI_ARBURST),
        .s_axi_arcache(axi_interconnect_0_M00_AXI_ARCACHE),
        .s_axi_aresetn(Net1),
        .s_axi_arid(axi_interconnect_0_M00_AXI_ARID),
        .s_axi_arlen(axi_interconnect_0_M00_AXI_ARLEN),
        .s_axi_arlock(axi_interconnect_0_M00_AXI_ARLOCK),
        .s_axi_arprot(axi_interconnect_0_M00_AXI_ARPROT),
        .s_axi_arready(axi_interconnect_0_M00_AXI_ARREADY),
        .s_axi_arsize(axi_interconnect_0_M00_AXI_ARSIZE),
        .s_axi_arvalid(axi_interconnect_0_M00_AXI_ARVALID),
        .s_axi_awaddr(axi_interconnect_0_M00_AXI_AWADDR[12:0]),
        .s_axi_awburst(axi_interconnect_0_M00_AXI_AWBURST),
        .s_axi_awcache(axi_interconnect_0_M00_AXI_AWCACHE),
        .s_axi_awid(axi_interconnect_0_M00_AXI_AWID),
        .s_axi_awlen(axi_interconnect_0_M00_AXI_AWLEN),
        .s_axi_awlock(axi_interconnect_0_M00_AXI_AWLOCK),
        .s_axi_awprot(axi_interconnect_0_M00_AXI_AWPROT),
        .s_axi_awready(axi_interconnect_0_M00_AXI_AWREADY),
        .s_axi_awsize(axi_interconnect_0_M00_AXI_AWSIZE),
        .s_axi_awvalid(axi_interconnect_0_M00_AXI_AWVALID),
        .s_axi_bid(axi_interconnect_0_M00_AXI_BID),
        .s_axi_bready(axi_interconnect_0_M00_AXI_BREADY),
        .s_axi_bresp(axi_interconnect_0_M00_AXI_BRESP),
        .s_axi_bvalid(axi_interconnect_0_M00_AXI_BVALID),
        .s_axi_rdata(axi_interconnect_0_M00_AXI_RDATA),
        .s_axi_rid(axi_interconnect_0_M00_AXI_RID),
        .s_axi_rlast(axi_interconnect_0_M00_AXI_RLAST),
        .s_axi_rready(axi_interconnect_0_M00_AXI_RREADY),
        .s_axi_rresp(axi_interconnect_0_M00_AXI_RRESP),
        .s_axi_rvalid(axi_interconnect_0_M00_AXI_RVALID),
        .s_axi_wdata(axi_interconnect_0_M00_AXI_WDATA),
        .s_axi_wlast(axi_interconnect_0_M00_AXI_WLAST),
        .s_axi_wready(axi_interconnect_0_M00_AXI_WREADY),
        .s_axi_wstrb(axi_interconnect_0_M00_AXI_WSTRB),
        .s_axi_wvalid(axi_interconnect_0_M00_AXI_WVALID));
  Integrated_axi_gpio_0_0 axi_gpio_Zynq
       (.gpio_io_i(Write_FIFO_0_addra),
        .gpio_io_o(axi_gpio_0_gpio_io_o),
        .s_axi_aclk(processing_system7_0_FCLK_CLK0),
        .s_axi_araddr(axi_interconnect_0_M02_AXI_ARADDR[8:0]),
        .s_axi_aresetn(Net1),
        .s_axi_arready(axi_interconnect_0_M02_AXI_ARREADY),
        .s_axi_arvalid(axi_interconnect_0_M02_AXI_ARVALID),
        .s_axi_awaddr(axi_interconnect_0_M02_AXI_AWADDR[8:0]),
        .s_axi_awready(axi_interconnect_0_M02_AXI_AWREADY),
        .s_axi_awvalid(axi_interconnect_0_M02_AXI_AWVALID),
        .s_axi_bready(axi_interconnect_0_M02_AXI_BREADY),
        .s_axi_bresp(axi_interconnect_0_M02_AXI_BRESP),
        .s_axi_bvalid(axi_interconnect_0_M02_AXI_BVALID),
        .s_axi_rdata(axi_interconnect_0_M02_AXI_RDATA),
        .s_axi_rready(axi_interconnect_0_M02_AXI_RREADY),
        .s_axi_rresp(axi_interconnect_0_M02_AXI_RRESP),
        .s_axi_rvalid(axi_interconnect_0_M02_AXI_RVALID),
        .s_axi_wdata(axi_interconnect_0_M02_AXI_WDATA),
        .s_axi_wready(axi_interconnect_0_M02_AXI_WREADY),
        .s_axi_wstrb(axi_interconnect_0_M02_AXI_WSTRB),
        .s_axi_wvalid(axi_interconnect_0_M02_AXI_WVALID));
  Integrated_axi_interconnect_0_0 axi_interconnect_0
       (.ACLK(processing_system7_0_FCLK_CLK0),
        .ARESETN(proc_sys_reset_0_interconnect_aresetn),
        .M00_ACLK(processing_system7_0_FCLK_CLK0),
        .M00_ARESETN(Net1),
        .M00_AXI_araddr(axi_interconnect_0_M00_AXI_ARADDR),
        .M00_AXI_arburst(axi_interconnect_0_M00_AXI_ARBURST),
        .M00_AXI_arcache(axi_interconnect_0_M00_AXI_ARCACHE),
        .M00_AXI_arid(axi_interconnect_0_M00_AXI_ARID),
        .M00_AXI_arlen(axi_interconnect_0_M00_AXI_ARLEN),
        .M00_AXI_arlock(axi_interconnect_0_M00_AXI_ARLOCK),
        .M00_AXI_arprot(axi_interconnect_0_M00_AXI_ARPROT),
        .M00_AXI_arready(axi_interconnect_0_M00_AXI_ARREADY),
        .M00_AXI_arsize(axi_interconnect_0_M00_AXI_ARSIZE),
        .M00_AXI_arvalid(axi_interconnect_0_M00_AXI_ARVALID),
        .M00_AXI_awaddr(axi_interconnect_0_M00_AXI_AWADDR),
        .M00_AXI_awburst(axi_interconnect_0_M00_AXI_AWBURST),
        .M00_AXI_awcache(axi_interconnect_0_M00_AXI_AWCACHE),
        .M00_AXI_awid(axi_interconnect_0_M00_AXI_AWID),
        .M00_AXI_awlen(axi_interconnect_0_M00_AXI_AWLEN),
        .M00_AXI_awlock(axi_interconnect_0_M00_AXI_AWLOCK),
        .M00_AXI_awprot(axi_interconnect_0_M00_AXI_AWPROT),
        .M00_AXI_awready(axi_interconnect_0_M00_AXI_AWREADY),
        .M00_AXI_awsize(axi_interconnect_0_M00_AXI_AWSIZE),
        .M00_AXI_awvalid(axi_interconnect_0_M00_AXI_AWVALID),
        .M00_AXI_bid(axi_interconnect_0_M00_AXI_BID),
        .M00_AXI_bready(axi_interconnect_0_M00_AXI_BREADY),
        .M00_AXI_bresp(axi_interconnect_0_M00_AXI_BRESP),
        .M00_AXI_bvalid(axi_interconnect_0_M00_AXI_BVALID),
        .M00_AXI_rdata(axi_interconnect_0_M00_AXI_RDATA),
        .M00_AXI_rid(axi_interconnect_0_M00_AXI_RID),
        .M00_AXI_rlast(axi_interconnect_0_M00_AXI_RLAST),
        .M00_AXI_rready(axi_interconnect_0_M00_AXI_RREADY),
        .M00_AXI_rresp(axi_interconnect_0_M00_AXI_RRESP),
        .M00_AXI_rvalid(axi_interconnect_0_M00_AXI_RVALID),
        .M00_AXI_wdata(axi_interconnect_0_M00_AXI_WDATA),
        .M00_AXI_wlast(axi_interconnect_0_M00_AXI_WLAST),
        .M00_AXI_wready(axi_interconnect_0_M00_AXI_WREADY),
        .M00_AXI_wstrb(axi_interconnect_0_M00_AXI_WSTRB),
        .M00_AXI_wvalid(axi_interconnect_0_M00_AXI_WVALID),
        .M01_ACLK(processing_system7_0_FCLK_CLK0),
        .M01_ARESETN(Net1),
        .M01_AXI_araddr(axi_interconnect_0_M01_AXI_ARADDR),
        .M01_AXI_arburst(axi_interconnect_0_M01_AXI_ARBURST),
        .M01_AXI_arcache(axi_interconnect_0_M01_AXI_ARCACHE),
        .M01_AXI_arid(axi_interconnect_0_M01_AXI_ARID),
        .M01_AXI_arlen(axi_interconnect_0_M01_AXI_ARLEN),
        .M01_AXI_arlock(axi_interconnect_0_M01_AXI_ARLOCK),
        .M01_AXI_arprot(axi_interconnect_0_M01_AXI_ARPROT),
        .M01_AXI_arready(axi_interconnect_0_M01_AXI_ARREADY),
        .M01_AXI_arsize(axi_interconnect_0_M01_AXI_ARSIZE),
        .M01_AXI_arvalid(axi_interconnect_0_M01_AXI_ARVALID),
        .M01_AXI_awaddr(axi_interconnect_0_M01_AXI_AWADDR),
        .M01_AXI_awburst(axi_interconnect_0_M01_AXI_AWBURST),
        .M01_AXI_awcache(axi_interconnect_0_M01_AXI_AWCACHE),
        .M01_AXI_awid(axi_interconnect_0_M01_AXI_AWID),
        .M01_AXI_awlen(axi_interconnect_0_M01_AXI_AWLEN),
        .M01_AXI_awlock(axi_interconnect_0_M01_AXI_AWLOCK),
        .M01_AXI_awprot(axi_interconnect_0_M01_AXI_AWPROT),
        .M01_AXI_awready(axi_interconnect_0_M01_AXI_AWREADY),
        .M01_AXI_awsize(axi_interconnect_0_M01_AXI_AWSIZE),
        .M01_AXI_awvalid(axi_interconnect_0_M01_AXI_AWVALID),
        .M01_AXI_bid(axi_interconnect_0_M01_AXI_BID),
        .M01_AXI_bready(axi_interconnect_0_M01_AXI_BREADY),
        .M01_AXI_bresp(axi_interconnect_0_M01_AXI_BRESP),
        .M01_AXI_bvalid(axi_interconnect_0_M01_AXI_BVALID),
        .M01_AXI_rdata(axi_interconnect_0_M01_AXI_RDATA),
        .M01_AXI_rid(axi_interconnect_0_M01_AXI_RID),
        .M01_AXI_rlast(axi_interconnect_0_M01_AXI_RLAST),
        .M01_AXI_rready(axi_interconnect_0_M01_AXI_RREADY),
        .M01_AXI_rresp(axi_interconnect_0_M01_AXI_RRESP),
        .M01_AXI_rvalid(axi_interconnect_0_M01_AXI_RVALID),
        .M01_AXI_wdata(axi_interconnect_0_M01_AXI_WDATA),
        .M01_AXI_wlast(axi_interconnect_0_M01_AXI_WLAST),
        .M01_AXI_wready(axi_interconnect_0_M01_AXI_WREADY),
        .M01_AXI_wstrb(axi_interconnect_0_M01_AXI_WSTRB),
        .M01_AXI_wvalid(axi_interconnect_0_M01_AXI_WVALID),
        .M02_ACLK(processing_system7_0_FCLK_CLK0),
        .M02_ARESETN(Net1),
        .M02_AXI_araddr(axi_interconnect_0_M02_AXI_ARADDR),
        .M02_AXI_arready(axi_interconnect_0_M02_AXI_ARREADY),
        .M02_AXI_arvalid(axi_interconnect_0_M02_AXI_ARVALID),
        .M02_AXI_awaddr(axi_interconnect_0_M02_AXI_AWADDR),
        .M02_AXI_awready(axi_interconnect_0_M02_AXI_AWREADY),
        .M02_AXI_awvalid(axi_interconnect_0_M02_AXI_AWVALID),
        .M02_AXI_bready(axi_interconnect_0_M02_AXI_BREADY),
        .M02_AXI_bresp(axi_interconnect_0_M02_AXI_BRESP),
        .M02_AXI_bvalid(axi_interconnect_0_M02_AXI_BVALID),
        .M02_AXI_rdata(axi_interconnect_0_M02_AXI_RDATA),
        .M02_AXI_rready(axi_interconnect_0_M02_AXI_RREADY),
        .M02_AXI_rresp(axi_interconnect_0_M02_AXI_RRESP),
        .M02_AXI_rvalid(axi_interconnect_0_M02_AXI_RVALID),
        .M02_AXI_wdata(axi_interconnect_0_M02_AXI_WDATA),
        .M02_AXI_wready(axi_interconnect_0_M02_AXI_WREADY),
        .M02_AXI_wstrb(axi_interconnect_0_M02_AXI_WSTRB),
        .M02_AXI_wvalid(axi_interconnect_0_M02_AXI_WVALID),
        .S00_ACLK(processing_system7_0_FCLK_CLK0),
        .S00_ARESETN(Net1),
        .S00_AXI_araddr(processing_system7_0_M_AXI_GP0_ARADDR),
        .S00_AXI_arburst(processing_system7_0_M_AXI_GP0_ARBURST),
        .S00_AXI_arcache(processing_system7_0_M_AXI_GP0_ARCACHE),
        .S00_AXI_arid(processing_system7_0_M_AXI_GP0_ARID),
        .S00_AXI_arlen(processing_system7_0_M_AXI_GP0_ARLEN),
        .S00_AXI_arlock(processing_system7_0_M_AXI_GP0_ARLOCK),
        .S00_AXI_arprot(processing_system7_0_M_AXI_GP0_ARPROT),
        .S00_AXI_arqos(processing_system7_0_M_AXI_GP0_ARQOS),
        .S00_AXI_arready(processing_system7_0_M_AXI_GP0_ARREADY),
        .S00_AXI_arsize(processing_system7_0_M_AXI_GP0_ARSIZE),
        .S00_AXI_arvalid(processing_system7_0_M_AXI_GP0_ARVALID),
        .S00_AXI_awaddr(processing_system7_0_M_AXI_GP0_AWADDR),
        .S00_AXI_awburst(processing_system7_0_M_AXI_GP0_AWBURST),
        .S00_AXI_awcache(processing_system7_0_M_AXI_GP0_AWCACHE),
        .S00_AXI_awid(processing_system7_0_M_AXI_GP0_AWID),
        .S00_AXI_awlen(processing_system7_0_M_AXI_GP0_AWLEN),
        .S00_AXI_awlock(processing_system7_0_M_AXI_GP0_AWLOCK),
        .S00_AXI_awprot(processing_system7_0_M_AXI_GP0_AWPROT),
        .S00_AXI_awqos(processing_system7_0_M_AXI_GP0_AWQOS),
        .S00_AXI_awready(processing_system7_0_M_AXI_GP0_AWREADY),
        .S00_AXI_awsize(processing_system7_0_M_AXI_GP0_AWSIZE),
        .S00_AXI_awvalid(processing_system7_0_M_AXI_GP0_AWVALID),
        .S00_AXI_bid(processing_system7_0_M_AXI_GP0_BID),
        .S00_AXI_bready(processing_system7_0_M_AXI_GP0_BREADY),
        .S00_AXI_bresp(processing_system7_0_M_AXI_GP0_BRESP),
        .S00_AXI_bvalid(processing_system7_0_M_AXI_GP0_BVALID),
        .S00_AXI_rdata(processing_system7_0_M_AXI_GP0_RDATA),
        .S00_AXI_rid(processing_system7_0_M_AXI_GP0_RID),
        .S00_AXI_rlast(processing_system7_0_M_AXI_GP0_RLAST),
        .S00_AXI_rready(processing_system7_0_M_AXI_GP0_RREADY),
        .S00_AXI_rresp(processing_system7_0_M_AXI_GP0_RRESP),
        .S00_AXI_rvalid(processing_system7_0_M_AXI_GP0_RVALID),
        .S00_AXI_wdata(processing_system7_0_M_AXI_GP0_WDATA),
        .S00_AXI_wid(processing_system7_0_M_AXI_GP0_WID),
        .S00_AXI_wlast(processing_system7_0_M_AXI_GP0_WLAST),
        .S00_AXI_wready(processing_system7_0_M_AXI_GP0_WREADY),
        .S00_AXI_wstrb(processing_system7_0_M_AXI_GP0_WSTRB),
        .S00_AXI_wvalid(processing_system7_0_M_AXI_GP0_WVALID));
  Integrated_axi_interconnect_1_0 axi_interconnect_1
       (.ACLK(processing_system7_0_FCLK_CLK0),
        .ARESETN(proc_sys_reset_0_interconnect_aresetn),
        .M00_ACLK(processing_system7_0_FCLK_CLK0),
        .M00_ARESETN(Net1),
        .M00_AXI_araddr(axi_interconnect_1_M00_AXI_ARADDR),
        .M00_AXI_arburst(axi_interconnect_1_M00_AXI_ARBURST),
        .M00_AXI_arcache(axi_interconnect_1_M00_AXI_ARCACHE),
        .M00_AXI_arid(axi_interconnect_1_M00_AXI_ARID),
        .M00_AXI_arlen(axi_interconnect_1_M00_AXI_ARLEN),
        .M00_AXI_arlock(axi_interconnect_1_M00_AXI_ARLOCK),
        .M00_AXI_arprot(axi_interconnect_1_M00_AXI_ARPROT),
        .M00_AXI_arready(axi_interconnect_1_M00_AXI_ARREADY),
        .M00_AXI_arsize(axi_interconnect_1_M00_AXI_ARSIZE),
        .M00_AXI_arvalid(axi_interconnect_1_M00_AXI_ARVALID),
        .M00_AXI_awaddr(axi_interconnect_1_M00_AXI_AWADDR),
        .M00_AXI_awburst(axi_interconnect_1_M00_AXI_AWBURST),
        .M00_AXI_awcache(axi_interconnect_1_M00_AXI_AWCACHE),
        .M00_AXI_awid(axi_interconnect_1_M00_AXI_AWID),
        .M00_AXI_awlen(axi_interconnect_1_M00_AXI_AWLEN),
        .M00_AXI_awlock(axi_interconnect_1_M00_AXI_AWLOCK),
        .M00_AXI_awprot(axi_interconnect_1_M00_AXI_AWPROT),
        .M00_AXI_awready(axi_interconnect_1_M00_AXI_AWREADY),
        .M00_AXI_awsize(axi_interconnect_1_M00_AXI_AWSIZE),
        .M00_AXI_awvalid(axi_interconnect_1_M00_AXI_AWVALID),
        .M00_AXI_bid(axi_interconnect_1_M00_AXI_BID),
        .M00_AXI_bready(axi_interconnect_1_M00_AXI_BREADY),
        .M00_AXI_bresp(axi_interconnect_1_M00_AXI_BRESP),
        .M00_AXI_bvalid(axi_interconnect_1_M00_AXI_BVALID),
        .M00_AXI_rdata(axi_interconnect_1_M00_AXI_RDATA),
        .M00_AXI_rid(axi_interconnect_1_M00_AXI_RID),
        .M00_AXI_rlast(axi_interconnect_1_M00_AXI_RLAST),
        .M00_AXI_rready(axi_interconnect_1_M00_AXI_RREADY),
        .M00_AXI_rresp(axi_interconnect_1_M00_AXI_RRESP),
        .M00_AXI_rvalid(axi_interconnect_1_M00_AXI_RVALID),
        .M00_AXI_wdata(axi_interconnect_1_M00_AXI_WDATA),
        .M00_AXI_wlast(axi_interconnect_1_M00_AXI_WLAST),
        .M00_AXI_wready(axi_interconnect_1_M00_AXI_WREADY),
        .M00_AXI_wstrb(axi_interconnect_1_M00_AXI_WSTRB),
        .M00_AXI_wvalid(axi_interconnect_1_M00_AXI_WVALID),
        .S00_ACLK(processing_system7_0_FCLK_CLK0),
        .S00_ARESETN(Net1),
        .S00_AXI_araddr(RISCV_Proc_AXI_1_M0_AXI_ARADDR),
        .S00_AXI_arburst(RISCV_Proc_AXI_1_M0_AXI_ARBURST),
        .S00_AXI_arcache(RISCV_Proc_AXI_1_M0_AXI_ARCACHE),
        .S00_AXI_arid(RISCV_Proc_AXI_1_M0_AXI_ARID),
        .S00_AXI_arlen(RISCV_Proc_AXI_1_M0_AXI_ARLEN),
        .S00_AXI_arlock(RISCV_Proc_AXI_1_M0_AXI_ARLOCK),
        .S00_AXI_arprot(RISCV_Proc_AXI_1_M0_AXI_ARPROT),
        .S00_AXI_arqos(RISCV_Proc_AXI_1_M0_AXI_ARQOS),
        .S00_AXI_arready(RISCV_Proc_AXI_1_M0_AXI_ARREADY),
        .S00_AXI_arsize(RISCV_Proc_AXI_1_M0_AXI_ARSIZE),
        .S00_AXI_aruser(RISCV_Proc_AXI_1_M0_AXI_ARUSER),
        .S00_AXI_arvalid(RISCV_Proc_AXI_1_M0_AXI_ARVALID),
        .S00_AXI_awaddr(RISCV_Proc_AXI_1_M0_AXI_AWADDR),
        .S00_AXI_awburst(RISCV_Proc_AXI_1_M0_AXI_AWBURST),
        .S00_AXI_awcache(RISCV_Proc_AXI_1_M0_AXI_AWCACHE),
        .S00_AXI_awid(RISCV_Proc_AXI_1_M0_AXI_AWID),
        .S00_AXI_awlen(RISCV_Proc_AXI_1_M0_AXI_AWLEN),
        .S00_AXI_awlock(RISCV_Proc_AXI_1_M0_AXI_AWLOCK),
        .S00_AXI_awprot(RISCV_Proc_AXI_1_M0_AXI_AWPROT),
        .S00_AXI_awqos(RISCV_Proc_AXI_1_M0_AXI_AWQOS),
        .S00_AXI_awready(RISCV_Proc_AXI_1_M0_AXI_AWREADY),
        .S00_AXI_awsize(RISCV_Proc_AXI_1_M0_AXI_AWSIZE),
        .S00_AXI_awuser(RISCV_Proc_AXI_1_M0_AXI_AWUSER),
        .S00_AXI_awvalid(RISCV_Proc_AXI_1_M0_AXI_AWVALID),
        .S00_AXI_bid(RISCV_Proc_AXI_1_M0_AXI_BID),
        .S00_AXI_bready(RISCV_Proc_AXI_1_M0_AXI_BREADY),
        .S00_AXI_bresp(RISCV_Proc_AXI_1_M0_AXI_BRESP),
        .S00_AXI_buser(RISCV_Proc_AXI_1_M0_AXI_BUSER),
        .S00_AXI_bvalid(RISCV_Proc_AXI_1_M0_AXI_BVALID),
        .S00_AXI_rdata(RISCV_Proc_AXI_1_M0_AXI_RDATA),
        .S00_AXI_rid(RISCV_Proc_AXI_1_M0_AXI_RID),
        .S00_AXI_rlast(RISCV_Proc_AXI_1_M0_AXI_RLAST),
        .S00_AXI_rready(RISCV_Proc_AXI_1_M0_AXI_RREADY),
        .S00_AXI_rresp(RISCV_Proc_AXI_1_M0_AXI_RRESP),
        .S00_AXI_ruser(RISCV_Proc_AXI_1_M0_AXI_RUSER),
        .S00_AXI_rvalid(RISCV_Proc_AXI_1_M0_AXI_RVALID),
        .S00_AXI_wdata(RISCV_Proc_AXI_1_M0_AXI_WDATA),
        .S00_AXI_wlast(RISCV_Proc_AXI_1_M0_AXI_WLAST),
        .S00_AXI_wready(RISCV_Proc_AXI_1_M0_AXI_WREADY),
        .S00_AXI_wstrb(RISCV_Proc_AXI_1_M0_AXI_WSTRB),
        .S00_AXI_wuser(RISCV_Proc_AXI_1_M0_AXI_WUSER),
        .S00_AXI_wvalid(RISCV_Proc_AXI_1_M0_AXI_WVALID),
        .S01_ACLK(processing_system7_0_FCLK_CLK0),
        .S01_ARESETN(Net1),
        .S01_AXI_araddr(RISCV_Proc_AXI_1_M1_AXI_ARADDR),
        .S01_AXI_arburst(RISCV_Proc_AXI_1_M1_AXI_ARBURST),
        .S01_AXI_arcache(RISCV_Proc_AXI_1_M1_AXI_ARCACHE),
        .S01_AXI_arid(RISCV_Proc_AXI_1_M1_AXI_ARID),
        .S01_AXI_arlen(RISCV_Proc_AXI_1_M1_AXI_ARLEN),
        .S01_AXI_arlock(RISCV_Proc_AXI_1_M1_AXI_ARLOCK),
        .S01_AXI_arprot(RISCV_Proc_AXI_1_M1_AXI_ARPROT),
        .S01_AXI_arqos(RISCV_Proc_AXI_1_M1_AXI_ARQOS),
        .S01_AXI_arready(RISCV_Proc_AXI_1_M1_AXI_ARREADY),
        .S01_AXI_arsize(RISCV_Proc_AXI_1_M1_AXI_ARSIZE),
        .S01_AXI_aruser(RISCV_Proc_AXI_1_M1_AXI_ARUSER),
        .S01_AXI_arvalid(RISCV_Proc_AXI_1_M1_AXI_ARVALID),
        .S01_AXI_awaddr(RISCV_Proc_AXI_1_M1_AXI_AWADDR),
        .S01_AXI_awburst(RISCV_Proc_AXI_1_M1_AXI_AWBURST),
        .S01_AXI_awcache(RISCV_Proc_AXI_1_M1_AXI_AWCACHE),
        .S01_AXI_awid(RISCV_Proc_AXI_1_M1_AXI_AWID),
        .S01_AXI_awlen(RISCV_Proc_AXI_1_M1_AXI_AWLEN),
        .S01_AXI_awlock(RISCV_Proc_AXI_1_M1_AXI_AWLOCK),
        .S01_AXI_awprot(RISCV_Proc_AXI_1_M1_AXI_AWPROT),
        .S01_AXI_awqos(RISCV_Proc_AXI_1_M1_AXI_AWQOS),
        .S01_AXI_awready(RISCV_Proc_AXI_1_M1_AXI_AWREADY),
        .S01_AXI_awsize(RISCV_Proc_AXI_1_M1_AXI_AWSIZE),
        .S01_AXI_awuser(RISCV_Proc_AXI_1_M1_AXI_AWUSER),
        .S01_AXI_awvalid(RISCV_Proc_AXI_1_M1_AXI_AWVALID),
        .S01_AXI_bid(RISCV_Proc_AXI_1_M1_AXI_BID),
        .S01_AXI_bready(RISCV_Proc_AXI_1_M1_AXI_BREADY),
        .S01_AXI_bresp(RISCV_Proc_AXI_1_M1_AXI_BRESP),
        .S01_AXI_buser(RISCV_Proc_AXI_1_M1_AXI_BUSER),
        .S01_AXI_bvalid(RISCV_Proc_AXI_1_M1_AXI_BVALID),
        .S01_AXI_rdata(RISCV_Proc_AXI_1_M1_AXI_RDATA),
        .S01_AXI_rid(RISCV_Proc_AXI_1_M1_AXI_RID),
        .S01_AXI_rlast(RISCV_Proc_AXI_1_M1_AXI_RLAST),
        .S01_AXI_rready(RISCV_Proc_AXI_1_M1_AXI_RREADY),
        .S01_AXI_rresp(RISCV_Proc_AXI_1_M1_AXI_RRESP),
        .S01_AXI_ruser(RISCV_Proc_AXI_1_M1_AXI_RUSER),
        .S01_AXI_rvalid(RISCV_Proc_AXI_1_M1_AXI_RVALID),
        .S01_AXI_wdata(RISCV_Proc_AXI_1_M1_AXI_WDATA),
        .S01_AXI_wlast(RISCV_Proc_AXI_1_M1_AXI_WLAST),
        .S01_AXI_wready(RISCV_Proc_AXI_1_M1_AXI_WREADY),
        .S01_AXI_wstrb(RISCV_Proc_AXI_1_M1_AXI_WSTRB),
        .S01_AXI_wuser(RISCV_Proc_AXI_1_M1_AXI_WUSER),
        .S01_AXI_wvalid(RISCV_Proc_AXI_1_M1_AXI_WVALID));
  Integrated_blk_mem_gen_1_0 blk_mem_gen_EXT_RAM
       (.addra(Write_FIFO_0_addra),
        .addrb({1'b0,1'b0,1'b0,1'b0,1'b0,1'b0,1'b0,1'b0,1'b0,1'b0,1'b0,1'b0,1'b0,1'b0,1'b0,1'b0,1'b0,1'b0,1'b0,1'b0,axi_bram_ctrl_0_BRAM_PORTA1_ADDR}),
        .clka(Write_FIFO_0_clka),
        .clkb(axi_bram_ctrl_0_BRAM_PORTA1_CLK),
        .dina(Write_FIFO_0_dina),
        .dinb(axi_bram_ctrl_0_BRAM_PORTA1_DIN),
        .doutb(axi_bram_ctrl_0_BRAM_PORTA1_DOUT),
        .ena(Write_FIFO_0_ena),
        .enb(axi_bram_ctrl_0_BRAM_PORTA1_EN),
        .rsta(Write_FIFO_0_rsta),
        .rstb(axi_bram_ctrl_0_BRAM_PORTA1_RST),
        .wea(Write_FIFO_0_wrea),
        .web(axi_bram_ctrl_0_BRAM_PORTA1_WE));
  Integrated_blk_mem_gen_0_0 blk_mem_gen_MAIN
       (.addra({1'b0,1'b0,1'b0,1'b0,1'b0,1'b0,1'b0,1'b0,1'b0,1'b0,1'b0,1'b0,1'b0,1'b0,1'b0,1'b0,1'b0,1'b0,1'b0,axi_bram_ctrl_1_BRAM_PORTA_ADDR}),
        .addrb({1'b0,1'b0,1'b0,1'b0,1'b0,1'b0,1'b0,1'b0,1'b0,1'b0,1'b0,1'b0,1'b0,1'b0,1'b0,1'b0,1'b0,1'b0,1'b0,axi_bram_ctrl_0_BRAM_PORTA_ADDR}),
        .clka(axi_bram_ctrl_1_BRAM_PORTA_CLK),
        .clkb(axi_bram_ctrl_0_BRAM_PORTA_CLK),
        .dina(axi_bram_ctrl_1_BRAM_PORTA_DIN),
        .dinb(axi_bram_ctrl_0_BRAM_PORTA_DIN),
        .douta(axi_bram_ctrl_1_BRAM_PORTA_DOUT),
        .doutb(axi_bram_ctrl_0_BRAM_PORTA_DOUT),
        .ena(axi_bram_ctrl_1_BRAM_PORTA_EN),
        .enb(axi_bram_ctrl_0_BRAM_PORTA_EN),
        .rsta(axi_bram_ctrl_1_BRAM_PORTA_RST),
        .rstb(axi_bram_ctrl_0_BRAM_PORTA_RST),
        .wea(axi_bram_ctrl_1_BRAM_PORTA_WE),
        .web(axi_bram_ctrl_0_BRAM_PORTA_WE));
  Integrated_proc_sys_reset_0_0 proc_sys_reset_0
       (.aux_reset_in(1'b1),
        .dcm_locked(1'b1),
        .ext_reset_in(processing_system7_0_FCLK_RESET0_N),
        .interconnect_aresetn(proc_sys_reset_0_interconnect_aresetn),
        .mb_debug_sys_rst(1'b0),
        .peripheral_aresetn(Net1),
        .slowest_sync_clk(processing_system7_0_FCLK_CLK0));
  (* BMM_INFO_PROCESSOR = "arm > Integrated axi_bram_ctrl_Zynq Integrated axi_bram_ctrl_EXT_RAM" *) 
  (* KEEP_HIERARCHY = "yes" *) 
  Integrated_processing_system7_0_1 processing_system7_0
       (.DDR_Addr(DDR_addr[14:0]),
        .DDR_BankAddr(DDR_ba[2:0]),
        .DDR_CAS_n(DDR_cas_n),
        .DDR_CKE(DDR_cke),
        .DDR_CS_n(DDR_cs_n),
        .DDR_Clk(DDR_ck_p),
        .DDR_Clk_n(DDR_ck_n),
        .DDR_DM(DDR_dm[3:0]),
        .DDR_DQ(DDR_dq[31:0]),
        .DDR_DQS(DDR_dqs_p[3:0]),
        .DDR_DQS_n(DDR_dqs_n[3:0]),
        .DDR_DRSTB(DDR_reset_n),
        .DDR_ODT(DDR_odt),
        .DDR_RAS_n(DDR_ras_n),
        .DDR_VRN(FIXED_IO_ddr_vrn),
        .DDR_VRP(FIXED_IO_ddr_vrp),
        .DDR_WEB(DDR_we_n),
        .FCLK_CLK0(processing_system7_0_FCLK_CLK0),
        .FCLK_RESET0_N(processing_system7_0_FCLK_RESET0_N),
        .MIO(FIXED_IO_mio[53:0]),
        .M_AXI_GP0_ACLK(processing_system7_0_FCLK_CLK0),
        .M_AXI_GP0_ARADDR(processing_system7_0_M_AXI_GP0_ARADDR),
        .M_AXI_GP0_ARBURST(processing_system7_0_M_AXI_GP0_ARBURST),
        .M_AXI_GP0_ARCACHE(processing_system7_0_M_AXI_GP0_ARCACHE),
        .M_AXI_GP0_ARID(processing_system7_0_M_AXI_GP0_ARID),
        .M_AXI_GP0_ARLEN(processing_system7_0_M_AXI_GP0_ARLEN),
        .M_AXI_GP0_ARLOCK(processing_system7_0_M_AXI_GP0_ARLOCK),
        .M_AXI_GP0_ARPROT(processing_system7_0_M_AXI_GP0_ARPROT),
        .M_AXI_GP0_ARQOS(processing_system7_0_M_AXI_GP0_ARQOS),
        .M_AXI_GP0_ARREADY(processing_system7_0_M_AXI_GP0_ARREADY),
        .M_AXI_GP0_ARSIZE(processing_system7_0_M_AXI_GP0_ARSIZE),
        .M_AXI_GP0_ARVALID(processing_system7_0_M_AXI_GP0_ARVALID),
        .M_AXI_GP0_AWADDR(processing_system7_0_M_AXI_GP0_AWADDR),
        .M_AXI_GP0_AWBURST(processing_system7_0_M_AXI_GP0_AWBURST),
        .M_AXI_GP0_AWCACHE(processing_system7_0_M_AXI_GP0_AWCACHE),
        .M_AXI_GP0_AWID(processing_system7_0_M_AXI_GP0_AWID),
        .M_AXI_GP0_AWLEN(processing_system7_0_M_AXI_GP0_AWLEN),
        .M_AXI_GP0_AWLOCK(processing_system7_0_M_AXI_GP0_AWLOCK),
        .M_AXI_GP0_AWPROT(processing_system7_0_M_AXI_GP0_AWPROT),
        .M_AXI_GP0_AWQOS(processing_system7_0_M_AXI_GP0_AWQOS),
        .M_AXI_GP0_AWREADY(processing_system7_0_M_AXI_GP0_AWREADY),
        .M_AXI_GP0_AWSIZE(processing_system7_0_M_AXI_GP0_AWSIZE),
        .M_AXI_GP0_AWVALID(processing_system7_0_M_AXI_GP0_AWVALID),
        .M_AXI_GP0_BID(processing_system7_0_M_AXI_GP0_BID),
        .M_AXI_GP0_BREADY(processing_system7_0_M_AXI_GP0_BREADY),
        .M_AXI_GP0_BRESP(processing_system7_0_M_AXI_GP0_BRESP),
        .M_AXI_GP0_BVALID(processing_system7_0_M_AXI_GP0_BVALID),
        .M_AXI_GP0_RDATA(processing_system7_0_M_AXI_GP0_RDATA),
        .M_AXI_GP0_RID(processing_system7_0_M_AXI_GP0_RID),
        .M_AXI_GP0_RLAST(processing_system7_0_M_AXI_GP0_RLAST),
        .M_AXI_GP0_RREADY(processing_system7_0_M_AXI_GP0_RREADY),
        .M_AXI_GP0_RRESP(processing_system7_0_M_AXI_GP0_RRESP),
        .M_AXI_GP0_RVALID(processing_system7_0_M_AXI_GP0_RVALID),
        .M_AXI_GP0_WDATA(processing_system7_0_M_AXI_GP0_WDATA),
        .M_AXI_GP0_WID(processing_system7_0_M_AXI_GP0_WID),
        .M_AXI_GP0_WLAST(processing_system7_0_M_AXI_GP0_WLAST),
        .M_AXI_GP0_WREADY(processing_system7_0_M_AXI_GP0_WREADY),
        .M_AXI_GP0_WSTRB(processing_system7_0_M_AXI_GP0_WSTRB),
        .M_AXI_GP0_WVALID(processing_system7_0_M_AXI_GP0_WVALID),
        .PS_CLK(FIXED_IO_ps_clk),
        .PS_PORB(FIXED_IO_ps_porb),
        .PS_SRSTB(FIXED_IO_ps_srstb));
endmodule

module Integrated_axi_interconnect_0_0
   (ACLK,
    ARESETN,
    M00_ACLK,
    M00_ARESETN,
    M00_AXI_araddr,
    M00_AXI_arburst,
    M00_AXI_arcache,
    M00_AXI_arid,
    M00_AXI_arlen,
    M00_AXI_arlock,
    M00_AXI_arprot,
    M00_AXI_arready,
    M00_AXI_arsize,
    M00_AXI_arvalid,
    M00_AXI_awaddr,
    M00_AXI_awburst,
    M00_AXI_awcache,
    M00_AXI_awid,
    M00_AXI_awlen,
    M00_AXI_awlock,
    M00_AXI_awprot,
    M00_AXI_awready,
    M00_AXI_awsize,
    M00_AXI_awvalid,
    M00_AXI_bid,
    M00_AXI_bready,
    M00_AXI_bresp,
    M00_AXI_bvalid,
    M00_AXI_rdata,
    M00_AXI_rid,
    M00_AXI_rlast,
    M00_AXI_rready,
    M00_AXI_rresp,
    M00_AXI_rvalid,
    M00_AXI_wdata,
    M00_AXI_wlast,
    M00_AXI_wready,
    M00_AXI_wstrb,
    M00_AXI_wvalid,
    M01_ACLK,
    M01_ARESETN,
    M01_AXI_araddr,
    M01_AXI_arburst,
    M01_AXI_arcache,
    M01_AXI_arid,
    M01_AXI_arlen,
    M01_AXI_arlock,
    M01_AXI_arprot,
    M01_AXI_arready,
    M01_AXI_arsize,
    M01_AXI_arvalid,
    M01_AXI_awaddr,
    M01_AXI_awburst,
    M01_AXI_awcache,
    M01_AXI_awid,
    M01_AXI_awlen,
    M01_AXI_awlock,
    M01_AXI_awprot,
    M01_AXI_awready,
    M01_AXI_awsize,
    M01_AXI_awvalid,
    M01_AXI_bid,
    M01_AXI_bready,
    M01_AXI_bresp,
    M01_AXI_bvalid,
    M01_AXI_rdata,
    M01_AXI_rid,
    M01_AXI_rlast,
    M01_AXI_rready,
    M01_AXI_rresp,
    M01_AXI_rvalid,
    M01_AXI_wdata,
    M01_AXI_wlast,
    M01_AXI_wready,
    M01_AXI_wstrb,
    M01_AXI_wvalid,
    M02_ACLK,
    M02_ARESETN,
    M02_AXI_araddr,
    M02_AXI_arready,
    M02_AXI_arvalid,
    M02_AXI_awaddr,
    M02_AXI_awready,
    M02_AXI_awvalid,
    M02_AXI_bready,
    M02_AXI_bresp,
    M02_AXI_bvalid,
    M02_AXI_rdata,
    M02_AXI_rready,
    M02_AXI_rresp,
    M02_AXI_rvalid,
    M02_AXI_wdata,
    M02_AXI_wready,
    M02_AXI_wstrb,
    M02_AXI_wvalid,
    S00_ACLK,
    S00_ARESETN,
    S00_AXI_araddr,
    S00_AXI_arburst,
    S00_AXI_arcache,
    S00_AXI_arid,
    S00_AXI_arlen,
    S00_AXI_arlock,
    S00_AXI_arprot,
    S00_AXI_arqos,
    S00_AXI_arready,
    S00_AXI_arsize,
    S00_AXI_arvalid,
    S00_AXI_awaddr,
    S00_AXI_awburst,
    S00_AXI_awcache,
    S00_AXI_awid,
    S00_AXI_awlen,
    S00_AXI_awlock,
    S00_AXI_awprot,
    S00_AXI_awqos,
    S00_AXI_awready,
    S00_AXI_awsize,
    S00_AXI_awvalid,
    S00_AXI_bid,
    S00_AXI_bready,
    S00_AXI_bresp,
    S00_AXI_bvalid,
    S00_AXI_rdata,
    S00_AXI_rid,
    S00_AXI_rlast,
    S00_AXI_rready,
    S00_AXI_rresp,
    S00_AXI_rvalid,
    S00_AXI_wdata,
    S00_AXI_wid,
    S00_AXI_wlast,
    S00_AXI_wready,
    S00_AXI_wstrb,
    S00_AXI_wvalid);
  input ACLK;
  input ARESETN;
  input M00_ACLK;
  input M00_ARESETN;
  output [31:0]M00_AXI_araddr;
  output [1:0]M00_AXI_arburst;
  output [3:0]M00_AXI_arcache;
  output [11:0]M00_AXI_arid;
  output [7:0]M00_AXI_arlen;
  output [0:0]M00_AXI_arlock;
  output [2:0]M00_AXI_arprot;
  input [0:0]M00_AXI_arready;
  output [2:0]M00_AXI_arsize;
  output [0:0]M00_AXI_arvalid;
  output [31:0]M00_AXI_awaddr;
  output [1:0]M00_AXI_awburst;
  output [3:0]M00_AXI_awcache;
  output [11:0]M00_AXI_awid;
  output [7:0]M00_AXI_awlen;
  output [0:0]M00_AXI_awlock;
  output [2:0]M00_AXI_awprot;
  input [0:0]M00_AXI_awready;
  output [2:0]M00_AXI_awsize;
  output [0:0]M00_AXI_awvalid;
  input [11:0]M00_AXI_bid;
  output [0:0]M00_AXI_bready;
  input [1:0]M00_AXI_bresp;
  input [0:0]M00_AXI_bvalid;
  input [31:0]M00_AXI_rdata;
  input [11:0]M00_AXI_rid;
  input [0:0]M00_AXI_rlast;
  output [0:0]M00_AXI_rready;
  input [1:0]M00_AXI_rresp;
  input [0:0]M00_AXI_rvalid;
  output [31:0]M00_AXI_wdata;
  output [0:0]M00_AXI_wlast;
  input [0:0]M00_AXI_wready;
  output [3:0]M00_AXI_wstrb;
  output [0:0]M00_AXI_wvalid;
  input M01_ACLK;
  input M01_ARESETN;
  output [31:0]M01_AXI_araddr;
  output [1:0]M01_AXI_arburst;
  output [3:0]M01_AXI_arcache;
  output [11:0]M01_AXI_arid;
  output [7:0]M01_AXI_arlen;
  output [0:0]M01_AXI_arlock;
  output [2:0]M01_AXI_arprot;
  input [0:0]M01_AXI_arready;
  output [2:0]M01_AXI_arsize;
  output [0:0]M01_AXI_arvalid;
  output [31:0]M01_AXI_awaddr;
  output [1:0]M01_AXI_awburst;
  output [3:0]M01_AXI_awcache;
  output [11:0]M01_AXI_awid;
  output [7:0]M01_AXI_awlen;
  output [0:0]M01_AXI_awlock;
  output [2:0]M01_AXI_awprot;
  input [0:0]M01_AXI_awready;
  output [2:0]M01_AXI_awsize;
  output [0:0]M01_AXI_awvalid;
  input [11:0]M01_AXI_bid;
  output [0:0]M01_AXI_bready;
  input [1:0]M01_AXI_bresp;
  input [0:0]M01_AXI_bvalid;
  input [31:0]M01_AXI_rdata;
  input [11:0]M01_AXI_rid;
  input [0:0]M01_AXI_rlast;
  output [0:0]M01_AXI_rready;
  input [1:0]M01_AXI_rresp;
  input [0:0]M01_AXI_rvalid;
  output [31:0]M01_AXI_wdata;
  output [0:0]M01_AXI_wlast;
  input [0:0]M01_AXI_wready;
  output [3:0]M01_AXI_wstrb;
  output [0:0]M01_AXI_wvalid;
  input M02_ACLK;
  input M02_ARESETN;
  output [31:0]M02_AXI_araddr;
  input M02_AXI_arready;
  output M02_AXI_arvalid;
  output [31:0]M02_AXI_awaddr;
  input M02_AXI_awready;
  output M02_AXI_awvalid;
  output M02_AXI_bready;
  input [1:0]M02_AXI_bresp;
  input M02_AXI_bvalid;
  input [31:0]M02_AXI_rdata;
  output M02_AXI_rready;
  input [1:0]M02_AXI_rresp;
  input M02_AXI_rvalid;
  output [31:0]M02_AXI_wdata;
  input M02_AXI_wready;
  output [3:0]M02_AXI_wstrb;
  output M02_AXI_wvalid;
  input S00_ACLK;
  input S00_ARESETN;
  input [31:0]S00_AXI_araddr;
  input [1:0]S00_AXI_arburst;
  input [3:0]S00_AXI_arcache;
  input [11:0]S00_AXI_arid;
  input [3:0]S00_AXI_arlen;
  input [1:0]S00_AXI_arlock;
  input [2:0]S00_AXI_arprot;
  input [3:0]S00_AXI_arqos;
  output S00_AXI_arready;
  input [2:0]S00_AXI_arsize;
  input S00_AXI_arvalid;
  input [31:0]S00_AXI_awaddr;
  input [1:0]S00_AXI_awburst;
  input [3:0]S00_AXI_awcache;
  input [11:0]S00_AXI_awid;
  input [3:0]S00_AXI_awlen;
  input [1:0]S00_AXI_awlock;
  input [2:0]S00_AXI_awprot;
  input [3:0]S00_AXI_awqos;
  output S00_AXI_awready;
  input [2:0]S00_AXI_awsize;
  input S00_AXI_awvalid;
  output [11:0]S00_AXI_bid;
  input S00_AXI_bready;
  output [1:0]S00_AXI_bresp;
  output S00_AXI_bvalid;
  output [31:0]S00_AXI_rdata;
  output [11:0]S00_AXI_rid;
  output S00_AXI_rlast;
  input S00_AXI_rready;
  output [1:0]S00_AXI_rresp;
  output S00_AXI_rvalid;
  input [31:0]S00_AXI_wdata;
  input [11:0]S00_AXI_wid;
  input S00_AXI_wlast;
  output S00_AXI_wready;
  input [3:0]S00_AXI_wstrb;
  input S00_AXI_wvalid;

  wire M00_ACLK_1;
  wire M00_ARESETN_1;
  wire M01_ACLK_1;
  wire M01_ARESETN_1;
  wire M02_ACLK_1;
  wire M02_ARESETN_1;
  wire S00_ACLK_1;
  wire S00_ARESETN_1;
  wire axi_interconnect_0_ACLK_net;
  wire axi_interconnect_0_ARESETN_net;
  wire [31:0]axi_interconnect_0_to_s00_couplers_ARADDR;
  wire [1:0]axi_interconnect_0_to_s00_couplers_ARBURST;
  wire [3:0]axi_interconnect_0_to_s00_couplers_ARCACHE;
  wire [11:0]axi_interconnect_0_to_s00_couplers_ARID;
  wire [3:0]axi_interconnect_0_to_s00_couplers_ARLEN;
  wire [1:0]axi_interconnect_0_to_s00_couplers_ARLOCK;
  wire [2:0]axi_interconnect_0_to_s00_couplers_ARPROT;
  wire [3:0]axi_interconnect_0_to_s00_couplers_ARQOS;
  wire axi_interconnect_0_to_s00_couplers_ARREADY;
  wire [2:0]axi_interconnect_0_to_s00_couplers_ARSIZE;
  wire axi_interconnect_0_to_s00_couplers_ARVALID;
  wire [31:0]axi_interconnect_0_to_s00_couplers_AWADDR;
  wire [1:0]axi_interconnect_0_to_s00_couplers_AWBURST;
  wire [3:0]axi_interconnect_0_to_s00_couplers_AWCACHE;
  wire [11:0]axi_interconnect_0_to_s00_couplers_AWID;
  wire [3:0]axi_interconnect_0_to_s00_couplers_AWLEN;
  wire [1:0]axi_interconnect_0_to_s00_couplers_AWLOCK;
  wire [2:0]axi_interconnect_0_to_s00_couplers_AWPROT;
  wire [3:0]axi_interconnect_0_to_s00_couplers_AWQOS;
  wire axi_interconnect_0_to_s00_couplers_AWREADY;
  wire [2:0]axi_interconnect_0_to_s00_couplers_AWSIZE;
  wire axi_interconnect_0_to_s00_couplers_AWVALID;
  wire [11:0]axi_interconnect_0_to_s00_couplers_BID;
  wire axi_interconnect_0_to_s00_couplers_BREADY;
  wire [1:0]axi_interconnect_0_to_s00_couplers_BRESP;
  wire axi_interconnect_0_to_s00_couplers_BVALID;
  wire [31:0]axi_interconnect_0_to_s00_couplers_RDATA;
  wire [11:0]axi_interconnect_0_to_s00_couplers_RID;
  wire axi_interconnect_0_to_s00_couplers_RLAST;
  wire axi_interconnect_0_to_s00_couplers_RREADY;
  wire [1:0]axi_interconnect_0_to_s00_couplers_RRESP;
  wire axi_interconnect_0_to_s00_couplers_RVALID;
  wire [31:0]axi_interconnect_0_to_s00_couplers_WDATA;
  wire [11:0]axi_interconnect_0_to_s00_couplers_WID;
  wire axi_interconnect_0_to_s00_couplers_WLAST;
  wire axi_interconnect_0_to_s00_couplers_WREADY;
  wire [3:0]axi_interconnect_0_to_s00_couplers_WSTRB;
  wire axi_interconnect_0_to_s00_couplers_WVALID;
  wire [31:0]m00_couplers_to_axi_interconnect_0_ARADDR;
  wire [1:0]m00_couplers_to_axi_interconnect_0_ARBURST;
  wire [3:0]m00_couplers_to_axi_interconnect_0_ARCACHE;
  wire [11:0]m00_couplers_to_axi_interconnect_0_ARID;
  wire [7:0]m00_couplers_to_axi_interconnect_0_ARLEN;
  wire [0:0]m00_couplers_to_axi_interconnect_0_ARLOCK;
  wire [2:0]m00_couplers_to_axi_interconnect_0_ARPROT;
  wire [0:0]m00_couplers_to_axi_interconnect_0_ARREADY;
  wire [2:0]m00_couplers_to_axi_interconnect_0_ARSIZE;
  wire [0:0]m00_couplers_to_axi_interconnect_0_ARVALID;
  wire [31:0]m00_couplers_to_axi_interconnect_0_AWADDR;
  wire [1:0]m00_couplers_to_axi_interconnect_0_AWBURST;
  wire [3:0]m00_couplers_to_axi_interconnect_0_AWCACHE;
  wire [11:0]m00_couplers_to_axi_interconnect_0_AWID;
  wire [7:0]m00_couplers_to_axi_interconnect_0_AWLEN;
  wire [0:0]m00_couplers_to_axi_interconnect_0_AWLOCK;
  wire [2:0]m00_couplers_to_axi_interconnect_0_AWPROT;
  wire [0:0]m00_couplers_to_axi_interconnect_0_AWREADY;
  wire [2:0]m00_couplers_to_axi_interconnect_0_AWSIZE;
  wire [0:0]m00_couplers_to_axi_interconnect_0_AWVALID;
  wire [11:0]m00_couplers_to_axi_interconnect_0_BID;
  wire [0:0]m00_couplers_to_axi_interconnect_0_BREADY;
  wire [1:0]m00_couplers_to_axi_interconnect_0_BRESP;
  wire [0:0]m00_couplers_to_axi_interconnect_0_BVALID;
  wire [31:0]m00_couplers_to_axi_interconnect_0_RDATA;
  wire [11:0]m00_couplers_to_axi_interconnect_0_RID;
  wire [0:0]m00_couplers_to_axi_interconnect_0_RLAST;
  wire [0:0]m00_couplers_to_axi_interconnect_0_RREADY;
  wire [1:0]m00_couplers_to_axi_interconnect_0_RRESP;
  wire [0:0]m00_couplers_to_axi_interconnect_0_RVALID;
  wire [31:0]m00_couplers_to_axi_interconnect_0_WDATA;
  wire [0:0]m00_couplers_to_axi_interconnect_0_WLAST;
  wire [0:0]m00_couplers_to_axi_interconnect_0_WREADY;
  wire [3:0]m00_couplers_to_axi_interconnect_0_WSTRB;
  wire [0:0]m00_couplers_to_axi_interconnect_0_WVALID;
  wire [31:0]m01_couplers_to_axi_interconnect_0_ARADDR;
  wire [1:0]m01_couplers_to_axi_interconnect_0_ARBURST;
  wire [3:0]m01_couplers_to_axi_interconnect_0_ARCACHE;
  wire [11:0]m01_couplers_to_axi_interconnect_0_ARID;
  wire [7:0]m01_couplers_to_axi_interconnect_0_ARLEN;
  wire [0:0]m01_couplers_to_axi_interconnect_0_ARLOCK;
  wire [2:0]m01_couplers_to_axi_interconnect_0_ARPROT;
  wire [0:0]m01_couplers_to_axi_interconnect_0_ARREADY;
  wire [2:0]m01_couplers_to_axi_interconnect_0_ARSIZE;
  wire [0:0]m01_couplers_to_axi_interconnect_0_ARVALID;
  wire [31:0]m01_couplers_to_axi_interconnect_0_AWADDR;
  wire [1:0]m01_couplers_to_axi_interconnect_0_AWBURST;
  wire [3:0]m01_couplers_to_axi_interconnect_0_AWCACHE;
  wire [11:0]m01_couplers_to_axi_interconnect_0_AWID;
  wire [7:0]m01_couplers_to_axi_interconnect_0_AWLEN;
  wire [0:0]m01_couplers_to_axi_interconnect_0_AWLOCK;
  wire [2:0]m01_couplers_to_axi_interconnect_0_AWPROT;
  wire [0:0]m01_couplers_to_axi_interconnect_0_AWREADY;
  wire [2:0]m01_couplers_to_axi_interconnect_0_AWSIZE;
  wire [0:0]m01_couplers_to_axi_interconnect_0_AWVALID;
  wire [11:0]m01_couplers_to_axi_interconnect_0_BID;
  wire [0:0]m01_couplers_to_axi_interconnect_0_BREADY;
  wire [1:0]m01_couplers_to_axi_interconnect_0_BRESP;
  wire [0:0]m01_couplers_to_axi_interconnect_0_BVALID;
  wire [31:0]m01_couplers_to_axi_interconnect_0_RDATA;
  wire [11:0]m01_couplers_to_axi_interconnect_0_RID;
  wire [0:0]m01_couplers_to_axi_interconnect_0_RLAST;
  wire [0:0]m01_couplers_to_axi_interconnect_0_RREADY;
  wire [1:0]m01_couplers_to_axi_interconnect_0_RRESP;
  wire [0:0]m01_couplers_to_axi_interconnect_0_RVALID;
  wire [31:0]m01_couplers_to_axi_interconnect_0_WDATA;
  wire [0:0]m01_couplers_to_axi_interconnect_0_WLAST;
  wire [0:0]m01_couplers_to_axi_interconnect_0_WREADY;
  wire [3:0]m01_couplers_to_axi_interconnect_0_WSTRB;
  wire [0:0]m01_couplers_to_axi_interconnect_0_WVALID;
  wire [31:0]m02_couplers_to_axi_interconnect_0_ARADDR;
  wire m02_couplers_to_axi_interconnect_0_ARREADY;
  wire m02_couplers_to_axi_interconnect_0_ARVALID;
  wire [31:0]m02_couplers_to_axi_interconnect_0_AWADDR;
  wire m02_couplers_to_axi_interconnect_0_AWREADY;
  wire m02_couplers_to_axi_interconnect_0_AWVALID;
  wire m02_couplers_to_axi_interconnect_0_BREADY;
  wire [1:0]m02_couplers_to_axi_interconnect_0_BRESP;
  wire m02_couplers_to_axi_interconnect_0_BVALID;
  wire [31:0]m02_couplers_to_axi_interconnect_0_RDATA;
  wire m02_couplers_to_axi_interconnect_0_RREADY;
  wire [1:0]m02_couplers_to_axi_interconnect_0_RRESP;
  wire m02_couplers_to_axi_interconnect_0_RVALID;
  wire [31:0]m02_couplers_to_axi_interconnect_0_WDATA;
  wire m02_couplers_to_axi_interconnect_0_WREADY;
  wire [3:0]m02_couplers_to_axi_interconnect_0_WSTRB;
  wire m02_couplers_to_axi_interconnect_0_WVALID;
  wire [31:0]s00_couplers_to_xbar_ARADDR;
  wire [1:0]s00_couplers_to_xbar_ARBURST;
  wire [3:0]s00_couplers_to_xbar_ARCACHE;
  wire [11:0]s00_couplers_to_xbar_ARID;
  wire [7:0]s00_couplers_to_xbar_ARLEN;
  wire [0:0]s00_couplers_to_xbar_ARLOCK;
  wire [2:0]s00_couplers_to_xbar_ARPROT;
  wire [3:0]s00_couplers_to_xbar_ARQOS;
  wire [0:0]s00_couplers_to_xbar_ARREADY;
  wire [2:0]s00_couplers_to_xbar_ARSIZE;
  wire s00_couplers_to_xbar_ARVALID;
  wire [31:0]s00_couplers_to_xbar_AWADDR;
  wire [1:0]s00_couplers_to_xbar_AWBURST;
  wire [3:0]s00_couplers_to_xbar_AWCACHE;
  wire [11:0]s00_couplers_to_xbar_AWID;
  wire [7:0]s00_couplers_to_xbar_AWLEN;
  wire [0:0]s00_couplers_to_xbar_AWLOCK;
  wire [2:0]s00_couplers_to_xbar_AWPROT;
  wire [3:0]s00_couplers_to_xbar_AWQOS;
  wire [0:0]s00_couplers_to_xbar_AWREADY;
  wire [2:0]s00_couplers_to_xbar_AWSIZE;
  wire s00_couplers_to_xbar_AWVALID;
  wire [11:0]s00_couplers_to_xbar_BID;
  wire s00_couplers_to_xbar_BREADY;
  wire [1:0]s00_couplers_to_xbar_BRESP;
  wire [0:0]s00_couplers_to_xbar_BVALID;
  wire [31:0]s00_couplers_to_xbar_RDATA;
  wire [11:0]s00_couplers_to_xbar_RID;
  wire [0:0]s00_couplers_to_xbar_RLAST;
  wire s00_couplers_to_xbar_RREADY;
  wire [1:0]s00_couplers_to_xbar_RRESP;
  wire [0:0]s00_couplers_to_xbar_RVALID;
  wire [31:0]s00_couplers_to_xbar_WDATA;
  wire s00_couplers_to_xbar_WLAST;
  wire [0:0]s00_couplers_to_xbar_WREADY;
  wire [3:0]s00_couplers_to_xbar_WSTRB;
  wire s00_couplers_to_xbar_WVALID;
  wire [31:0]xbar_to_m00_couplers_ARADDR;
  wire [1:0]xbar_to_m00_couplers_ARBURST;
  wire [3:0]xbar_to_m00_couplers_ARCACHE;
  wire [11:0]xbar_to_m00_couplers_ARID;
  wire [7:0]xbar_to_m00_couplers_ARLEN;
  wire [0:0]xbar_to_m00_couplers_ARLOCK;
  wire [2:0]xbar_to_m00_couplers_ARPROT;
  wire [0:0]xbar_to_m00_couplers_ARREADY;
  wire [2:0]xbar_to_m00_couplers_ARSIZE;
  wire [0:0]xbar_to_m00_couplers_ARVALID;
  wire [31:0]xbar_to_m00_couplers_AWADDR;
  wire [1:0]xbar_to_m00_couplers_AWBURST;
  wire [3:0]xbar_to_m00_couplers_AWCACHE;
  wire [11:0]xbar_to_m00_couplers_AWID;
  wire [7:0]xbar_to_m00_couplers_AWLEN;
  wire [0:0]xbar_to_m00_couplers_AWLOCK;
  wire [2:0]xbar_to_m00_couplers_AWPROT;
  wire [0:0]xbar_to_m00_couplers_AWREADY;
  wire [2:0]xbar_to_m00_couplers_AWSIZE;
  wire [0:0]xbar_to_m00_couplers_AWVALID;
  wire [11:0]xbar_to_m00_couplers_BID;
  wire [0:0]xbar_to_m00_couplers_BREADY;
  wire [1:0]xbar_to_m00_couplers_BRESP;
  wire [0:0]xbar_to_m00_couplers_BVALID;
  wire [31:0]xbar_to_m00_couplers_RDATA;
  wire [11:0]xbar_to_m00_couplers_RID;
  wire [0:0]xbar_to_m00_couplers_RLAST;
  wire [0:0]xbar_to_m00_couplers_RREADY;
  wire [1:0]xbar_to_m00_couplers_RRESP;
  wire [0:0]xbar_to_m00_couplers_RVALID;
  wire [31:0]xbar_to_m00_couplers_WDATA;
  wire [0:0]xbar_to_m00_couplers_WLAST;
  wire [0:0]xbar_to_m00_couplers_WREADY;
  wire [3:0]xbar_to_m00_couplers_WSTRB;
  wire [0:0]xbar_to_m00_couplers_WVALID;
  wire [63:32]xbar_to_m01_couplers_ARADDR;
  wire [3:2]xbar_to_m01_couplers_ARBURST;
  wire [7:4]xbar_to_m01_couplers_ARCACHE;
  wire [23:12]xbar_to_m01_couplers_ARID;
  wire [15:8]xbar_to_m01_couplers_ARLEN;
  wire [1:1]xbar_to_m01_couplers_ARLOCK;
  wire [5:3]xbar_to_m01_couplers_ARPROT;
  wire [0:0]xbar_to_m01_couplers_ARREADY;
  wire [5:3]xbar_to_m01_couplers_ARSIZE;
  wire [1:1]xbar_to_m01_couplers_ARVALID;
  wire [63:32]xbar_to_m01_couplers_AWADDR;
  wire [3:2]xbar_to_m01_couplers_AWBURST;
  wire [7:4]xbar_to_m01_couplers_AWCACHE;
  wire [23:12]xbar_to_m01_couplers_AWID;
  wire [15:8]xbar_to_m01_couplers_AWLEN;
  wire [1:1]xbar_to_m01_couplers_AWLOCK;
  wire [5:3]xbar_to_m01_couplers_AWPROT;
  wire [0:0]xbar_to_m01_couplers_AWREADY;
  wire [5:3]xbar_to_m01_couplers_AWSIZE;
  wire [1:1]xbar_to_m01_couplers_AWVALID;
  wire [11:0]xbar_to_m01_couplers_BID;
  wire [1:1]xbar_to_m01_couplers_BREADY;
  wire [1:0]xbar_to_m01_couplers_BRESP;
  wire [0:0]xbar_to_m01_couplers_BVALID;
  wire [31:0]xbar_to_m01_couplers_RDATA;
  wire [11:0]xbar_to_m01_couplers_RID;
  wire [0:0]xbar_to_m01_couplers_RLAST;
  wire [1:1]xbar_to_m01_couplers_RREADY;
  wire [1:0]xbar_to_m01_couplers_RRESP;
  wire [0:0]xbar_to_m01_couplers_RVALID;
  wire [63:32]xbar_to_m01_couplers_WDATA;
  wire [1:1]xbar_to_m01_couplers_WLAST;
  wire [0:0]xbar_to_m01_couplers_WREADY;
  wire [7:4]xbar_to_m01_couplers_WSTRB;
  wire [1:1]xbar_to_m01_couplers_WVALID;
  wire [95:64]xbar_to_m02_couplers_ARADDR;
  wire [5:4]xbar_to_m02_couplers_ARBURST;
  wire [11:8]xbar_to_m02_couplers_ARCACHE;
  wire [35:24]xbar_to_m02_couplers_ARID;
  wire [23:16]xbar_to_m02_couplers_ARLEN;
  wire [2:2]xbar_to_m02_couplers_ARLOCK;
  wire [8:6]xbar_to_m02_couplers_ARPROT;
  wire [11:8]xbar_to_m02_couplers_ARQOS;
  wire xbar_to_m02_couplers_ARREADY;
  wire [11:8]xbar_to_m02_couplers_ARREGION;
  wire [8:6]xbar_to_m02_couplers_ARSIZE;
  wire [2:2]xbar_to_m02_couplers_ARVALID;
  wire [95:64]xbar_to_m02_couplers_AWADDR;
  wire [5:4]xbar_to_m02_couplers_AWBURST;
  wire [11:8]xbar_to_m02_couplers_AWCACHE;
  wire [35:24]xbar_to_m02_couplers_AWID;
  wire [23:16]xbar_to_m02_couplers_AWLEN;
  wire [2:2]xbar_to_m02_couplers_AWLOCK;
  wire [8:6]xbar_to_m02_couplers_AWPROT;
  wire [11:8]xbar_to_m02_couplers_AWQOS;
  wire xbar_to_m02_couplers_AWREADY;
  wire [11:8]xbar_to_m02_couplers_AWREGION;
  wire [8:6]xbar_to_m02_couplers_AWSIZE;
  wire [2:2]xbar_to_m02_couplers_AWVALID;
  wire [11:0]xbar_to_m02_couplers_BID;
  wire [2:2]xbar_to_m02_couplers_BREADY;
  wire [1:0]xbar_to_m02_couplers_BRESP;
  wire xbar_to_m02_couplers_BVALID;
  wire [31:0]xbar_to_m02_couplers_RDATA;
  wire [11:0]xbar_to_m02_couplers_RID;
  wire xbar_to_m02_couplers_RLAST;
  wire [2:2]xbar_to_m02_couplers_RREADY;
  wire [1:0]xbar_to_m02_couplers_RRESP;
  wire xbar_to_m02_couplers_RVALID;
  wire [95:64]xbar_to_m02_couplers_WDATA;
  wire [2:2]xbar_to_m02_couplers_WLAST;
  wire xbar_to_m02_couplers_WREADY;
  wire [11:8]xbar_to_m02_couplers_WSTRB;
  wire [2:2]xbar_to_m02_couplers_WVALID;
  wire [11:0]NLW_xbar_m_axi_arqos_UNCONNECTED;
  wire [11:0]NLW_xbar_m_axi_arregion_UNCONNECTED;
  wire [11:0]NLW_xbar_m_axi_awqos_UNCONNECTED;
  wire [11:0]NLW_xbar_m_axi_awregion_UNCONNECTED;

  assign M00_ACLK_1 = M00_ACLK;
  assign M00_ARESETN_1 = M00_ARESETN;
  assign M00_AXI_araddr[31:0] = m00_couplers_to_axi_interconnect_0_ARADDR;
  assign M00_AXI_arburst[1:0] = m00_couplers_to_axi_interconnect_0_ARBURST;
  assign M00_AXI_arcache[3:0] = m00_couplers_to_axi_interconnect_0_ARCACHE;
  assign M00_AXI_arid[11:0] = m00_couplers_to_axi_interconnect_0_ARID;
  assign M00_AXI_arlen[7:0] = m00_couplers_to_axi_interconnect_0_ARLEN;
  assign M00_AXI_arlock[0] = m00_couplers_to_axi_interconnect_0_ARLOCK;
  assign M00_AXI_arprot[2:0] = m00_couplers_to_axi_interconnect_0_ARPROT;
  assign M00_AXI_arsize[2:0] = m00_couplers_to_axi_interconnect_0_ARSIZE;
  assign M00_AXI_arvalid[0] = m00_couplers_to_axi_interconnect_0_ARVALID;
  assign M00_AXI_awaddr[31:0] = m00_couplers_to_axi_interconnect_0_AWADDR;
  assign M00_AXI_awburst[1:0] = m00_couplers_to_axi_interconnect_0_AWBURST;
  assign M00_AXI_awcache[3:0] = m00_couplers_to_axi_interconnect_0_AWCACHE;
  assign M00_AXI_awid[11:0] = m00_couplers_to_axi_interconnect_0_AWID;
  assign M00_AXI_awlen[7:0] = m00_couplers_to_axi_interconnect_0_AWLEN;
  assign M00_AXI_awlock[0] = m00_couplers_to_axi_interconnect_0_AWLOCK;
  assign M00_AXI_awprot[2:0] = m00_couplers_to_axi_interconnect_0_AWPROT;
  assign M00_AXI_awsize[2:0] = m00_couplers_to_axi_interconnect_0_AWSIZE;
  assign M00_AXI_awvalid[0] = m00_couplers_to_axi_interconnect_0_AWVALID;
  assign M00_AXI_bready[0] = m00_couplers_to_axi_interconnect_0_BREADY;
  assign M00_AXI_rready[0] = m00_couplers_to_axi_interconnect_0_RREADY;
  assign M00_AXI_wdata[31:0] = m00_couplers_to_axi_interconnect_0_WDATA;
  assign M00_AXI_wlast[0] = m00_couplers_to_axi_interconnect_0_WLAST;
  assign M00_AXI_wstrb[3:0] = m00_couplers_to_axi_interconnect_0_WSTRB;
  assign M00_AXI_wvalid[0] = m00_couplers_to_axi_interconnect_0_WVALID;
  assign M01_ACLK_1 = M01_ACLK;
  assign M01_ARESETN_1 = M01_ARESETN;
  assign M01_AXI_araddr[31:0] = m01_couplers_to_axi_interconnect_0_ARADDR;
  assign M01_AXI_arburst[1:0] = m01_couplers_to_axi_interconnect_0_ARBURST;
  assign M01_AXI_arcache[3:0] = m01_couplers_to_axi_interconnect_0_ARCACHE;
  assign M01_AXI_arid[11:0] = m01_couplers_to_axi_interconnect_0_ARID;
  assign M01_AXI_arlen[7:0] = m01_couplers_to_axi_interconnect_0_ARLEN;
  assign M01_AXI_arlock[0] = m01_couplers_to_axi_interconnect_0_ARLOCK;
  assign M01_AXI_arprot[2:0] = m01_couplers_to_axi_interconnect_0_ARPROT;
  assign M01_AXI_arsize[2:0] = m01_couplers_to_axi_interconnect_0_ARSIZE;
  assign M01_AXI_arvalid[0] = m01_couplers_to_axi_interconnect_0_ARVALID;
  assign M01_AXI_awaddr[31:0] = m01_couplers_to_axi_interconnect_0_AWADDR;
  assign M01_AXI_awburst[1:0] = m01_couplers_to_axi_interconnect_0_AWBURST;
  assign M01_AXI_awcache[3:0] = m01_couplers_to_axi_interconnect_0_AWCACHE;
  assign M01_AXI_awid[11:0] = m01_couplers_to_axi_interconnect_0_AWID;
  assign M01_AXI_awlen[7:0] = m01_couplers_to_axi_interconnect_0_AWLEN;
  assign M01_AXI_awlock[0] = m01_couplers_to_axi_interconnect_0_AWLOCK;
  assign M01_AXI_awprot[2:0] = m01_couplers_to_axi_interconnect_0_AWPROT;
  assign M01_AXI_awsize[2:0] = m01_couplers_to_axi_interconnect_0_AWSIZE;
  assign M01_AXI_awvalid[0] = m01_couplers_to_axi_interconnect_0_AWVALID;
  assign M01_AXI_bready[0] = m01_couplers_to_axi_interconnect_0_BREADY;
  assign M01_AXI_rready[0] = m01_couplers_to_axi_interconnect_0_RREADY;
  assign M01_AXI_wdata[31:0] = m01_couplers_to_axi_interconnect_0_WDATA;
  assign M01_AXI_wlast[0] = m01_couplers_to_axi_interconnect_0_WLAST;
  assign M01_AXI_wstrb[3:0] = m01_couplers_to_axi_interconnect_0_WSTRB;
  assign M01_AXI_wvalid[0] = m01_couplers_to_axi_interconnect_0_WVALID;
  assign M02_ACLK_1 = M02_ACLK;
  assign M02_ARESETN_1 = M02_ARESETN;
  assign M02_AXI_araddr[31:0] = m02_couplers_to_axi_interconnect_0_ARADDR;
  assign M02_AXI_arvalid = m02_couplers_to_axi_interconnect_0_ARVALID;
  assign M02_AXI_awaddr[31:0] = m02_couplers_to_axi_interconnect_0_AWADDR;
  assign M02_AXI_awvalid = m02_couplers_to_axi_interconnect_0_AWVALID;
  assign M02_AXI_bready = m02_couplers_to_axi_interconnect_0_BREADY;
  assign M02_AXI_rready = m02_couplers_to_axi_interconnect_0_RREADY;
  assign M02_AXI_wdata[31:0] = m02_couplers_to_axi_interconnect_0_WDATA;
  assign M02_AXI_wstrb[3:0] = m02_couplers_to_axi_interconnect_0_WSTRB;
  assign M02_AXI_wvalid = m02_couplers_to_axi_interconnect_0_WVALID;
  assign S00_ACLK_1 = S00_ACLK;
  assign S00_ARESETN_1 = S00_ARESETN;
  assign S00_AXI_arready = axi_interconnect_0_to_s00_couplers_ARREADY;
  assign S00_AXI_awready = axi_interconnect_0_to_s00_couplers_AWREADY;
  assign S00_AXI_bid[11:0] = axi_interconnect_0_to_s00_couplers_BID;
  assign S00_AXI_bresp[1:0] = axi_interconnect_0_to_s00_couplers_BRESP;
  assign S00_AXI_bvalid = axi_interconnect_0_to_s00_couplers_BVALID;
  assign S00_AXI_rdata[31:0] = axi_interconnect_0_to_s00_couplers_RDATA;
  assign S00_AXI_rid[11:0] = axi_interconnect_0_to_s00_couplers_RID;
  assign S00_AXI_rlast = axi_interconnect_0_to_s00_couplers_RLAST;
  assign S00_AXI_rresp[1:0] = axi_interconnect_0_to_s00_couplers_RRESP;
  assign S00_AXI_rvalid = axi_interconnect_0_to_s00_couplers_RVALID;
  assign S00_AXI_wready = axi_interconnect_0_to_s00_couplers_WREADY;
  assign axi_interconnect_0_ACLK_net = ACLK;
  assign axi_interconnect_0_ARESETN_net = ARESETN;
  assign axi_interconnect_0_to_s00_couplers_ARADDR = S00_AXI_araddr[31:0];
  assign axi_interconnect_0_to_s00_couplers_ARBURST = S00_AXI_arburst[1:0];
  assign axi_interconnect_0_to_s00_couplers_ARCACHE = S00_AXI_arcache[3:0];
  assign axi_interconnect_0_to_s00_couplers_ARID = S00_AXI_arid[11:0];
  assign axi_interconnect_0_to_s00_couplers_ARLEN = S00_AXI_arlen[3:0];
  assign axi_interconnect_0_to_s00_couplers_ARLOCK = S00_AXI_arlock[1:0];
  assign axi_interconnect_0_to_s00_couplers_ARPROT = S00_AXI_arprot[2:0];
  assign axi_interconnect_0_to_s00_couplers_ARQOS = S00_AXI_arqos[3:0];
  assign axi_interconnect_0_to_s00_couplers_ARSIZE = S00_AXI_arsize[2:0];
  assign axi_interconnect_0_to_s00_couplers_ARVALID = S00_AXI_arvalid;
  assign axi_interconnect_0_to_s00_couplers_AWADDR = S00_AXI_awaddr[31:0];
  assign axi_interconnect_0_to_s00_couplers_AWBURST = S00_AXI_awburst[1:0];
  assign axi_interconnect_0_to_s00_couplers_AWCACHE = S00_AXI_awcache[3:0];
  assign axi_interconnect_0_to_s00_couplers_AWID = S00_AXI_awid[11:0];
  assign axi_interconnect_0_to_s00_couplers_AWLEN = S00_AXI_awlen[3:0];
  assign axi_interconnect_0_to_s00_couplers_AWLOCK = S00_AXI_awlock[1:0];
  assign axi_interconnect_0_to_s00_couplers_AWPROT = S00_AXI_awprot[2:0];
  assign axi_interconnect_0_to_s00_couplers_AWQOS = S00_AXI_awqos[3:0];
  assign axi_interconnect_0_to_s00_couplers_AWSIZE = S00_AXI_awsize[2:0];
  assign axi_interconnect_0_to_s00_couplers_AWVALID = S00_AXI_awvalid;
  assign axi_interconnect_0_to_s00_couplers_BREADY = S00_AXI_bready;
  assign axi_interconnect_0_to_s00_couplers_RREADY = S00_AXI_rready;
  assign axi_interconnect_0_to_s00_couplers_WDATA = S00_AXI_wdata[31:0];
  assign axi_interconnect_0_to_s00_couplers_WID = S00_AXI_wid[11:0];
  assign axi_interconnect_0_to_s00_couplers_WLAST = S00_AXI_wlast;
  assign axi_interconnect_0_to_s00_couplers_WSTRB = S00_AXI_wstrb[3:0];
  assign axi_interconnect_0_to_s00_couplers_WVALID = S00_AXI_wvalid;
  assign m00_couplers_to_axi_interconnect_0_ARREADY = M00_AXI_arready[0];
  assign m00_couplers_to_axi_interconnect_0_AWREADY = M00_AXI_awready[0];
  assign m00_couplers_to_axi_interconnect_0_BID = M00_AXI_bid[11:0];
  assign m00_couplers_to_axi_interconnect_0_BRESP = M00_AXI_bresp[1:0];
  assign m00_couplers_to_axi_interconnect_0_BVALID = M00_AXI_bvalid[0];
  assign m00_couplers_to_axi_interconnect_0_RDATA = M00_AXI_rdata[31:0];
  assign m00_couplers_to_axi_interconnect_0_RID = M00_AXI_rid[11:0];
  assign m00_couplers_to_axi_interconnect_0_RLAST = M00_AXI_rlast[0];
  assign m00_couplers_to_axi_interconnect_0_RRESP = M00_AXI_rresp[1:0];
  assign m00_couplers_to_axi_interconnect_0_RVALID = M00_AXI_rvalid[0];
  assign m00_couplers_to_axi_interconnect_0_WREADY = M00_AXI_wready[0];
  assign m01_couplers_to_axi_interconnect_0_ARREADY = M01_AXI_arready[0];
  assign m01_couplers_to_axi_interconnect_0_AWREADY = M01_AXI_awready[0];
  assign m01_couplers_to_axi_interconnect_0_BID = M01_AXI_bid[11:0];
  assign m01_couplers_to_axi_interconnect_0_BRESP = M01_AXI_bresp[1:0];
  assign m01_couplers_to_axi_interconnect_0_BVALID = M01_AXI_bvalid[0];
  assign m01_couplers_to_axi_interconnect_0_RDATA = M01_AXI_rdata[31:0];
  assign m01_couplers_to_axi_interconnect_0_RID = M01_AXI_rid[11:0];
  assign m01_couplers_to_axi_interconnect_0_RLAST = M01_AXI_rlast[0];
  assign m01_couplers_to_axi_interconnect_0_RRESP = M01_AXI_rresp[1:0];
  assign m01_couplers_to_axi_interconnect_0_RVALID = M01_AXI_rvalid[0];
  assign m01_couplers_to_axi_interconnect_0_WREADY = M01_AXI_wready[0];
  assign m02_couplers_to_axi_interconnect_0_ARREADY = M02_AXI_arready;
  assign m02_couplers_to_axi_interconnect_0_AWREADY = M02_AXI_awready;
  assign m02_couplers_to_axi_interconnect_0_BRESP = M02_AXI_bresp[1:0];
  assign m02_couplers_to_axi_interconnect_0_BVALID = M02_AXI_bvalid;
  assign m02_couplers_to_axi_interconnect_0_RDATA = M02_AXI_rdata[31:0];
  assign m02_couplers_to_axi_interconnect_0_RRESP = M02_AXI_rresp[1:0];
  assign m02_couplers_to_axi_interconnect_0_RVALID = M02_AXI_rvalid;
  assign m02_couplers_to_axi_interconnect_0_WREADY = M02_AXI_wready;
  m00_couplers_imp_1BQZXD6 m00_couplers
       (.M_ACLK(M00_ACLK_1),
        .M_ARESETN(M00_ARESETN_1),
        .M_AXI_araddr(m00_couplers_to_axi_interconnect_0_ARADDR),
        .M_AXI_arburst(m00_couplers_to_axi_interconnect_0_ARBURST),
        .M_AXI_arcache(m00_couplers_to_axi_interconnect_0_ARCACHE),
        .M_AXI_arid(m00_couplers_to_axi_interconnect_0_ARID),
        .M_AXI_arlen(m00_couplers_to_axi_interconnect_0_ARLEN),
        .M_AXI_arlock(m00_couplers_to_axi_interconnect_0_ARLOCK),
        .M_AXI_arprot(m00_couplers_to_axi_interconnect_0_ARPROT),
        .M_AXI_arready(m00_couplers_to_axi_interconnect_0_ARREADY),
        .M_AXI_arsize(m00_couplers_to_axi_interconnect_0_ARSIZE),
        .M_AXI_arvalid(m00_couplers_to_axi_interconnect_0_ARVALID),
        .M_AXI_awaddr(m00_couplers_to_axi_interconnect_0_AWADDR),
        .M_AXI_awburst(m00_couplers_to_axi_interconnect_0_AWBURST),
        .M_AXI_awcache(m00_couplers_to_axi_interconnect_0_AWCACHE),
        .M_AXI_awid(m00_couplers_to_axi_interconnect_0_AWID),
        .M_AXI_awlen(m00_couplers_to_axi_interconnect_0_AWLEN),
        .M_AXI_awlock(m00_couplers_to_axi_interconnect_0_AWLOCK),
        .M_AXI_awprot(m00_couplers_to_axi_interconnect_0_AWPROT),
        .M_AXI_awready(m00_couplers_to_axi_interconnect_0_AWREADY),
        .M_AXI_awsize(m00_couplers_to_axi_interconnect_0_AWSIZE),
        .M_AXI_awvalid(m00_couplers_to_axi_interconnect_0_AWVALID),
        .M_AXI_bid(m00_couplers_to_axi_interconnect_0_BID),
        .M_AXI_bready(m00_couplers_to_axi_interconnect_0_BREADY),
        .M_AXI_bresp(m00_couplers_to_axi_interconnect_0_BRESP),
        .M_AXI_bvalid(m00_couplers_to_axi_interconnect_0_BVALID),
        .M_AXI_rdata(m00_couplers_to_axi_interconnect_0_RDATA),
        .M_AXI_rid(m00_couplers_to_axi_interconnect_0_RID),
        .M_AXI_rlast(m00_couplers_to_axi_interconnect_0_RLAST),
        .M_AXI_rready(m00_couplers_to_axi_interconnect_0_RREADY),
        .M_AXI_rresp(m00_couplers_to_axi_interconnect_0_RRESP),
        .M_AXI_rvalid(m00_couplers_to_axi_interconnect_0_RVALID),
        .M_AXI_wdata(m00_couplers_to_axi_interconnect_0_WDATA),
        .M_AXI_wlast(m00_couplers_to_axi_interconnect_0_WLAST),
        .M_AXI_wready(m00_couplers_to_axi_interconnect_0_WREADY),
        .M_AXI_wstrb(m00_couplers_to_axi_interconnect_0_WSTRB),
        .M_AXI_wvalid(m00_couplers_to_axi_interconnect_0_WVALID),
        .S_ACLK(axi_interconnect_0_ACLK_net),
        .S_ARESETN(axi_interconnect_0_ARESETN_net),
        .S_AXI_araddr(xbar_to_m00_couplers_ARADDR),
        .S_AXI_arburst(xbar_to_m00_couplers_ARBURST),
        .S_AXI_arcache(xbar_to_m00_couplers_ARCACHE),
        .S_AXI_arid(xbar_to_m00_couplers_ARID),
        .S_AXI_arlen(xbar_to_m00_couplers_ARLEN),
        .S_AXI_arlock(xbar_to_m00_couplers_ARLOCK),
        .S_AXI_arprot(xbar_to_m00_couplers_ARPROT),
        .S_AXI_arready(xbar_to_m00_couplers_ARREADY),
        .S_AXI_arsize(xbar_to_m00_couplers_ARSIZE),
        .S_AXI_arvalid(xbar_to_m00_couplers_ARVALID),
        .S_AXI_awaddr(xbar_to_m00_couplers_AWADDR),
        .S_AXI_awburst(xbar_to_m00_couplers_AWBURST),
        .S_AXI_awcache(xbar_to_m00_couplers_AWCACHE),
        .S_AXI_awid(xbar_to_m00_couplers_AWID),
        .S_AXI_awlen(xbar_to_m00_couplers_AWLEN),
        .S_AXI_awlock(xbar_to_m00_couplers_AWLOCK),
        .S_AXI_awprot(xbar_to_m00_couplers_AWPROT),
        .S_AXI_awready(xbar_to_m00_couplers_AWREADY),
        .S_AXI_awsize(xbar_to_m00_couplers_AWSIZE),
        .S_AXI_awvalid(xbar_to_m00_couplers_AWVALID),
        .S_AXI_bid(xbar_to_m00_couplers_BID),
        .S_AXI_bready(xbar_to_m00_couplers_BREADY),
        .S_AXI_bresp(xbar_to_m00_couplers_BRESP),
        .S_AXI_bvalid(xbar_to_m00_couplers_BVALID),
        .S_AXI_rdata(xbar_to_m00_couplers_RDATA),
        .S_AXI_rid(xbar_to_m00_couplers_RID),
        .S_AXI_rlast(xbar_to_m00_couplers_RLAST),
        .S_AXI_rready(xbar_to_m00_couplers_RREADY),
        .S_AXI_rresp(xbar_to_m00_couplers_RRESP),
        .S_AXI_rvalid(xbar_to_m00_couplers_RVALID),
        .S_AXI_wdata(xbar_to_m00_couplers_WDATA),
        .S_AXI_wlast(xbar_to_m00_couplers_WLAST),
        .S_AXI_wready(xbar_to_m00_couplers_WREADY),
        .S_AXI_wstrb(xbar_to_m00_couplers_WSTRB),
        .S_AXI_wvalid(xbar_to_m00_couplers_WVALID));
  m01_couplers_imp_1JWP23W m01_couplers
       (.M_ACLK(M01_ACLK_1),
        .M_ARESETN(M01_ARESETN_1),
        .M_AXI_araddr(m01_couplers_to_axi_interconnect_0_ARADDR),
        .M_AXI_arburst(m01_couplers_to_axi_interconnect_0_ARBURST),
        .M_AXI_arcache(m01_couplers_to_axi_interconnect_0_ARCACHE),
        .M_AXI_arid(m01_couplers_to_axi_interconnect_0_ARID),
        .M_AXI_arlen(m01_couplers_to_axi_interconnect_0_ARLEN),
        .M_AXI_arlock(m01_couplers_to_axi_interconnect_0_ARLOCK),
        .M_AXI_arprot(m01_couplers_to_axi_interconnect_0_ARPROT),
        .M_AXI_arready(m01_couplers_to_axi_interconnect_0_ARREADY),
        .M_AXI_arsize(m01_couplers_to_axi_interconnect_0_ARSIZE),
        .M_AXI_arvalid(m01_couplers_to_axi_interconnect_0_ARVALID),
        .M_AXI_awaddr(m01_couplers_to_axi_interconnect_0_AWADDR),
        .M_AXI_awburst(m01_couplers_to_axi_interconnect_0_AWBURST),
        .M_AXI_awcache(m01_couplers_to_axi_interconnect_0_AWCACHE),
        .M_AXI_awid(m01_couplers_to_axi_interconnect_0_AWID),
        .M_AXI_awlen(m01_couplers_to_axi_interconnect_0_AWLEN),
        .M_AXI_awlock(m01_couplers_to_axi_interconnect_0_AWLOCK),
        .M_AXI_awprot(m01_couplers_to_axi_interconnect_0_AWPROT),
        .M_AXI_awready(m01_couplers_to_axi_interconnect_0_AWREADY),
        .M_AXI_awsize(m01_couplers_to_axi_interconnect_0_AWSIZE),
        .M_AXI_awvalid(m01_couplers_to_axi_interconnect_0_AWVALID),
        .M_AXI_bid(m01_couplers_to_axi_interconnect_0_BID),
        .M_AXI_bready(m01_couplers_to_axi_interconnect_0_BREADY),
        .M_AXI_bresp(m01_couplers_to_axi_interconnect_0_BRESP),
        .M_AXI_bvalid(m01_couplers_to_axi_interconnect_0_BVALID),
        .M_AXI_rdata(m01_couplers_to_axi_interconnect_0_RDATA),
        .M_AXI_rid(m01_couplers_to_axi_interconnect_0_RID),
        .M_AXI_rlast(m01_couplers_to_axi_interconnect_0_RLAST),
        .M_AXI_rready(m01_couplers_to_axi_interconnect_0_RREADY),
        .M_AXI_rresp(m01_couplers_to_axi_interconnect_0_RRESP),
        .M_AXI_rvalid(m01_couplers_to_axi_interconnect_0_RVALID),
        .M_AXI_wdata(m01_couplers_to_axi_interconnect_0_WDATA),
        .M_AXI_wlast(m01_couplers_to_axi_interconnect_0_WLAST),
        .M_AXI_wready(m01_couplers_to_axi_interconnect_0_WREADY),
        .M_AXI_wstrb(m01_couplers_to_axi_interconnect_0_WSTRB),
        .M_AXI_wvalid(m01_couplers_to_axi_interconnect_0_WVALID),
        .S_ACLK(axi_interconnect_0_ACLK_net),
        .S_ARESETN(axi_interconnect_0_ARESETN_net),
        .S_AXI_araddr(xbar_to_m01_couplers_ARADDR),
        .S_AXI_arburst(xbar_to_m01_couplers_ARBURST),
        .S_AXI_arcache(xbar_to_m01_couplers_ARCACHE),
        .S_AXI_arid(xbar_to_m01_couplers_ARID),
        .S_AXI_arlen(xbar_to_m01_couplers_ARLEN),
        .S_AXI_arlock(xbar_to_m01_couplers_ARLOCK),
        .S_AXI_arprot(xbar_to_m01_couplers_ARPROT),
        .S_AXI_arready(xbar_to_m01_couplers_ARREADY),
        .S_AXI_arsize(xbar_to_m01_couplers_ARSIZE),
        .S_AXI_arvalid(xbar_to_m01_couplers_ARVALID),
        .S_AXI_awaddr(xbar_to_m01_couplers_AWADDR),
        .S_AXI_awburst(xbar_to_m01_couplers_AWBURST),
        .S_AXI_awcache(xbar_to_m01_couplers_AWCACHE),
        .S_AXI_awid(xbar_to_m01_couplers_AWID),
        .S_AXI_awlen(xbar_to_m01_couplers_AWLEN),
        .S_AXI_awlock(xbar_to_m01_couplers_AWLOCK),
        .S_AXI_awprot(xbar_to_m01_couplers_AWPROT),
        .S_AXI_awready(xbar_to_m01_couplers_AWREADY),
        .S_AXI_awsize(xbar_to_m01_couplers_AWSIZE),
        .S_AXI_awvalid(xbar_to_m01_couplers_AWVALID),
        .S_AXI_bid(xbar_to_m01_couplers_BID),
        .S_AXI_bready(xbar_to_m01_couplers_BREADY),
        .S_AXI_bresp(xbar_to_m01_couplers_BRESP),
        .S_AXI_bvalid(xbar_to_m01_couplers_BVALID),
        .S_AXI_rdata(xbar_to_m01_couplers_RDATA),
        .S_AXI_rid(xbar_to_m01_couplers_RID),
        .S_AXI_rlast(xbar_to_m01_couplers_RLAST),
        .S_AXI_rready(xbar_to_m01_couplers_RREADY),
        .S_AXI_rresp(xbar_to_m01_couplers_RRESP),
        .S_AXI_rvalid(xbar_to_m01_couplers_RVALID),
        .S_AXI_wdata(xbar_to_m01_couplers_WDATA),
        .S_AXI_wlast(xbar_to_m01_couplers_WLAST),
        .S_AXI_wready(xbar_to_m01_couplers_WREADY),
        .S_AXI_wstrb(xbar_to_m01_couplers_WSTRB),
        .S_AXI_wvalid(xbar_to_m01_couplers_WVALID));
  m02_couplers_imp_SJ7VOM m02_couplers
       (.M_ACLK(M02_ACLK_1),
        .M_ARESETN(M02_ARESETN_1),
        .M_AXI_araddr(m02_couplers_to_axi_interconnect_0_ARADDR),
        .M_AXI_arready(m02_couplers_to_axi_interconnect_0_ARREADY),
        .M_AXI_arvalid(m02_couplers_to_axi_interconnect_0_ARVALID),
        .M_AXI_awaddr(m02_couplers_to_axi_interconnect_0_AWADDR),
        .M_AXI_awready(m02_couplers_to_axi_interconnect_0_AWREADY),
        .M_AXI_awvalid(m02_couplers_to_axi_interconnect_0_AWVALID),
        .M_AXI_bready(m02_couplers_to_axi_interconnect_0_BREADY),
        .M_AXI_bresp(m02_couplers_to_axi_interconnect_0_BRESP),
        .M_AXI_bvalid(m02_couplers_to_axi_interconnect_0_BVALID),
        .M_AXI_rdata(m02_couplers_to_axi_interconnect_0_RDATA),
        .M_AXI_rready(m02_couplers_to_axi_interconnect_0_RREADY),
        .M_AXI_rresp(m02_couplers_to_axi_interconnect_0_RRESP),
        .M_AXI_rvalid(m02_couplers_to_axi_interconnect_0_RVALID),
        .M_AXI_wdata(m02_couplers_to_axi_interconnect_0_WDATA),
        .M_AXI_wready(m02_couplers_to_axi_interconnect_0_WREADY),
        .M_AXI_wstrb(m02_couplers_to_axi_interconnect_0_WSTRB),
        .M_AXI_wvalid(m02_couplers_to_axi_interconnect_0_WVALID),
        .S_ACLK(axi_interconnect_0_ACLK_net),
        .S_ARESETN(axi_interconnect_0_ARESETN_net),
        .S_AXI_araddr(xbar_to_m02_couplers_ARADDR),
        .S_AXI_arburst(xbar_to_m02_couplers_ARBURST),
        .S_AXI_arcache(xbar_to_m02_couplers_ARCACHE),
        .S_AXI_arid(xbar_to_m02_couplers_ARID),
        .S_AXI_arlen(xbar_to_m02_couplers_ARLEN),
        .S_AXI_arlock(xbar_to_m02_couplers_ARLOCK),
        .S_AXI_arprot(xbar_to_m02_couplers_ARPROT),
        .S_AXI_arqos(xbar_to_m02_couplers_ARQOS),
        .S_AXI_arready(xbar_to_m02_couplers_ARREADY),
        .S_AXI_arregion(xbar_to_m02_couplers_ARREGION),
        .S_AXI_arsize(xbar_to_m02_couplers_ARSIZE),
        .S_AXI_arvalid(xbar_to_m02_couplers_ARVALID),
        .S_AXI_awaddr(xbar_to_m02_couplers_AWADDR),
        .S_AXI_awburst(xbar_to_m02_couplers_AWBURST),
        .S_AXI_awcache(xbar_to_m02_couplers_AWCACHE),
        .S_AXI_awid(xbar_to_m02_couplers_AWID),
        .S_AXI_awlen(xbar_to_m02_couplers_AWLEN),
        .S_AXI_awlock(xbar_to_m02_couplers_AWLOCK),
        .S_AXI_awprot(xbar_to_m02_couplers_AWPROT),
        .S_AXI_awqos(xbar_to_m02_couplers_AWQOS),
        .S_AXI_awready(xbar_to_m02_couplers_AWREADY),
        .S_AXI_awregion(xbar_to_m02_couplers_AWREGION),
        .S_AXI_awsize(xbar_to_m02_couplers_AWSIZE),
        .S_AXI_awvalid(xbar_to_m02_couplers_AWVALID),
        .S_AXI_bid(xbar_to_m02_couplers_BID),
        .S_AXI_bready(xbar_to_m02_couplers_BREADY),
        .S_AXI_bresp(xbar_to_m02_couplers_BRESP),
        .S_AXI_bvalid(xbar_to_m02_couplers_BVALID),
        .S_AXI_rdata(xbar_to_m02_couplers_RDATA),
        .S_AXI_rid(xbar_to_m02_couplers_RID),
        .S_AXI_rlast(xbar_to_m02_couplers_RLAST),
        .S_AXI_rready(xbar_to_m02_couplers_RREADY),
        .S_AXI_rresp(xbar_to_m02_couplers_RRESP),
        .S_AXI_rvalid(xbar_to_m02_couplers_RVALID),
        .S_AXI_wdata(xbar_to_m02_couplers_WDATA),
        .S_AXI_wlast(xbar_to_m02_couplers_WLAST),
        .S_AXI_wready(xbar_to_m02_couplers_WREADY),
        .S_AXI_wstrb(xbar_to_m02_couplers_WSTRB),
        .S_AXI_wvalid(xbar_to_m02_couplers_WVALID));
  s00_couplers_imp_1L9BC6J s00_couplers
       (.M_ACLK(axi_interconnect_0_ACLK_net),
        .M_ARESETN(axi_interconnect_0_ARESETN_net),
        .M_AXI_araddr(s00_couplers_to_xbar_ARADDR),
        .M_AXI_arburst(s00_couplers_to_xbar_ARBURST),
        .M_AXI_arcache(s00_couplers_to_xbar_ARCACHE),
        .M_AXI_arid(s00_couplers_to_xbar_ARID),
        .M_AXI_arlen(s00_couplers_to_xbar_ARLEN),
        .M_AXI_arlock(s00_couplers_to_xbar_ARLOCK),
        .M_AXI_arprot(s00_couplers_to_xbar_ARPROT),
        .M_AXI_arqos(s00_couplers_to_xbar_ARQOS),
        .M_AXI_arready(s00_couplers_to_xbar_ARREADY),
        .M_AXI_arsize(s00_couplers_to_xbar_ARSIZE),
        .M_AXI_arvalid(s00_couplers_to_xbar_ARVALID),
        .M_AXI_awaddr(s00_couplers_to_xbar_AWADDR),
        .M_AXI_awburst(s00_couplers_to_xbar_AWBURST),
        .M_AXI_awcache(s00_couplers_to_xbar_AWCACHE),
        .M_AXI_awid(s00_couplers_to_xbar_AWID),
        .M_AXI_awlen(s00_couplers_to_xbar_AWLEN),
        .M_AXI_awlock(s00_couplers_to_xbar_AWLOCK),
        .M_AXI_awprot(s00_couplers_to_xbar_AWPROT),
        .M_AXI_awqos(s00_couplers_to_xbar_AWQOS),
        .M_AXI_awready(s00_couplers_to_xbar_AWREADY),
        .M_AXI_awsize(s00_couplers_to_xbar_AWSIZE),
        .M_AXI_awvalid(s00_couplers_to_xbar_AWVALID),
        .M_AXI_bid(s00_couplers_to_xbar_BID),
        .M_AXI_bready(s00_couplers_to_xbar_BREADY),
        .M_AXI_bresp(s00_couplers_to_xbar_BRESP),
        .M_AXI_bvalid(s00_couplers_to_xbar_BVALID),
        .M_AXI_rdata(s00_couplers_to_xbar_RDATA),
        .M_AXI_rid(s00_couplers_to_xbar_RID),
        .M_AXI_rlast(s00_couplers_to_xbar_RLAST),
        .M_AXI_rready(s00_couplers_to_xbar_RREADY),
        .M_AXI_rresp(s00_couplers_to_xbar_RRESP),
        .M_AXI_rvalid(s00_couplers_to_xbar_RVALID),
        .M_AXI_wdata(s00_couplers_to_xbar_WDATA),
        .M_AXI_wlast(s00_couplers_to_xbar_WLAST),
        .M_AXI_wready(s00_couplers_to_xbar_WREADY),
        .M_AXI_wstrb(s00_couplers_to_xbar_WSTRB),
        .M_AXI_wvalid(s00_couplers_to_xbar_WVALID),
        .S_ACLK(S00_ACLK_1),
        .S_ARESETN(S00_ARESETN_1),
        .S_AXI_araddr(axi_interconnect_0_to_s00_couplers_ARADDR),
        .S_AXI_arburst(axi_interconnect_0_to_s00_couplers_ARBURST),
        .S_AXI_arcache(axi_interconnect_0_to_s00_couplers_ARCACHE),
        .S_AXI_arid(axi_interconnect_0_to_s00_couplers_ARID),
        .S_AXI_arlen(axi_interconnect_0_to_s00_couplers_ARLEN),
        .S_AXI_arlock(axi_interconnect_0_to_s00_couplers_ARLOCK),
        .S_AXI_arprot(axi_interconnect_0_to_s00_couplers_ARPROT),
        .S_AXI_arqos(axi_interconnect_0_to_s00_couplers_ARQOS),
        .S_AXI_arready(axi_interconnect_0_to_s00_couplers_ARREADY),
        .S_AXI_arsize(axi_interconnect_0_to_s00_couplers_ARSIZE),
        .S_AXI_arvalid(axi_interconnect_0_to_s00_couplers_ARVALID),
        .S_AXI_awaddr(axi_interconnect_0_to_s00_couplers_AWADDR),
        .S_AXI_awburst(axi_interconnect_0_to_s00_couplers_AWBURST),
        .S_AXI_awcache(axi_interconnect_0_to_s00_couplers_AWCACHE),
        .S_AXI_awid(axi_interconnect_0_to_s00_couplers_AWID),
        .S_AXI_awlen(axi_interconnect_0_to_s00_couplers_AWLEN),
        .S_AXI_awlock(axi_interconnect_0_to_s00_couplers_AWLOCK),
        .S_AXI_awprot(axi_interconnect_0_to_s00_couplers_AWPROT),
        .S_AXI_awqos(axi_interconnect_0_to_s00_couplers_AWQOS),
        .S_AXI_awready(axi_interconnect_0_to_s00_couplers_AWREADY),
        .S_AXI_awsize(axi_interconnect_0_to_s00_couplers_AWSIZE),
        .S_AXI_awvalid(axi_interconnect_0_to_s00_couplers_AWVALID),
        .S_AXI_bid(axi_interconnect_0_to_s00_couplers_BID),
        .S_AXI_bready(axi_interconnect_0_to_s00_couplers_BREADY),
        .S_AXI_bresp(axi_interconnect_0_to_s00_couplers_BRESP),
        .S_AXI_bvalid(axi_interconnect_0_to_s00_couplers_BVALID),
        .S_AXI_rdata(axi_interconnect_0_to_s00_couplers_RDATA),
        .S_AXI_rid(axi_interconnect_0_to_s00_couplers_RID),
        .S_AXI_rlast(axi_interconnect_0_to_s00_couplers_RLAST),
        .S_AXI_rready(axi_interconnect_0_to_s00_couplers_RREADY),
        .S_AXI_rresp(axi_interconnect_0_to_s00_couplers_RRESP),
        .S_AXI_rvalid(axi_interconnect_0_to_s00_couplers_RVALID),
        .S_AXI_wdata(axi_interconnect_0_to_s00_couplers_WDATA),
        .S_AXI_wid(axi_interconnect_0_to_s00_couplers_WID),
        .S_AXI_wlast(axi_interconnect_0_to_s00_couplers_WLAST),
        .S_AXI_wready(axi_interconnect_0_to_s00_couplers_WREADY),
        .S_AXI_wstrb(axi_interconnect_0_to_s00_couplers_WSTRB),
        .S_AXI_wvalid(axi_interconnect_0_to_s00_couplers_WVALID));
  Integrated_xbar_0 xbar
       (.aclk(axi_interconnect_0_ACLK_net),
        .aresetn(axi_interconnect_0_ARESETN_net),
        .m_axi_araddr({xbar_to_m02_couplers_ARADDR,xbar_to_m01_couplers_ARADDR,xbar_to_m00_couplers_ARADDR}),
        .m_axi_arburst({xbar_to_m02_couplers_ARBURST,xbar_to_m01_couplers_ARBURST,xbar_to_m00_couplers_ARBURST}),
        .m_axi_arcache({xbar_to_m02_couplers_ARCACHE,xbar_to_m01_couplers_ARCACHE,xbar_to_m00_couplers_ARCACHE}),
        .m_axi_arid({xbar_to_m02_couplers_ARID,xbar_to_m01_couplers_ARID,xbar_to_m00_couplers_ARID}),
        .m_axi_arlen({xbar_to_m02_couplers_ARLEN,xbar_to_m01_couplers_ARLEN,xbar_to_m00_couplers_ARLEN}),
        .m_axi_arlock({xbar_to_m02_couplers_ARLOCK,xbar_to_m01_couplers_ARLOCK,xbar_to_m00_couplers_ARLOCK}),
        .m_axi_arprot({xbar_to_m02_couplers_ARPROT,xbar_to_m01_couplers_ARPROT,xbar_to_m00_couplers_ARPROT}),
        .m_axi_arqos({xbar_to_m02_couplers_ARQOS,NLW_xbar_m_axi_arqos_UNCONNECTED[7:0]}),
        .m_axi_arready({xbar_to_m02_couplers_ARREADY,xbar_to_m01_couplers_ARREADY,xbar_to_m00_couplers_ARREADY}),
        .m_axi_arregion({xbar_to_m02_couplers_ARREGION,NLW_xbar_m_axi_arregion_UNCONNECTED[7:0]}),
        .m_axi_arsize({xbar_to_m02_couplers_ARSIZE,xbar_to_m01_couplers_ARSIZE,xbar_to_m00_couplers_ARSIZE}),
        .m_axi_arvalid({xbar_to_m02_couplers_ARVALID,xbar_to_m01_couplers_ARVALID,xbar_to_m00_couplers_ARVALID}),
        .m_axi_awaddr({xbar_to_m02_couplers_AWADDR,xbar_to_m01_couplers_AWADDR,xbar_to_m00_couplers_AWADDR}),
        .m_axi_awburst({xbar_to_m02_couplers_AWBURST,xbar_to_m01_couplers_AWBURST,xbar_to_m00_couplers_AWBURST}),
        .m_axi_awcache({xbar_to_m02_couplers_AWCACHE,xbar_to_m01_couplers_AWCACHE,xbar_to_m00_couplers_AWCACHE}),
        .m_axi_awid({xbar_to_m02_couplers_AWID,xbar_to_m01_couplers_AWID,xbar_to_m00_couplers_AWID}),
        .m_axi_awlen({xbar_to_m02_couplers_AWLEN,xbar_to_m01_couplers_AWLEN,xbar_to_m00_couplers_AWLEN}),
        .m_axi_awlock({xbar_to_m02_couplers_AWLOCK,xbar_to_m01_couplers_AWLOCK,xbar_to_m00_couplers_AWLOCK}),
        .m_axi_awprot({xbar_to_m02_couplers_AWPROT,xbar_to_m01_couplers_AWPROT,xbar_to_m00_couplers_AWPROT}),
        .m_axi_awqos({xbar_to_m02_couplers_AWQOS,NLW_xbar_m_axi_awqos_UNCONNECTED[7:0]}),
        .m_axi_awready({xbar_to_m02_couplers_AWREADY,xbar_to_m01_couplers_AWREADY,xbar_to_m00_couplers_AWREADY}),
        .m_axi_awregion({xbar_to_m02_couplers_AWREGION,NLW_xbar_m_axi_awregion_UNCONNECTED[7:0]}),
        .m_axi_awsize({xbar_to_m02_couplers_AWSIZE,xbar_to_m01_couplers_AWSIZE,xbar_to_m00_couplers_AWSIZE}),
        .m_axi_awvalid({xbar_to_m02_couplers_AWVALID,xbar_to_m01_couplers_AWVALID,xbar_to_m00_couplers_AWVALID}),
        .m_axi_bid({xbar_to_m02_couplers_BID,xbar_to_m01_couplers_BID,xbar_to_m00_couplers_BID}),
        .m_axi_bready({xbar_to_m02_couplers_BREADY,xbar_to_m01_couplers_BREADY,xbar_to_m00_couplers_BREADY}),
        .m_axi_bresp({xbar_to_m02_couplers_BRESP,xbar_to_m01_couplers_BRESP,xbar_to_m00_couplers_BRESP}),
        .m_axi_bvalid({xbar_to_m02_couplers_BVALID,xbar_to_m01_couplers_BVALID,xbar_to_m00_couplers_BVALID}),
        .m_axi_rdata({xbar_to_m02_couplers_RDATA,xbar_to_m01_couplers_RDATA,xbar_to_m00_couplers_RDATA}),
        .m_axi_rid({xbar_to_m02_couplers_RID,xbar_to_m01_couplers_RID,xbar_to_m00_couplers_RID}),
        .m_axi_rlast({xbar_to_m02_couplers_RLAST,xbar_to_m01_couplers_RLAST,xbar_to_m00_couplers_RLAST}),
        .m_axi_rready({xbar_to_m02_couplers_RREADY,xbar_to_m01_couplers_RREADY,xbar_to_m00_couplers_RREADY}),
        .m_axi_rresp({xbar_to_m02_couplers_RRESP,xbar_to_m01_couplers_RRESP,xbar_to_m00_couplers_RRESP}),
        .m_axi_rvalid({xbar_to_m02_couplers_RVALID,xbar_to_m01_couplers_RVALID,xbar_to_m00_couplers_RVALID}),
        .m_axi_wdata({xbar_to_m02_couplers_WDATA,xbar_to_m01_couplers_WDATA,xbar_to_m00_couplers_WDATA}),
        .m_axi_wlast({xbar_to_m02_couplers_WLAST,xbar_to_m01_couplers_WLAST,xbar_to_m00_couplers_WLAST}),
        .m_axi_wready({xbar_to_m02_couplers_WREADY,xbar_to_m01_couplers_WREADY,xbar_to_m00_couplers_WREADY}),
        .m_axi_wstrb({xbar_to_m02_couplers_WSTRB,xbar_to_m01_couplers_WSTRB,xbar_to_m00_couplers_WSTRB}),
        .m_axi_wvalid({xbar_to_m02_couplers_WVALID,xbar_to_m01_couplers_WVALID,xbar_to_m00_couplers_WVALID}),
        .s_axi_araddr(s00_couplers_to_xbar_ARADDR),
        .s_axi_arburst(s00_couplers_to_xbar_ARBURST),
        .s_axi_arcache(s00_couplers_to_xbar_ARCACHE),
        .s_axi_arid(s00_couplers_to_xbar_ARID),
        .s_axi_arlen(s00_couplers_to_xbar_ARLEN),
        .s_axi_arlock(s00_couplers_to_xbar_ARLOCK),
        .s_axi_arprot(s00_couplers_to_xbar_ARPROT),
        .s_axi_arqos(s00_couplers_to_xbar_ARQOS),
        .s_axi_arready(s00_couplers_to_xbar_ARREADY),
        .s_axi_arsize(s00_couplers_to_xbar_ARSIZE),
        .s_axi_arvalid(s00_couplers_to_xbar_ARVALID),
        .s_axi_awaddr(s00_couplers_to_xbar_AWADDR),
        .s_axi_awburst(s00_couplers_to_xbar_AWBURST),
        .s_axi_awcache(s00_couplers_to_xbar_AWCACHE),
        .s_axi_awid(s00_couplers_to_xbar_AWID),
        .s_axi_awlen(s00_couplers_to_xbar_AWLEN),
        .s_axi_awlock(s00_couplers_to_xbar_AWLOCK),
        .s_axi_awprot(s00_couplers_to_xbar_AWPROT),
        .s_axi_awqos(s00_couplers_to_xbar_AWQOS),
        .s_axi_awready(s00_couplers_to_xbar_AWREADY),
        .s_axi_awsize(s00_couplers_to_xbar_AWSIZE),
        .s_axi_awvalid(s00_couplers_to_xbar_AWVALID),
        .s_axi_bid(s00_couplers_to_xbar_BID),
        .s_axi_bready(s00_couplers_to_xbar_BREADY),
        .s_axi_bresp(s00_couplers_to_xbar_BRESP),
        .s_axi_bvalid(s00_couplers_to_xbar_BVALID),
        .s_axi_rdata(s00_couplers_to_xbar_RDATA),
        .s_axi_rid(s00_couplers_to_xbar_RID),
        .s_axi_rlast(s00_couplers_to_xbar_RLAST),
        .s_axi_rready(s00_couplers_to_xbar_RREADY),
        .s_axi_rresp(s00_couplers_to_xbar_RRESP),
        .s_axi_rvalid(s00_couplers_to_xbar_RVALID),
        .s_axi_wdata(s00_couplers_to_xbar_WDATA),
        .s_axi_wlast(s00_couplers_to_xbar_WLAST),
        .s_axi_wready(s00_couplers_to_xbar_WREADY),
        .s_axi_wstrb(s00_couplers_to_xbar_WSTRB),
        .s_axi_wvalid(s00_couplers_to_xbar_WVALID));
endmodule
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
