RaviTharaka/riscv_fpga/RISCV_Demo/RISCV_Demo.ip_user_files/bd/Integrated/ip/Integrated_processing_system7_0_1/sim/Integrated_processing_system7_0_1.v

 


// (c) Copyright 1995-2013 Xilinx, Inc. All rights reserved.
// 
// This file contains confidential and proprietary information
// of Xilinx, Inc. and is protected under U.S. and
// international copyright and other intellectual property
// laws.
// 
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
// CRITICAL APPLICATIONS
// Xilinx products are not designed or intended to be fail-
// safe, or for use in any application requiring fail-safe
// performance, such as life-support or safety devices or
// systems, Class III medical devices, nuclear facilities,
// applications related to the deployment of airbags, or any
// other applications that could lead to death, personal
// injury, or severe property or environmental damage
// (individually and collectively, "Critical
// Applications"). Customer assumes the sole risk and
// liability of any use of Xilinx products in Critical
// Applications, subject only to applicable laws and
// regulations governing limitations on product liability.
// 
// THIS COPYRIGHT NOTICE AND DISCLAIMER MUST BE RETAINED AS
// PART OF THIS FILE AT ALL TIMES.
// 
// DO NOT MODIFY THIS FILE.


// IP VLNV: xilinx.com:ip:processing_system7_bfm:2.0
// IP Revision: 1

`timescale 1ns/1ps

module Integrated_processing_system7_0_1 (
TTC0_WAVE0_OUT, 
TTC0_WAVE1_OUT, 
TTC0_WAVE2_OUT, 
M_AXI_GP0_ARVALID, 
M_AXI_GP0_AWVALID, 
M_AXI_GP0_BREADY, 
M_AXI_GP0_RREADY, 
M_AXI_GP0_WLAST, 
M_AXI_GP0_WVALID, 
M_AXI_GP0_ARID, 
M_AXI_GP0_AWID, 
M_AXI_GP0_WID, 
M_AXI_GP0_ARBURST, 
M_AXI_GP0_ARLOCK, 
M_AXI_GP0_ARSIZE, 
M_AXI_GP0_AWBURST, 
M_AXI_GP0_AWLOCK, 
M_AXI_GP0_AWSIZE, 
M_AXI_GP0_ARPROT, 
M_AXI_GP0_AWPROT, 
M_AXI_GP0_ARADDR, 
M_AXI_GP0_AWADDR, 
M_AXI_GP0_WDATA, 
M_AXI_GP0_ARCACHE, 
M_AXI_GP0_ARLEN, 
M_AXI_GP0_ARQOS, 
M_AXI_GP0_AWCACHE, 
M_AXI_GP0_AWLEN, 
M_AXI_GP0_AWQOS, 
M_AXI_GP0_WSTRB, 
M_AXI_GP0_ACLK, 
M_AXI_GP0_ARREADY, 
M_AXI_GP0_AWREADY, 
M_AXI_GP0_BVALID, 
M_AXI_GP0_RLAST, 
M_AXI_GP0_RVALID, 
M_AXI_GP0_WREADY, 
M_AXI_GP0_BID, 
M_AXI_GP0_RID, 
M_AXI_GP0_BRESP, 
M_AXI_GP0_RRESP, 
M_AXI_GP0_RDATA, 
FCLK_CLK0, 
FCLK_RESET0_N, 
MIO, 
DDR_CAS_n, 
DDR_CKE, 
DDR_Clk_n, 
DDR_Clk, 
DDR_CS_n, 
DDR_DRSTB, 
DDR_ODT, 
DDR_RAS_n, 
DDR_WEB, 
DDR_BankAddr, 
DDR_Addr, 
DDR_VRN, 
DDR_VRP, 
DDR_DM, 
DDR_DQ, 
DDR_DQS_n, 
DDR_DQS, 
PS_SRSTB, 
PS_CLK, 
PS_PORB 
);
output TTC0_WAVE0_OUT;
output TTC0_WAVE1_OUT;
output TTC0_WAVE2_OUT;
output M_AXI_GP0_ARVALID;
output M_AXI_GP0_AWVALID;
output M_AXI_GP0_BREADY;
output M_AXI_GP0_RREADY;
output M_AXI_GP0_WLAST;
output M_AXI_GP0_WVALID;
output [11 : 0] M_AXI_GP0_ARID;
output [11 : 0] M_AXI_GP0_AWID;
output [11 : 0] M_AXI_GP0_WID;
output [1 : 0] M_AXI_GP0_ARBURST;
output [1 : 0] M_AXI_GP0_ARLOCK;
output [2 : 0] M_AXI_GP0_ARSIZE;
output [1 : 0] M_AXI_GP0_AWBURST;
output [1 : 0] M_AXI_GP0_AWLOCK;
output [2 : 0] M_AXI_GP0_AWSIZE;
output [2 : 0] M_AXI_GP0_ARPROT;
output [2 : 0] M_AXI_GP0_AWPROT;
output [31 : 0] M_AXI_GP0_ARADDR;
output [31 : 0] M_AXI_GP0_AWADDR;
output [31 : 0] M_AXI_GP0_WDATA;
output [3 : 0] M_AXI_GP0_ARCACHE;
output [3 : 0] M_AXI_GP0_ARLEN;
output [3 : 0] M_AXI_GP0_ARQOS;
output [3 : 0] M_AXI_GP0_AWCACHE;
output [3 : 0] M_AXI_GP0_AWLEN;
output [3 : 0] M_AXI_GP0_AWQOS;
output [3 : 0] M_AXI_GP0_WSTRB;
input M_AXI_GP0_ACLK;
input M_AXI_GP0_ARREADY;
input M_AXI_GP0_AWREADY;
input M_AXI_GP0_BVALID;
input M_AXI_GP0_RLAST;
input M_AXI_GP0_RVALID;
input M_AXI_GP0_WREADY;
input [11 : 0] M_AXI_GP0_BID;
input [11 : 0] M_AXI_GP0_RID;
input [1 : 0] M_AXI_GP0_BRESP;
input [1 : 0] M_AXI_GP0_RRESP;
input [31 : 0] M_AXI_GP0_RDATA;
output FCLK_CLK0;
output FCLK_RESET0_N;
input [53 : 0] MIO;
input DDR_CAS_n;
input DDR_CKE;
input DDR_Clk_n;
input DDR_Clk;
input DDR_CS_n;
input DDR_DRSTB;
input DDR_ODT;
input DDR_RAS_n;
input DDR_WEB;
input [2 : 0] DDR_BankAddr;
input [14 : 0] DDR_Addr;
input DDR_VRN;
input DDR_VRP;
input [3 : 0] DDR_DM;
input [31 : 0] DDR_DQ;
input [3 : 0] DDR_DQS_n;
input [3 : 0] DDR_DQS;
input PS_SRSTB;
input PS_CLK;
input PS_PORB;
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
