RaviTharaka/riscv_fpga/RISCV_Demo/RISCV_Demo.srcs/sources_1/bd/Integrated/ip/Integrated_blk_mem_gen_1_0/Integrated_blk_mem_gen_1_0_sim_netlist.v

// Copyright 1986-2016 Xilinx, Inc. All Rights Reserved.
// --------------------------------------------------------------------------------
// Tool Version: Vivado v.2016.3 (win64) Build 1682563 Mon Oct 10 19:07:27 MDT 2016
// Date        : Fri Apr 28 08:32:02 2017
// Host        : ASUS-PC running 64-bit major release  (build 9200)
// Command     : write_verilog -force -mode funcsim
//               E:/University/GrandFinale/Project/riscv_fpga/RISCV_Demo/RISCV_Demo.srcs/sources_1/bd/Integrated/ip/Integrated_blk_mem_gen_1_0/Integrated_blk_mem_gen_1_0_sim_netlist.v
// Design      : Integrated_blk_mem_gen_1_0
// Purpose     : This verilog netlist is a functional simulation representation of the design and should not be modified
//               or synthesized. This netlist cannot be used for SDF annotated simulation.
// Device      : xc7z020clg484-1
// --------------------------------------------------------------------------------
`timescale 1 ps / 1 ps

(* CHECK_LICENSE_TYPE = "Integrated_blk_mem_gen_1_0,blk_mem_gen_v8_3_4,{}" *) (* downgradeipidentifiedwarnings = "yes" *) (* x_core_info = "blk_mem_gen_v8_3_4,Vivado 2016.3" *) 
(* NotValidForBitStream *)
module Integrated_blk_mem_gen_1_0
   (clka,
    rsta,
    ena,
    wea,
    addra,
    dina,
    douta,
    clkb,
    rstb,
    enb,
    web,
    addrb,
    dinb,
    doutb);
  (* x_interface_info = "xilinx.com:interface:bram:1.0 BRAM_PORTA CLK" *) input clka;
  (* x_interface_info = "xilinx.com:interface:bram:1.0 BRAM_PORTA RST" *) input rsta;
  (* x_interface_info = "xilinx.com:interface:bram:1.0 BRAM_PORTA EN" *) input ena;
  (* x_interface_info = "xilinx.com:interface:bram:1.0 BRAM_PORTA WE" *) input [3:0]wea;
  (* x_interface_info = "xilinx.com:interface:bram:1.0 BRAM_PORTA ADDR" *) input [31:0]addra;
  (* x_interface_info = "xilinx.com:interface:bram:1.0 BRAM_PORTA DIN" *) input [31:0]dina;
  (* x_interface_info = "xilinx.com:interface:bram:1.0 BRAM_PORTA DOUT" *) output [31:0]douta;
  (* x_interface_info = "xilinx.com:interface:bram:1.0 BRAM_PORTB CLK" *) input clkb;
  (* x_interface_info = "xilinx.com:interface:bram:1.0 BRAM_PORTB RST" *) input rstb;
  (* x_interface_info = "xilinx.com:interface:bram:1.0 BRAM_PORTB EN" *) input enb;
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
