RaviTharaka/riscv_fpga/(commit log)

2017-03-22 Another bunch of fixes
    [Data_Cache.v]
2017-03-26 Bug fix on Test_RISC_PROCESSOR
    [ALU.v, Data_Cache.v, Ins_Cache.v, PIPELINE.v, REG_ARRAY.v, RISCV_PROCESSOR.v, TEST_RISCV_PROCESSOR.v]
2017-03-27 Traces of programs (without modification)
